Serendipity-min/medical-multi-parameter-monitor/血氧/AFE4490_library/README.md

为Arduino设计的基于AF4490 的PPG / SpO2 / HR盾板
===============================================

Connecting the shield to your Arduino
-------------------------------------

Connect the ECG/Respiration shield to the Arduino by stacking it on top of your Arduino. This shield uses the SPI interface  to communicate with the Arduino. Since this includes the ICSP header, which is used on newer Arduinos for SPI communication,  this shield is also compatible newer Arduino boards such as the Arduino Yun and Due.

Wiring the Breakout to your Arduino
-----------------------------------

If you have bought the breakout the connection with the Arduino board is as follows:

| AFE4490 pin label | Arduino Connection | Pin Function |
| --- | :---: | ---: |
| GND | Gnd | Gnd |
| DRDY | D2 | Data ready(interrupt) |
| MISO | D12 | Slave out |
| SCK | D13 | SPI clock |
| MOSI | D11 | Slave in |
| CS0 | D7 | Slave select |
| START | D5 | Conversion start Pin |
| PWDN | D4 | Power Down/ Reset |
| DIAG_END | NC | Diagnostic output |
| LED_ALM | NC | Cable fault indicator |
| PD_ALM | NC | PD sensor fault indicator |
| VCC | +5v | Supply voltage |

**NEW: This is now compatible with the [ProtoCentral OpenView](https://github.com/Protocentral/protocentral_openview) unified data visualization software.**

### Running the Arduino Sketch

Install the protoCentral afe4490 library from arduino library manager.
If you have correctly installed the libraries, the example sketeches should now be available from within Arduino.

Upload the code to your arduino and open [ProtoCentral-openview](https://github.com/Protocentral/protocentral_openview) GUI/Arduino plotter to view the output.

## For the main documentation site, GUI and more resources, please check out our main [GitHub Repo](https://github.com/Protocentral/AFE4490_Oximeter)

License Information
===================

License

This product is open source! Both, our hardware and software are open source and licensed under the following licenses:

Hardware
--------

**All hardware is released under [Creative Commons Share-alike 4.0 International](http://creativecommons.org/licenses/by-sa/4.0/).**


You are free to:

* Share — copy and redistribute the material in any medium or format
* Adapt — remix, transform, and build upon the material for any purpose, even commercially.
  The licensor cannot revoke these freedoms as long as you follow the license terms.

Under the following terms:

* Attribution — You must give appropriate credit, provide a link to the license, and indicate if changes were made. You may do so in any reasonable manner, but not in any way that suggests the licensor endorses you or your use.
* ShareAlike — If you remix, transform, or build upon the material, you must distribute your contributions under the same license as the original.

Software
--------

**All software is released under the MIT License(http://opensource.org/licenses/MIT).**

THE SOFTWARE IS PROVIDED "AS IS", WITHOUT WARRANTY OF ANY KIND, EXPRESS OR IMPLIED, INCLUDING BUT NOT LIMITED TO THE WARRANTIES OF MERCHANTABILITY, FITNESS FOR A PARTICULAR PURPOSE AND NONINFRINGEMENT. IN NO EVENT SHALL THE AUTHORS OR COPYRIGHT HOLDERS BE LIABLE FOR ANY CLAIM, DAMAGES OR OTHER LIABILITY, WHETHER IN AN ACTION OF CONTRACT, TORT OR OTHERWISE, ARISING FROM, OUT OF OR IN CONNECTION WITH THE SOFTWARE OR THE USE OR OTHER DEALINGS IN THE SOFTWARE.

Please check [*LICENSE.md*](LICENSE.md) for detailed license descriptions.
