Serendipity-min/medical-multi-parameter-monitor/doc/01_多参数监护仪样机_总开发合同_v0.1.md

# 多参数监护仪工程样机总开发合同

**文件编号：MMP-SOW-001　｜　版本：v0.1（评审稿）　｜　编制日期：2026-09-18**

> 本文件用于三人团队的研发立项、任务分工、接口约束、阶段评审与验收，不是医疗器械注册文件，也不替代劳动合同或正式法律审查。项目交付物是受控实验环境下的工程样机系统，不得用于诊断、治疗、生命支持或无人值守监护。文中“应”表示签署后必须满足的要求；“建议”及“待冻结”项目必须经过 G0/G2 评审才能转为执行基线。
>
> 配套文件：`02_项目负责人及上位机_专项工作合同_v0.1.md`。其中附录 A 的 **MMP/1 通信协议**是唯一的自定义通信规范；本文件不得另行定义同名字段或另一套帧格式。

## 一、合同基本信息与签署条件

| 项目 | 约定 |
|---|---|
| 项目名称 | 基于 STM32F407 与局域网网页大屏的多参数监护仪工程样机 |
| 立项/验收方 | ____________________ |
| 项目负责人 P | ____________________；负责总体方案、通信协议、上位机、集成与交付 |
| 嵌入式负责人 A | ____________________；负责 ECG/呼吸、血氧/脉率 |
| 嵌入式负责人 B | ____________________；负责无创血压、红外测温、共享联网固件 |
| 技术监督/最终验收人 | ____________________；不得用负责人单方自评替代最终验收 |
| 代码仓库 | `Serendipity-min/medical-multi-parameter-monitor` |
| 启动日期 T0 | ____________________；以人员、实物、资料及工作量确认完成为前提 |
| 计划周期 | 建议 12 个工作周；不是基于已知成员空闲时间作出的承诺 |
| 样机数量 | 建议交付 1 套完整系统，含 2 个采集节点、1 套上位机；实物数量在 G0 确认 |
| 费用/采购预算 | 人工费用 ______；材料预算 ______；测试仪器借用/租赁预算 ______ |
| 适用法律与争议解决 | ____________________；正式签署时填写并由适格人员审查 |

**生效前提：**三方确认任务边界、可投入时间、模块实物、节点数量、验收条件和预算。未填写商务字段时，本文件只能作为技术任务书使用，不能据此推定付款、劳动关系或知识产权归属已经约定。

### 1.1 本次资料核验的范围

已读取仓库的 README、原始项目方案、硬件开发参考手册及血氧使用教程，并核对 TI、ST、Melexis、Espressif 与监护仪厂商的公开资料。检索时仓库根目录树 SHA 为 `6a40b58b03ab327a7f4e0f02f24d63825d3754c6`；这是**目录树标识，不是声称已锁定的提交 SHA**。README 的文件 blob SHA 为 `e185b0c15a08fb378d1e38ac3392ddcbc1716ab2`。[R1–R5]

**没有完成仓库内全部 PDF、DOC、开发板原理图及供应商协议的逐页复核，也没有接触实物、抓取串口或进行电气测试。**因此，下文引脚是候选分配，供应商命令是待核验项，所有精度与稳定性指标均不得写成已经达成。G0 必须补齐“文件路径、版本、页码、实物照片、抓包证据”的对应关系。

### 1.2 立项前必须消除的资料冲突

| 编号 | 核验发现 | 本合同处理方式 | 关闭责任人 |
|---|---|---|---|
| E01 | 初拟拓扑把 ECG 到 F407 写成 UART；ADS1292R 原生接口是 SPI | 按 SPI + DRDY 设计；只有实物另带串口桥接 MCU 时才改成 UART，并补其协议 | A |
| E02 | README 同时出现 `AFE4490 / HKS-12C`；血氧教程实际描述 AFE4490 Arduino 盾板及不同示例的串口输出 | 不把两者视为同一模块；核对买到的是裸 AFE/盾板还是带算法 MCU 的串口成品 | A |
| E03 | 温度资料涉及 GY-641V3、MLX90614、I2C/串口多种说法；README 出现 `0xA4` | 确认桥接板型号、工作模式、7 位地址还是含读写位地址；禁止套用原生 MLX90614 公式解释桥接帧 | B |
| E04 | ECG 的 PWDN 与 UART5_RX 同时分配 PD2 | 两节点方案将它们分属不同 MCU；单板合并时必须改引脚，不能让 PD2 同时承担两项功能 | A、B |
| E05 | 血压资料包含 HKB-08A、HKB-08B+ 等版本 | 以实物版本与供应商原始协议为准；不得混用波特率、帧头、校验及停机指令 | B |
| E06 | 仓库原方案含本地串口屏、板载存储；当前主需求是网页大屏 | 网页大屏为必交；本地屏、板载断网补传是否纳入首版，在 G0 单独签认 | P |
| E07 | 仓库出现“高精度”“医疗级”“无延迟”、HR ±1 bpm、体温 ±0.2℃等表述 | 改为待验证目标；不将芯片或商品指标直接当作整机验收事实 | P |
| E08 | 将 ADS129 系列描述为需要另配独立 ADC | ADS1292R 已集成 ADC；不因此增加不必要的 ADC 采购项 | A |
| E09 | 三电极、三导联、双 ADC 通道混用 | 三个电极不等于三路独立 ECG；实际通道含义由寄存器配置和模块电路共同确定 | A |

上述判断依据为仓库原文和芯片官方接口说明；未核验的供应商十六进制命令**不在合同中转抄为可执行指令**。[R1–R7]

## 二、项目目标、范围与非目标

### 2.1 最终交付定义

交付一套可在受控局域网演示的工程样机：四个功能模块完成采集或模块结果读取，经 STM32 适配为统一协议，通过 ESP8266 发送给电脑 TCP 服务，服务器记录数据并通过 WebSocket 推送给网页；电脑以 HDMI/DP 连接显示器或电视形成大屏。大屏不是直接接 STM32 的显示外设。

首版必须形成“实物采集 → 数据封装 → 无线传输 → 服务端解析 → 可追溯记录 → 大屏展示 → 故障状态反馈”的闭环，而不是仅制作一张固定数值的界面。

### 2.2 范围分级

| 优先级 | 内容 | 验收口径 |
|---|---|---|
| P0 必交 | ECG 原始波形、ECG 来源 HR；SpO2/PR；NIBP SYS/DIA；红外测温；设备/传感器状态；局域网接入；大屏；记录回放 | 真实模块输出能与原始抓包、统一协议、界面记录逐项对应 |
| P0 必交 | ECG 导联异常、血氧无效/探头状态、血压失败/取消、测温无效等状态处理 | 以模块实际支持的状态为准；不支持项标“未知”，不能编造正常 |
| P0 必交 | 断线重连、心跳、过期标识、异常长度/校验处理、运行日志、版本标识 | 按第十章测试 |
| P1 条件交付 | 阻抗呼吸原始波形、呼吸率 RR、PPG 波形、MAP、本地串口屏、受控远程血压启动 | 必须在 G0 确认硬件能力、资料、仪器和工作量；未确认不能视为默认承诺 |
| P2 后续扩展 | RS485/CAN、MQTT、云端、手机 App、多床位、多机构、持续断网补传 | 另立变更单或二期合同 |

**四模块**指 ECG/呼吸、血氧/脉率、血压、温度四个功能域，不等于“四个测量值”，也不等于已经确认要购买四块 STM32。呼吸是 ECG 负责人名下的条件子任务，不另设第五位负责人。

### 2.3 明确不在本期承诺范围内

不承诺临床诊断精度、除颤防护、心律失常诊断、ST/QT 分析、自动治疗建议、婴幼儿/新生儿使用、人体试验、医疗注册、试产量产、公开互联网部署及连续断网时所有原始波形的无损补传。本期只设置工程演示告警，不宣称符合医疗告警标准。[R12]

## 三、市场调研合同任务

### 3.1 已完成的初步桌面调研

| 对标对象 | 官方资料可支持的观察 | 对本项目的启示 | 本期不照搬的内容 |
|---|---|---|---|
| 迈瑞 ePM 10M/12M、ePM 系列 | 官方页面介绍多参数监测、集中信息展示及有线/无线联网能力 | 将波形、数值、趋势、技术状态置于同一视图，联网是监护系统的一部分 | 不照搬其临床算法、精度与认证宣称 |
| 飞利浦 IntelliVue MX400 | 官方页面强调床旁信息整合、紧凑显示与临床信息连接能力 | 用清晰的信息优先级和一致的参数来源标识降低阅读负担 | 不在首版实现 EMR/HIS、IntelliBridge 或商业设备协议兼容 |

来源为厂商原始页面，完成了产品功能层面的桌面比较；**尚未开展用户访谈、报价调查或市场规模验证**。没有真实报价时，材料预算只列项目与数量，不填写虚构单价。[R10–R11]

### 3.2 尚需执行的市场调研工作包 M0

P 负责组织不少于 3 次经同意的需求访谈，优先对象为指导教师、电子/生物医学工程人员、实际演示使用者；是否访问医护人员由学校或所在单位安排，不擅自开展患者招募。

每次访谈记录“场景—任务—痛点—期望功能—可接受延迟—故障时需要看到什么—证据”。重点确认：这是教学演示、实验采集还是未来产品探索；是否必须脱离电脑独立工作；是否需要本地屏；演示数据能否全部来自模拟器；已有开发板和模块数量；供电、气路及测试仪器由谁提供。

**交付物：**`docs/01_market/competitor_matrix.md`、`interview_records.md`、`positioning.md`。验收要求为来源可回溯、访谈与假设分开、结论能转化为需求；不得用未采访对象的“典型意见”伪装为调查结果。

## 四、需求分析与可追溯性

| 需求 ID | 需求与优先级 | 负责人 | 验收证据 |
|---|---|---|---|
| REQ-01 | P0：四功能模块可独立调试并接入同一监测会话 | A/B/P | 模块台架报告、会话绑定记录 |
| REQ-02 | P0：默认 ECG 250 SPS；保存实际启用的 ADS 通道原始样本 | A | 配置读回、DRDY 频率、连续样本编号 |
| REQ-03 | P0：血氧与脉率的来源、有效性、更新时间明确 | A/P | 供应商样帧和界面对照 |
| REQ-04 | P0：血压为间歇测量，显示最近一次完成时间和当前测量状态 | B/P | 开始/测量中/完成/失败/取消序列 |
| REQ-05 | P0：温度区分物表、环境、模块补偿值；不冒称核心体温 | B/P | 字段说明、无效值与更新测试 |
| REQ-06 | P0：服务端支持最多 4 个采集连接；首版实物建议 2 个 | P/B | 2 实物功能联调、4 模拟节点压力测试 |
| REQ-07 | P0：在线不等于数值有效；数据陈旧、掉线、探头故障独立显示 | 全员 | 故障注入报告 |
| REQ-08 | P0：1080p 网页大屏、全屏、实时波形、数值、状态、趋势与回放 | P | 截图、录屏、自动化测试 |
| REQ-09 | P0：协议带身份、启动标识、序号、采集时间、长度和校验 | P/B | Python/C 金样一致性报告 |
| REQ-10 | P0：原始数据与显示处理数据可区分、可追溯 | P/A | 原始文件、算法版本、回放对照 |
| REQ-11 | P0：断网不影响本地安全状态机；不得因重试重复启动血压 | B | 台架断网、重复命令、超时测试 |
| REQ-12 | P0：实物、模拟器、回放三种模式始终有醒目标识 | P | 三种模式截图 |
| REQ-13 | P1：RR/PPG/MAP/本地屏按 G0 条件项签认 | A/B/P | 能力冻结表及新增验收用例 |

需求变更必须同步更新“需求 ID → 设计 → 代码路径 → 测试 ID → 验收结论”，不能只改 README。

## 五、功能设计

### 5.1 采集与参数语义

ECG 负责人保存未经显示滤波的 ADC 数据、通道配置、增益、参考电压来源、采样率和导联状态。HR 算法首先针对模拟器进行验证；算法未产生有效结果时输出无效状态，而不是固定数值。

呼吸必须区分 ADS1292R 阻抗呼吸通道与 ECG 衍生呼吸算法。不能仅凭“芯片支持呼吸”承诺模块已经具备完整测量电路；也不能把经 5–40 Hz 显示带通处理后的 ECG 直接当成保留了呼吸低频成分的信号。优先验证独立阻抗通道，ECG 衍生 RR 作为另行评审的算法任务。[R6]

血氧如果实物是 UART 成品模块，读取其结果和质量状态；如果是直接连接的 AFE4490，则需要 SPI 驱动、LED 时序、红/红外原始采集及供应商算法移植。AFE4490 芯片本身不等于已经提供了 HKS 系列 UART 帧或临床标定的 SpO2 算法，后者是影响工期的实质变更。[R4、R7]

NIBP 使用模块成熟的测量流程，不在首版自行重写示波法核心算法。MAP 仅在模块明确输出且协议被验证时显示；不能默认用 `(SYS + 2×DIA)/3` 替代实际测得的 MAP。

温度默认按经核验的实际模式读取，推荐低频 1 Hz 展示。裸 MLX90614 的 SMBus 数据和 GY 桥接板的“人体补偿温度”不是同一种协议，也不是同一种医学含义。[R8]

### 5.2 大屏与状态功能

首页设一个监测会话：左侧 ECG/可用 PPG/可用 RESP 波形，右侧 HR、SpO2、PR、SYS/DIA、TEMP 等数值；底部显示节点、探头、连接质量、最近更新时间和事件。每个数值必须能显示单位、来源和无效/过期原因。血压显示最近完成时间，不以 1 Hz 重复上报伪装成每秒测量。

设备页展示固件版本、协议版本、节点能力、重连次数、接收速率、样本缺口；记录页负责会话回放与导出。设置页仅管理员可进入；展示人员不应有启动气泵或改校准参数权限。

### 5.3 告警边界

工程告警分为技术故障与参数阈值提示。阈值、迟滞、持续时间、确认/静音行为要有配置与事件日志；不在本合同中设定临床治疗阈值。所有预设演示阈值标注“模拟演示”。无效数据不参与生理阈值判断，技术故障不能被“静音”变成正常。[R12]

## 六、系统方案设计与通信选型

### 6.1 建议冻结的首版拓扑

```text
节点 A：A 负责
  ADS1292R ── SPI + DRDY/控制 GPIO ──┐
  血氧模组 ── 已核验 UART 或 SPI ────┤ STM32F407-A
                                       └─ UART3 + ESP-AT ─ ESP8266-A ─┐
                                                                    │
节点 B：B 负责                                                        │
  HKB 血压模块 ── 已核验 UART ────────┐                              ├─ 2.4 GHz AP
  GY 测温模块 ── 已核验 I2C/UART ─────┤ STM32F407-B                  │       │
                                       └─ UART3 + ESP-AT ─ ESP8266-B ─┘       │ TCP
                                                                              ▼
                                                        P：电脑接入服务 + 记录/状态服务
                                                                              │ WebSocket
                                                                              ▼
                                                             浏览器网页 ── HDMI/DP ── 大屏
```

这是**推荐的两节点工程方案，不是已确认拥有两套板卡的事实**。G0 核实数量后冻结：两节点便于两位成员并行负责完整链路，也可将气泵电源干扰与 ECG 节点分开管理；但物理分开不等于实现医疗电气隔离。

若只有一块板，使用同一协议的多 `stream_id` 模式并重新审核引脚/资源；若四模块各有独立 F407+ESP，则配置四个 `device_id`，网页仍按同一个 `monitor_session_id` 聚合。二者均须更新 BOM、引脚表和实物验收范围，不能口头切换。

### 6.2 接口和协议的明确结论

| 链路 | 首版选型 | 理由及限制 |
|---|---|---|
| ADS1292R → F407 | SPI 主机 + DRDY EXTI + 控制 GPIO | 芯片原生数字接口；不是 UART、RS485 或 CAN |
| 血氧 → F407 | 成品桥接模块才选 UART；直接 AFE4490 选 SPI | G0 以实物和源码确定；不能用模块名相似代替核验 |
| 血压 → F407 | 硬件 UART，8N1；波特率随实物协议冻结 | README 的 115200 仅作线索，不自动覆盖其他版本 |
| GY 测温 → F407 | 优先核验仓库拟用 I2C 100 kHz；UART 为经证实后的替代方案 | 100 kHz 是本项目候选设置；地址、帧、上拉和电平先核验 |
| F407 → ESP8266 | 3.3 V 逻辑 UART，初始 115200、8N1，DMA + AT 状态机 | 默认正常发送模式 `CIPMODE=0`；不把调试串口混进协议串口 |
| ESP8266 → 电脑 | TCP 长连接，设备主动连接服务器；MMP/1 应用帧 | TCP 是字节流，服务器必须处理半包、粘包和断连 |
| 服务端 → 网页 | 同源 HTTP + WebSocket | 网页通过 WebSocket 接实时流；不直接连接原始 TCP 端口 |
| 本地串口屏（条件项） | 按实物选 TTL 或 RS232 + 对应收发器 | UART 是控制器方式，TTL/RS232 是电气层；两者不可裸连混用 |
| RS485 | **本期不采用** | 只有需要长距离有线多点接入时再增收发器、终端/偏置和主从协议 |
| CAN | **本期不采用** | 如未来采用，需 CAN 收发器、终端、ID、总线负载及分片设计；不能把 UART 线接上就当 CAN |
| Modbus RTU / CANopen / MQTT / HL7 / FHIR | **本期不采用** | 当前目标无需同时引入多套应用协议；存在扩展需求时另行论证 |

不能以“更专业”为理由同时增加 RS485、CAN、MQTT。当前最小闭环已经需要传感器协议、ESP-AT、TCP 应用帧和 WebSocket 四层边界，优先把这四层做正确。[R6–R9]

### 6.3 节点身份和会话绑定

`device_id` 标识采集节点，`stream_id` 标识该节点上的数据流，`boot_id` 区分设备重启，`monitor_session_id` 标识一次演示/记录会话。IP 地址、MAC 地址或连入顺序不能代替会话绑定。不同节点的数据只有在管理员明确绑定后才在同一屏聚合；设备更换、重启、同 ID 重复连接均应触发可见事件。

### 6.4 吞吐预算

以下是设计计算，不是实测结果。UART 115200、8N1 每字节占 10 bit，理论单方向上限为 `115200/10=11520 B/s`。

按附录 A 的 40 B 头、24 B 波形元数据、4 B CRC：ADS 两通道、250 SPS、每包 10 个采样时，单包 `40+24+10×2×3+4=128 B`，每秒 25 包，即 **3200 B/s**。如核验存在 50 SPS 的单通道 PPG，每包 5 点，其开销为 **830 B/s**。再为低频值、心跳和 AT 交互留预算，首版目标持续串口负载不超过约 70%，并以逻辑分析仪/实际计数验证。

500 SPS、每包 20 点时 ADS 流为 **4700 B/s**；它是服务器压力测试档与条件扩展，不自动等于硬件首版承诺。若提高采样率或增加通道导致负载超限，先调整批量与固件队列，再申请验证 230400/460800 等波特率。不能根据 Wi-Fi 的名义速率忽略 UART 瓶颈。

## 七、软硬件设计约束

### 7.1 候选引脚表——不是最终接线许可

以下沿用检索时仓库的相关映射作为候选，**必须经开发板原理图、STM32 复用表、CubeMX 配置及实物通断测量四项核验**。候选表未证明板载器件、跳线或外部存储不会占用这些引脚。[R1–R3、R5]

| 功能 | 节点 A 候选 | 节点 B 候选 | 必查事项 |
|---|---|---|---|
| ADS SPI1 | PB3 SCK、PB4 MISO、PB5 MOSI | 不使用 | PB3/PB4 调试复用、板载 SPI 设备；保留 PA13/PA14 SWD |
| ADS 控制 | PD0 CS、PD1 START、PD2 PWDN/RESET、PE9 DRDY | 不使用 | PD0/PD1 与 FSMC/CAN 等复用；PE9 外设占用；模块复位引脚定义 |
| 血氧成品 UART | UART4：PC10 TX、PC11 RX | 不使用 | 只适用于确认提供 UART 的模块；AFE 直连方案另分 SPI 资源 |
| 血压 UART | 不使用 | UART5：PC12 TX、PD2 RX | 与节点 A 的 PD2 属于不同芯片；单板合并时冲突重新处理 |
| GY I2C | 不使用 | I2C1：PB8 SCL、PB9 SDA | 逻辑电压、上拉、7 位地址、总线恢复、是否为桥接协议 |
| ESP | USART3：PB10 TX、PB11 RX | USART3：PB10 TX、PB11 RX | P1/P5 等板载连接以本板版本为准；RX/TX 交叉；EN/RESET 控制另核验 |
| 调试 | USART1：PA9 TX、PA10 RX | 同左 | 禁止与传感器复用；实际 Windows COM 号不固定 |
| 本地屏（可选） | USART2：PA2 TX、PA3 RX | 按需要选用 | TTL/RS232 型号必须确认；网页开发不依赖此屏 |

G0 的最终 `pinmap.csv` 应包含 MCU 实例、引脚、复用号、方向、电压、连接器号、跳线位置、板载冲突、DMA 控制器/流/通道、EXTI 线、原理图页码、审核人。**不能只审核 GPIO，不审核 DMA 和时钟。**

### 7.2 电源、气路和电气安全

全部人体接触功能先用生理信号模拟器、测试负载或供应商规定的台架方法验证。未获得适格人员的电气与风险审查，不进行人体连接；也不因“电池供电”“无线传输”“两个 LDO”就宣称具备患者隔离。普通 LDO 分供电不等于电气隔离。

B 负责提供供电预算、泵启动瞬态、ESP 发射期间压降、稳压温升、复位记录、气路连接及模块故障处理说明。禁止把开发板 3.3 V 引脚默认当成气泵或 ESP 电源容量已足够的证据；禁止将不明 5 V/RS232 信号直接接入 MCU。

血压本地控制必须能在网络失联时独立处理取消、超时、模块错误。停泵/泄压策略、最大工作时间和相关保护值须由已核验模块说明及安全审核确定，不能从 README 复制不完整命令后直接驱动人体袖带。本合同不提供未经审核的人体测试步骤。[R12]

### 7.3 固件基础架构

建议统一使用 STM32Cube HAL/CMSIS、C 语言和 FreeRTOS；具体工具链版本、调试器及 RTOS 配置在 G2 冻结。已有 F103/F429 或 Arduino 示例仅作移植参考，不能认为直接替换芯片名即可用于 F407。某一外设不得同时由 HAL、标准库和直接寄存器的不同代码路径竞争控制。

```text
BSP/板级资源
  ├─ sensor_ecg / sensor_spo2 / sensor_nibp / sensor_temp
  ├─ 时间基准、DMA、环形队列、看门狗
  ├─ protocol_mmp（B 实现，P 提供规范与金样，A 复核）
  ├─ esp_at_transport（B 实现，两节点共用）
  └─ 应用状态机、状态/质量映射、可选本地屏
```

建议优先级：采集与本地安全事件高于网络封包，网络高于本地屏与日志。SPI/USART 中断只做必要读写、DMA 管理和事件通知，禁止在采样中断里等待 `SEND OK`、写磁盘或执行长时间滤波。NIBP 停机/错误状态机不得受 UI 或联网任务阻塞。

STM32F407 的内存规划要区分系统 SRAM 与 CCM；DMA 缓冲区不得默认放进 CCM。必须交付 linker map、缓冲区分配表和栈高水位报告。建议共享网络发送队列上限 16 KiB，ESP UART DMA RX 环形区 4 KiB，协议解析区 8 KiB；这是待实际 map 文件验证的预算，不是要求不加分析地全部分配。[R5]

### 7.4 DSP、单位和校准

原始流和显示滤波流分开。任何带通、陷波、缩放、采样率改变都记录配置版本；上位机不得在不知道增益/参考电压时将 ADC counts 标成 mV。生理参数算法输出包括有效性、窗口、算法版本和来源。模块补偿温度、脉搏波相对幅值不能自动标成具有已校准物理意义的测量量。

### 7.5 上位机架构

上位机采用 Python 异步接入与 FastAPI/WebSocket、SQLite 元数据及二进制原始记录；前端建议 TypeScript + React + Canvas。版本在 G2 锁定，使用 lockfile，不依赖在线 CDN，不将本次文档中的框架名称解读为某一具体最新版本已完成兼容性验证。具体目录、接口、协议与验收见专项合同。[R13]

## 八、人员分工、接口责任与协作规则

### 8.1 责任矩阵

R = 实施；A = 最终负责/批准；C = 参与评审。这里的 A 字母仅为矩阵角色，不等于成员代号 A。

| 工作包 | P 项目负责人 | 成员 A | 成员 B |
|---|---|---|---|
| 市场调研/需求/总体架构 | R/A | C | C |
| ECG、HR、条件 RR | C | R/A | C |
| SpO2、PR、条件 PPG/算法移植 | C | R/A | C |
| NIBP 状态机与台架安全 | C | C | R/A |
| 温度与单位/模式核验 | C | C | R/A |
| 公共 C 帧编解码、ESP-AT、设备认证 | 规范与验收 A | C/节点接入 R | 公共库 R |
| Python 编解码、模拟器、协议金样 | R/A | C | C |
| TCP 服务、存储、网页、运行工具 | R/A | C | C |
| 供电/BOM/接线装配 | 审批 A | 节点 A 部分 R | 统筹与节点 B 部分 R |
| 系统测试、版本发布、演示 | R/A | 模块测试 R | 模块测试 R |

A 的模拟前端与算法工作较重，因此 B 同时承担共享联网库；G0 按双方经验和可投入时间复核负荷。P 不兜底承担未声明的传感器算法、气路调试或板级驱动。

### 8.2 模块交接的最小交付包

每个模块至少交付：`driver` 源码、可重复构建工程、实物型号/版本、接线表、底层帧协议来源及页码、至少一段正常与异常原始抓包、输出语义表、单位/缩放、采样率或结果刷新机制、错误状态映射、固件版本及已知问题。

“串口打印看起来正常”不构成交接完成。必须同时提交统一 MMP/1 帧以及与源数据逐项对照的测试结果；供应商协议由模块负责人解析，P 不在电脑端维护四套随意变化的私有串口协议。

### 8.3 Git 与评审

建议分支为 `feature/ecg`、`feature/spo2`、`feature/nibp-temp`、`feature/transport`、`feature/host`。主分支只合入通过构建、接口测试和人工审查的版本；密钥、Wi-Fi 密码、真实个人健康数据、编译产物不进入 Git。保留第三方代码许可及来源，不能因资料在仓库里就认定允许再发布。

每周一次集成演示和风险复盘，每次展示“已完成证据、失败案例、阻塞事项、下一周可验收结果”。协议、引脚和数据单位的变更必须由 P 与受影响模块负责人共同签认。

## 九、六阶段开发计划与评审关口

**周期为建议排期；T0 前确认人员投入。市场、需求、设计和实现可适度并行，但安全与接口冻结不可跳过。**

| 阶段 | 建议周次 | P 的工作 | A 的工作 | B 的工作 | 关口/交付 |
|---|---|---|---|---|---|
| 准入核验 | 第 1 周前半 | 建立问题清单、设备台账、预算与风险边界 | 核对 ECG/血氧实物、文档 | 核对血压/温度/供电、联网模块 | G0：型号、数量、资料、条件项、初始安全边界冻结 |
| ① 市场调研 | 第 1 周 | 竞品矩阵、访谈、定位 | 提供传感技术约束 | 提供成本/装配约束 | M0 调研记录，不能用空泛市场规模充数 |
| ② 需求分析 | 第 2 周 | SRS、使用场景、需求-测试映射 | 参数与质量状态需求 | 血压安全/温度语义需求 | G1：需求与验收口径签署 |
| ③ 功能设计 | 第 3 周前半 | 大屏原型、状态图、用户角色 | 模块状态机、算法边界 | 控制/故障状态机 | 功能说明、UI 原型、错误用例 |
| ④ 系统方案 | 第 3 周后半 | MMP/1、时间/身份、模拟器金样 | 采样与资源审查 | 引脚/DMA/ESP 公共库方案 | G2：架构/协议/引脚/工具链冻结 |
| ⑤ 软硬件设计 | 第 4–6 周 | TCP、存储、API、大屏并行开发 | ECG/血氧驱动和台架验证 | NIBP/温度驱动、AT/C codec | G3：各模块与上位机分别通过测试 |
| ⑥ 样机开发与集成 | 第 7–9 周 | 两节点聚合、真实数据替换模拟器、回放 | 节点 A 实物接入与稳定性 | 节点 B 实物接入、供电/网络故障 | G4：全链路功能演示 |
| 样机内测试整改 | 第 10–11 周 | 24h 稳定性、异常注入、性能与大屏测试 | 模块缺陷修复、算法核查 | 气路/电源/网络问题修复 | G5：验收报告、关闭阻塞缺陷 |
| 交付 | 第 12 周 | 发布、说明书、演示、交接 | 源码/硬件记录/已知限制 | BOM/接线/固件/安全限制 | G6：最终验收与归档 |

G0 未确认的裸 AFE4490 算法工作、缺失血压协议、未核验屏幕电平属于关键路径阻塞，必须调整合同，而不是把延期隐含转嫁给上位机。硬件未到位时 P 可用模拟器推进，但模拟器不能代替实物验收。

## 十、验收标准与证据

### 10.1 分层验收原则

验收分为：软件正确性、模块台架一致性、系统稳定性与显示效果。**临床测量准确性不在这些测试通过后自动成立**。没有校准仪器、参考方法和审批条件，不签发“医疗精度达标”结论。

| 测试 ID | 用例 | 通过条件 |
|---|---|---|
| T01 | 全新环境构建 | 根据锁定工具链和说明，非作者可编译固件、启动服务及网页；无写死个人路径 |
| T02 | 协议金样 | Python 与 C 对同一向量的帧长度、字节序、字段、CRC 完全相同 |
| T03 | TCP 分包/粘包 | 不少于 1000 帧混合类型，随机切分、连续拼接，恢复结果逐帧一致 |
| T04 | 异常输入 | 错 CRC、超长、坏版本、非法状态、半帧断连被识别；不导致失控分配或进程退出 |
| T05 | 模块一致性 | 各模块有效输出及异常状态能与供应商抓包/台架输入对应；无占位假数值 |
| T06 | ECG 连续性 | 冻结的 250 SPS 配置下，DRDY、样本计数与时间基准可核验；实际两个 ADC 通道均按配置解释 |
| T07 | 多节点聚合 | 建议 2 个真实节点完成全链路；另外用 4 个模拟节点验证服务端连接能力；会话不混绑 |
| T08 | 故障时效 | 连续参数超过有效期标陈旧；节点在最后有效通信后 5 s 标离线，UI 最迟再 1 s 更新；无效不得显示为 0 |
| T09 | 重连 | AP/服务器恢复可用后，在冻结测试网络下 45 s 内自动恢复；重复 10 次；不重复执行旧控制命令 |
| T10 | 大屏 | 1920×1080、2 个浏览器客户端连续演示；数值/状态清晰，波形有时间轴和缺口，不因窗口缩放失真 |
| T11 | 延迟 | 正常网络下服务端接收至前端入绘制队列 P95≤200 ms；采集至网页估计 P95≤500 ms 仅在时间映射不确定度≤50 ms 时评价 |
| T12 | 稳定性 | 2 个实物节点按默认配置运行 24h：无未解释重启、死锁和样本缺口；刻意注入的断线/丢弃必须形成事件，不冒充无损 |
| T13 | 记录回放 | 抽取不少于 3 段各 60 s 数据，回放样本计数、原始数值、单位与事件和记录一致 |
| T14 | 血压控制 | 台架验证本地取消、重复命令、网络中断、超时、模块失败；一次 command_id 不得触发第二次测量 |
| T15 | 安全基线 | 未注册设备不能绑定，非管理员不能控制，无公网映射；密钥不进仓库；模式标签不能关闭 |
| T16 | 存储故障 | 磁盘低空间/写入失败不被静默忽略；界面和日志明确“记录失败”，实时显示可按约定继续 |

延迟是测量值而非浏览器“感觉流畅”。浏览器自身时钟与服务器时钟不可直接相减；需按专项合同做时间映射或使用外部同步测量。P95 的样本数、采样窗口、计算脚本、主机配置与网络环境必须写入报告。

24h 试验优先使用生理模拟器或不连接人体的已批准台架方案。不能为了满足连续时间要求让人体持续连接未经审查的样机。NIBP 不在 24h 内无间隔自动充气；按经审核的台架用例执行有限次数，并记录其间歇状态。

### 10.2 缺陷与验收决定

阻塞缺陷包括：电气/气路风险未关闭、参数来源混淆、无效值显示正常、错误单位、会话混绑、重复启动血压、数据静默丢失、固件或上位机不可复现构建。阻塞缺陷为零方可最终验收。

一般缺陷可在已知问题表中注明影响、临时措施、责任人与修复日期，由验收方书面接受。评审结论只有“通过”“有条件通过”“退回整改”；不设“超时未回复视为通过”。

## 十一、交付物清单

| 类别 | 最小交付 |
|---|---|
| 调研/需求 | 竞品来源、访谈记录、定位、SRS、需求追踪表 |
| 系统设计 | 总体架构、节点/会话模型、MMP/1 冻结版、引脚/DMA/时钟表、风险清单 |
| 硬件 | BOM、实物版本/照片、连接器表、供电/气路说明、装配图；如自制板则含可编辑原理图/PCB 源文件 |
| 固件 | 四模块驱动、公共通信库、算法/配置版本、构建脚本、固件镜像、下载与恢复说明 |
| 上位机 | 后端、前端、模拟器、协议金样、测试、配置示例、离线资源、启动/备份/恢复说明 |
| 测试 | 原始抓包、运行日志、24h 记录、异常注入、性能脚本、失败及整改证据 |
| 样机 | 完整系统一套或 G0 确认的数量；接线标签、版本标签、工程样机警示 |
| 移交 | 使用说明、演示脚本、已知限制、许可清单、最终验收单 |

若没有自制 PCB，不要求伪造 PCB 源文件；应明确交付的是开发板加模块式样机。若本地屏未纳入 G0，不得因仓库有串口屏资料就在验收时临时追加完整屏幕应用。

## 十二、风险、变更、费用与权利义务

### 12.1 主要风险及措施

| 风险 | 等级 | 应对 |
|---|---|---|
| 血氧型号/接口不明，可能变成裸 AFE 算法项目 | 高 | G0 关闭；选择移植或更换成品模块前完成工时与预算评审 |
| 血压版本/停机协议不一致 | 高 | 未核验前禁用远程开始，禁止人体试验；保持台架验证 |
| STM32 引脚/DMA/板载设备冲突 | 高 | 最终引脚及 DMA 表签字；不凭 README 直接接线 |
| 气泵/无线瞬态干扰、供电不足 | 高 | 示波器测量、独立电源支路、复位/噪声对照；必要时改布局 |
| 协议未冻结，三方各写一套 | 高 | G2 规范、金样、C/Python 测试同时冻结 |
| 假数值/旧数值被当作实时 | 高 | null + quality + 时间戳，真实/模拟/回放强制标识 |
| ESP8266 生命周期 | 中 | 已有模块可用于本次样机；记录官方 NRND 状态，量产/新设计再评估替代，不临时强制换板 |
| 任务超出三人投入能力 | 中 | 每周燃尽与关键路径审查，优先 P0，P1 未签署不默认加班吞并 |

Espressif 的公开资料已标注 ESP8266EX 为 NRND（不推荐用于新设计）。这不等于现有模块立即不可用，但属于后续产品化选型风险。[R9]

### 12.2 变更控制

变更单至少包含：编号、原因、受影响需求、硬件/固件/上位机影响、旧新字段对照、测试影响、预算工期变化、回退方式、三方意见。修改采样率、单位、帧头、模块型号、UART 波特率、引脚、节点数量或远程控制权限均属受控变更。

安全纠正可先停止相关测试，再补齐变更手续；不能以“合同已写死”为理由继续执行已知风险方案。P 不得只改网页掩盖硬件数据异常。

### 12.3 商务与成果条款（签署时填写）

人工与材料分别核算；没有预算批准不得替项目方下单。采购单记录型号、版本、供应商、价格、交期、保修与归属。费用支付节点由签署方填写，不在本稿中虚构金额或付款比例。

已有代码/资料的权属依原许可；新增软件、硬件设计、测试记录及可申请成果的权属约定为：____________________。各成员至少应按约定向项目交付完整源代码、构建方法与研发记录，不得仅交不可维护的二进制程序。第三方资料的上传、公开和再分发单独核查许可。

保密范围、数据访问、离职/退出交接、缺陷修复支持期、合理责任限制及争议解决在签署时补全；医疗器械注册与临床使用责任不因本技术任务书产生自动授权。法律适用与正式权利义务请由所在辖区的合适专业人员审核。

## 十三、开工前 5 个工作日行动清单

| 时间 | P | A | B | 必须形成的结果 |
|---|---|---|---|---|
| 第 1 日 | 建任务板、资料冲突表、访谈预约 | 拍 ECG/血氧实物与丝印 | 拍血压/温度/ESP/开发板版本 | 实物清单，不用商品标题替代型号 |
| 第 2 日 | 整理需求与会话模型 | 确认 ECG SPI、血氧真实接口与算法来源 | 确认血压/温度协议、电源需求 | 文档路径/页码 + 未知项 |
| 第 3 日 | 完成 MMP/1 字段评审与模拟数据定义 | 给正常/异常样帧和采样计划 | 给正常/异常样帧和 AT 固件版本 | 接口冻结候选，不驱动未经核验的控制命令 |
| 第 4 日 | 运行协议 Python 金样，搭最小 TCP 接收 | 评审帧开销、采样中断设计 | 评审 C codec/AT 队列与安全状态 | 跨端测试计划、候选引脚/DMA 表 |
| 第 5 日 | 主持 G0 评审与需求预审、确认预算与节点数 | 签认模块边界、风险、工时 | 签认模块边界、风险、工时 | 通过项启动；阻塞项立变更/补证任务 |

上述是前五日的可执行启动安排，完整需求及 G2 冻结仍遵循第九章排期。P 的第一优先级是冻结接口与搭建模拟链路，不是先装饰大屏。

## 十四、签署与阶段确认

项目/验收方：________　日期：________  
P：________　日期：________  
A：________　日期：________  
B：________　日期：________  
安全/技术监督（如有）：________　日期：________

G0 节点数：____；ECG 实物：____；血氧实物/接口：____；血压实物/协议版本：____；温度实物/接口：____；开发板型号/版本：____；ESP AT 版本/Flash 容量：____。  
条件项勾选：RR ____；PPG ____；MAP ____；本地屏 ____；受控远程血压开始 ____；板端存储 ____。未签认的条件项按未纳入首版处理。

---

## 参考来源与使用边界

访问/检索日期：2026-09-18。仓库为项目材料来源，厂商资料用于核对通用接口与产品功能；不把仓库中未经实测的性能宣称作为整机事实。

- **[R1] 仓库 README**：https://github.com/Serendipity-min/medical-multi-parameter-monitor/blob/main/README.md 。检索时 blob：`e185b0c15a08fb378d1e38ac3392ddcbc1716ab2`。
- **[R2] 仓库《多参数心电监护仪项目方案.md》**：https://github.com/Serendipity-min/medical-multi-parameter-monitor/blob/main/多参数心电监护仪项目方案.md 。检索时 blob：`2119d56b09b6de8d84d4bf36c8b723acb26865f6`。
- **[R3] 仓库《多参数心电监护仪系统硬件方案与元器件开发参考手册.md》**：https://github.com/Serendipity-min/medical-multi-parameter-monitor/blob/main/多参数心电监护仪系统硬件方案与元器件开发参考手册.md 。检索时 blob：`88d87f8d60d08ec180f98ab5ee5a57687a436284`。
- **[R4] 仓库血氧教程**：https://github.com/Serendipity-min/medical-multi-parameter-monitor/blob/main/血氧/使用教程.md 。检索时 blob：`57ba6756e33626e174511e98788b7ad1437766c7`；可见 Arduino/AFE4490 与不同示例串口波特率说明。
- **[R5] ST STM32F407ZG 产品与文档入口**：https://www.st.com/en/microcontrollers-microprocessors/stm32f407zg.html 。最终复用号、DMA 和时序应回到对应数据手册及 RM0090 逐项确认，本次未完成开发板原理图逐页审查。
- **[R6] TI ADS1292R 官方数据手册，SBAS502C，Rev. C**：https://www.ti.com/lit/ds/symlink/ads1292r.pdf 。已核对首页及呼吸功能相关页面；不等于核验所购模块的外围电路。
- **[R7] TI AFE4490 官方页面**：https://www.ti.com/product/AFE4490 。用于区分芯片 AFE 与包含算法/串口桥接的成品模块。
- **[R8] Melexis MLX90614 官方页面**：https://www.melexis.com/zh/product/mlx90614/mlx90614 。用于核对原生 SMBus/PWM；不证明 GY 桥接模块私有协议。
- **[R9] Espressif ESP8266EX 数据手册与 ESP-AT 参考**：https://documentation.espressif.com/0a-esp8266ex_datasheet_en.html ；https://docs.espressif.com/projects/esp-at/en/release-v2.2.0.0_esp8266/AT_Command_Set/TCP-IP_AT_Commands.html 。参考版本不等于实物固件已经采用该版本。
- **[R10] 迈瑞官方产品页**：https://www.mindray.com/cn/products/patient-monitoring/sub-intensive-care-monitoring/epm-10m-12m ；https://www.mindray.com/en/products/patient-monitoring/continuous-patient-monitoring/epm-series 。通过 Exa 检索原始厂商资料。
- **[R11] 飞利浦 IntelliVue MX400 官方页面**：https://www.philips.com.cn/healthcare/product/HC866060/intellivue-mx400 ；https://www.philips.ng/healthcare/product/HC866060/intellivue-mx400-patient-monitor 。仅引用信息呈现和连接定位。
- **[R12] IEC 医用电气设备标准目录及 ISO 告警标准条目**：https://webstore.iec.ch/en/publication/2603 ；https://www.iso.org/es/contents/data/standard/04/19/41986.html 。仅用于说明存在整机安全/告警验证边界，不宣称本样机已符合任何标准；具体适用版本和当地要求需另审。
- **[R13] FastAPI 官方 WebSocket 文档**：https://fastapi.tiangolo.com/advanced/websockets/ 。架构实施仍须执行锁版本、异常断连与背压测试。
