Serendipity-min/medical-multi-parameter-monitor/doc/02_项目负责人及上位机_专项工作合同_v0.1.md

# 项目负责人、通信协议与网页上位机专项工作合同

**文件编号：MMP-SOW-002　｜　版本：v0.1（评审稿）　｜　编制日期：2026-09-18**

> 配套总合同：`01_多参数监护仪样机_总开发合同_v0.1.md`。本文件约束项目负责人 P 的工作范围、对 A/B 的接口要求、协议、上位机实现与验收。附录 A 是本项目唯一的 MMP/1 自定义通信规范。当前为待签署设计稿，不表示服务器、网页、C 固件或实物样机已经开发完成。
>
> 适用范围为受控实验局域网的工程样机。默认使用模拟信号、模拟器或获准的台架数据，不接入医疗生产系统，不采集真实患者信息，不构成临床监护软件。

## 一、任务主体、目标与边界

| 项目 | 约定 |
|---|---|
| 执行人 | P：____________________ |
| 协作人 | A：ECG/呼吸、血氧/脉率；B：血压、温度、公共 C 通信/ESP-AT 固件 |
| 验收人 | ____________________ |
| 启动与周期 | 随总合同 T0；建议 12 周，具体投入和依赖在 G0 签认 |
| 上位机运行环境 | 首版建议 Windows 11 电脑，Chrome/Edge；CPU/内存/浏览器版本在测试前记录 |
| 大屏形式 | 浏览器网页，由电脑通过 HDMI/DP 输出到 1080p 显示器/电视 |
| 费用与成果权属 | 从属总合同，不重复计算或擅自推定 |

### 1.1 P 的五项核心责任

P 负责需求与架构、协议规范和模拟器、电脑 TCP 接入与记录服务、WebSocket 网页大屏、集成测试及阶段验收组织。P 对系统设计负责，但不因此自动接管成员 A/B 的传感器驱动、血氧算法标定、电路/气路安全或全部固件开发。

**对 P 的交付评价不只看页面是否美观，还看：是否能从真实数据定位错误、能否区分无效和离线、能否说明数据来源及时间、协议能否由别人独立实现、系统能否重复部署。**

### 1.2 不属于 P 的默认工作

P 不在服务器中直接解析四套供应商私有串口协议，不根据截图猜测传感器单位，不绕过电气/安全审核远程驱动气泵，不对医疗精度作背书，不默认承担本地串口屏 GUI、PCB、云服务器、手机 App、RS485/CAN 或医院系统接口。新增任务必须通过总合同变更流程。

### 1.3 开工前输入件

A/B 必须提交模块型号与固件版本、接口与电平、供应商帧协议原始来源、有效/异常样帧、单位、采样/更新周期、错误码、硬件连接与已知限制。P 可以先用自定义模拟数据开发软件，但模拟数据必须显式标识，不能作为模块实测证据。

本次核验已发现：ADS1292R 应按原生 SPI 处理；仓库血氧资料混有 AFE4490 Arduino 方案与 HKS-12C 说法；GY 温度模块的 I2C/串口模式及地址需核验。P 的协议设计要屏蔽这些供应商差异，但不能替硬件负责人消除实物不确定性。[S1–S4]

## 二、与两位成员的交接合同

| 接口 | A 的责任 | B 的责任 | P 的责任 |
|---|---|---|---|
| 传感器到 STM32 | ECG/血氧驱动、算法与状态 | 血压/温度驱动与本地安全状态机 | 提出统一数据语义并验收 |
| 统一帧 | 正确填写本节点通道/样本/状态 | 实现共享 C codec、移植到节点 B，协助节点 A | MMP/1、Python codec、金样与一致性测试 |
| STM32 到 ESP | 使用公共库，保障采样不阻塞 | ESP-AT 状态机、UART DMA、队列、重连、认证 | 提供测试 TCP 服务、故障用例 |
| TCP 到服务端 | 提交真实节点 A 帧 | 提交真实节点 B 帧 | 接入、校验、会话绑定、存储、诊断 |
| 大屏/记录 | 核对 ECG/SpO2 单位与算法标签 | 核对 NIBP/TEMP 状态与历史含义 | 页面、波形、状态、回放、权限 |

P 交给 A/B 的最小开发包为：协议冻结版、设备/流命名表、C 结构字段说明、Python 编解码参考、至少一套十六进制金样、正常/异常测试流和接入测试方法。B 交回 C 的金样比较报告；未通过时不进入整机联调。

## 三、P 的六阶段工作安排

| 阶段 | 周次建议 | 具体任务 | 可验收产物 |
|---|---|---|---|
| 市场调研 | W1 | 阅读厂商原始产品页，组织真实访谈，确定工程样机定位 | 竞品矩阵、访谈记录、首版场景说明 |
| 需求分析 | W2 | 写 SRS，确认是否单会话、节点数量、屏幕和存储范围 | 需求 ID、非目标、验收矩阵、风险登记 |
| 功能设计 | W3 前半 | 画大屏线框、状态页、记录页；定义无效/陈旧/离线行为 | UI 原型、状态转换图、数据字典 |
| 系统方案 | W3 后半 | 冻结 MMP/1、消息路径、身份、时钟、背压、AT 边界 | 协议、金样、模拟器、架构评审记录 |
| 软硬件协同设计 | W4–W6 | 开发 TCP 接入、记录、API、WebSocket、大屏；与 B 对 C codec | 模拟器驱动的可运行版本、自动测试 |
| 样机集成 | W7–W9 | 将模拟节点逐个替换为真实节点，完成绑定、日志、故障与回放 | 两节点集成版本、真实数据对照报告 |
| 测试与交付 | W10–W12 | 24h、异常注入、性能、部署演练、演示与移交 | 发布包、测试报告、说明书、已知限制 |

正确顺序：**协议/金样 → 模拟器 → TCP 解析 → 状态与记录 → WebSocket → 网页 → 真机接入 → 稳定性与验收**。网页可以提前画原型，但不能在字段、单位、时间语义未定时先堆完整页面。

## 四、上位机总体设计

### 4.1 技术栈与进程模型

建议后端采用 Python `asyncio` + FastAPI + Uvicorn，前端采用 TypeScript + React + Canvas；SQLite 存元数据、参数结果与索引，连续原始波形保存在按会话分段的二进制文件中。FastAPI 官方支持 WebSocket，但设备 TCP 接入需要单独用 `asyncio.start_server` 等机制实现，不是 WebSocket 路由自动提供的功能。[S5]

首版采用**一个 Uvicorn worker**。在应用生命周期中启动/关闭 TCP 监听和后台服务；不能直接启用多个 worker，让每个进程重复绑定采集端口、各自维护不同设备状态。未来多进程扩展必须拆出独立接入进程与共享消息/状态设施。

```text
host/
  backend/app/
    main.py                  # 生命周期、配置、HTTP/WS
    transport/tcp_server.py  # TCP 会话与读写超时
    protocol/codec.py        # 帧级解析
    protocol/schemas.py      # JSON / 波形语义校验
    services/auth.py         # 注册设备、挑战应答
    services/device.py       # 节点、流、会话与状态
    services/timesync.py     # 单调时钟映射
    services/recording.py    # 原始分段、索引、磁盘状态
    services/alerts.py       # 工程提示与技术故障
    services/broadcast.py    # 独立 WS 客户端队列
    api/                    # REST / WebSocket 路由
  frontend/src/
    pages/ components/ waveform/ api/ state/
  simulator/                # 1–4 节点、掉线/坏帧/状态模拟
  tests/                    # 协议、API、集成、性能
  scripts/                  # 安装检查、启动、备份、诊断
  config.example.yaml
  pyproject.toml            # Python 依赖及版本约束
  uv.lock                   # 或已签认的等效锁定文件
  frontend/package-lock.json
```

此目录是拟实施结构，不表示仓库已有这些文件。W3 冻结 Python、Node、依赖及包管理器版本，提交 lockfile；禁止未经检查地写“任意最新版均可”。

### 4.2 数据处理流水线

```text
TCP 字节流
  → 有界缓冲 / 帧头同步 / 长度上限 / CRC
  → 设备握手认证 / 协议版本 / 消息 schema
  → 身份与会话绑定 / 序号和样本连续性
  → 原始记录队列 ───────────→ 分段文件与 SQLite 索引
  → 各参数时间与质量状态
  → 独立的显示变换（有元数据）
  → 各浏览器有界队列
  → WebSocket
  → 前端时间环形缓冲 / Canvas 绘制
```

持久化不能阻塞接入事件循环；SQLite 和文件写入由受控工作线程或专门写入服务处理，队列必须有容量及失败策略。每个浏览器独立排队，慢浏览器不能拖垮设备接收与其他浏览器。

### 4.3 首版建议配置

```yaml
app:
  mode: lab                    # lab / replay；不是临床模式
  allow_real_patient_data: false
network:
  tcp_host: "192.168.10.20"     # 示例，必须改为电脑实际实验网卡 IP
  tcp_port: 9000
  http_host: "127.0.0.1"        # 本机大屏默认仅回环
  http_port: 8000
  max_devices: 4
  max_payload_bytes: 4096
  handshake_timeout_s: 5
  offline_after_s: 5
  allowed_ws_origins:
    - "http://127.0.0.1:8000"
    - "http://localhost:8000"
stream:
  ecg_default_sps: 250
  expected_ecg_packet_ms: 40
  live_window_s: 10
  client_queue_max_ms: 1000
  freeze_gap_policy: blank_and_mark
recording:
  enabled: true
  root: "./records"
  chunk_seconds: 60
  auto_delete: false
  low_space_warn_gib: 5
  stop_recording_below_gib: 1
security:
  require_device_auth: true
  allow_remote_nibp_start: false
  secrets_file: "./private/device_keys.json" # 禁止纳入 Git
```

上述 IP、端口和阈值是可修改的项目配置示例，不是对用户当前网络的读取结果。需要第二台电脑看屏时，经批准将 HTTP/WS 绑定实验网卡地址，增加准确的允许来源和防火墙范围；不能为省事默认全公网开放。

## 五、状态、单位与时钟设计

### 5.1 设备状态与参数状态分离

设备状态：`CONNECTING → AUTHENTICATING → ONLINE → OFFLINE`，协议错误或认证失败可进入 `REJECTED`。节点在线不能覆盖其传感器故障。

每个参数的质量至少支持 `VALID / INVALID / WARMUP / SENSOR_OFF / LEAD_OFF / ERROR / UNKNOWN`；服务端另计算 `STALE`。供应商不提供某状态时不猜测，映射为 `UNKNOWN` 或有证据的通用无效状态。

连续参数默认超过 3 s 未有新的有效采集结果时标陈旧，具体周期随能力表冻结；离线默认是 5 s 没有通过校验和会话检查的通信。收到心跳或重复旧数值不能刷新参数的采集时间。无效值在数据层为 `null`，网页显示 `--` 和原因，不用 0 表示探头脱落。

血压是事件型结果：展示“最近一次结果 + 完成时间 + 当前状态”。测量中收到压力值，不得替换为最终 SYS/DIA；最近结果可以保留但必须标“历史结果”，不能包装成当前连续测量。

### 5.2 时间定义

每帧 `mono_us` 为设备本次启动后的单调微秒计数。波形帧表示**第一采样点的采集时间**，不能填写发送时刻；参数帧中每项 `sample_mono_us` 表示该结果自身的采集/生成时间。MCU 应采用可靠的 64 位扩展时间基准并测试溢出，不能直接把 32 位微秒计数当作永不回绕。

服务器分别记录接收单调时间和 UTC 时间；UTC 用于日志展示，不参与重连超时和采样间隔判断。设备重启用 `boot_id` 切分时间轴；不得让波形时间倒退后继续拼接成同一段。

### 5.3 近似时间映射与限制

握手后每 10 s 发起一次 `SYNC_REQ`，服务器记录发送时刻 `s0`；设备回复接收时刻 `d1`、回复入发送队列时刻 `d2`；服务器记录收回时刻 `s3`。使用微秒为单位估计：

```text
offset = ((s0 + s3) - (d1 + d2)) / 2
server_mono_est(device_time) = device_time + offset
network_delay_est = (s3 - s0) - (d2 - d1)
```

选择近期有效样本中往返开销较小者，并记录至少为残余往返时延一半加测时裕量的映射不确定度；负时延、重启、过旧同步等情况视为无效。串口排队、Wi-Fi 不对称延迟和时钟漂移会影响精度，所以**不承诺跨节点采样级同步，不据此做 ECG–PPG 脉搏传导时间等研究**。

浏览器到服务器另做同类 ping/pong 映射，不直接相减 `performance.now()` 和 Python 的时钟。端到端延迟仅在设备及浏览器映射总不确定度不超过 50 ms 时报告，否则展示“时钟未校准”并单独测接收/绘制处理开销。

## 六、网页大屏设计要求

### 6.1 页面与角色

| 页面 | 内容 | 权限 |
|---|---|---|
| `/dashboard` | 参数、波形、单位、会话、质量、在线状态、模式标签、全屏 | 只读展示 |
| `/devices` | 节点身份、固件、能力、速率、队列/缺口、重连记录 | 管理员 |
| `/records` | 会话列表、回放、导出、记录完整性 | 授权用户 |
| `/settings` | 设备绑定、实验网络、记录目录、工程提示配置 | 管理员 |
| `/diagnostics` | 服务健康、磁盘、协议统计、最近错误 | 管理员 |

模拟、回放、实物三种来源不可混淆。页面顶栏强制显示“工程样机 / 非临床用途”，并以醒目文字显示当前数据模式；不能通过普通设置隐藏该标识。

### 6.2 波形显示

接收频率和绘制频率分离，使用 10 s 有界时间缓冲与 `requestAnimationFrame`；优先 Canvas 连续绘制，不让 React 在每个样本到达时重建整页。采样率影响数据时间轴，刷新率只影响画面更新。

默认显示秒与已知物理单位。未核验量程时显示 ADC counts 或相对幅值；显示器未做物理尺寸标定时，不宣称严格的 25 mm/s 医疗走纸速度。数据量超过像素宽度时采用保峰值的最小/最大抽取等可解释显示方法，原始文件保持不变。

丢包/断线处留空并标记，不用重复点、0 填充或平滑直线伪造连续波形。拖慢页面时允许丢弃过期的显示消息以追上实时，但须产生客户端 `display_gap`；这一行为不能影响原始记录，也不能被统计成采集端真实丢样。

### 6.3 数值和告警

HR_ECG 与 PR_SPO2 分别显示来源，不能相互覆盖。温度标“物表/环境/模块补偿值”，NIBP 显示最后完成时间。技术故障优先保持可见；工程阈值提示需要迟滞、持续时间及确认日志。音频可能受浏览器播放授权限制，不能假定页面打开就一定会鸣响，也不能依赖网页提示承担安全保护。

## 七、API 与 WebSocket 契约

### 7.1 HTTP API

| 方法与路径 | 功能 | 约束 |
|---|---|---|
| `GET /api/v1/health` | 服务、记录、磁盘、接入状态 | 不泄露密钥和敏感路径 |
| `GET /api/v1/devices` | 节点及能力列表 | 管理权限 |
| `POST /api/v1/sessions` | 创建实验监测会话 | 使用实验编号，不收集患者身份 |
| `PUT /api/v1/sessions/{id}/bindings` | 显式绑定节点/流 | 拒绝同流被冲突绑定 |
| `GET /api/v1/sessions/{id}/snapshot` | 当前状态与可用值 | 必含质量与采集时间 |
| `POST /api/v1/devices/{id}/commands` | 受控命令入口 | 白名单、权限、幂等；不能接收任意 AT/串口字节 |
| `GET /api/v1/records` | 记录索引 | 只访问记录根目录 |
| `GET /api/v1/records/{id}/export` | CSV/原始文件导出 | 单位、质量、时间、版本完整 |
| `WS /ws/v1/sessions/{id}` | 订阅实时数据 | 同源校验、授权、背压、重连 |

浏览器不得自行提交“血压模块原始启动帧”。服务器接受业务命令，再由设备固件映射为已经核验的供应商指令。

### 7.2 WebSocket 消息

使用 JSON 消息封装 `schema`、`kind`、`monitor_session_id`、`device_id`、`boot_id`、`stream_id`、`source_mode`、`server_received_utc`、`data`。`uint64` 时间与样本编号在 JSON 中使用十进制字符串，以避免跨语言整数精度问题。波形先用批量数组，测试证明需要优化后再引入二进制 WS，而非首版并行维护两套实现。

```json
{
  "schema": "mmp-web/1",
  "kind": "wave",
  "monitor_session_id": "lab-session-001",
  "device_id": 101,
  "boot_id": 7,
  "stream_id": 1,
  "source_mode": "SIMULATED",
  "server_received_utc": "2026-09-18T00:00:00Z",
  "data": {
    "config_id": 1,
    "sample_rate_hz": 250,
    "first_sample_index": "0",
    "sample_mono_us": "1000000",
    "channel_codes": ["RESP_ADC", "ECG_ADC"],
    "unit": "adc_count",
    "samples": [[12, -25], [15, -10]],
    "quality": "VALID"
  }
}
```

示例为格式演示，样本数量缩短，不代表真实测量；`channel_codes` 必须来自经核验的当前配置，不得硬编码所有 ADS 模块必定为上述通道顺序。

客户端重新连接先取快照和当前配置，再开始接收新帧。不能将上次浏览器缓存的正常值在新会话中直接展示。服务器对单客户端的待发送时间窗上限建议 1 s；超限丢弃过期显示波形并发出缺口事件，必要时断开慢客户端。

## 八、记录、日志与恢复

### 8.1 存储组织

```text
records/
  <monitor_session_id>/
    manifest.json
    <device_id>/<boot_id>/
      chunk_000001.mmp
      chunk_000002.mmp
    index.sqlite
```

每个分段保存完整原始 MMP 帧，保留设备身份、采样配置、版本和 CRC。SQLite 保存会话、设备绑定、低频参数、事件、分段索引与完整性状态；不要把每个 ECG 采样点作为独立数据库事务。

建议 60 s 分段，使用临时文件完成后重命名；中途崩溃时识别末尾不完整帧并报告截断位置。刷盘策略、崩溃时最大可能未落盘区间须写入实现说明，不能声称普通异步写盘完全没有掉电丢失窗口。

根据默认数据预算，原始记录可能达到每天数百 MB；具体值取决于通道、JSON 参数量与日志量。暂按 **0.4–1 GB/24h 的设计预算**准备空间并实测修订，不把估算写成精确容量。自动删除默认关闭；只有经批准的保留策略才可删除本应用记录根目录内的过期文件，不触碰用户其他目录。

### 8.2 必须记录的诊断信息

协议/固件/软件版本、连接起止、认证失败类别、字节速率、有效/坏帧计数、全局序号跳变、每流样本缺口、队列高水位、重连、供应商错误状态、时间映射质量、磁盘警告、记录失败、控制命令状态、浏览器显示缺口。

日志不得输出 PSK、管理员密码或完整认证材料。必须区分“MCU 采样丢失”“节点缓存丢弃”“TCP 连接中断”“服务器记录失败”“浏览器追帧丢弃”，不能统称为网络丢包。

### 8.3 断网策略

设备本地采样与安全状态机继续运行。首版实时发送队列保留有限最近数据，满时丢弃最旧的完整波形批次并累计缺口；恢复后发送缺口事件和当前数据，不把几十秒前的波形当实时流灌入页面。

本期不承诺板端全量断网存储。即使仓库提到板载 Flash，也要重新计算容量、寿命、文件格式与补传协议；是否支持历史补传按二期或 G0 条件项处理。TCP 的可靠字节流不代表设备断网、掉电、采样溢出时不会丢数据。

## 九、安全、网络与权限基线

首版限实验室受控局域网，AP 支持 2.4 GHz，电脑建议有线接路由器；确认 AP 没有阻断终端互访。服务器地址用 DHCP 保留或经管理员确认的固定地址，设备主动建立 TCP 连接。

默认不开放公网端口、不配置路由器端口转发、不接入用户腾讯云服务器、不提供穿透服务。Windows 防火墙只放行程序/目标端口到指定私有实验子网。网页在本机回环访问，其他客户端访问必须单独授权。

设备采用附录 A 的 PSK 挑战应答和身份白名单；管理员口令哈希保存，控制接口另做权限与 CSRF/Origin 防护。前端登录令牌不得放进可泄露的 WebSocket URL 查询参数，优先采用同源安全会话机制。

**重要限制：PSK 握手、CRC、Wi-Fi 密码、白名单都不等于 TCP 应用数据已加密，也不等于抵御主动中间人或每帧篡改。**本期正常 TCP/HTTP/WS 路径仅适用于上述实验测试数据。在引入真实人体可识别健康数据、跨不可信网络或外网访问前，必须增加经过验证的端到端 TLS/证书校验、数据治理和安全评审；不能把“ESP 支持某种 SSL 命令”直接视为方案已安全落地。[S6–S7]

远程血压开始默认关闭。即使条件项获准，仍需本地确认、已核验的模块协议、控制白名单、唯一命令 ID、短有效期、设备空闲状态和独立本地保护；网页确认不能替代本地安全机制。

## 十、P 的专项验收与工作成果

| 编号 | 验收项 | 通过标准 |
|---|---|---|
| P-T01 | 需求与方案 | 六阶段文档、需求追踪、条件项、风险、边界经评审 |
| P-T02 | 协议 | 附录 A、金样、Python 参考与 B 的 C 实现一致；不以 README 简写替代 |
| P-T03 | 模拟接入 | 1–4 模拟节点，含有效值、无效值、重启、掉线和坏帧 |
| P-T04 | TCP 正确性 | ≥1000 帧随机切分/粘合、超长/坏 CRC/半帧断连全部通过 |
| P-T05 | 真机对照 | 冻结数量的真实节点接入；每个模块至少正常/异常各一组原始证据 |
| P-T06 | 网页 | 1080p 两客户端，状态/时间/单位/来源明确；截图与录屏真实可重现 |
| P-T07 | 性能 | 服务接收至前端入绘制队列 P95≤200 ms；条件满足时估计端到端 P95≤500 ms |
| P-T08 | 稳定性 | 全链路 24h 报告，统计缺口、重启、内存、磁盘及异常；无未解释失败 |
| P-T09 | 回放/导出 | 3×60 s 抽样对照，样本数、值、单位、事件及模式标签一致 |
| P-T10 | 部署 | 第二人按文档在干净环境完成启动，配置不依赖 P 的用户名/COM 号 |
| P-T11 | 故障与安全 | 未注册设备拒绝、权限生效、记录失败可见、无公网暴露 |
| P-T12 | 交接 | 源码、锁文件、测试、配置模板、说明书、诊断方法、已知限制完整 |

性能报告记录硬件型号、CPU/内存、浏览器版本、屏幕刷新设置、AP、节点数量、采样率和测量脚本。空白美观界面、固定演示曲线、手工改页面数值不构成真机验收。

建议内存验收方式：先记录 1 h 稳态窗口，再与第 23–24 h 窗口比较，排查持续增长趋势；具体内存上限由 G2 根据电脑配置冻结。不得用一次任务管理器截图宣称不存在泄漏。

## 十一、P 的执行顺序与提交规则

1. 先建立资料冲突/实物能力台账，冻结 `device_id`、流定义、单位和采样率；没有依据的模块能力标未知。
2. 完成附录 A 的跨端评审及 Python 金样，让 B 先通过 C 编解码比较，再把 ESP 正常发送链路接上。
3. 做最小 TCP 接收和诊断页，先能定位坏帧/掉线/时间/来源；再接记录和 WebSocket。
4. 用有标签的模拟节点完成整条软件链；每次只替换一个真实模块，逐项对照原始抓包。
5. 最后完成视觉精修、长期试验、受控演示、可复现部署和移交，不以截图替代运行报告。

每次阶段提交包含：提交 SHA、启动方式、变更范围、测试命令及结果、原始证据、已知失败、下一阶段依赖。协议变更必须给出兼容性说明和新增金样。

签署：P ______；A ______；B ______；验收人 ______；日期 ______。专项合同生效及费用/权属仍从属总合同。

---

# 附录 A：MMP/1 通信协议 v0.1

**性质：本项目原创工程协议草案，不是医疗行业标准，也不是任何传感器供应商的串口协议。**G2 冻结后，C 固件、Python 服务与模拟器必须使用相同版本。本附录采用“二进制外帧 + 二进制波形 / UTF-8 JSON 控制与低频值”。

## A1. 分层与统一规则

传感器 SPI/UART/I2C 帧在 STM32 的驱动层解析；MMP/1 帧由 STM32 生成，通过 ESP-AT 的定长发送进入 TCP 字节流。ESP 不负责解释体征含义。服务器解析 MMP/1 后再转为网页 JSON，不把 ASCII `+IPD` 或 `SEND OK` 当成体征数据。

所有多字节二进制整数均为**小端**；文本为 UTF-8；外帧无换行、无结尾 `0D0A`、无字节转义。帧最大载荷 4096 B，总长最大 4140 B。CRC 只用于完整性检测，不是认证或加密。认证连接的 `session_id` 与业务监测的 `monitor_session_id` 是两个不同标识，不得混用。

## A2. 固定 40 字节帧头

| 偏移 | 长度 | 字段 | 类型/规则 |
|---:|---:|---|---|
| 0 | 4 | magic | 固定 ASCII `MMP1`，十六进制 `4D 4D 50 31` |
| 4 | 1 | version | `uint8`，当前为 1 |
| 5 | 1 | msg_type | `uint8`，见 A3 |
| 6 | 2 | flags | `uint16`；bit0=源数据为模拟；bit1=回放；其余必须为 0 |
| 8 | 2 | header_len | `uint16`，固定 40 |
| 10 | 2 | reserved0 | 固定 0 |
| 12 | 4 | payload_len | `uint32`，0–4096，具体消息另有最小长度 |
| 16 | 4 | seq | `uint32`，每方向、每 device/boot 独立递增，模 2^32 回绕 |
| 20 | 4 | device_id | `uint32`，项目配置的非零节点 ID，不是 IP |
| 24 | 4 | boot_id | `uint32`，本次启动标识；重连保持，重启更换 |
| 28 | 8 | mono_us | `uint64`，节点单调时间；服务器发出的帧头此字段填 0，时间字段放入相应载荷 |
| 36 | 2 | stream_id | `uint16`，0 表示节点控制/聚合；非 0 表示已登记流 |
| 38 | 2 | reserved1 | 固定 0 |

帧布局为：`40 B header + payload_len B payload + 4 B CRC`。CRC 覆盖头和载荷，不覆盖自身；尾部 CRC 也用小端。不得用编译器默认对齐的 C struct 直接 memcpy 上网，应显式读写字段；C `sizeof` 与 Python 头长度测试都必须等于 40。

`boot_id` 配套 HELLO 的 128 位 `boot_nonce`，由冻结的随机/唯一性方案产生；同启动重连不得改变。项目设备 ID 冲突必须拒绝注册，不依赖“随机碰撞几乎不会发生”掩盖配置错误。

## A3. 消息类型

| 值 | 名称 | 方向 | 载荷 |
|---|---|---|---|
| 0x01 | HELLO | 节点→服务器 | JSON，身份、boot_nonce、固件、模块与流能力 |
| 0x02 | CHALLENGE | 服务器→节点 | JSON，session_id、server_nonce、challenge_id |
| 0x03 | AUTH | 节点→服务器 | JSON，challenge_id、hmac_sha256 |
| 0x04 | WELCOME | 服务器→节点 | JSON，结果、session_id、配置与心跳要求 |
| 0x10 | WAVE | 节点→服务器 | A5 的二进制批量波形 |
| 0x11 | VITALS | 节点→服务器 | A6 的低频参数 JSON |
| 0x12 | EVENT | 节点→服务器 | 状态、错误、样本缺口、重启等 JSON |
| 0x20 | COMMAND | 服务器→节点 | 受控业务命令 JSON |
| 0x21 | COMMAND_RESULT | 节点→服务器 | 命令接收/完成/失败 JSON |
| 0x30 | HEARTBEAT | 双向 | JSON，状态与统计；不是生理参数刷新 |
| 0x31 | SYNC_REQ | 服务器→节点 | JSON，sync_id、s0_us 字符串 |
| 0x32 | SYNC_RESP | 节点→服务器 | JSON，sync_id、s0_us、d1_us、d2_us 字符串 |

不认识的消息类型记录为协议错误，不以另一类型尝试解释。连接阶段不合法的消息（例如认证前的 WAVE）直接拒绝。每个 TCP 连接只能对应一个已认证 device/boot；最多 4 个采集连接。

## A4. 握手、能力与认证

HELLO 示例（格式演示，不代表已验证的硬件能力）：

```json
{
  "protocol": "MMP/1",
  "device_uid": "provisioned-node-A-001",
  "boot_nonce": "00112233445566778899aabbccddeeff",
  "firmware": "prototype-0.1.0",
  "board": "STM32F407-revision-TBD",
  "modules": [{"module_id": "ecg", "model": "ADS1292R", "verified": false}],
  "streams": [{
    "stream_id": 1,
    "config_id": 1,
    "sample_rate_hz": 250,
    "format": "i24_le",
    "channel_codes": ["CH1_RAW", "CH2_RAW"],
    "unit": "adc_count",
    "gain": null,
    "vref_uv": null,
    "sensor_profile_hash": "TBD"
  }]
}
```

正式固件不能以 `TBD` 或 `verified:false` 冒充已通过硬件能力验收。`gain`/`vref_uv` 未核验时允许传原始 counts，但服务器不得显示为校准 mV。HELLO 中的配置在该连接期间不可悄然变化；改配置需先停流、重新登记新 `config_id` 并形成事件。

PSK 为每节点独立的 32 字节密钥，离线配置并排除出 Git。服务器生成 32 字节 `server_nonce` 和 16 字节 `session_id`，分别以 64/32 个十六进制字符传输；`challenge_id` 为唯一挑战编号，5 s 到期，一次使用。

认证字节串严格为：

```text
ASCII("MMP-AUTH-v1\0")
  || LE32(device_id)
  || LE32(boot_id)
  || HEX_DECODE(boot_nonce)     # 16 B
  || HEX_DECODE(server_nonce)   # 32 B
  || HEX_DECODE(session_id)     # 16 B
```

其中 `\0` 表示实际的一个 `0x00` 字节，不是反斜杠加数字。节点返回 `HMAC-SHA256(PSK, 上述字节串)` 的小写十六进制字符串。服务器以恒定时间比较，拒绝旧挑战、错误 device_uid/ID 绑定与重复活跃连接。认证通过后才能发送体征帧；重连必须重新挑战，不能复用旧 session_id。

这只是实验网络的设备准入，不保护认证后每帧免遭主动攻击，也不加密数据；不允许据此声称可处理公网或患者数据。进一步安全要求见第九章。

## A5. 二进制波形载荷

| 载荷偏移 | 长度 | 字段 | 规则 |
|---:|---:|---|---|
| 0 | 4 | sample_rate_hz | `uint32`；首版 ADS 默认 250，压力档 500 |
| 4 | 2 | sample_count | `uint16`；必须 >0，且满足长度上限 |
| 6 | 1 | channel_count | `uint8`；必须 >0，并与 HELLO 一致 |
| 7 | 1 | sample_format | 1=`signed int24 little-endian` |
| 8 | 4 | config_id | `uint32`；必须对应已登记配置 |
| 12 | 4 | reserved | 固定 0 |
| 16 | 8 | first_sample_index | `uint64`；该 boot/stream 内连续样本编号 |
| 24 | 可变 | samples | 按“采样点优先、该点各通道依次排列” |

长度必须精确满足：`payload_len = 24 + sample_count × channel_count × 3`。ADS 从 SPI 收到的字节顺序由驱动解释后再转成上述小端格式；不能把 SPI 帧整段未经处理当成本协议数据。

例如两通道、10 个采样点时，样本布局为 `t0ch0,t0ch1,t1ch0,t1ch1,...,t9ch0,t9ch1`。`mono_us` 是 `t0` 时间；第 i 点在不发生丢样时的时刻为 `t0 + i×1e6/sample_rate_hz`。

24 位有符号解码：先取 `u=b0|(b1<<8)|(b2<<16)`；若 `u&0x800000` 非零，则值为 `u-0x1000000`。范围 `[-8388608, 8388607]`。原始整数与换算单位分开，是否转换 mV 依赖已核验的量程与增益。

每流独立核对 `first_sample_index`。样本缺口、设备缓存丢弃、配置切换需 EVENT；一包中间存在缺口时拆为两包，不能在缺口处填 0 后仍报告连续。

## A6. 低频参数与事件

VITALS 示例为**模拟数据格式**：

```json
{
  "metrics": [
    {"code": "HR_ECG", "value": 72, "unit": "bpm", "quality": "VALID", "sample_mono_us": "1000000", "algorithm": "hr-demo-v1"},
    {"code": "SPO2", "value": null, "unit": "%", "quality": "WARMUP", "sample_mono_us": "1000000", "algorithm": "vendor"},
    {"code": "TEMP_OBJECT", "value": 32.5, "unit": "degC", "quality": "VALID", "sample_mono_us": "1000000", "algorithm": "vendor"}
  ]
}
```

合法代码首版为 `HR_ECG / PR_SPO2 / SPO2 / NIBP_SYS / NIBP_DIA / TEMP_OBJECT / TEMP_AMBIENT / TEMP_COMPENSATED`；条件项为 `RR / NIBP_MAP`。单位分别限定为 `bpm / % / mmHg / degC / rpm`，其中 `rpm` 在本项目仅定义为每分钟呼吸次数，网页写中文避免歧义。

不允许 `NaN`、`Infinity`、把整数百分比当 0–1 比例、把 kPa 当 mmHg。合法值域来自冻结的传感器能力表与数值类型，不在本协议中假定临床正常区间。`quality != VALID` 时 `value` 必须为 null；历史有效值由服务端另存，不与当前无效结果混成一项。

NIBP 的最终结果必须作为同一测量的原子集合，包含 `measurement_id`、`completed_mono_us`、SYS/DIA 及可用的 MAP/PR；不得将两次测量的 SYS 与 DIA 配成一组。模块“心律不齐”标志仅作为来源明确的 `vendor_flags` 保存，不在网页改写成确诊结论。

EVENT 基本字段：`event_id`、`event_code`、`module_id`、`stream_id`、`severity`、`details`。样本缺口还含 `first_missing_sample_index`、`missing_count`、`reason`。设备本地错误的原始码可保留，但网页显示经过文档化映射的人类可读原因。

## A7. 控制、幂等和血压安全

首版默认允许 `get_status`、`get_capabilities` 及经硬件核验的安全取消操作；`nibp.start` 默认关闭。不存在“任意执行串口字节”命令。

```json
{
  "command_id": "0123456789abcdef0123456789abcdef",
  "session_id": "00112233445566778899aabbccddeeff",
  "module_id": "nibp",
  "op": "get_status",
  "args": {},
  "deadline_server_mono_us": "5000000"
}
```

命令必须匹配当前认证会话和目标模块。可能启动执行器的命令需要有效时钟映射，建议有效期不超过 3 s；未同步或截止时间已过时拒绝开始。只读命令可以采用服务器超时处理；安全取消按经审查的本地策略处理，不因网页超时而屏蔽必要取消。

结果分为 `ACCEPTED / COMPLETED / REJECTED / FAILED / CANCELLED`。`ACCEPTED` 仅表明接收并获准，不表示测量完成；`SEND OK`、TCP 写入成功更不等于业务执行成功。

节点缓存最近至少 16 个 command_id 及执行状态，至少保留 120 s。同一 ID 重发只能返回已有状态，不再次启动测量；缓存满且无法保证幂等时拒绝新的执行器开始命令。设备重启后不得接受旧会话命令，服务器也不能自动重发开始命令。

UI 超时显示“结果未知/待查询”，不能自动生成新 command_id 再次启动。物理取消、超时、模块异常处理由 B 的本地状态机独立完成。

## A8. 心跳、重连与序号

HEARTBEAT 建议 1 s 一次；内容为节点运行状态、uptime、模块状态、队列高水位、丢弃样本计数等，不重复伪造体征采集时间。

设备重连退避建议 `1、2、4、8、16、30 s`，加 ±20% 抖动，认证成功后恢复初值；验收时从 AP 和服务器均已可用开始计时，目标 45 s 内恢复，实际网络必须冻结。设备主动连接，服务器不依赖设备固定 IP。

`seq` 对每个发送方向、每 device/boot 连续递增，即使重连也继续；到 0xFFFFFFFF 后按模 2^32 回绕。服务器分方向记录，不把下行与上行序号混为一列。序号跳变用于诊断；具体丢失样本由各流的样本编号决定，不能从混合消息 seq 差值推断 ECG 丢了多少点。

## A9. CRC 与流式解析

CRC 使用 **CRC-32/ISO-HDLC**：多项式 `0x04C11DB7`，反射实现多项式 `0xEDB88320`，初值 `0xFFFFFFFF`、输入/输出反射、最终异或 `0xFFFFFFFF`。不能直接假设 STM32 硬件 CRC 外设的默认输出符合本规范：输入顺序、反射、尾部不足 4 字节和最终异或均需先通过金样。与 Python `zlib.crc32(data) & 0xFFFFFFFF` 一致；字符串 `123456789` 的检查值为 `0xCBF43926`。[S8]

解析顺序：寻找 magic → 足够 40 B 后读头 → 验版本/保留位/类型/长度 → 等完整帧 → CRC → 身份/状态/schema → 业务处理。不能“一次 recv 就是一包”，也不能只靠 `MMP1` 分割二进制载荷。

无效头或 CRC 失败可丢弃一个字节后继续寻找 magic；保留末尾 3 字节以处理跨读取边界的帧头。应用层建议连续 8 次协议错误断开连接；单个不完整帧超过 5 s 也应中止，防止攻击者或故障设备占用缓冲。所有错误计数应可见。

## A10. ESP8266 AT 通信约束

ESP8266 使用正常发送模式而非默认透传，便于同时管理命令、接收、错误和重连。初始化序列为逻辑顺序，实际命令兼容性以 `AT+GMR` 和固件文档核验：[S6]

```text
AT
ATE0
AT+GMR
AT+CWMODE=1
AT+CWJAP="<实验SSID>","<实验密码>"
AT+CIPMUX=0
AT+CIPMODE=0
AT+CIPSTART="TCP","<电脑实验网卡IP>",9000

发送每个字节块：
AT+CIPSEND=<N>
等待 > 提示符
发送严格 N 字节（二进制，不能 strlen）
等待 SEND OK / ERROR / 超时
```

使用 `AT+CIPSEND`，不混用可能解释转义序列的扩展发送方式。正常发送参考文档规定的长度上限为 2048 B，本项目将单次发送块限制为 **≤1024 B**，便于队列管理；大于此值的 MMP 帧拆成多次 CIPSEND，由 TCP 接收端重新组成，不能截断应用帧。[S6]

`+IPD,<len>:<data>` 按声明长度解析，数据内可能含 `\r\n`、`OK`、`+IPD` 等任意字节；不能用文本子串查找方式解析二进制数据。固件若启用额外 IPD 字段/被动接收模式，必须固定并更新解析器测试，不能混用格式。

AT 状态机只有一个发送拥有者，UART 接收使用 DMA 环形区并及时消费。AT 回应、异步 `CLOSED/WIFI DISCONNECT` 与入站数据分层解析。发送超时不可让采样任务一直等待；网络堵塞使用有界队列和缺口事件。

## A11. 测试向量和实现要求

最小心跳帧：version=1、type=0x30、flags=1（模拟）、seq=3、device_id=1、boot_id=2、mono_us=1000000、stream_id=0、payload=`{}`。十六进制金样由附录 B 的实际运行生成，见其末尾结果。

至少增加以下 C/Python 共同测试：int24 的最小/最大/负一/零；250 SPS 双通道批量；JSON 中文 UTF-8；含 magic 字节的载荷；长度 4096；长度 4097 拒绝；CRC 错误；逐字节喂入；两包粘连；序号回绕；半帧断开；鉴权前发数据拒绝；旧 session 控制拒绝。

供应商串口帧金样与 MMP 金样分开管理：前者由模块负责人提供原始出处，后者由本协议生成。两者都应纳入仓库测试，但不能相互替代。

---

# 附录 B：可执行的帧级 Python 参考与编制时检查

下面代码只覆盖外帧打包、CRC、int24、流式解帧和金样；**不是完整服务器、认证模块、JSON schema 校验器或医疗软件**。保存为 `mmp_frame_reference.py`，用锁定的 Python 3 环境执行。正式实现还要补齐附录 A 的身份、长度语义、超时、消息状态、HMAC 和资源限制测试。

```python
"""MMP/1 frame reference. Standard-library only; not a complete server."""
from __future__ import annotations

from dataclasses import dataclass
import hashlib
import hmac
import random
import struct
import zlib

HEADER = struct.Struct("<4sBBHHHIIIIQHH")
U32 = struct.Struct("<I")
MAGIC = b"MMP1"
MAX_PAYLOAD = 4096
TYPES = {1, 2, 3, 4, 0x10, 0x11, 0x12, 0x20, 0x21, 0x30, 0x31, 0x32}
assert HEADER.size == 40

def uint(value: int, bits: int) -> int:
    if isinstance(value, bool) or not isinstance(value, int):
        raise TypeError("integer required")
    if not 0 <= value < (1 << bits):
        raise ValueError(f"out of uint{bits} range")
    return value

@dataclass(frozen=True)
class Frame:
    msg_type: int
    flags: int
    seq: int
    device_id: int
    boot_id: int
    mono_us: int
    stream_id: int
    payload: bytes

def encode(frame: Frame) -> bytes:
    if frame.msg_type not in TYPES or frame.flags & ~3:
        raise ValueError("unsupported type/flags")
    if not isinstance(frame.payload, bytes):
        raise TypeError("payload must be bytes")
    if len(frame.payload) > MAX_PAYLOAD or frame.device_id == 0:
        raise ValueError("payload too large or device_id is zero")
    head = HEADER.pack(
        MAGIC, 1, uint(frame.msg_type, 8), uint(frame.flags, 16), 40, 0,
        len(frame.payload), uint(frame.seq, 32), uint(frame.device_id, 32),
        uint(frame.boot_id, 32), uint(frame.mono_us, 64),
        uint(frame.stream_id, 16), 0,
    )
    body = head + frame.payload
    return body + U32.pack(zlib.crc32(body) & 0xFFFFFFFF)

class Parser:
    """Frame extraction only; caller enforces auth/schema/timeouts/error budget."""
    def __init__(self) -> None:
        self.buffer = bytearray()
        self.errors = 0

    def feed(self, data: bytes) -> list[Frame]:
        if not isinstance(data, bytes):
            raise TypeError("data must be bytes")
        if len(data) > 65536:
            raise ValueError("feed chunk exceeds 64 KiB; use bounded socket reads")
        self.buffer.extend(data)
        out: list[Frame] = []
        while True:
            pos = self.buffer.find(MAGIC)
            if pos < 0:
                if len(self.buffer) > 3:
                    del self.buffer[:-3]
                break
            if pos:
                del self.buffer[:pos]
            if len(self.buffer) < HEADER.size:
                break
            fields = HEADER.unpack_from(self.buffer)
            (magic, version, typ, flags, hlen, r0, plen, seq,
             device, boot, mono, stream, r1) = fields
            if (version != 1 or typ not in TYPES or flags & ~3 or hlen != 40
                    or r0 != 0 or r1 != 0 or plen > MAX_PAYLOAD or device == 0):
                self.errors += 1
                del self.buffer[0]
                continue
            total = HEADER.size + plen + U32.size
            if len(self.buffer) < total:
                break
            wanted = U32.unpack_from(self.buffer, total - U32.size)[0]
            actual = zlib.crc32(self.buffer[:total - U32.size]) & 0xFFFFFFFF
            if wanted != actual:
                self.errors += 1
                del self.buffer[0]
                continue
            payload = bytes(self.buffer[HEADER.size:total - U32.size])
            out.append(Frame(typ, flags, seq, device, boot, mono, stream, payload))
            del self.buffer[:total]
        return out

def encode_i24(value: int) -> bytes:
    if isinstance(value, bool) or not isinstance(value, int):
        raise TypeError("integer required")
    if not -(1 << 23) <= value < (1 << 23):
        raise ValueError("out of int24 range")
    return (value & 0xFFFFFF).to_bytes(3, "little")

def decode_i24(data: bytes) -> int:
    if len(data) != 3:
        raise ValueError("exactly three bytes required")
    value = int.from_bytes(data, "little")
    return value - (1 << 24) if value & (1 << 23) else value

def auth_digest(psk: bytes, device_id: int, boot_id: int,
                boot_nonce: bytes, server_nonce: bytes, session_id: bytes) -> str:
    if tuple(map(len, (psk, boot_nonce, server_nonce, session_id))) != (32, 16, 32, 16):
        raise ValueError("invalid key/nonce/session length")
    if device_id == 0:
        raise ValueError("device_id must not be zero")
    body = (b"MMP-AUTH-v1\x00"
            + struct.pack("<II", uint(device_id, 32), uint(boot_id, 32))
            + boot_nonce + server_nonce + session_id)
    return hmac.new(psk, body, hashlib.sha256).hexdigest()

def self_test() -> None:
    assert zlib.crc32(b"123456789") == 0xCBF43926
    for value in (-(1 << 23), -1, 0, 1, (1 << 23) - 1):
        assert decode_i24(encode_i24(value)) == value
    sample = Frame(0x30, 1, 3, 1, 2, 1_000_000, 0, b"{}")
    raw = encode(sample)
    p = Parser()
    result: list[Frame] = []
    for byte in raw:
        result.extend(p.feed(bytes([byte])))
    assert result == [sample]
    assert Parser().feed(raw + raw) == [sample, sample]
    assert Parser().feed(b"noise" + raw) == [sample]
    bad = bytearray(raw)
    bad[-1] ^= 1
    p = Parser()
    assert p.feed(bytes(bad) + raw) == [sample] and p.errors == 1
    large = Frame(0x12, 1, 4, 1, 2, 0, 0, b"X" * MAX_PAYLOAD)
    assert Parser().feed(encode(large)) == [large]
    try:
        encode(Frame(0x12, 1, 4, 1, 2, 0, 0, b"X" * (MAX_PAYLOAD + 1)))
    except ValueError:
        pass
    else:
        raise AssertionError("oversized payload accepted")
    forged = bytearray(raw)
    U32.pack_into(forged, 12, MAX_PAYLOAD + 1)
    p = Parser()
    assert p.feed(bytes(forged) + raw) == [sample] and p.errors >= 1
    embedded = Frame(0x12, 1, 5, 1, 2, 0, 0, b"MMP1\r\n+IPD\x00")
    assert Parser().feed(encode(embedded)) == [embedded]
    batch = [Frame(0x30, 1, i, 1, 2, i * 40000, 0, b"{}") for i in range(1000)]
    stream = b"".join(map(encode, batch))
    rng, p, out, at = random.Random(20260918), Parser(), [], 0
    while at < len(stream):
        n = rng.randint(1, 2048)
        out.extend(p.feed(stream[at:at + n]))
        at += n
    assert out == batch and p.errors == 0
    digest = auth_digest(bytes(range(32)), 1, 2,
                         bytes(range(16)), bytes(range(32, 64)), bytes(range(16, 32)))
    print("PASS: CRC, int24, byte-feed, coalescing, noise, bad CRC,")
    print("      max length, oversized encode/header, embedded magic, 1000 random-split frames")
    print("HEADER_BYTES=", HEADER.size)
    print("HEARTBEAT_FRAME_BYTES=", len(raw))
    print("HEARTBEAT_GOLDEN_HEX=", raw.hex(" "))
    print("HMAC_VECTOR_HEX=", digest)
    print("NOTE: no C firmware, real devices, full schema or server tests executed here.")

if __name__ == "__main__":
    self_test()
```

## 编制时实际运行结果

以下只表示该帧级 Python 参考程序在本文编制环境中的运行结果；尚未测试 C 固件、真实 ESP/STM32、完整认证状态机、实际数据接收服务或临床性能。

```text
PASS: CRC, int24, byte-feed, coalescing, noise, bad CRC,
      max length, oversized encode/header, embedded magic, 1000 random-split frames
HEADER_BYTES= 40
HEARTBEAT_FRAME_BYTES= 46
HEARTBEAT_GOLDEN_HEX= 4d 4d 50 31 01 30 01 00 28 00 00 00 02 00 00 00 03 00 00 00 01 00 00 00 02 00 00 00 40 42 0f 00 00 00 00 00 00 00 00 00 7b 7d 8c cf 96 9f
HMAC_VECTOR_HEX= ed6262eff79fa004821098378a3a9ea0126e5d7687f86f5b6c18e5546c2d7975
NOTE: no C firmware, real devices, full schema or server tests executed here.
```

认证金样的确定输入：PSK 为 `00..1f` 的 32 字节，device_id=1、boot_id=2，boot_nonce 为 `00..0f`，server_nonce 为 `20..3f`，session_id 为 `10..1f`。这些只是公开测试向量，**不得作为实际设备密钥或随机数**。C 实现应使用相同输入得到相同 HMAC；真实部署必须重新安全生成并配置密钥。

上述检查覆盖传输格式基础，不覆盖全部 A11 验收项。特别是序号回绕的业务判断、命令幂等、认证/权限、JSON 完整语义、时钟映射、过期判断和实物异常仍须在开发阶段实现和测试。

---

## 参考来源与核验限制

检索日期：2026-09-18。协议、工作量、性能验收门槛和软件结构是本项目拟定方案，不是引用商品广告得到的既成能力。

- **[S1] 仓库 README 与原始项目方案**：https://github.com/Serendipity-min/medical-multi-parameter-monitor/blob/main/README.md ；https://github.com/Serendipity-min/medical-multi-parameter-monitor/blob/main/多参数心电监护仪项目方案.md 。README 检索时 blob：`e185b0c15a08fb378d1e38ac3392ddcbc1716ab2`。
- **[S2] 仓库硬件参考与血氧教程**：https://github.com/Serendipity-min/medical-multi-parameter-monitor/blob/main/多参数心电监护仪系统硬件方案与元器件开发参考手册.md ；https://github.com/Serendipity-min/medical-multi-parameter-monitor/blob/main/血氧/使用教程.md 。教程说明的是 AFE4490 Arduino 方案；不是 HKS 成品模块协议已经被确认的证据。
- **[S3] TI ADS1292R 与 AFE4490**：https://www.ti.com/lit/ds/symlink/ads1292r.pdf ；https://www.ti.com/product/AFE4490 。用于核对 AFE 接口和功能边界；不替代模块电路/算法核验。
- **[S4] Melexis MLX90614**：https://www.melexis.com/zh/product/mlx90614/mlx90614 。原生 SMBus/PWM 不等于 GY 模块私有 I2C/UART 命令。
- **[S5] FastAPI WebSocket 官方文档**：https://fastapi.tiangolo.com/advanced/websockets/ 。TCP 设备接入、存储与背压仍由本项目另行实现。
- **[S6] ESP-AT TCP/IP 命令参考，ESP8266 release-v2.2.0.0**：https://docs.espressif.com/projects/esp-at/en/release-v2.2.0.0_esp8266/AT_Command_Set/TCP-IP_AT_Commands.html 。实物 AT 版本、Flash 大小和命令支持范围在 G0 核验；本页不是建议不加验证地升级所有模块。
- **[S7] ESP8266EX 官方数据手册**：https://documentation.espressif.com/0a-esp8266ex_datasheet_en.html 。包含接口、电气与 NRND 状态；不将芯片网络功能当作整机安全验证。
- **[S8] Python zlib 与 RFC 1952 CRC 说明**：https://docs.python.org/3/library/zlib.html ；https://www.rfc-editor.org/rfc/rfc1952.html 。外帧长度、字段布局与测试向量为本项目定义，使用 Python 标准库验证。
- **[S9] ST STM32F407ZG 文档入口**：https://www.st.com/en/microcontrollers-microprocessors/stm32f407zg.html 。最终开发板引脚、DMA、时钟和电气连接必须依据实际板卡原理图核验。
- **[S10] 调研参考的厂家页面**：https://www.mindray.com/cn/products/patient-monitoring/sub-intensive-care-monitoring/epm-10m-12m ；https://www.philips.com.cn/healthcare/product/HC866060/intellivue-mx400 。初步桌面调研通过 Exa 检索原始厂商资料；不代表用户访谈已经完成。

**原理图和供应商协议限制：**本次完成了仓库主要 Markdown 文档与厂商接口资料的核对，没有完成库内全部 PDF/DOC、开发板原理图逐页复核和实物抓包。所有候选接线、桥接模块协议、血压控制字节、实际量程/精度必须按总合同 G0/G2 门槛补证后执行。
