Serendipity-min/medical-multi-parameter-monitor/node-b/docs/AUTH-B5-ESP-UDP-NTP-001-R2.md

# AUTH-B5-ESP-UDP-NTP-001 R2｜修正布尔回复解析，完成尚未发送的单包

继承R1的全部地址/时间/权限边界和负责人的单包授权，不重新识别开发板或做全片哈希。R1实际在CIPDINFO回复`false`时因主机只接受`0`提前停止：socket未打开、载荷尝试0、最小收尾正常，原件保留。`false`和`0`均表示关闭来源信息；只修正这一只读格式识别，不发设置命令。

修正后另开一次180秒执行记录，继续尚未消费的同一单包目标，旧`.used`不复用。跨记录共用独占payload marker，首个载荷字节之前消费；已经尝试载荷或原生SDK/ROM/HALT异常均禁止自动续跑。本次恢复源于必要主机解析修正，不是额外UDP重发许可；所有读写范围仍按R1，异常停并保留记录。
