Serendipity-min/medical-multi-parameter-monitor/artifacts/ecg-source/g2s/BIAS同连接观测说明_20261015.md

# BIAS 同连接仪表观测

此前 BIAS 命令曾成功，但仪表读数期间没有持续的串口状态记录。后续新连接在发送 OFF 前已返回 OFF，无法区分先前复位与打开连接造成的变化，原因尚未确定。本次两路约 0.24 V 是发送明确 OFF 后的现场补充，不纳入 BIAS DC 验收。

新增 `ecg-source/g2s-usb/observe_bias.py` 仅为 Host 工具，不修改或烧录固件。现场确认表笔就绪后使用 COM15，默认窗口 300 秒：

1. 打开一次串口，核对固件身份、初始 OFF、零故障及零串口错误。
2. 仅发送一次 BIAS；成功后输出带 UTC 时间的窗口开始标记。
3. 同一连接每两秒查询状态；现场在此期间用直流20V档测 PA4/GND、PA5/GND，记录读数和时刻，优先提供完整仪表照片。DSO 暂不接板。
4. 模式变化、故障、错误、响应缺失立即终止；不重连、不重新启用 BIAS。退出请求 OFF，仅在收到有效应答后标记确认。
5. 所有请求、应答及异常类型保存在唯一命名的本地私有目录；失败证据不覆盖。

串口采样只证明各个查询时刻的数字状态，不能证明查询之间未发生短暂变化，也不能替代物理电压或动态波形测量。通信中断时工具不能保证 OFF 命令到达，必须明确记录 NOT_CONFIRMED 并按现场停机流程处理。

本轮先解决同一时段的 BIAS DC 对照，未通过前不切换正弦、60/90 bpm，不改变 DAC/BIO 算法，不接 B 板或 ADS。
