Serendipity-min/medical-multi-parameter-monitor/node-b/docs/B5-R6-PATCH01/R6-PHYSICAL-MATRIX.proposed.md

# MPM-B5｜R6 物理接线与三模式工况配置草案 (R6-PHYSICAL-MATRIX.proposed)

> 文档编号：`MPM-B5-R6-PHYSICAL-MATRIX-PROPOSED-V1`  
> 基线依据：R5 现场实测基线与原理图原件（`ADS1292.pdf`、`ADS1292模块电路原理图.pdf`）  
> 状态：`PROPOSED_AWAITING_PI_SIGNATURE`（未经 PI 正式书面签署，禁止现场连线操作）  

---

## 1. 物理工况与接线设计原则

1. **绝对忠实于 R5 现场实测基线**：以 R5 实测现场真实连线为基准，绝不凭空增加 V1 导联、绝不擅自引入“LA 平线接线”、绝不私自串联或并联 100kΩ 接地电阻或修改右腿驱动网络。
2. **严格区分 Lead-Off 与无 QRS 信号**：
   - **Lead-Off（脱落）**：指电极物理断开或接触阻抗超限，ADS1292 芯片内部比较器报硬件脱落；
   - **无 QRS 波形**：指电极物理接触良好、输入回路阻抗闭合，但信号源未输出有效心脏电激动（例如在 RR15 改线后，RA 与 LL 间为纯胸腔呼吸阻抗变化，无心脏去极化电压）。此时 Node-B 算法必须将 HR 正确判定为 `INVALID / null`，严禁通过修改硬件假接地来掩盖算法判定。
3. **隔离供电与非人体环境**：SKX-2000D+ 模拟器全过程采用内置纯电池供电，USB 充电线必须物理拔除；所有采集严禁接触人体，确保医疗电气安全。

---

## 2. 三模式物理接线与端子映射总表

| 模式 | 信号源设备与设定 | 导线颜色与实物端子映射 | ADS1292R 芯片引脚与模块网络 | 信号特征与算法预期要求 |
|---|---|---|---|---|
| **ECG60** | **SKX-2000D+ 心电模拟器**<br>- 电池供电，USB 断开<br>- 正常窦性心律 60 bpm<br>- 信号幅度 1.0 mV | 1. **红导线 (R)** → 模拟器 **RA** 端子<br>2. **黄导线 (L)** → 模拟器 **LA** 端子<br>3. **绿导线 (F)** → 模拟器 **RL/N** 端子<br>4. **黑导线 (LL)** → **空置 (EMPTY)**<br>5. **白导线 (V1)** → **空置 (EMPTY)** | - RA → 模块 RA (IN2N / ERA 网络，56kΩ 衰减滤波)<br>- LA → 模块 LA (IN2P / ELA 网络，56kΩ 衰减滤波)<br>- RL → 模块 RL (RLDOUT 经反馈回路与 100kΩ 驱动) | - CH2 (ECG) 250 SPS，74250 点<br>- HR 有效且稳定在 58–62 bpm<br>- RR 保持真实 `INVALID / null`<br>- TEMP 独立观察 |
| **TEMP_OBJECT** | **GY-641V3 红外物表测温模块**<br>- 模块 3.3V / GND 由 B 板 J5 提供<br>- 非人体物理表面测温<br>- 禁止写寄存器与发送指令 | 1. **PC11** → 模块 **TD** (UART4 RX @ 9600)<br>2. **PC10** → 模块 **RC** (仅浮空输入，不接驱动)<br>3. **3V3 / GND** → 模块供电脚<br>4. 心电导联 → **断开或空置** | - PC11 → STM32F407 UART4_RX<br>- PC10 → 保持 GPIO_Mode_IN<br>- 模块按 10Hz 广播 12 字节二进制帧 | - TEMP 有效且在 0–100℃ 物表范围<br>- 源龄严格保持 `[-10, 2500] ms`<br>- ECG/RR 不伪造有效 |
| **RR15** | **SKX-2000D+ 心电模拟器**<br>- 电池供电，USB 充电线物理断开<br>- **主菜单呼吸率【RR】= 15 bpm（严禁设为 30 bpm！）**<br>- 呼吸阻抗幅度菜单 1.5R<br>- 阻抗基准心率 / 呼吸波形周期菜单 30 bpm<br>- 窒息时间菜单 0 秒 | 1. **红导线 (R)** → 模拟器 **RA** 端子<br>2. **黄导线 (L)** → 模拟器 **LL/F** 端子 *(唯一批准冷态改线)*<br>3. **绿导线 (F)** → 模拟器 **RL/N** 端子<br>4. 模拟器 **LA** 端子 → **空置 (EMPTY)**<br>5. **白导线 (V1)** → **空置 (EMPTY)** | - RA → 模块 RA (IN1N / RESP 通道调制网络)<br>- LA 插头接 LL/F → 模块 LA (IN1P / RESP 通道解调网络)<br>- RL → 模块 RL (RLD 动态偏置反馈) | - CH1 (RESP) 50 SPS，14850 点<br>- RR 有效且稳定在 14–16 rpm<br>- **HR 必须保持 INVALID / null**<br>- ECG 不宣称有效 |

> [!IMPORTANT]
> **SKX-2000D+ 呼吸工况防错红线**：
> - 模拟器主界面中【呼吸率 RR】必须明确设为 **15** bpm，绝不能因为看到“周期 30”就误将 RR 改为 30。
> - “周期 30 bpm”仅为模拟器底层阻抗正弦调制载波的基准周期参数。若主呼吸率设为 30 bpm，Node-B 算法解调出的呼吸频率将为 30 rpm，直接超出 `[14, 16]` 判据而判定为不合格。

---

## 3. ADS1292R 模块模拟通路与原理图细节

根据凌智电子《ADS1292模块电路原理图》（版本 V2.0）核验：
1. **差分输入通道分配**：
   - **CH1 (引脚 7 IN1P, 引脚 8 IN1N)**：专用于呼吸阻抗测量（RESP）。内部集成 32kHz 调制信号发生器与解调乘法器。
   - **CH2 (引脚 5 IN2P, 引脚 6 IN2N)**：专用于心电信号放大（ECG）。输入级并联 10MΩ 偏置电阻及低通滤波。
2. **右腿驱动网络 (RLD)**：
   - 引脚 3 `RLDIN` 采集共模信号，经片内放大反相后由引脚 4 `RLDOUT` 输出。
   - 外部串联 100kΩ 阻抗及补偿电容送到模块 `RL` 接口。
   - **重要禁令**：RLD 属于闭环反相驱动源，绝不可将模块 RL 直接接地（GND），否则会导致内部运放饱和，破坏整个差分放大器的共模抑制比。
3. **时钟选择 (J3)**：
   - 模块原理图标注 J3 跳线默认悬空（使用芯片内部振荡器）；严禁短接 J3，短接会将 CLKSEL 拉低导致芯片等待外部时钟而死机。

---

## 4. 现场执行防错核查清单（Checklist）

在未来获得 PI 签署 Gate P 现场授权后，执行任何接线前必须核对：
- [ ] SKX 模拟器 USB 充电线已物理移除，屏幕仅显示电池供电图标；
- [ ] B 板 PC10 已配置为输入，无高电平或推挽输出驱动；
- [ ] ECG60 切换为 RR15 时，必须在**完全断电**状态下操作，严禁带电热插拔模拟器导联插头；
- [ ] 导线移动仅限“黄 L 线从 LA 移动至 LL/F”，其他导线不得触碰；
- [ ] 接线完成后由操作人员拍照留存，与本图纸核对无误后方可申请下一步预检。
