Serendipity-min/medical-multi-parameter-monitor/node-b/docs/PI-REVIEW/R6-20261109.md

# PI 审查 R6：R5 实板结果的裁定、传输瓶颈结论与下一步

**日期** 2026-11-09　**审查人** Claude（PI）　**执行人** Windows 上的 Codex
**被审对象** `codex/field01-preflight@18a1896`（WP-M `d95a714`、R5 回执 `18a1896`）
**承接** [R5](R5-20261109.md)。本文**不授权任何实板动作**；下面的任务都是离线（Host/ARM 构建）。

## 1. 裁定

| 项 | 裁定 |
|---|---|
| 负责人替代 PI 放行 WP-M | **接受并记录**。PI 事后补审通过：主机脚本在无横幅模式下仍保持单发、`PRE_SENT` 先于写串口、收到 `B5 STOPPED` 即终止、`PRE BEGIN` 的 `boot_ms<45000` 才算新启动，发送后再出横幅按意外重启处理；`PRE_ALLOWED` 由现场协调员放置，比我的规格更保守。PI 在 VPS 复跑 `test_field01*.py`：**61 项通过、8 子例通过**。 |
| WP-N 接线基线 | **PASS**。BP-1：开关 OFF 时灯灭、COM15 **不存在**；BP-2：ON 后灯亮、COM15 出现；BP-3：J-Link 只读连接成功，参考电压 3300 mV，Halt/Reset/Go/下载均为 0；BP-4：OFF 后灯立即灭。J-Link 实际只接 SWDIO/SWCLK/GND（H2 确认）。按判定表，**CH340 受开关控制，横幅会在串口打开前发完**，所以无横幅模式是对的。 |
| S2（230400） | **PASS（实板，AT 级）**：`NEGOTIATE=OK actual=230547`，`n=50 fail=0 uart_err=0`，`rx_high=49`，12.18 ms/次，`RESTORE=OK`。 |
| S3（500000） | **PASS（实板，AT 级）**：`NEGOTIATE=OK actual=500000`，`n=50 fail=0 uart_err=0`，`rx_high=143`，11.90 ms/次，`RESTORE=OK`。 |
| 回退与原应用启动 | **PASS**。回退后整片与会话 A 备份逐字节一致，sector3/Options 保留；Reset/Go 后 156 ms 捕获 `UNI DISARMED V1 C_BC_ABC NO_FLASH_WRITE`。原应用已验证可启动。 |
| 额度 | 上电 4/4、回退 1/1、纯复位 1/3，START/KEY/联云/sector3 写入均为 0。**额度已用尽，下一次实板动作需要重新授权。** |
| 小异常 | 会话 B 最终 OFF 后 Windows 仍枚举 COM15，而 BP-4 是立即消失。PI 判断是 Windows 设备移除事件延迟，**不阻塞**；Codex 以后用“电源灯灭”做断电口径，不用 COM15 是否消失。 |

PRE 路径已经完成它的使命：**U-02、N-04、V-03 全部由实板关闭**。后面不再需要 `FIELD01 PRE` 的新镜像，除非另有原因。

## 2. 数据解读（这是本轮最重要的发现）

### 2.1 实测

| 速率 | 每次 `AT+GMR` | 较 115200 | RX 环高水位 | 备注 |
|---:|---:|---:|---:|---|
| 115200 | 18.44 ms（S1′） | — | 2 | |
| 230400 | 12.18 ms | **−34%** | 49 | |
| 500000 | 11.90 ms | 仅比 230400 再少 0.28 ms | 143 | 线上时间又少了约 4 ms，总耗时几乎没变 |

### 2.2 PI 的推断（**需要验证，见 WP-Q**）

一次 `AT+GMR` 约 190 B（命令 8 B + 回复约 181 B，**PI 按回复结构估算，Codex 请给出实际字节数**）：

| 速率 | 线上时间（估） | 实测 | 实测 − 线上 |
|---:|---:|---:|---:|
| 115200 | 16.4 ms | 18.44 ms | 2.0 ms |
| 230400 | 8.2 ms | 12.18 ms | 4.0 ms |
| 500000 | 3.8 ms | 11.90 ms | 8.1 ms |

线上时间越短，“线上之外”的时间越长，总耗时在 **约 12 ms 处触底**。这符合“**CPU 消费受限**”：C 的内核只有 8 MHz，接收端每字节的软件处理约 60 µs（约 500 个周期），比 230400 的线上字节时间（43 µs）还慢。旁证：RX 环的高水位随速率从 2 → 49 → 143，说明主循环消费不过来。

读源码能解释这个量级（`gateway/mqtt/src/platform.c`）：
- `await_reply()` 每次循环都调用 `platform_poll()`（进入业务回调），再取一个字节；
- `reply_byte()` 对**每个**长度 ≥13 的行字节都做一次 13 字节的 `memcmp(…,"+CIPRECVDATA:",13)`，其余字节还要写 `reply[len]=0`；
- 发送侧 `send_bytes()` 在**每个字节之前**也调用 `platform_poll()`，等待 TXE 时再反复调用。
- 在 PRE 镜像里 `service()` 被 `runtime_ready=false` 提前短路，所以 **PRE 看不到真实业务下的开销**：真实运行时每次 `platform_poll()` 都会进 CAN/采集/入队的完整回调，开销只会更大。

**这一推断对架构决策的含义**：提高波特率只在 CPU 不是瓶颈时才线性有效。230400 已经把 AT 小事务压到接近 CPU 下限；500000 几乎没有额外收益，还增加 CAN 溢出风险。

### 2.3 对容量缺口（需要 +29.3%）的更新估算

PI 之前的估算（230400 ≈ 10.8 批/s，500000 ≈ 13）建立在“二进制写入的耗时完全由线速决定”这个假设上，**现在不再成立**。保守重估（仍是估算，不得入结论表）：

| 做法 | 估算范围 | 依据 |
|---|---|---|
| 仅 230400，且发送字节循环不是 CPU 瓶颈 | 约 9.7–10.8 批/s | 下限用“只缩短线上时间”的算术，上限是 P3 夹具直接缩放 |
| 仅 230400，发送字节循环受 CPU 限制 | 接近 8.1 批/s，几乎无改善 | 与接收侧同一机制 |
| 230400 + 降低每字节 CPU 开销 + 去掉空查询 | 可能越过 10.45 批/s | 取决于 WP-Q 的实测 |

结论：**不能再单靠提速。必须先量出 CPU 花在哪。**

## 3. 架构问题的回答（你最初问的“优化现有架构还是引入 FreeRTOS”）

**结论：保持裸机，不引入 FreeRTOS；下一步是“降低每字节 CPU 开销”，必要时再评估把内核时钟提到 168 MHz。**

理由（均有证据）：
1. 瓶颈是 8 MHz 内核上的**逐字节软件开销**，而不是调度间隙（AT 未占用时间仅 1.5 s/110 s）。RTOS 的任务切换不减少逐字节开销，反而加开销。
2. sector4 余量只有 3,588 B（镜像 2），放不下内核和多任务栈。
3. 真正有效的是：
   - **A. 少做事**：`reply_byte` 里把 `+CIPRECVDATA:` 的判定改为只在 n==13 时判一次并记录状态，其余字节直通；接收时不要每个字节都调业务回调。
   - **B. 不占用 CPU 的发送**：发送缓冲用 DMA（USART3_TX）或中断驱动，不再“每字节一次轮询”。**注意 DMA 流资源可能与麦克风 I2S 的 DMA 冲突，需先出分配表。**
   - **C. 把内核提到 168 MHz**：一次性解决所有逐字节 CPU 瓶颈（约 21 倍余量），也让 500000 以上变得安全。代码里已经有 42 MHz、6×14 TQ 的 CAN 分支（U-14），但这是时钟/CAN/串口/音频一起改，**需要单独评估并完整重做 CAN 验证**，不能仓促。
4. FreeRTOS 在这三条路径里都不是必要条件。

## 4. 下一轮任务（全部离线，不上板）

### WP-P：生产路径的 230400 协商与参数化
1. 把 `ESP_UART_BAUD` 从编译期常量改为**运行时变量**（默认 115200），`platform_send_reserve`、`esp_mqtt_send` 的预算、`init_uart` 与 `USART3->BRR` 全部引用它；默认构建行为必须与现状一致。
2. 在 `gateway_network_open()` 里，**入网之前**加入协商：沿用 PRE 已经实板验证过的流程（`AT+UART_CUR?` → 门控 flow∈{0,1} → `AT+UART_CUR=230400,8,1,0,<原 flow>` → 20 ms 保护间隔切 BRR → `AT` 重同步 → 回读确认）。**只允许 230400**（500000 不进生产，原因见 §2.2、R3 §8）。
3. 失败有界回退：回 115200；仍失败则 `GW FAIL UART_NEGOTIATE`，不循环；不写持久配置。
4. Host 夹具：mock ESP 支持切速、保护间隔、旧速率乱码、缺失回复；P3 的同一输入在 115200 / 230400 下重跑；**新增一个参数“每字节 CPU 开销 µs”做扫描（0、30、60、120）**，输出批/s 随该参数的曲线，用来判断“多低的 CPU 开销才够”。
5. 预算：Windows 报告 sector4 增量与余量；当前余 3,588 B，生产协商应尽量复用 PRE 代码；PRE 专用的诊断代码是否保留由 Codex 提出。

### WP-Q：逐字节 CPU 开销的插桩（决定后续方向）
1. 启用 Cortex-M4 的 DWT 周期计数器（`CYCCNT`），在生产镜像里累计这几项并写入现有 `B5 DIAG` 行（只加计数，不改行为）：
   - `service()` 总周期与调用次数；
   - `send_bytes()` 的总周期、字节数、其中等待 TXE 的周期；
   - `await_reply()`/`rx_step()` 每字节的总周期与字节数；
   - USART3 中断的总周期与次数。
2. Host 编译用空实现；ARM 构建报告 Flash/SRAM 增量（预计 <600 B）。
3. **这是未来实板测量的前置，不是现在上板。** 在 Codex 提交并我放行后，由我起草下一轮实板批次卡，由负责人授权。

### WP-R：设计评估（只出文档）
1. **逐字节开销的最小软件改动清单**：对 `reply_byte`、`await_reply`、`send_bytes`、`rx_step` 逐处列出“每字节做了什么”，给出可节省的周期估算与风险（含 §3 的 A）。
2. **USART3 TX DMA 方案**：DMA 流/通道分配表（对照 INMP441 的 I2S DMA 与其它外设，写明冲突与解法）；对 `send_bytes` 超时、停止、半帧的处理。
3. **168 MHz 可行性研究**：时钟树（HSE 8 MHz → PLL 168 MHz）、APB1/APB2 分频、USART1/3 的 BRR、CAN 500 kbit/s 的位时序（U-14 提到的 42 MHz、6×14 TQ 分支）、SysTick、I2S/PLLI2S、定时器；逐项写出会改变什么、需要重做的验证。**只做研究，不实施。**

### 回传
提交并 push 到 Codex 分支：WP-P 的代码与 Host 测试及 P3 重跑结果（含 CPU 开销扫描曲线）、Windows 构建与 VPS（Arm GNU 14.2）位级复现回执、WP-Q 的代码与构建回执、WP-R 的文档。**Host/Windows 构建 PASS 与实板结果分栏；估算与实测分栏。**

## 5. 需要负责人决定

1. **生产档位**：PI 建议生产只用 **230400**，500000 只作测量结果保留。是否同意？
2. 是否批准 WP-P/Q/R（全部离线）开工？
3. 168 MHz 研究是否值得投入？PI 的看法：**值得研究，因为它能一次性解掉整类 CPU 瓶颈**，但因为牵动 CAN 时序，不建议在容量问题被量清之前直接动。
4. 之后的实板测量（含五板上电、新镜像）由 PI 起草、负责人再授权；本轮不涉及。

## 6. 流程备注
负责人两次替代 PI 放行（镜像 2、WP-M）。PI 事后复核均通过，因此没有后果；**以后若负责人替代放行，Codex 必须把这句话原文写进台账，并在回执里标注“PI 事后复核：待做/已通过”**，以便追溯。
