Serendipity-min/medical-multi-parameter-monitor/doc/README.md

# 项目文档索引

按 [v0.7 最终总合同](<多参数监护仪_总开发合同与系统方案_v0.7 .md>) 的 P / A / B 分工归档。
P 当前执行 [第一阶段 v0.2 合同](P/01_第一阶段_MQTT云端/合同/P_第一阶段_GatewayC云端Web执行方案合同_v0.2.md)。
第一阶段已完成合成数据 MQTT/TLS 功能闭环，当前补充首轮复核整改；第二阶段仅归档，不执行。P 文档按执行阶段、维护与历史分区，详见 P 索引。

| 位置 | 文档范围 |
|---|---|
| `doc/` 根目录 | 项目总合同、总体方案、全系统审查/纠偏报告、综合硬件参考与草稿 |
| [P/](P/README.md) | P 专项合同、协议与网关、云端/网页、RR 算法、集成与阶段交付文档 |
| [A/](A/README.md) | 血氧、血压、Node-A 及对应本地屏的开发与测试文档 |
| [B/](B/README.md) | ECG/HR、RESP_RAW、体温、Node-B 及对应本地屏的开发与测试文档 |
| `03_模块硬件与原理图技术规范/` | A/B 共用的串口屏技术参考；具体模块手册已归入 A/B |

新增个人任务计划、执行报告、测试记录和交付说明直接放入对应负责人目录。
跨团队总体方案与评审材料放在根目录；共用手册保持单份，由个人目录引用。
历史文档中如有旧分工或旧协议，保留原文作为历史记录，以当前确认的总方案和专项合同为执行依据。
