Serendipity-min/medical-multi-parameter-monitor/node-b/README.md

> **历史阶段文档。** 最终五板基线、启用功能与当前构建请先读[结项技术架构](../docs/closeout/02-ARCHITECTURE-AND-STACK.md)。本文保留原阶段记录；其中旧分支名、Paho 固件、主频、Flash 分区和功能状态不作为最终版本依据。

# Node-B：ECG / 呼吸采集与算法复盘

更新：2026-10-16，Asia/Shanghai。分支 `B`，基于 `B2@2ca744d2f06d49711863968aeef15b64891edd18`。

**目前已在限定窗口验证采集连续性；外部 ECG 心率与呼吸率的持续有效性、准确度仍未验收。** 本目录将源码、历史证据、当前判断和后续试验分开，作为下一轮定位的共同入口。

## 阅读顺序

1. [综合复盘与当前结论](docs/01_综合复盘.md)
2. [模块资料、原理图与接线版本](docs/02_模块资料与接线.md)
3. [新旧算法逐项对比](docs/03_新旧算法对比.md)
4. [已做排查、失败与未做方向](docs/04_证据矩阵与后续路线.md)
5. [代码、构建和多样本采集工具说明](docs/05_代码与复现.md)
6. [第二块 F407 工程源进度](docs/06_源板S进度.md)
7. [本次归档与验证回执](HANDOFF_20261016.md)

## 目录

| 位置 | 含义 |
|---|---|
| `firmware/biov2/实验固件/` | 当前最新 BIO_V2 源码及原 Keil 工程；未改阈值、协议或链接配置 |
| `reference/legacy-postfix/` | 已经历旧算法修复的项目源码快照；不是最初未修复版本 |
| `reference/biov2-before-isolation/` | 通道独立削顶修复前的精确算法源，用于负向对照 |
| `reference/vendor-f407-local-port/` | 厂家例程的本地 F407 移植/诊断副本，仅归档相关文件；不是完整、原封不动的厂家发行工程 |
| `reference/biov2-local-tools/` | 现场特定构建/安装/采集脚本的脱敏文本，供审查，不作为可执行安装入口 |
| `acquisition/` | 标准文件协议、稳定槽导出、采集/分析工具及普通测试；旧 SWD profile 与 BIO_V2 不通用 |
| `hardware/` | 本地提供的 ADS1292R 数据手册、模块原理图和 F407 板级原理图 |
| `history/` | 历轮报告的脱敏副本，保留历史 FAIL 和当轮限制；原件未覆盖 |
| `evidence/` | 当前清单、来源 SHA、普通验证与脱敏证据索引 |
| 仓库 `ecg-source/` | B2 原有源板 G1 工程，以及本次归档的 S 板 USB 入口/观测工具 |

本次只离线整理和普通验证，没有连接、复位或烧录开发板。未公开真实采集原码、UID、Flash、固件 BIN/ELF、私有配置或现场照片。文件清单记录原件与公开副本的不同 SHA，不能用脱敏副本 SHA 冒充原件身份。

## 后续成功标准

先以已知幅值和节律的**非人体工程源**证明 CH2 外部输入，再逐项引入 RLD 和呼吸调制，最后用已知变化阻抗检验 CH1。每轮固定源码、固件、输入设定、接线和取数工具，原件只增不改；“数值处于范围内”不构成准确度证明。
