Serendipity-min/medical-multi-parameter-monitor/doc/A/README.md

# A：血氧、血压与 Node-A

按现有 v0.6 总方案，A 负责血氧/PPG/SpO2/PR、NIBP、Node-A、对应两块本地屏及 CAN 接口。
本目录收纳相关方案、驱动说明、开发记录与测试验收文档。

- [血氧传感器对比与协议技术手册](02_SpO2_AFE4490与HKS12C血氧传感器对比与协议技术手册.md)
- [血压模块原理图与通信协议技术手册](03_NIBP_HKB08系列血压模块原理图与通信协议技术手册.md)
- [A/B 共用串口屏手册](../03_模块硬件与原理图技术规范/05_HMI_大彩串口屏指令集与波形控件技术手册.md)

现有手册按原内容迁移，不因目录归属而改写其中的历史方案。返回[项目文档索引](../README.md)。
