Serendipity-min/medical-multi-parameter-monitor/doc/B/README.md

# B：心电、体温与 Node-B

按现有 v0.6 总方案，B 负责 ECG/HR、RESP_RAW 采集、体温、Node-B、对应两块本地屏及 CAN 接口。
RR 算法由 P 负责，B 配合集成；本目录收纳 B 的开发与测试资料。

- [ADS1292R 心电与呼吸阻抗技术手册](01_ECG_RESP_ADS1292R原理图与驱动技术手册.md)
- [红外测温模块协议与驱动技术手册](04_TEMP_GY641V3红外测温模块协议与驱动技术手册.md)
- [A/B 共用串口屏手册](../03_模块硬件与原理图技术规范/05_HMI_大彩串口屏指令集与波形控件技术手册.md)

现有手册按原内容迁移，不因目录归属而改写其中的历史方案。返回[项目文档索引](../README.md)。

## 2026-10-16 Node-B专项复盘（B分支）

[进入ECG/呼吸采集、算法与证据入口](../../node-b/README.md)：当前BIO_V2完整源码、新旧算法及厂家本地移植版对比、模块/板级图纸、普通测试、采集协议、历史失败和后续路线。限定窗口采集连续性已验证，外部ECG与呼吸率准确度仍待完成；最新通道独立候选的B板实测身份未核验。历史手册中的引脚定义不可直接套用当前PG15方案。
