Serendipity-min/medical-multi-parameter-monitor/doc/P/01_第一阶段_MQTT云端/README.md

# 第一阶段：Gateway-C → MQTT/TLS → 云端 → Web

- [执行合同 v0.2](合同/P_第一阶段_GatewayC云端Web执行方案合同_v0.2.md)
- [Gateway 当前实现与接管 v1.1](合同/P_云网关实现原理_代码设计与维护接管手册_v1.1.md)
- [MQTT 接口语义](设计与接口/P_MQTT接口语义_v0.7.md)
- [大屏设计](设计与接口/P_四模块监护大屏_UI设计说明.md)
- [真机与云端执行报告](验收/P_MQTT真机云端执行报告_2026-09-20.md)
- [收到的首轮复核报告（原文）](验收/PR2_首轮合同复核报告_2026-09-20.md)
- [复核整改记录](验收/PR2_整改记录_2026-09-20.md)
- [第二轮复核报告（原文）](验收/PR2_第二轮复核报告_7316394_2026-09-20.md)

硬件资料核对位于硬件核对目录。历史 WSS 合同在 99_历史，不与本合同并行执行。
第二轮目录树和断连日志级别修复已完成；第二阶段已在 CANopen 测试节点/Router 范围准出，见 [阶段二结项说明](../02_第二阶段_CANopen可靠性/验收/P_第二阶段_CANopen汇聚与Gateway可靠性结项说明_v0.2.md)。24h 及真实传感器验收仍未完成。
