Serendipity-min/medical-multi-parameter-monitor/doc/P/02_第二阶段_CANopen可靠性/README.md

# 第二阶段：CANopen 汇聚与 Gateway 可靠性

基线：[执行合同 v0.1](合同/P_第二阶段_CANopen汇聚与Gateway可靠性执行合同_v0.1.md)。用户在本轮后续指令中明确授权：完成第二轮修复后继续执行阶段二，并统一提交/push。此前“只归档”是旧状态，合同正文保持原样。

当前 P4 的阶段结论是 **CANopen 测试节点/Router 范围准出**；[结项说明 v0.2](验收/P_第二阶段_CANopen汇聚与Gateway可靠性结项说明_v0.2.md) 单列已完成和真实硬件未完成范围。上段是历史授权经过，不作为现行开发指令。

| 材料 | 用途 |
|---|---|
| [统一数据字典](设计/MPM_统一数据字典_v0.1.md) | 单位、来源、质量、CAN/MQTT映射 |
| [CANopen对象字典](设计/CANopen_对象字典_v0.1.md) | 固定核心栈版本、标准/私有OD |
| [PDO映射](设计/CANopen_PDO映射_v0.1.md) | COB-ID、字节布局、周期和带宽预算 |
| [离线缓存与恢复](设计/Gateway_离线缓存设计_v0.1.md) | RAM容量、实时/REPLAY、MQTT保证边界、掉电设计 |
| [A/B联调接口](接口/A_B_CANopen联调接口合同_v0.1.md) | 交付责任、接线资料、联调顺序、RR输入要求 |
| [阶段二测试报告](验收/P_第二阶段测试报告.md) | 已完成证据、最终准出状态及未覆盖边界 |
| [第三轮复核报告](验收/PR2_第三轮复核报告_cfb30d0_2026-09-20.md) | cfb30d0 的冻结接口与验收边界 |
| [第三轮代码规整记录](验收/PR2_第三轮代码规整记录_2026-09-20.md) | 中文注释、排版、行为一致性与回归检查 |

当前实物验证采用一块F407中的两个CANopenNode测试生产者与Gateway实例，经CAN1静默loopback和ESP TLS上云，来源始终为合成测试。真实A/B、真实RR、Flash持久化与24h稳定性不在本次完成声明内。最终整体验收须继续完成这些工作。
