Serendipity-min/medical-multi-parameter-monitor/doc/P/99_历史/README.md

# 历史资料：不作为当前执行依据

旧合同已被第一阶段 v0.2 与总合同 v0.7 替代，从活动目录移出。
保留旧合同、WSS 验收与早期部署资料用于追查历史发布；不延续其 MMP/WSS 设备接入或单主控选型结论。
当前执行与阶段状态统一查阅 [P 总索引](../README.md)。
