Serendipity-min/medical-multi-parameter-monitor/node-b/docs/B4-HARDWARE-ADMISSION-REVIEW.md

# MPM-B4-001 B+C联动准入审查｜最终软件与现场卡准备 B4-0.3

> 最终B4-G4-003：C23952B已安装、实际恢复H3并重装；新180秒名义CAN窗完整59047包零CRC/缺号/drop/溢出、585次模型校验通过，B采样通过。只关闭本窗名义传输门；ROM根因、同步HR/RR、CAN故障注入恢复及正式部署仍未关闭。当前状态以[唯一交接](B-PRECAN-CLOSEOUT-FINAL-HANDOFF.md)最新节为准，下面较早状态均为历史。

> 10/26最终：B↔C CAN2已出现真实PDO及NMT ACK，但记录缺口/丢包/STOP缺失，完整验收不通过。新23952B IRQ/隔离修正版仅软件冻结，尚未安装；须重新批准新候选安装。当前C仍23744B，B150秒ADC通过，ROM与同步HR/RR仍未关闭。以[唯一交接](B-PRECAN-CLOSEOUT-FINAL-HANDOFF.md)最新节为准。

> 2026-10-26最新：C23744B安装→原H3实际恢复→重新安装均整片核验/启动PASS，options及sector3/7/11不变。首次串口因主机零向量别名误判退出且START=0，已离线修复；新独立窗口C人工复位后44秒遇Windows串口句柄错误，START仍0；B调试读取未开始，已停止不重试。尚无CAN实板PASS，ROM根因仍UNRESOLVED。唯一当前结果见[B4-G4-002](../evidence/B4-G4-002/stage-results.json)与[阶段交接](B-PRECAN-CLOSEOUT-FINAL-HANDOFF.md)；下文10/23段落按历史时点保留。

> 最新G4更新：负责人已追加安装/恢复与隔离台架授权，B39948B已安装、恢复原件并重新安装，完整核验均PASS。C安装前观察ROM，复核仍ROM，后续只读取证已保存当前完整Flash/options与原件一致；C异常原件保留，后经单次正常复位/Go已恢复原H3 Flash运行，尚未安装新候选。因此CAN窗口及故障注入继续STOP。下文“全未操作/旧21700B/未接线”保留为历史时点，不能代表当前状态。

| 当前门禁 | 状态 |
|---|---|
| 接线/电气报告 | 负责人确认B CAN1↔C CAN2；P6/P4两组正确，独立GND，60.8Ω，A段断开、ESP隔离。B J5、C USB_UART，不互并电源 |
| B安装/恢复 | 39948B/gain4/SHA676eb7…；sector0/1/2三步均完整1MiB/options及尾部核验，恢复原件d2ea7c…；不是CAN验收 |
| C备份/候选 | 先前双读及本轮保留异常态单次整片核对均匹配1c7ea8…；options相同。新候选23744B/SHA73d113…，sector0/1恢复包已备，尚未写入 |
| C启动 | ROM首次及复核有真实PCSR；其后HALT时真实PC=0x1FFF36C0，VTOR=0x1FFF0000。BOOT1静态低、跳帽接地不等于复位锁存；USB自动下载路径待核实，根因UNRESOLVED |
| 连续取证 | 230400 UART1固定CRC帧、一次START及180秒硬停候选Host/ARM通过；B150秒只读配套已备，C未部署，因此无真实联动原始CAN窗 |
| 同步有效性/故障恢复 | 仍未通过；不把SKX先关机时CLIPPED、软件回放或安装恢复PASS冒充本项 |

停止点：C实际BOOT0已测0V，单次正常复位/Go原H3启动通过，但ROM触发仍未确定。不追加复位或重刷；需PI裁定残余风险及下一次候选安装/恢复与隔离CAN窗口。唯一结果见[阶段交接](B-PRECAN-CLOSEOUT-FINAL-HANDOFF.md)与[B4-G4-001回执](../evidence/B4-G4-001/stage-results.json)。

2026-10-23，独立分支 `codex/node-b4-dualbus-software-20261023`。本轮追加资料核对、C隔离台架及B4离线恢复包工具，硬件读取/接线/测量/烧录/复位/采集均为0；不产生可执行现场卡。**CAN实板准入仍BLOCKED；disabled=true。** ROM按负责人决定保留待复现，不要求本轮继续追查根因，也不把一次正常启动写成根因已修复。

## 已具备，不重复开发或反复索要

- 当前B为25488B修正版，`9988d37`源码，BIN SHA256 `b8e74577dae7a5a1f6caa27687193f5128f89bd70781f06a1d80b0c74d409b44`；屏重启不复位MCU已验收，一次JTAG断开的独立冷启动已通过。该结论仅属于当前镜像，不覆盖尚未烧录的B4候选。
- ECG60/90/120各两轮及RR12/18/24各两轮的名义速率工程结论保持，原始失败和数据不变；BIO_V2阈值不变。
- 两段独立500kbps：A CAN1↔C CAN1，B CAN1↔C CAN2；每段两端各120Ω，业务身份A1/B2/C3。首次B+C测试时A段物理断开，不把两段CAN_H/L并联。
- B/C Host、ARM、双总线模拟器、Gateway模型、2048B容量和队列压力已有离线证据，不重复作为实物证明。
- 当前B修正版BIN、完整1MiB Flash及options已具备受限EFS备份，本轮重新本地核对SHA与加密属性；旧25284B永久只作历史原件。

## 缺口一：同一窗口的ECG/HR与RESP/RR有效性

**当前未通过；不是算法阈值待放宽。** 既有RESP E3六窗HR仅10/681次稳态保存观察有效，多为104/101/133等异常名义速率；CH2的49–51Hz能量占比81.4–85.8%，主要NO_CYCLES/UNSTABLE/EXPIRED。当前冷启动34–37秒的快照HR/RR均无有效输出，是启动状态，不能替代稳态验收。RR单独通过与其他源模式ECG通过不能合并成同步通过。

仍缺以下三项：

1. **同模式源能力与实际参数证据。** 本轮已查到本机V2.2手册第12页明确普通心电模式同步产生20bpm呼吸，呼吸幅度在呼吸页面设定；第20页导联II=RA–LL。同步源能力已有文档支持，仍缺本组合实测。不能仅见ECG60菜单就断言源端存在可用CH2，或把波形周期20直接当已验证RR20。保留红R→RA、黄L→LL、绿F→RL，LA/胸导空置；不回退旧RA–LA接法，不短LL/RL。独立补证卡已按普通ECG60/2mV＋同步RESP20、同RA–LL路径冻结，当前不切源。
2. **当前25488B的共同稳态窗口。** 候选评价草案：45秒预热＋90秒共同评价＋2秒尾段，HR60±2 BPM、RR20±1次/分；只有源能力/实际设定支持后才能冻结这两个目标。拟要求稳态每次完整保存的共同诊断观察均HR/RR同时有效、且值在范围内，序号缺口/ADC错误/削顶为0；记录全部无效原因及实际观察数。此为采前草案，不是已批准的窗口；不能采后改目标、删除失败点或把保存观察率冒充逐样本连续有效率。原码CH1/CH2、滤波量、候选峰、有效值及原因码必须同一设备时间轴，不能只看屏幕有波形。
3. **B4候选后的回归。** 下载将来获准后，还需证明新增CAN任务未降低250SPS采集完整性和共同稳态有效性；当前旧镜像通过不自动覆盖B4。传输保真可用INVALID状态负例评价，不能因此签发同步生理通道PASS。若源被证明不支持同模式双输出，另记SOURCE_SIMULTANEOUS_CAPABILITY_BLOCKED并选择工程源，不改BIO阈值或伪造通过。

未知阻抗幅度继续null，P2绝对阻抗标定按负责人决定跳过；它不作为本次名义速率/传输审查的新增阻断项。

## 缺口二：实际CAN2链路与电气资源

| 部位 | 软件/参考图已知 | 仍缺的实际依据 |
|---|---|---|
| B CAN1 MCU端 | PA11 RX、PA12 TX、AF9 | B实际版号对应的CAN1收发器、启用/待机状态、CAN/USB复用跳帽、外部CAN_H/L/参考地端子编号。开发板USB不得与该引脚资源争用 |
| C CAN2 MCU端 | PB12 RX、PB13 TX、AF9 | C芯片型号已由负责人确认STM32F407ZGT6；已读本地神舟号V2.0板图。仍缺实际板卡版号/跳帽和已装CAN2收发器的对应确认，不再索要芯片型号 |
| C板内P4 | 仅V2.0参考图：1=CAN2_RX侧、2=PB12；3=CAN2_TX侧、4=PB13，1–2/3–4是逻辑通道跳接（图中RX网络名为CAN2_RX） | 实板P4标识、现有跳帽，是否确实将MCU接入收发器；P4不是差分总线接口，不把PB12/PB13直接接CAN_H/L |
| 外部CAN2 | V2.0参考图U2=TJA1050、供电5V、R1=120Ω；CAN2二针座2=H、1=L | 实际C是否一致，连接器方向/针号/丝印照片或对应板图；B外部CAN1同样需确认H/L及参考地，不能按参考图直接操作 |
| 电源与参考地 | 两板各自供电；传感器主动RLD属于模拟前端 | 两板电源来源、是否浮地/隔离及现有USB/JTAG/屏幕接地路径；拟用信号参考地的具体端子与电位兼容性。参考地不能借用RLD，不能直接并联两板5V/12V |
| 两端终端 | B–C段两端各120Ω，A段独立 | B CAN1与C CAN2现有终端是否装/可选、是否有第三个终端；未来另行授权的断电总线测量应约60Ω，只能在完全断电且核实无反供电后做，不是本轮测量指令 |
| 麦克风/其他外设 | PB12/PB13与默认I²S2 WS/CK冲突；软件编译互斥已验证 | P6资源表和T0审计明确INMP441只预留、无PCM/I²S驱动；现有UART TTS不占PB12/PB13。新PDF为芯片资料，不能证明实物插线；参考板WM8978实际连PC3 SDOUT/PC2 SDIN/PC6 MCLK并共享PB12/13时钟。当前禁用音频，不改语音固件；未来实际外设接入仍需核对 |

软件已划分CAN过滤器bank0–13/CAN1、14–27/CAN2并保持共享CAN1时钟；仍缺两板实际时钟、收发ACK/TEC/REC/BOFF、错误恢复及ADC连续性证据，这些只能在后续授权测试中获得。不能要求现在凭空提供“已通过”的硬件结果。

## 缺口三：两板候选与可执行恢复条件

| 对象 | 已具备 | 尚缺/必须在烧录前解决 |
|---|---|---|
| B当前恢复点 | 25488B BIN；完整Flash SHA `d2ea7cbf7081b20f82a4a6ca6dde4918b9c4d4b194a3c6c358c2d74012993316`；options SHA `52d5979da03bd7be45e385920ec7d5901793bab3f6bc1daa0c1c1997f9e91687`，EFS及SHA复核通过 | 将来现场下载前只读核对仍为同板/同镜像与保护状态；不把历史旧25284B当回退目标 |
| B CAN候选 | 39948B，SHA `676eb7a46ad9cd15c7bf93db51a1931d7711d37c6f2fd636197dc4a85b339b82`，ARM构建通过、未烧录 | 从32KiB扩大到至少覆盖Flash扇区0/1/2（0x08000000–0x0800BFFF，48KiB）。旧last-round工具固定25488B及32KiB，仅适用此前修复，不能直接用于B4。本轮已新增b4_recovery.py：离线核对双文件及保护信息、保留扇区尾部、生成安装/回退包并核验完整镜像。19项合成NOR测试及12项CLI正负例通过；工具没有硬件执行入口，仍需另批读回器及实际保护/布局核对，不声称实板双读/回退已执行 |
| C当前恢复点 | 固定H3源码参考存在，不能等同C当前实板镜像 | C当前应用身份/版本、Flash容量、RDP/WRP、完整Flash及options一致双备份；另存配置、设备身份/网络凭据原件至受限加密目录，不公开、不打印。必须先核实是否支持无破坏读取，遇保护不解锁或整片擦除 |
| C CAN候选 | 完整网络软件BIN 38612B，SHA `b5cd31c91f3800c24b34fefd855d50cfac6deded3bb5a52aeb66175944e53ebb`，未烧录 | 旧network_main启动会尝试联网，保留为软件回归而非台架候选。本轮已另建21700B的B4_GATEWAY_BENCH，SHA `4b42863ac27867c9ba7ced1a464ca52ac069b9e2e095c2982d6cb382d07f1c5b`；无网络/配置读写/麦克风驱动，固定测试纪元本地TIME、B段NMT、180秒停窗及16记录有界RAM已通过Host/ARM。未部署；外部ESP自身隔离仍待实物核对，测试时间不作为真实UTC |
| C配置分区 | 固定H3参考persistent_config.h：记录地址0x0800C000、336B、sector3；网络候选代码小于48KiB | 仅源码布局，不证明实板配置就在这里。需对照实际链接图/配置版本、完整扇区边界和保留区，禁止默认整片擦除；台架候选不得覆盖正式凭据。确认回退C镜像与配置绑定及恢复工具可用 |
| 恢复闭环 | B原件本地可读、校验成功；B/C软件产物有SHA | 冻结唯一候选、工具版本/SHA、实际擦写范围、失败退出/正常续跑策略、恢复命令/核验标准和负责人批准的恢复范围。备份存在不等于恢复演练通过；任何演练/下载仍另需授权 |

恢复档案：`E:/medical-monitor-node-b-precan-private/20261023/b4-software-20261023T093613216574Z`。本轮仅本地复核，无新的设备读取；固件、整片和配置不提交GitHub。B4构建及最新文档提交身份分别记录，不能把本次文档提交SHA当成当时BIN的构建源码身份。

## 只需一次补齐的现有事实

已自行读取P4/P5/P6及语音来源、开发板资料和新增INMP441 PDF，来源SHA/页码/分支提交见[资源审计](../evidence/B4-001/bench-r1/resource-audit.json)。不再询问C芯片型号、已有板图或资料中可查的接口。资料仍不能证明实际跳帽/外接线、C当前Flash身份/配置/保护或独立备份；这些仅列为未来授权现场核验项，本轮不反复提问。

后续顺序：本轮独立台架及离线恢复工具已备，先审核剩余实物核验与实际读回/恢复方案 → 冻结同源双通道评价方案并取得独立现场授权 → 再决定B/C候选下载、各自启动与采集回归 → 最后批准B CAN1↔C CAN2的有限窗口，A段仍断开。ROM待复现保留；若未来出现ROM/HALT/复位/供电异常，立即停止窗口并留存原件，不无限重试或自动重刷。**现在不切源、不测表、不改跳帽、不接CAN、不烧录，不启动Security Gate。**

本轮软件证据：C台架ARM构建通过（48KiB链接边界，21700B）；旧C网络目标重新链接的BIN SHA仍为b5cd31c9…，未替换部署。Host覆盖本地TIME、B段NMT、A段发送关闭、tick回绕、180秒停窗、环满计数；恢复覆盖跨32KiB擦写、配置保留、部分编程故障回退与身份/保护/包损坏拒绝。执行记录见[台架阶段结果](../evidence/B4-001/bench-r1/stage-results.json)。所有原件受限EFS归档；无新的实板PASS，当前B部署与完整Flash恢复点不变。

## B4-0.3 G4准入状态与卡的提交边界

**当前G4可执行=false，不请求整包接线/烧录授权。** 增益换算软件门已关闭；C今天的实板双读备份已通过（见文末追加）；针脚/电源核验、真实恢复准入仍未完成。已准备独立[C只读卡](AUTH-C-B4-03-READONLY-001-R1.md)和[B同窗补证卡](AUTH-B-B4-03-SYNC-001-R1.md)，各需PI单独批准；[引脚/电源检查表](B4-03-PIN-POWER-CHECKLIST.md)记录负责人本轮已报事实，C P4两组空置，不能假称CAN2已接通。USB下载偏好已记录，不构成本轮烧录许可，C只读选择不复位J-Link。

G4以下清单仍是**DISABLED_DRAFT_NOT_AN_AUTHORIZATION**，不是可执行现场卡：

| Gate | 必须冻结的证据/后续验收 | 当前 |
|---|---|---|
| G1单位/软件 | CH2增益4、名义2.42V、µV PDO→mV JSON；正负/边界/量化/序列；B4 Host/ARM及2048B缓冲 | 软件PASS，新B39948B；不宣称电压校准 |
| G2线路/电源 | 真实P4 1–2/3–4、CAN2外部H/L、B CAN1/P6、参考地/供电/终端核验；B CAN1↔C CAN2，A段保持断开 | C P4空置/无麦克风TTS/全CAN断开已报，其余电气待批 |
| G3C当次原件 | 唯一C身份、2×1MiB＋2×options、sector3/7/11、实际保护状态；H3来源身份、整片恢复包、工具/擦写范围及回退审批 | 本次18项替身测试及唯一实板双读通过，H3来源匹配，C离线恢复包sector0/1已生成；实板恢复仍未演练 |
| G4候选安装 | B39948B SHA676eb7…需sector0/1/2；C21700B SHA4b4286…仅sector0/1。新BIN之后原尾部保留，options/sector3/7/11不写；USB或SWD下载另审 | 仅离线安装/回退包工具，真实SDK/USB下载执行入口未审，不烧录 |
| G5隔离运行 | 无正式MQTT/云端写入；C固定测试TIME（非UTC）及180秒硬停；NMT只到Node2，HB Node2 0x702、PDO0x182/282/382/482/682，SDO0x602/582 | 软件模拟PASS，实际CAN ACK/状态未测；NMT响应看HB/PDO，不虚构协议ACK |
| G6传输与采集 | 250SPS原码序号连续、队列/错误；比较B发出的值/时间/质量与C接收重建，保存真实原始CAN及诊断 | 不能以两块屏变化或MOCK回放替代；现单J-Link，连续两板取证路径/采集工具须先冻结。C现16条聚合RAM环不是完整CAN记录，需受审串口/第二读取路径或足够的受控采集方案，未补齐不发可执行卡 |
| G7总线错误/恢复 | 记录B CAN1 ESR0x40006418、C CAN2 ESR0x40006818中的TEC/REC/BOFF，及队列/ACK/溢出；故障注入方式/次数/退出范围另冻结 | 初始须无BOFF及错误增长；故障类型未审批前不拔线/短接或修改供电/复位。恢复不能停止ADC或自动重刷 |
| G8回退 | C恢复当次确认的H3原应用/尾部，B恢复25488B修正版；完整1MiB/options及sector3/7/11前后相同，恢复后的启动证据 | 备份成功不等于已演练恢复；回退写入另需精准授权 |
| G9双通道 | 同窗HR/RR有效率、速率范围、原码/滤波/原因码/周期证据 | 独立补证卡已备，未实测；与CAN传输各自裁定，不能互相PASS |

所有候选仍hardware_eligible=false。CPU_ROM_ROOT_CAUSE_UNRESOLVED保留待复现；一旦ROM/HALT/意外复位立即STOP，不无限重试或用刷机消除现场。G1–G3及对应现场条件未通过，不签可执行G4卡；将来窗口须重新填唯一现场候选SHA、原件SHA、允许的物理/调试动作、采集通道、故障注入与恢复上限。每个剩余缺口如实保留，不自动进入CAN。

## C最新现场补证（2026-10-23）

本次负责人明确授权、J-Link已在C，唯一79次SDK调用/显式reset-halt-go-write=0完成F407/1024KiB/不同于B的UID核验、2×完整Flash及2×options，双份一致，读取时Flash运行、Fault清零、RDP0。H3应用43172B和sector3的336B记录来源匹配，sector3/7/11哈希已单存；所有原件EFS。完整Flash SHA `1c7ea80359892a96a68503f9a0f054d16d860088f3831b0749b4eb7226549390`。G3的身份/双备份子项PASS，恢复准入子项仍PENDING。C21700B候选的真实离线安装/回退包已形成，范围sector0/1，文件重建/载入核验通过；没有执行任何Flash写入或恢复演练。

本次是保持已有USB/ESP/供电状态的仅备份授权，不伪填旧隔离卡条件；工具新增严格的本次授权/现场事实分支，原地址白名单、双读/180秒上限与异常停止条件不变，授权消费一次。C网络隔离、P4/P6/参考地/终端、候选安装/回退执行入口及两板连续采集仍未就绪；G4保持DISABLED。C现在是原H3、B仍原25488B，不能仅接H/L就声称双CAN运行已验证。精确接法见更新的[检查表](B4-03-PIN-POWER-CHECKLIST.md)，本次[实际回执](../evidence/B4-003/C-current-readback/receipt.json)不签CAN传输或HR/RR同步PASS。CPU_ROM_ROOT_CAUSE_UNRESOLVED保留。
