Serendipity-min/medical-multi-parameter-monitor/node-b/docs/RESP-EXPLORATORY-REPORT.md

# MPM-B-RESP-003探索性验证报告

最新正式结果：[RESP E3六窗矩阵](RESP-E3-MATRIX-001-RESULTS-R1.md)已完成12/18/24各两轮，全部E3_CELL_NOMINAL_RATE_MATCH，六格汇总原生exit0，签E3_NOMINAL_RR_ENGINEERING_PASS。六窗各45秒预热＋90秒评价＋2秒尾段，稳态保存诊断共681/681有效、RR分别12/18/24，206025帧完整留证；全部采集/监督/分析0，启动无效和历史失败保留，不改阈值。六卡消耗，reset6/halt6/go12/Flash写0，不再追加连接；当前源保持24/波形周期20/1.5R/窒息0。未知频率与Ω真值仍null，不签阻抗/临床/同步HR验收；CPU机制继续待查。下方未完成状态均为历史快照。

最新E3实板：[18次/分两轮](RESP-E3-18-001-RESULTS-R1.md)均通过，90秒评价保存诊断114/114、113/113有效，实板RR均18，采集/监督/分析0。独立分箱周期3301ms、估计18.176与方法分辨率边界单列；预热无效完整保留。加上12两轮共4/6，24尚未签发，整体E3未完成；18两卡已消耗，不重试，阈值不变、CPU待查。

最新E3实板：[12次/分两轮](RESP-E3-12-001-RESULTS-R1.md)均通过冻结的90秒稳态评价，保存诊断113/113与114/114有效、RR均12，中位周期5001.0/5001.8ms，采集/监督/分析均0；两轮预热无效30/32次完整保留，未进入稳态分母。12两张卡已消耗；当前只完成2/6，整体矩阵未通过，18/24需各自实测。阈值不改、CPU机制继续待查；下方仅准备/当前30为当时快照。

最新E3准备：12/18/24各两轮的[正式名义RR矩阵R1](RESP-RR-ENGINEERING-MATRIX-R1.md)及六张独立卡已备，当前源仍30bpm、所有源模板未确认、执行清单禁用，未连接SDK/复位/采集。每轮45秒预热＋90秒评价＋2秒尾段，启动无效完整留证而不入稳态分母；稳态保存观察须全有效、边缘/间隔覆盖与名义/原码差≤1次/分。16项新检查＋13项相关回归及六格真实禁用CLI负例通过，软件结果不代替实物验收；历史原件/25项旧工具复核不变。E3 NOT_RUN，阈值不改、CPU继续待查。

最新E2：负责人仅将呼吸率20→30，波形周期20/1.5R/窒息0/RA–LL接法不变，完成一个新45秒窗并对照原20基线。CH1中位周期3000→2000ms、比2/3，三方法新窗均30；独立对照exit0，记E2_RATE_TRACKING_SEEN。新窗11344帧完整，worker/监督0；冻结RR评价32/38有效、原生分析3保留，E3及同步ECG/RESP验收未通过或未执行。详见[20→30跟踪结果](RESP-TRACK20-30-001-RESULTS-R1.md)。本卡已消耗，无重复采集、阈值改动或CPU机制调查，旧20基线及失败原件不覆盖。

最新实板结果：获新增许可后按恢复卡正常复位1次并完成45秒，worker/监督0；11339稳定帧无缺口/近轨/ADC错误，CH1峰间隔/谱峰/自相关均20次/分，E1输入层已观察到相干周期。首次保存到有效RR在19.046秒，此后33次保存观察均RR20有效；冻结10–40秒评价27/38有效，分析3保留，不改评价段或阈值。CH2本窗HR无效，不签同步ECG/RESP通过。详见[本次恢复采集结果](RESP-RA-LL20-RECOVERY-001-RESULTS-R1.md)。原卡已消耗，不再采窗；[CPU ROM/Flash问题](B-CPU-ROM-FLASH-DEFERRED-R1.md)按负责人要求保留待查，算法Flash未丢失、根因未解决。

最新实板尝试：负责人确认呼吸20/1.5R/波形周期20/窒息0及红RA/黄LL/绿RL并上电接回J-Link后，执行一次独立零复位卡；26.844秒在窗口前因RESP_DIAG_ABI停止，worker/监督均1。完整Flash/options一致，但VTOR1FFF0000及五次PCSR均在系统ROM；新原码0、未计算RR，halt/go/reset/Flash写均0，无重试。详见[本次停止报告](RESP-RA-LL20-001-RESULTS-R1.md)。已准备[一次正常复位及有条件45秒卡](AUTH-B-RESP-RA-LL20-RECOVERY-001-R1.md)，清单禁用，待新增复位许可；不扩展CPU机制调查，不改阈值。

2026-10-23新证据：负责人提供的V2.2《操作手册》第20页明确呼吸导联II/RA–LL，覆盖此前旧12页资料未定义端子的判断。详见[新手册复核](RESP-MANUAL-V22-REVIEW-R1.md)。按负责人要求取消线缆电阻测量，本轮改用呼吸率20/幅度1.5R，波形周期仍20单列；[R2步骤卡](AUTH-B-RESP-PATH-MEASURE-001-R2.md)先做参数确认和三对源端直流核对，黄L从LA改到LL的冷接方案列为待电气审阅后步骤。本轮未操作硬件，未收到旧R1实测结果，不改BIO_V2阈值或历史结果。

最新资料排查（未操作硬件）：模块确定测ERA–ELA，但厂家两张SKX-2000照片为绿RA/黄LA/红LL、RL空置，与本轮外部接法不同，不能用照片确认实际F→RLD。源D+手册未指定RESP端子对；本轮收窄颜色映射的证据结论，保留此前实物结果。已准备[离线线缆映射及源端直流测量卡](AUTH-B-RESP-PATH-MEASURE-001-R1.md)，尚未执行，不含新路径接线或CH1采集。只有万用表也可先排线缆与电位，再另卡探索RA–LL，不等厂家ΔΩ定义。原因130的触发逻辑及不改阈值的排查顺序见[源端路径复核](RESP-SOURCE-PATH-REVIEW-R1.md)。

最新：按负责人固定ECG60/呼吸15/1.5R/窒息0、波形周期20不变，完成一次45秒。采集/监督0、分析3；实际ECG60互证，但30秒评价中38次RR观察全部无效，RESP_PATH_NOT_OBSERVED。CPU问题暂列待查，未发reset/烧录命令。详见[45秒有效性实板结果](RESP-VALIDITY45-001-RESULTS-R1.md)。下方描述按历史阶段保留。

源菜单最新复核：呼吸率与波形周期是手册第5页的不同参数，不能把15/20直接当成RR冲突；上次CH2原码确有约500ms周期。负责人要求先解释源配置，ROM→Flash问题暂列待查，本轮未读板或新采集。详见[源菜单与ECG120复核](RESP-SOURCE-MENU-REVIEW-R1.md)。

当前最终状态：新零复位卡获批并完成一次10秒；采集/监督0、分析3，RESP_PATH_NOT_OBSERVED，CH1有小幅变化但周期未解出。halt1/go1、未发reset或烧录命令。详见[本次实板结果](RESP-E1-03-RESULTS.md)。E2/E3未执行；本轮各卡已消耗，下方等待/准备文字为各阶段历史，不再作为当前状态。

最新追加：一次复位卡获明确同意，但入口已变为运行态/VTOR08000000，按原卡STOP；实际reset/halt/go均0，未采集、未重试。[新零复位10秒卡](AUTH-B-RESP-PILOT-002-R1.md)及测试已备，单独等待新窗口确认；详见[运行状态审查追加记录](RESP-RUNTIME-STATE-REVIEW-R1.md)。

最新启动只读核验：两次连接均实际PC=1FFF32F0、VTOR=1FFF0000、CPU暂停，Flash/options匹配。当前停在系统ROM，尚未证明最初进入原因；未发reset/go/halt，未继续采集。详见[启动与J-Link流程核验](RESP-RUNTIME-STATE-REVIEW-R1.md)。[一次复位及有条件10秒新卡](AUTH-B-RUNTIME-RECOVERY-RESP-001-R1.md)已备，等待新增复位权限；以下E1失败/E0描述保留为历史。

2026-10-22 Asia/Shanghai。唯一实施分支 `codex/node-b-bio-v2-field-20261022`，合同起点 `2d34b848d5946d38b6f942fa61c4fc7c05138a40`。依据[RESP-003合同](contracts/MPM-B-RESP-003-R1.0.md)，未知ΔΩ/动态端子定义允许探索，欧姆值仍为null。本报告覆盖此前E0进度描述；E0报告、13项测试和回执原字节可在提交 `bff831e32004264b2ca79780e06b9fe941caad5f` 审阅，旧哈希仅绑定该历史快照。

## 当前结论

**E1_ABORTED_DIAGNOSTIC_ABI_MISMATCH**：按已确认的[R3单次卡](AUTH-B-RESP-PILOT-001-R3.md)仅执行一次，首组RAM诊断不符合冻结BIO_V2格式，立即停止，未完成10秒窗口。没有重试、复位、烧录或额外读板。不能签E1_INPUT_SEEN，也不能据此判断模拟器不支持呼吸、导联错误或算法错误。

| 阶段 | 状态 | 证据与边界 |
|---|---|---|
| E0 | 软件准备通过 | RESP独立源/profile、完整120B解析、独立周期估计及冻结C回放；实际呼吸页面bpm字样兼容修订后14项离线测试通过 |
| E1 | 首组诊断ABI不符而停止 | 1个3072B槽块及120B诊断/48B统计/12B缓存原件已保存，均不能冒充有效呼吸数据 |
| E2 | NOT_RUN | 未证明可信CH1动态，不进入15→30对照 |
| E3 | NOT_RUN | 不进入12/18/24名义RR矩阵 |

## 现场事实和电气依据

同一B板、ADS1292_V2.0及原三线保持：R红→RA、L黄→LA、F绿主动RLD→RL，LL/胸导空置；J5供电、原J-Link，CAN/A/C/人体断开。SKX电池供电、充电USB断开，无新增仪器连接或现场异常报告。负责人确认独立“呼吸波形/15bpm/1.5R”，原文字样bpm保留；窒息项未找到，记UNVERIFIED_NOT_CHANGED，没有要求继续寻找或更改。

DLX-YQ2915电池万用表：A组普通ECG120，负责人将原卡20V改为DC200mV，RA−RL/LA−RL/RA−LA分别报告2.3/0.7/1.7mV；原“20V没数据”不静默写为零。B组独立呼吸15/1.5R，在DC20V档三对报告显示0，这是粗量程显示，不是精确0V。每对只记录一个代表值，不补造三次或正负号。最后收到表笔全部移开且OFF的确认，才生成独占ready记录并启动。

同一ECG已试接路径、浮地电池源/表、原理图名义RLD100k及调制39k×2限流支路、A/B报告值低于0.20V停止界限，共同支持本次有限非人体10秒探索。输入阻抗/校准未知；这些依据不能证明32kHz瞬态、通用RLD兼容或实际限流电流。出厂报告仅为功能来源材料。详见[电气A/B摘要](../evidence/B-RESP-003/electrical-AB-review-01.json)及[电气R2卡](AUTH-B-RESP-ELECTRICAL-001-R2.md)。

## 本次执行和失败分析

| 项目 | 实际结果 |
|---|---|
| 卡/profile | R3，独立RESP profile03；原01/02和pending记录保留 |
| 整片Flash前检 | 读取1048576B，约25.922秒，匹配冻结整片SHA f713277a…；当次身份、options前检通过后进入槽读取 |
| 首组诊断 | 120B读取返回长度完整；tag为0xc4bfa8bf，预期0x324f4942；ABI为1085970804，预期2；触发RESP_DIAG_ABI |
| 初始化回读缓存 | 原件12B保留，与冻结初始化缓存不符；不是本次SPI实时回读，拒绝解释为有效ADS状态 |
| 采集/监督退出 | worker=1、supervisor=1；会话约26.734秒，其中大部分为整片Flash前检 |
| 离线分析退出 | 1，RESP_UNCONFIRMED_CAPTURE_END；未通过尾段/恢复门，不生成RR或波形结论 |
| 目标操作 | 37次受控SDK调用；Close另记录。halt=0、go=0、reset=0、Flash写=0 |
| 尾段及末检 | 未到达，无完整RAM尾段、结束Flash/options/身份复核或恢复确认；Close后目标状态未知 |

标准分析器如实拒绝失败采集，不通过截取3072B未验证槽块、跳过ABI或把随机字段解释为原码来凑RR。所有已读原件、120B不合格诊断、SDK日志及真实退出码封存在受限目录，公开仅摘要/长度/哈希，见[失败回执](../evidence/B-RESP-003/e1-failure-receipt-01.json)。初次执行清单生成还出现一次离线参数索引错误（exit1、未调用SDK），保留记录；修正清单后才发生本次唯一硬件会话，没有硬件重试。

冻结源码中BioV2_Init会设置tag和ABI；本次RAM观测不满足这一运行不变量。Flash内容一致只能证明该候选存在于Flash，不能证明当前PC正在候选中、已完成初始化或RAM未被覆盖。本次没有PC/启动映射/故障寄存器和完整RAM证据，根因尚未定位；不能直接归咎于BOOT、USB、传感器或算法阈值。下一步应先另卡只读核验运行位置、启动映射和初始化状态，之后再决定是否需要经授权复位或重启，不能直接重刷同一固件来掩盖失败。本R3卡一次权限已消耗，不再用于后续读取。

## 软件与证据边界

E0实现保留独立RESP_EXPLORATORY源门禁，Z0_ohm、delta_Zpp_ohm均null，dynamic_pair=UNVERIFIED。120B按8I+4i+14I+4f解析；槽版本、真实序号/时戳、冲突及稳定尾段先核完整性。CH1独立估计不以菜单数字作为先验，用中位峰间隔、谱峰、自相关交叉检查；冻结自研C源Host回放与实板输出分列。10秒不能签RR正式有效率或绝对阻抗精度。

本次代码仅在已确认的独立呼吸页面接受实际“15bpm”，不改成ECG源、不伪写rbpm，新增相应门禁回归；14项离线测试exit0，日志及工具哈希见[当前软件核验](../evidence/B-RESP-003/e1-software-verification-01.json)。旧E0开发中的真实头文件include编码、Windows宿主DLL释放失败及修复记录保留。软件测试通过不能覆盖此次实物诊断失败。

已通过ECG六窗、旧失败、备份和恢复副本保持原字节；BIO_V2固件/阈值及旧ECG工具未改。未接A/C/CAN/人体，未改变云环境或保护分支。实际源记录及安全/执行manifest保存在受限目录，公开[源记录摘要](../evidence/B-RESP-003/source-record-E1-public-summary-01.json)只能作审阅，不能作为下一次运行源记录。
