Serendipity-min/medical-multi-parameter-monitor/node-b/docs/CODEX-R6-RR15-SOURCE-TRUTH-A0-20261030/RR15-ALGORITHM-DESIGN-DECISION.md

# RR15 源真值分流与算法设计决定（A0）

当前 `SOURCE_UNKNOWN / ROOT_CAUSE_UNRESOLVED / ALGORITHM_PATCH_NOT_AUTHORIZED`。算法C/header及冻结评测器原字节保留，不对六簇拟合新阈值，不按RR模式禁HR，不伪造Lead-Off。

## 三条后续路径

| 独立参考结论 | 科学含义 | 可提交PI的下一步；均非本轮许可 |
|---|---|---|
| ECG_PRESENT_CONFIRMED | RESP设置可能仍带ECG；原“HR应无效”的源端刺激假设可能不成立 | 修订新版本刺激条件：获得真正ECG关闭且RESP不变的已验证源，或另行定义已验证同时含ECG/RESP的刺激。先重做源标签/预登记；不回改旧判据/NOT_PASS，不屏蔽真实HR |
| ECG_ABSENT_CONFIRMED_WITHIN_BOUNDS，且同期原ADC经原C产生有效HR | 获得新的、可独立标注的真实假阳性反例 | 才申请模式无关最小质量门离线候选；仍不自动批准烧录、A1追加或420s复验。无同期参考不能反证历史六事件 |
| SOURCE_UNKNOWN / 参考冲突 / 检出下限不足 | 物理输入类别仍未建立 | 保留未决，暂停阈值优化与正式重试，补参考能力/真值；不能用更高门限把问题“消掉” |

## 只作条件设计、不实施的新质量特征

| 候选证据族 | 可以检验的问题 | 易误拒的正例/局限 | 未来必须保持的对照 |
|---|---|---|---|
| 峰形、宽度、极性、局部显著性 | 已知无QRS中的窄扰动是否冒充完整QRS | 真实ECG120也可能窄且幅度低；不得由六簇12–20ms就提高最小峰宽 | 真实ECG60/90/120；不同极性/幅值/源；低幅带噪ECG120逐例报告 |
| 时间–频率/工频剩余 | 被50/100Hz占优的信号中是否仍有独立QRS结构 | 工频上叠弱真实QRS不能被整窗一刀切；相关不等于无QRS | QRS+工频+宽带噪声、相位变化、不同SNR；纯噪声负例 |
| 带内QRS证据与周期可信度 | 当前三间隔±20%是否在已知非QRS里偶然稳定 | 强制更规则会拒不齐/短暂失拍，不能只保留一个60bpm模板 | 原C/候选逐样本对比，真实率值和有效覆盖同时检查 |
| RESP相关性/共享扰动 | 是否存在独立参考证实的耦合模式 | 两信号同时存在时相关成分不允许使真实HR失效；不能依赖“RR15模式”标签 | 同时存在真实QRS与RESP的已知合成及物理参考、无ECG的真实对照 |

本表没有数值新门限，不声称任何候选已能识别真实假峰。250Hz ECG/50Hz RESP采样连续性、原始ADC/IRQ时间戳、序号、状态位和诊断ABI不能为质量门做静默变换；失效原因要可审计，不能改冻结标准让候选通过。

## 低幅带噪 ECG120 保护基线

| 已知数据集 | 已查看原C结果 | 未来保护要求 |
|---|---|---|
| DEVELOPMENT_QRS120_amp300_mains300_noise50 | 10624/11250 = 94.4356%正确有效覆盖 | 与相同数据/45s预热/分母比较，退化不超过1个百分点，率值±2bpm；不是新增95%验收线 |
| HOLDOUT_QRS120_amp300_mains300_noise50 | 10625/11250 = 94.4444% | 同上；本数据现已知，不再称未知留出 |
| 真实ECG60/90/120各01/02及当前ECG60 | 上轮指定45s预热后正确有效覆盖100% | 逐数据集保持合同给出的相对基线≤1pp退化和±2bpm；不把单个最终HR正确替代全段覆盖 |

amp300是合成输入ADC码幅度参数，不是已校准0.3mV。不能为了RR无误报提高幅度/峰宽门、降低原正例难度或混算分母。上轮曾把95%误称预登记目标的措辞已撤回；A0不复活该门槛，不重复65/17测试或重跑这些语料。

## 语料与留出治理

所有已查看/回放的R6六事件、R5 RR15、真实ECG各01/02及40组合成（包括seed9047、相位.47）现在均为**已知资料**。目录名02、HOLDOUT或旧报告的“留出”是历史角色；不能在未来依这些数据调参后再称全盲。它们可冻结为非盲回归库。

未来新候选需要在看波形/特征前固定新的独立源真值数据、划分、算法/工具SHA、特征/门限、评价指标和停止条件；由PI或独立保管者封存新的留出及参考标签。新留出尚未采集/建立，不以从已看数据再切片、换随机seed后反复查看来冒称独立未知验证。若无法获得新留出，应明报非盲验证和限制，不隐去。

新无QRS数据必须携带独立参考的幅值/带宽/时段/加载检测域；仅按RESP菜单命名不能成为纯噪声标签。新正例应包含真实ECG60/90/120、低幅带噪ECG120及跨源/相位/噪声变化。硬件/新语料采集另授权，A0不生成或窥看新的“待盲”样本，也不编写阈值补丁。
