Serendipity-min/medical-multi-parameter-monitor/node-b/docs/FINAL-SYSTEM-20261102/P2-RULE-DESIGN-DRAFT.md

# P2规则准备草案：成年人家庭测量、中国教学演示

状态：**DRAFT，未冻结、未启用分类、未部署**。负责人已选择使用范围；具体阈值、条件与输出须在形成可审核实现和测试后冻结。当前阶段仅做依据与语义准备。

优先准备服务端单一快照的准确报数、来源、测量完成时间、有效性和过期提示。NIBP为间歇完成的结果，不称持续实时血压；现有90秒时效是工程策略，保留并重新核验其与A完成事件的关系。MOCK/REPLAY明确声明模拟或历史，不能转成患者当前读数。AI输出和语音模板不能改写数字、单位或类别。

《中国高血压防治指南2024年修订版》将家庭测量与诊室测量区分；家庭参考为收缩压≥135或舒张压≥85mmHg，并要求连续5–7天的规范家庭测量，不能据单次值诊断。可据此拟定“达到/未达到家庭演示升高参考阈值”的教学比较，但不把低于阈值自动说成“正常”或“偏低”，也不把诊室分级套到家庭单次读数。[指南原文索引](https://pmc.ncbi.nlm.nih.gov/articles/PMC11937835/)、[国家卫生健康委关于规范家庭测量的说明](https://www.nhc.gov.cn/jkj/c100063/202009/b6a4c154c6574ed6814c15010c8b4b94.shtml)。2025基层指南已检索到，但当前原文入口未成功打开，不作为已完成全文核验的依据。

待冻结内容包括：单次演示还是多日汇总、低值/危急值策略、无结果/测量中/过期/离线措辞、模拟实验的类别展示是否启用。没有冻结的类别只报“无法按当前规则判断”，不让模型补阈值。

TEMP额外需要测量量语义：现有GY641读取To、探头对非人体物体，不能判“人体体温正常”。应通过可信的服务端设备/模式登记解释为物体温度；浏览器不提供或修改这一事实。人体温度分类需另有合适量测模式及确认条件。

计划针对真实事实提取器与确定性规则测试边界值、收缩/舒张一高一正常、尚未完成、过期、MOCK、REPLAY、离线、模型改值/单位/类别及模型失败回退；本文件不冒称这些新增测试已执行。
