Serendipity-min/medical-multi-parameter-monitor/node-b/HANDOFF_20261016.md

# NODE_B_REVIEW_HANDOFF

日期：2026-10-16，Asia/Shanghai。按用户确认新建 `B` 分支，基于 `B2@2ca744d2f06d49711863968aeef15b64891edd18`。提交内容为Node-B复盘、代码与脱敏资料，不是新增硬件验收。

## 1. 本次成果

- [统一入口](README.md)及六份专题：当前结论、模块/原理图/接线、新旧算法对比、证据矩阵与未做方向、代码/采集工具复现、源板S进度。
- 当前BIO_V2完整C/H/启动源与原Keil工程；旧算法修复后快照、通道隔离前源、厂家本地移植关键源码、现场专用工具脱敏文本。
- 标准多样本采集文件协议、稳定槽/尾段/冲突导出、表征工具和普通测试。明确旧profile不能套用BIO_V2；公开工具不内置真实UID。
- 模块数据手册、模块原理图、F407板图；历史报告脱敏副本及来源SHA。
- 源板S已有USB入口、观测工具和脱敏进度证据归档。未把尚未统一的BIAS仪表读数改判PASS。

## 2. 关键复盘结论

限定窗口中已验证帧连续性；PA1/START共用、主循环迟读和活动RAM取数问题曾真实存在。最新逐通道削顶修复已脱机证明，但未核验B板今天运行身份、未有对应候选真机复测。现有外部数据仍缺可靠输入真值，电气干扰入口、外部共模/RLD与呼吸阻抗链路未闭环。

正常配置本来就是RLD_SENS=EC，没有正常外部输入的“RLD改值后改善”证据。内部短接下感测选择变化带来的38.73倍工频底噪变化，只支持该受限配置因素；B3整轮仍REVIEW_REQUIRED。

本地厂家F407例程含后加诊断逻辑，不能当原厂基准直接替换当前工程。模块图纸J3默认不短接；图纸V2.0与资料包V4.1、历史PA1与当前PG15均分别说明。

## 3. 本次真实普通验证

| 项目 | 结果 |
|---|---|
| BIO_V2合成回归 | 27/27 |
| 通道独立合成专项 | 28/28；历史真实回放项本次NOT_RUN |
| FIFO队列 | 2561断言，0失败 |
| 采集工具 | 27/27，合成/模拟进程 |
| S控制台 / ROM模型 / BIAS观测模型 | 34/34、19/19、9/9 |
| ARM普通重建 | exit0，0 errors，0 warnings，无旧算法符号 |
| B2原BIO审查快照一致性 | 27/27文件逐字节相同 |
| 现场受保护原工程 | 99份文件SHA未变 |

资源：Code=24232、RO=968、RW=332、ZI=11748B，RW+ZI=12080B；BIN=25284B。这些是静态构建指标，不是动态栈/CPU测量。

产物：

- BIN：`438a8120f6df06ce219cdc30c0e5b697ac0e993f98d5a80521b10361536ae3ae`，与历史最新候选相同。
- 本次ELF：`52811fc02249835c8481f4f5103949e13681fe5ee7e55dee5caab716bb0fb1db`，与历史ELF分别记录。
- 符号表：`3d199f4ca47ac9fae7ef8a42c0a2b6ebcf96494e883bea9e94af1f1024e894be`。

机器回执：`evidence/arm-20261016T021838499663Z.json`、`evidence/host-20261016T021928433165Z.json`及`evidence/current-*.json`。

首次公开Host回归因私有身份文件未分发而有1项ERROR；保留首轮回执与错误摘要。修复只改公开测试夹具，不改变实际身份校验函数。原完整日志、原历史FAIL、现场原件留本地，未覆盖。

## 4. 发布与检查口径

发布清单 `evidence/artifact-manifest.json` 排除自身；执行 `python node-b/tools/verify_bundle.py` 核验字节。`evidence/source-provenance.json`记录原SHA和公开SHA。新写文档/工具的聚焦diff检查通过。完整diff检查退出2：原字节快照产生78070处空白诊断，其中72669处仅为CRLF行尾、5398处含原有空格/Tab、3处文件末空行，涉及145份文件。分类见 `evidence/inherited-whitespace-classification.json`；未改原件或屏蔽规则以取得PASS。三份非固件导航/属性文件只统一换行为LF，使磁盘和暂存blob身份一致。

原始患者/输入采集数据、UID、Flash、固件BIN/ELF、现场照片和私有配置不随包推送。预编译DSP库不随包推送，精确SHA依赖单列；本次真实ARM构建使用核验后的本地原件。

本分支普通CI现有push列表不包含B，不能将“没有运行”写作CI通过。本次不创建PR、不主动触发CI或Security Gate，不修改P4/main/P5、B2及原采集工程。准确提交SHA以Git提交元数据与交接消息为准。

## 5. 尚未完成

1. B板最新候选实际镜像身份与限定非人体复测。
2. S板同一时段的BIAS DC测量，以及1Hz、60/90工程波形的物理验证。
3. 衰减/偏置网络的真实幅值、共模、源阻抗及RA/LA/RL实物映射。
4. 已知ECG参考下的输入质量、逐峰准确度和RLD/呼吸单变量对照。
5. 已知变化阻抗下的呼吸率精度、顶轨恢复和ECG互扰验证。
6. B板供电/公共地/USB/J-Link路径对照、约25Hz来源及必要的模拟前端模块对照。
7. BIO_V2实际镜像专用采集profile的运行前核验；不能套用旧工具地址。

本轮没有开发新生理算法、改变阈值或进行硬件操作。后续先补已知输入与物理链路证据，再决定具体算法最小修复。
