Serendipity-min/medical-multi-parameter-monitor/doc/多参数心电监护仪项目方案.md

# 一、项目概述
```c
市场调研--》需求分析--》功能设计--》系统方案设计--》软硬设计--》样机开发
--》测试验证--》试产--》量产--》交付--》维护迭代
```

本方案设计一款**多参数心电监护仪**，集成心率、血氧饱和度、血压、呼吸率四大生命体征监测功能，设备具备高精度测量、实时数据显示、异常报警、数据存储等核心能力。产品定位兼顾家用健康监测、基层诊所筛查、病房床旁辅助监护场景，整体设计低功耗、小型化、操作简易，可满足日常健康监护及基础医疗辅助监测需求，测量参数符合民用及基层医疗设备精度标准。

核心监测参数：心率（ECG）、血氧饱和度（SpO2）、血压（SYS/DIA/MAP）、呼吸率（RR）、体温。

<!-- 这是一张图片，ocr 内容为：UYOUND.遥远 深号 成人 专用 精品笑 609元 137  关 梦想头 心率/ECG:60次/分 HITE 莲港鱼 购用 120/80 06 血压/NIBP:收输压/舒张压 平均压 收缩压/舒张压 平均压 WC 37.7 TH 0.5 37.2 体温/TEMP 体湿/TEMP:当前体温对比值温差 当前体温 AAAYAN 98 血氨/SPO2:98% 血氧/SPO2:95% LESP 20 呼吸/RESP:20次/分 -->


# 二、设计思路与架构
系统采用**主控MCU+多模块传感采集+信号处理+显示交互+报警存储**分层架构，分为硬件层、驱动层、算法层、应用层四层，各模块独立工作、协同联动，保障多参数同步采集与运算。

架构流程：传感器采集原始生理信号 → 信号放大、滤波、降噪处理 → MCU算法解析计算体征参数 → 屏幕实时显示 + 数据存储 + 异常声光报警。

# 三、硬件系统设计（核心模块）
硬件整体由主控核心、心电采集模块、血氧采集模块、血压采集模块、呼吸采集模块、显示模块、报警模块、存储与电源模块组成。

## 3.1 主控核心模块
选用**高性能低功耗32位MCU**作为核心处理器，负责统筹所有传感器数据采集、算法运算、屏幕驱动、参数校准、报警判断、数据存储等全功能控制。芯片具备高速AD转换、多路串口、GPIO接口，可同时兼容四路体征模块并行工作，无数据延迟、无参数冲突。

## 3.2 ECG模块
[https://item.taobao.com/item.htm?id=1024774043104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](https://item.taobao.com/item.htm?id=1024774043104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)

串口屏--》陶晶池

```plain
https://pan.baidu.com/s/1PuxC7GSZZgEI-AXcLKkrkg 
提取码：so9q
```

 双通道 24 位 AFE，集成 ECG 和呼吸阻抗测量功能；透明度高，需要自己处理滤波、心率和呼吸算法  ；

采用**三导联心电采集方案**，搭配专用心电模拟前端芯片，实现高精度心电信号采集。通过贴片电极采集人体体表心电微弱模拟信号，经过仪表放大器放大、工频滤波、基线漂移矫正、肌电干扰降噪后，输出纯净心电波形。

本设备心电采集摒弃普通运放放大方案，采用**医用级ADS129系列低噪声生物信号放大器作为模拟前端**，搭配**独立高精度ADC模数转换模块**完成信号数字化，形成“电极采集→前端精密放大→硬件滤波→独立ADC精准转换→MCU数据解析”的专业医疗级信号链路，适配微伏级微弱心电信号采集，信噪比、稳定性远优于常规放大电路，同时兼容心率、呼吸率双参数信号提取。

<!-- 这是一张图片，ocr 内容为： -->


## 3.3 血氧饱和度
[https://item.taobao.com/item.htm?id=728608269969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](https://item.taobao.com/item.htm?id=728608269969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)

<!-- 这是一张图片，ocr 内容为： -->


## 3.4 血压监测模块
[https://item.taobao.com/item.htm?id=661586203912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](https://item.taobao.com/item.htm?id=661586203912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)

大彩 5 寸 232

<!-- 这是一张图片，ocr 内容为： -->


## 3.5 呼吸率监测模块
依托**心电波形衍生算法+胸廓呼吸波动辅助识别**双检测方式，无需额外繁琐传感器。人体呼吸过程中会引起心电波形基线规律性偏移，设备通过高精度算法捕捉基线周期变化，结合呼吸节律滤波算法，精准统计每分钟呼吸次数。

该方案无需佩戴额外呼吸绑带，体验更便捷，同时可过滤身体晃动、说话带来的干扰，数据稳定。

测量范围：8～60次/分钟；精度：±3次/分钟。

## 3.6 体温监测硬件模块
### GY-641V3 非接触红外体温传感器
[https://detail.tmall.com/item.htm?id=675275952541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](https://detail.tmall.com/item.htm?id=675275952541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)

oled，2.4 寸---》串口屏

该传感器采用接口为i2C，可以用stm32407开发板，同时使用串口屏进行数据显示以及开始测温+oled显示模块

****

<!-- 这是一张图片，ocr 内容为： -->


局域网通信

```c
ECG模块
  ↓ UART
F407-ECG
  ↓ UART
ESP8266-ECG
  ↓ Wi-Fi
家庭路由器/AP
  ↓ 局域网
电脑TCP服务器
  ↓ WebSocket
浏览器大屏网页
```
