Serendipity-min/medical-multi-parameter-monitor/医疗检测仪资料链接/资料链接_M串口屏.md

M/D系列串口屏开发包(含软件/手册/视频)：https://kaifabao.gz-dc.com/M%E7%B3%BB%E5%88%97%E4%B8%B2%E5%8F%A3%E5%B1%8F%E5%BC%80%E5%8F%91%E5%8C%85V3.2.zip（2025.12.12）
