Serendipity-min/medical-multi-parameter-monitor/血氧/使用教程.md

[Arduino IDE 教程2.0（Windows系统）](https://sichiray-tech.yuque.com/dm0eyv/chanpin/bgzeuprcus47p8nz?singleDoc#%20《Arduino%20IDE%20教程2.0（Windows系统）》) + 检测PPG（脉搏） / SpO2（血氧） / HR（心率）的Arduino盾板 + 红光和红外光，对应的波长是660/905 + 透射式的采集原理 --- ## 一、连接方式 如下图👇，请按照图示将模组之间的接线接好。 ## 二、操作步骤 ### 资料下载 #### Arduino库文件 [AFE4490_library.zip](https://sichiray-tech.yuque.com/attachments/yuque/0/2023/zip/22166398/1688354302330-80213dbb-8a60-4b2d-826b-4db0051e66a7.zip) :::info [Arduino如何导入库文件？](https://sichiray-tech.yuque.com/dm0eyv/hx34hp/gxgi00bcmvtfv34n) :::  #### 上位机软件 [上位机.zip](https://sichiray-tech.yuque.com/attachments/yuque/0/2023/zip/22166398/1688354341378-65e09ea3-e7e7-4834-9b23-2ae92ea553f9.zip) ### 使用说明 #### 使用上位机查看波形 :::info **<font style="color:#DF2A3F;">需烧录1号代码</font>** ::: [如何烧录代码？](https://sichiray-tech.yuque.com/dm0eyv/hx34hp/fe8k5g) 上传成功后，**打开下载好的上位机。** :::info + 选择端口 [如何查看串口？](https://sichiray-tech.yuque.com/dm0eyv/hx34hp/segrlm) ::: +  #### 串口输出数据 :::info **<font style="color:#DF2A3F;">烧录2号代码</font>** ::: [如何烧录代码？](https://sichiray-tech.yuque.com/dm0eyv/hx34hp/fe8k5g) 上传成功后，点“**工具“**-------**”串口监视器”**，显示数据； :::info + 波特率：115200 ::: +  #### 串口输出波形 :::info **<font style="color:#DF2A3F;">烧录3号代码</font>** ::: [如何烧录代码？](https://sichiray-tech.yuque.com/dm0eyv/hx34hp/fe8k5g) 上传成功后，点“**工具“**-------**”串口绘图器”**，显示波形。 :::info + 波特率：57600 :::  + 若使用 Arduino IDE 2.0，想修改显示长度，可以在以下步骤进行修改 ```plain 可以在安装目录中找到 resources\app\node_modules\arduino-serial-plotter-webapp\build\static\js 文件夹，打开其中的main.xxxxxx.chunk.js, 搜索Object(o.useState)(50)将50修改成你需要的值 上述示例3中，Object(o.useState)(50)改成了Object(o.useState)(500) ```  ## 三、使用教程 [bilibili](https://player.bilibili.com/player.html?bvid=BV1um4y1E7oR&autoplay=0)   👉<font style="color:#000000;"> </font>[<font style="color:#000000;">点击前往淘宝购买：</font>**<u>指夹式血氧检测模组</u>**](https://item.taobao.com/item.htm?spm=a1z09.8149145.0.0.7b0d14f9ys64CR&id=728608269969&_u=iul75uq95f7) **<u><font style="color:#2F54EB;"></font></u>** **<u><font style="color:#2F54EB;"></font></u>** **<u><font style="color:#2F54EB;"></font></u>**  <img src="https://cdn.nlark.com/yuque/0/2023/jpeg/314712/1673925151128-ca922720-91f5-4e40-8626-5f5fefee4073.jpeg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" width="1608" alt="" title="" crop="0,0,1,1" id="uc5cc2b3d" class="ne-image"<img src="https://cdn.nlark.com/yuque/0/2023/jpeg/314712/1673922911372-6735b779-c3ad-41c2-9617-be6a3689177b.jpeg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" width="1920" alt="" title="" crop="0,0,1,1" id="u4c5cc1fe" class="ne-image"👇👇👇👇👇👇👇👇
