Serendipity-min/medical-multi-parameter-monitor/node-b/docs/AUTH-B-PREC-P0-DISCONNECT-001-R1.md

# AUTH-B-PREC-P0-DISCONNECT-001 R1｜D0 无复位断开调试器对照

2026-10-23。状态：待负责人单独授权，尚未执行。S0已结束且不重试；其三次VTOR均1FFF0000、15个运行PCSR样本均在ROM，Flash/options与冻结候选一致。S0关闭后的目标状态未知。

本卡唯一变量是解除B与J-Link的物理连接。它不包含人工复位、冷启动、重连、测量或采集，不把断线后静态屏幕解释成新的PC读值，也不独自满足根因关闭标准。

## 固定条件和预算

- 同一B、J5外部供电与开关、BOOT跳帽、模块、电极及串口屏保持；普通ECG60、电池SKX充电USB断开。红RA/黄LL/绿RL、LA空，CAN/A/C/人体断开，万用表离开并OFF。
- Codex不打开任何J-Link/串口程序，不发SDK调用。电脑侧reset/halt/go/连接/关闭/烧录/寄存器写均0。
- 负责人只在获准后操作B端整只JTAG调试排线，拔除一次；不带着探针接触排针，不移动屏幕/模块/电极或J5。电脑侧J-Link USB留原位，拔下的调试排线远离电路。若无法明确区分JTAG与其他接口，或整只接头不能平稳拔下，则停止，不尝试另一接口。
- 完整观察90秒内结束；拔前观察10秒，拔后30秒，不重试。若出现发热、异味、电源异常或意外复位，只报告已发生事实并停，不为完成本卡补操作。

## 获准后顺序

1. 不按屏幕，不改变页面。记录现有页面、可见数值/波形、是否有持续新增变化；先观察10秒。屏幕自己的时钟变化只记为屏幕时钟，不算MCU启动证据。
2. 保持B的J5供电和全部其他连线，只将B端JTAG调试排线整只拔下，一次。记录大致时刻及B电源灯有无可见改变。
3. 不复位、不接回，持续观察30秒。在断开后0、10、30秒分别记录同一组可见内容；如新波形或数值开始刷新，记录首次出现时间。无需另接USB或仪器；现有手机拍摄可作补充，不是强制要求。
4. 一次回报：拔前内容/变化、拔除时刻、断开后0/10/30秒内容、是否出现MCU驱动的新波形或新数值、有无异常。随后保持J-Link与B物理断开，等待下一张卡；不自行按复位键或断电。

## 结果边界

MCU独立输出尚不能辨别时，标记INDEPENDENT_STARTUP_EVIDENCE_NOT_ESTABLISHED。D0没有执行启动动作，不能将其称为独立启动通过；若画面恢复，也只能支持“与断开调试器相关”的观察，不能单独证明ROM转换机制。无调试器真实PC/VTOR、BOOT锁存瞬间和电源/NRST波形均仍未知。

后续人工NRST、冷启动或SDK重连须另卡、另获授权。P0保持CPU_ROOT_CAUSE_UNRESOLVED，P1保持BLOCKED_BY_P0。
