Serendipity-min/medical-multi-parameter-monitor/node-b/docs/AUTH-B-RESP-ELECTRICAL-001-R1.md

# AUTH-B-RESP-ELECTRICAL-001 R1｜DLX-YQ2915有限直流电位粗筛

2026-10-22 Asia/Shanghai。依据RESP-003第3节和负责人提供的万用表照片/电池供电确认准备。本卡是准确电气核对计划，新增连接仅限浮地电池万用表的两根电压表笔，**原RA/LA/RL三根导联及其接点不移动**。Codex不远程操作万用表、源或供电，不打开探针。本卡不批准E1采集；E1另按RESP-PILOT R2和实际就绪确认执行。

## 已有仪器证据及本卡边界

照片型号DLX-YQ2915，旋钮在OFF，红表笔插最右VΩ孔、黑表笔在第三孔COM位置，20A/mA孔未插。负责人确认电池供电。使用前本人再读孔旁标记；若不能确认COM/VΩ、线皮完好、表笔绝缘正常或存在低电量提示，停止，不凭照片猜接。仪表不接USB、充电器、外部电源、电脑、其他仪器或人体。

直流输入阻抗/校准状态未知，不能按其他德力西型号的10MΩ规格替代；照片可确认本机有独立直流电压档，本卡只进行低压端子间粗筛，不计算电流或阻抗。普通DMM的直流结果不能排除32kHz尖峰、稳定性或复阻抗问题，不能据此签通用兼容/绝对校准PASS。

图纸RLD输出有100kΩ支路，呼吸调制两支各39kΩ。按名义5V作设计数量级估算，单100kΩ约50µA、两39kΩ串路约64µA；这是图纸条件估算，不是实测电流、故障保证或模拟器额定规格。电池浮地源/表、同一已通过ECG的非人体接法和本次端子DC粗筛共同作为有限10秒探索的判断材料；仍承认呼吸模式RLD/32kHz兼容未获证明。

## 仅在第一组执行前核对

1. B仍按原J5供电，原J-Link/模块/BOOT不动，当前源保持先前普通ECG120；若当前菜单或供电状态与此不同，先反馈，不重新设源或供电。R红RA、L黄LA、F绿RL/N保持，LL和胸导空置；CAN/A/C/人体断开，无其他接地仪器，无短路/发热/复位/电源异常。
2. 两个表笔先离开所有设备；黑笔插COM，红笔插VΩ。只在表笔悬空时把旋钮从OFF转到**右侧白色20、直流电压V⎓档**。不是右上方红色20 V~交流档，也不是下方20 A电流档；不使用Ω、蜂鸣/二极管、电容、NCV、电流孔或电流档。
3. 确认屏幕正常、HOLD未锁定、无低电量提示。仅接触模拟器有清晰RA/LA/RL标识的外露金属端子；不碰板内排针/芯片、电源12V、墙插或不明确的地。原导联夹无需取下，不能让两表尖或夹子互碰。

## 第一组：保持普通ECG120，不切呼吸

每一行测量前先让两表笔离开端子，再按表接触；只接两个指定金属点，手指握绝缘部分。首次显示若已触发下面STOP则立即离开，不等采够。正常时观察约3秒、按约1秒间隔记录3次**带正负号、单位V和小数点**的屏幕读数；每行结束两笔离开，再进入下一行。总测量时间最多60秒，不反复延长或换档追数。

| 编号 | 黑表笔COM端 | 红表笔VΩ端 | 记录含义 |
|---|---|---|---|
| A1 | RL/N金属端 | RA/R金属端 | V(RA)−V(RL) |
| A2 | RL/N金属端 | LA/L金属端 | V(LA)−V(RL) |
| A3 | LA/L金属端 | RA/R金属端 | V(RA)−V(LA) |

RL在这里只是**浮地电压表的差分参考端**，不是系统GND；COM不接任何别的地、USB或仪器，不用导线桥接RL/LL/LA/RA。测量完两笔离开、在离线状态将表转OFF，B与源保持当前原状态；先回复A1/A2/A3及状态，**不自动切独立呼吸、不开始第二组**。

## STOP和第一组审阅

本轮预先采用保守粗筛界限：任一次读数`|V|≥0.20V`、显示OL/过量程/异常单独“1”、明显不稳定、接点不清或任何电源/温升/复位异常即停止。0.20V是本次低压试验的保守工程停止阈值，不是厂家额定或医疗标准；阈值内也不等于32kHz兼容已证实。不能为得到阈值内数值换线、换成2V/200mV、升幅3.0R、拔F或连接LL。先两笔离开、仪表离线OFF并反馈；不自行重试/短接/恢复电源。

Codex审阅实际读数、仪表档位/单位、三个差分的符号关系及异常情况后，才给出第二组是否可执行的明确结论；读数缺失或矛盾不默认通过。即使第一组均接近0.00V，也只代表该量程下的粗筛，不声称分辨毫伏ECG或微安电流。

## 第二组：另经第一组审阅后才进入

第一组正常且当前电气状态确认后，才按已提交RESP-PILOT R2在**表笔全部离开设备**时选独立“呼吸波形”、15rbpm、1.5R；记录全部实际菜单文字，包括窒息项，不猜0的含义，不更改未确认项。仍用电池断USB、原三线，不改RLD/模块/电源。保持源菜单后按相同直流20V档及A1–A3顺序各记录3秒，记为B1/B2/B3，仍受同一0.20V/60秒/异常STOP约束。

第二组结束立即移开两表笔并OFF，**万用表不留在E1采集回路中**；源保持获批的独立呼吸15初态，不自动切其他档。回复B1/B2/B3和实际模式/15/1.5R/窒息文字、USB/无人/CAN状态。只有第二组审阅及限定风险记录完成，生成安全记录SHA、实际ready源SHA和R2执行manifest后，Codex才可最多采一次10秒；无自动E2/E3、无复位/烧录或阈值修改。

本卡测量上限为两组各三对、每对观察3秒，总每组≤60秒；现阶段只进入第一组。不得把本卡当动态阻抗测试、通断测试、带电电流测试或新增接线授权。若要量内部地/电源、用电阻/电流档、示波器/其他仪器、断开导联或改变回路，另写卡，不在此范围。
