Serendipity-min/medical-multi-parameter-monitor/node-b/docs/AUTH-B-RESP-ELECTRICAL-001-R2.md

# AUTH-B-RESP-ELECTRICAL-001 R2｜第二组呼吸15直流粗筛与200mV细读

2026-10-22 Asia/Shanghai。本卡接续R1第一组审阅，仅允许同一浮地电池DLX-YQ2915的端子电压核对与源菜单动作，不打开探针、不采集或读板。RA/LA/RL原三线、J5/J-Link/模块/BOOT不动，LL/胸导不用；不接A/C/CAN/人体或其他接地仪器。

## 第一组实收与量程偏离

负责人按A1/A2/A3顺序报告2.3、0.7、1.7mV，位置为SKX端子，三合一线仍接模块。实际改用直流200mV档，另说20V档“没数据”。保留该原话，20V数值记null，不写成实测0V；R1限定20V，实际量程变更作为偏离记录，不能改写R1或追认它已按20V完成。每对仅收到一个代表值，未提供逐秒三次序列，不补造重复测量。

按报告值均无负号作差分一致性检查，2.3−0.7−1.7=−0.1mV；只是非同时测量值的差值，不是仪表误差校准。三个数均小于原0.20V停止阈值，可以进入本卡的有限第二组核对，不等于电流/动态阻抗/32kHz兼容通过。本卡明确允许下面条件满足后使用200mV细读。

## 准入与准备

同一B板及R红RA、L黄LA、F绿RL/N保持，B现有供电、模块、J-Link不变；SKX与万用表均电池供电，充电USB/其他仪器/人体/CAN/A/C断开，夹子无互碰，无异常发热/复位/电源现象。若现场有变化先反馈，不自行恢复或改线。

两表笔离开所有设备，再确认黑插COM、红插VΩ，20A/mA孔空；HOLD未锁、无低电量/破损。不接墙插、12V适配器、电流档、Ω/蜂鸣/电容，不测板内未知接点。RL仅作浮地电压表差分参考，不是GND，不桥接任何端子。仪表输入阻抗/校准未知，不挪用其他型号规格，不从电压换算真实电流或欧姆。

## 源菜单动作

表笔全部离开时，将SKX从当前普通ECG切到独立**呼吸波形**，选**15rbpm、1.5R**；仅这些菜单项允许改变。记录窒息项原始显示，不猜0秒含义、不擅改；若有窒息正在发生/无法辨认模式或15/1.5R设置，先反馈菜单文字，不测量或采集。B和源继续使用原电池/供电边界，不开关电源、不拔原导联。

## 第二组B：20V先粗筛，必要时200mV细读

每次换档、换测量对前，两表笔都离开设备。先用右侧**白色20、直流电压V⎓档**，不是红色交流20或下方电流20。按表每对接触约3秒，记录屏幕完整数值、正负号、小数点及V单位；每行结束移开两笔。粗筛三对均正常且`|V|<0.20V`后，才允许离开端子、改白色**200m、直流电压V⎓档**，再按同一三对各约3秒细读，记录mV单位和正负号。

| 编号 | 黑COM表笔 | 红VΩ表笔 | 记录 |
|---|---|---|---|
| B1 | RL/N | RA/R | V(RA)−V(RL) |
| B2 | RL/N | LA/L | V(LA)−V(RL) |
| B3 | LA/L | RA/R | V(RA)−V(LA) |

20V档若显示可辨认的`0.00V`，如实写0.00V（低于该档分辨力，不等于精确0V），可以细读。若是**真正空白、OL、过量程、异常单独“1”或无法辨认显示**，不能当0，不进入200mV；移开两笔、表OFF并反馈。不得为追数字反复换档；本组上限为3对粗筛加3对细读，总≤90秒，不额外重试。

任一粗筛`|V|≥0.20V`、细读`|V|≥200mV`、明显不稳定、过量程或任何发热/复位/供电异常立即停止；先移开表笔、表离线OFF并反馈，不改F/RLD、不接LL、不升3.0R、不重启或刷机。阈值是本次保守工程停止界限，不是厂家额定值；测量不能排除32kHz高频或瞬态问题。

## 结束与现场回复

两表笔全部离开、万用表OFF，不留在E1回路。SKX保持独立呼吸15/1.5R，原三线和B供电保持不变。一次回复：20V档三对显示、若进入细读则200mV三对读数；实际“呼吸波形/15rbpm/1.5R/窒息项”文字；USB断开、万用表已移开、CAN/A/C/人体断开及有无异常。

只有Codex审阅B组并记录安全判断边界后，才能冻结安全记录SHA、实际ready源SHA及[RESP-PILOT R2](AUTH-B-RESP-PILOT-001-R2.md)执行manifest；该卡最多一次10秒，不要求rpm_valid为真。本电气卡本身不启动E1、不给E2/E3授权，不改BIO_V2阈值或旧ECG六窗证据。
