Serendipity-min/medical-multi-parameter-monitor/node-b/docs/B-ALG-002-RESP-INFORMATION-CHECKLIST-R1.md

# RESP一次性缺项清单 R1

2026-10-22。现有材料可确认模块测量ERA–ELA，无法确认SKX动态阻抗端子对或ΔΩ定义。本清单收齐当前所有缺项；**只需提供已有文字/资料，未知保持未知，不为回答而改线、切菜单、上电或测量。** 不再索要已确认的J-Link型号/排线、J5适配器、BOOT或START/DRDY。

| 编号 | 仍缺信息 | 合格材料/责任方 | 作用 |
|---|---|---|---|
| S1 | 本机D+对应的呼吸输出拓扑：RA–LA还是RA–LL，普通ECG附带呼吸与独立呼吸模式是否相同，其他端子回路 | 厂家与型号/固件对应的接线图、等效电路或书面答复；不以另一型号演示代替 | 首次RESP试采前必须明确；仅RA–LL则停止本接线方案，另审适配 |
| S2 | `R`的物理单位与幅度定义；1.5R时Zmin/Zmax、1kΩ是中点还是下限、波形形状 | 厂家参数、可追溯校准资料，或另批的动态阻抗表征报告；同时给单位/激励频率/不确定度 | 先确立输入真值，再判断RR；不从菜单猜Ωpp或百分比 |
| S3 | 对本模块32kHz激励的兼容：允许频率/电压/电流、直流及共模路径；RL端是否可承受主动RLD | 厂家输入等效电路及额定限制，或另批匹配条件下的电气证据 | 电池断USB只描述供电，不能替代电气兼容证明；ECG通过不自动覆盖呼吸模式 |
| S4 | 呼吸模式能否设12/18/24次/分、实际误差；1.5R档、窒息0秒的确切含义；配套HR是否固定60 | 已有菜单记录/固件说明或厂家确认；真正执行时再逐档确认实际设置 | 首次试采拟12，正式矩阵再逐档确认；不要求现在切菜单 |
| S5 | 若厂家资料不足，可用的阻抗表征仪器及资料：型号、频率能力、浮地/隔离、激励范围、校准状态 | 只提供已有仪器资料；Codex据此另写精确表征卡 | 备选补证路径；不要求立即购买、接仪器、用台式示波器地夹试测 |
| T1 | RESP源记录门禁及新工具/profile哈希；现有ECG入口拒绝RESP且只支持10/92秒 | Codex离线实现与审查，保留既有ECG工具/证据 | 不把工具缺口转嫁给负责人，也不靠伪造源模式绕过门禁 |
| T2 | rpm/valid/reason、resp_candidates/accepted/last_cycle/fresh_intervals解析；CH1完整性、削顶与RR回放事件；正式长窗评价 | Codex离线实现及针对模式冒用、错误电极对、单位缺失、ABI/时长/尾段/输出失效的负例 | 采前冻结，不以软件测试替代真机结果 |
| A1 | 补证后这张卡R2的唯一SHA、实际源记录SHA、私有身份/profile/工具manifest绑定及单窗执行批准 | Codex先完成可审阅R2，再由负责人批准；目前不申请批准 | R1为待补证草案，不是现场操作许可 |

本机固件/校准版本目前未记录；可包含在厂家回复或已有资料中，不必为了读取版本而操作模拟器。没有资料时，用“未知”登记，不补造。若S1/S2/S3获同一份匹配型号的充分材料，可合并收据，不重复询问。

## 可直接复制给厂家的一次询问

以下仅为供负责人自行使用的文本，Codex未联系或发送给任何人：

> 我们使用SKX-2000D+电池供电，检测端为ADS1292R阻抗呼吸前端：在RA–LA之间施加32kHz激励并由CH1解调，另有独立主动RLD接RL。请针对本机D+型号/固件，提供下列书面信息或对应电路页：
>
> 1. 独立“呼吸波形”模式和普通ECG附带呼吸各在哪一对端子改变阻抗？是否支持RA–LA，是否可切换？请给RA、LA、LL、RL之间的等效回路，并说明RL能否接收外部主动RLD。
> 2. 幅度0.3R–3.0R中的R是否表示欧姆？这是峰峰变化、峰值、RMS、比例还是其他定义？默认1.5R、基础1kΩ时，请给Zmin、Zmax、波形及误差，并说明基线是中点还是下限。
> 3. 阻抗输出在32kHz载频下的适用范围是什么？允许的激励电压/电流、共模范围及接地/隔离条件是什么？请区分实际可变阻抗与仅输出低频电压。
> 4. 呼吸率能否精确设为12、18、24次/分，频率/阻抗幅度误差分别多少？独立呼吸模式ECG是否固定60 BPM？窒息时间0秒是否表示禁用窒息？请注明适用固件版本。

## 补证后的顺序

先解决源路径、单位及电气兼容；若仍未知，保持BLOCKED并准备独立表征卡。路径与当前RA–LA一致后，Codex完成离线工具和哈希冻结，提交[RESP-PILOT卡](AUTH-B-RESP-PILOT-001-R1.md)的可执行R2；批准及实际源设置确认后才允许单个10秒输入检查。该短窗不签RR PASS，正式长窗/恢复/窒息或断流负例分别列卡。若需要任何换线、外加仪器或写固件，先另审，不沿用ECG卡或本草案。
