Serendipity-min/medical-multi-parameter-monitor/node-b/docs/B-CPU-ROM-FLASH-DEFERRED-R1.md

# B板CPU ROM/Flash运行状态问题：按负责人要求保留待查

2026-10-23，Asia/Shanghai。状态：**DEFERRED_BY_OWNER，根因未解决**。负责人本轮明确要求保留该问题，之后一并处理；当前不开展启动/关闭流程对照调查。此次一次正常复位是已单独批准的运行恢复，不代表新增无限复位或诊断权限。

## 问题应如何描述

此前“CPU关闭”“算法消失”不是当前证据支持的准确表述。上次VTOR在系统ROM、五次PCSR也采到ROM地址，说明观测时CPU在执行ROM代码；应用Flash中候选固件仍完整。BIO_V2诊断位于RAM，应用未按预期运行时，RAM结构可能不符合tag/ABI，不能据此判断Flash程序被擦除。

Flash保存程序，RAM保存运行状态；正常断电、调试暂停或复位本身不会擦除Flash。RAM是易失状态，断电不保留，启动过程也会重新初始化相应变量。故本轮可确认“程序存在、曾未在候选应用中运行”；不能把RAM诊断失败和Flash算法丢失混为一件事。

它与更早的ROM/Flash状态切换属于同类运行异常，**是否同一根因仍未知**；不据此断言由J-Link Close、手动复位、BOOT脚、电源、SDK或固件某一因素导致。

## 保留的证据链

1. [早期启动/关闭流程核验](RESP-RUNTIME-STATE-REVIEW-R1.md)及历史失败保留，曾观察ROM暂停；后续也曾出现Flash运行。未建立何时/何因切换的连续证据。
2. [RA–LL20零复位卡失败](RESP-RA-LL20-001-RESULTS-R1.md)：VTOR1FFF0000，五次PCSR1FFF32EA…1FFF3300、CPU非暂停、fault0。完整1MiB Flash/options匹配，halt/go/reset/Flash写0。故不是读取不到算法BIN，而是当次不在所需采集运行环境。
3. 负责人随后报告断开J-Link、手动复位一次、重新接回；动作具体时刻/方法及期间CPU状态没有受控连续记录，不据此判定恢复机制。
4. [本次恢复卡结果](RESP-RA-LL20-RECOVERY-001-RESULTS-R1.md)：SDK复位前初态VTOR08000000，未读初态真实PC；按批准正常复位一次后真实R15=080001A0、MSP=20002F30，别名/向量正确，应用/ADC推进并完成45秒采样。前/末完整Flash/options一致，Flash写0。这支持算法仍存在且能运行，不证明关闭后问题已经消失。

本次手动复位一次（负责人报告）与SDK复位一次（日志计数）分别记录，不混成一次，也不隐藏用户动作。

## 后续处理边界与关闭条件

待负责人重新启动该问题排查时，另交精确卡并限定连接/关闭/复位次数，保留前后PC/VTOR和运行计数的实际证据，核对启动路径与SDK连接/退出行为；不得沿用已消耗卡、反复重连、写PC/SP或重新烧录来掩盖现象。无必要不索要已确认正常的J-Link型号/排线，不把可疑因素当作已经查明的根因。

现有SetRestartOnClose0、ForceAttachTarget、SetSkipDebugDeInit等是工具设置/日志事实，不等于实测证明Close后CPU一定保持Flash运行。当前关闭后状态未另开连接验证，明确记未知；不为追查这一点追加本轮硬件操作。

只有建立可重复的触发/恢复条件、确定机制并在明确授权的对照窗口验证修复后，才关闭该问题。一次复位后采集成功、候选全片一致或离线测试通过，都不单独满足关闭条件。

## 呼吸30窗口的追加事实（不改变待查状态）

2026-10-23，[20→30周期跟踪窗口](RESP-TRACK20-30-001-RESULTS-R1.md)初态VTOR08000000，按与20基线相同的单次正常复位流程进入真实Flash入口并采完45秒；前/末全片一致。没有额外PC/BOOT/关闭重连调查，也没有关闭后观察。本次E2成功仅涉及呼吸周期跟踪，CPU问题仍为DEFERRED_BY_OWNER。
