Serendipity-min/medical-multi-parameter-monitor/node-b/docs/B4-03-PIN-POWER-CHECKLIST.md

# B4-0.3 实物引脚与电源检查表（本轮不操作）

> 最新实物事实：负责人已完成并确认B CAN1↔C CAN2、P6 CAN_RX/PA11及CAN_TX/PA12、P4 CAN2_RX/PB12及CAN2_TX/PB13、独立板GND及60.8Ω断电阻测；A段断开、ESP隔离、无INMP441/TTS。B由J5、C由USB_UART供电。USB曾未接回时主机没有COM15，重新接回后已恢复CH340枚举；不能以枚举缺失误判设备故障。C BOOT0/B1跳帽均接地为负责人新事实，实际BOOT0电压/复位锁存尚待证据；本轮未指令改变跳帽。C曾ROM/HALT，完整原件未变，已按单次正常复位/Go恢复原H3；根因未定、候选未安装，暂停后续接线/故障注入。下文保留原软件准备阶段的空置/未接线记录，仅供追溯。

2026-10-23。C/B均STM32F407ZGT6已确认，不再索要MCU或J-Link型号。依据神舟号V2.0板图第4/5/6页及既有P分支资源核对；图纸不是当前实板电气通过证据。负责人本轮事实：J-Link在B，C尚未接入、使用J5，USB未接；C P4无跳帽/无跨接线；无INMP441/TTS；全部CAN线断开。C当前是否通电及网络模块供电/隔离状态未明确，不能默认为已就绪。

| 检查项 | 图纸/软件对应 | 本轮状态与未来核对 |
|---|---|---|
| C CAN2_RX逻辑 | P4-1 CAN2_RX ↔ P4-2 PB12，AF9 RX | 已报告空置，当前通路未接通；本轮不加帽 |
| C CAN2_TX逻辑 | P4-3 CAN2_TX ↔ P4-4 PB13，AF9 TX | 已报告空置，当前通路未接通；未来仅在冷态独立授权后1–2、3–4分别跨接，不跨两行 |
| C收发器 | U2=TJA1050，pin1=D/TX、pin4=R/RX，pin3=5V、pin2=GND，RS接GND | 参考图已查；实际装配/电源/针序对应仍须现场核对。PB12/PB13不是差分H/L |
| C外部CAN2座 | 参考图pin2=CAN_H、pin1=CAN_L，无第三个GND针 | 依真实丝印和接头方向确认，不能从照片朝向猜针号；本轮不接 |
| B CAN1逻辑 | PA11=RX、PA12=TX；P6选择CAN1而非USB_D-/D+路径 | 查到历史B照片有该选择座，不能替代本轮实物复核；不同时启用同脚USB |
| B CAN1收发器/外部座 | 参考图U3=TJA1050/5V；CAN1 pin2=H、pin1=L | 实物版本、启用/待机、端子方向及已装终端在G4前核对 |
| B/C参考地 | 各自板上明确标注的GND；两板各自J5供电 | 需确定实际参考地端子、地电位及USB/JTAG反供电路径；不并联5V/12V，不借用主动RLD或SKX导联作CAN参考地 |
| 终端 | B CAN1的R7、C CAN2的R1各120Ω | 图纸为固定120Ω；实物是否改装/额外端接未知。未来经批准、两板完全断电无反供电后检查H–L约60Ω，本轮不测阻 |
| A段 | A CAN1↔C CAN1独立500kbps | 负责人已报全部CAN未接；首次B+C台架保持A段断开，不并联两段H/L |
| 麦克风/音频 | PB12/13与I²S2及WM8978时钟共享，板载数据PC3/PC2、MCLK PC6 | 负责人确认无INMP441/TTS；台架不启用音频。没有推断板载WM8978与引脚已物理隔离 |
| USB用途 | 图纸USB_UART/CH340→PA9/PA10，与USB_SLAVE/CAN1资源不同 | 后续若采用USB下载，先明确实际接口和BOOT/复位边界，不能把插USB等同已授权下载。C只读卡选择J-Link，USB保持断开 |
| 网络隔离 | C现有H3可能在上电后驱动ESP自动联网 | C只读/台架前需确认ESP模块断开或已有效隔离，ETH等网络也断开；只读代码不联网不等于原C固件不会联网 |

B模拟源保持红R→RA、黄L→LL、绿F→RL，LA/胸导空置；不接人体、不短LL/RL、不把主动RLD接地。软件已固定NodeA1/B2/C3和500kbps，C CAN1共享时钟及filter14分界已离线验证，未取得任何CAN实板PASS。

本表只用于审批前核对，动作数0。已知事实先记入，不反复提问；剩余实际针号/地电位/终端/电源核验必须在另批窗口执行。来源见既有[资源审计](../evidence/B4-001/bench-r1/resource-audit.json)。

## C当次备份完成后的接线说明（2026-10-23追加，尚未接线/烧录）

负责人已把J-Link转接C；唯一只读会话双读1MiB Flash和16B options通过，H3应用/配置来源匹配，原件及离线恢复包仅EFS。本次按已有供电及ESP/USB现状读取，不是隔离台架PASS；C ESP仍在板上，网络隔离未证实。C仍原H3，B仍25488B，两个B4候选均未部署。当前不能接线后直接宣称CAN2收发通过。

接线方案继续B CAN1↔C CAN2，不把B改为CAN2。控制器号只属于各MCU内部编号，线上的两端无需同号。以后在台架安装/电气门禁获批、两板完全断电且J5/USB/J-Link等无反供电的条件下：

| 项目 | 准确连接/设置（参考板图第5页，实物按丝印确认） |
|---|---|
| B CAN1逻辑选择 | P6短接1–3（CAN_RX↔PA11）、2–4（CAN_TX↔PA12），不短接USB侧3–5、4–6；如已如此则保持 |
| C CAN2逻辑选择 | P4分别短接1–2（CAN2_RX↔PB12）、3–4（CAN2_TX↔PB13）；当前两组空置，需要补这两个跨接 |
| 差分H | B外部CAN1_H（参考针2）↔C外部CAN2_H（参考针2） |
| 差分L | B外部CAN1_L（参考针1）↔C外部CAN2_L（参考针1） |
| 参考地 | B明确标注GND↔C明确标注GND，单独一根；CAN两针座没有第三个地针；不得借用RLD/导联 |
| 供电 | B/C各自原J5供电，不互连5V/12V输出；U3/U2各需板载5V正常 |
| 终端 | 参考板B CAN1的R7、C CAN2的R1已各120Ω，不再额外各加120Ω；实际装配需确认，授权断电阻测时整段约60Ω |
| 其他通路 | A段及C CAN1外部总线保持断开；C不启用I²S2/INMP441/TTS，ESP须完成隔离后才进入无云台架 |

H接H、L接L，不交叉H/L，也不把PB12/PB13逻辑针直接拉到对板。C的P6本轮不为此改动。上述是待执行接法说明，未批准固件安装/实际台架之前不操作；B CAN2↔C CAN2不属于已冻结候选配置。
