Serendipity-min/medical-multi-parameter-monitor/node-b/docs/B5-G3-SITE-ATTACHMENT-R1.md

# G3现场附件R1｜待核对，不作为实测结果

当前附件随工具冻结，但未获得新的硬件/联网执行批准，不能填写实际通过。已知事实与未来需要的完成事实分开；不知道就保留UNKNOWN，不反复索取已有MCU/J-Link型号、历史SHA或资料包。

| 项目 | 最后登记/现有依据 | 本次启用所缺 |
|---|---|---|
| C | J5供电、USB_UART断开、J-Link在C；42552B及G2-B sector3实际通过 | 新的90秒C只读回执，UID/运行/全片/options/DISARMED实际一致；当前不读取 |
| B | 39948B现部署保留，最后登记断电 | 冷态转接后J5上电、屏刷新、USB不接；G3预备的一次只读身份/Flash/采样推进 |
| ESP | 装板并供电，未隔离，历史例外已记录 | 本次HW/G3各自同意在板例外；实际AT/TLS/SNTP在获批START后取证，自主联网仍UNKNOWN |
| USB/COM | C过去用过COM6/15，不代表现在 | 冷态准备后实际USB_UART/USB232及Windows COM号；不自动探测或打开未知板端口 |
| 调试 | 最后J-Link在C | C只读通过后一次冷态转到B；全部熄灭10秒、方向、供电/USB完成事实 |
| CAN | B CAN1↔C CAN2，H/L及独立GND；P6 RX↔PA11、TX↔PA12；P4 RX↔PB12、TX↔PB13；历史60.8Ω | 只确认原接法未动；不新增接线/测阻；A段保持断开 |
| 源/导联 | 负责人本轮前述普通ECG60；历史1.0mV、R→RA/L→LA/F→RL/N | 一次确认实际普通ECG60/1.0mV、电池且充电USB断开、RA–LA–RL及LL空；不授权改源或改线 |
| 其他设备 | INMP441/TTS/人体此前断开 | 核对保持原状，无新增接地设备，无其他串口/调试程序占用 |
| 云服务 | G1恢复PASS，11:15:45启动，预计17:15:45驻留到期（北京时间2026-10-27） | G3预备实时TLS/健康/订阅/WSS；至少625秒剩余预算；不自动重启 |
| 负责人停止能力 | 方案已写清，尚无本次确认 | 可即时切断B/C J5、C USB、J-Link电脑USB；若不能即时执行则不启动 |

一次人工操作的完整顺序只用[HW准备卡](AUTH-B5-G3-HW-PREP-001-R1.md)，避免分散要求插拔。先审批、先C只读PASS，再冷态转接；完成后一次回报COM、供电、屏幕、源/导联与异常。现在无需操作。

未来G3的计划内C RESET仅一次，在联合工具给出B/云端就绪提示后才进行并即时回报，不能在准备结束时提前按。此许可独立列在[G3 R4卡](AUTH-B5-G3-CLOUD-WINDOW-001-R4.md)，目前未批准。

私有附件、HW/G3禁用授权模板、C新鲜回执预留位置和全部参考包保存在既有受限EFS。库内build指针只定位本地准备，不代表已执行。工具不会凭历史回执把当前硬件身份或电气条件自动改成PASS。
