Serendipity-min/medical-multi-parameter-monitor/node-b/docs/PREC-P0-HMI-PATH-AUDIT-R1.md

# PREC P0 屏幕观察通道复核 R1

2026-10-23。M0负责人报告按RESET仍无可见反应，并首次补充两路屏幕接线。此后暂停追加复位/重连，先离线核对观察通道。该发现涉及独立启动证据是否可用，不改变S0实际ROM读值，也没有证实CPU异常机制。

## 来源及已核实映射

负责人描述心率屏VCC→5V、DOUT→232RX、DIN→232TX、GND共地；体温屏DOUT→R2IN、DIN→T2OUT，经J4，5V共地。其提供两张图为RS2与U8 SP3232/J4局部。整图来源为本机STM32F407原理图SHA7737115dc272d6daff1f3bb08b7c8c23c10415c10bca57c3d72979adf53b46b2，第4页MCU/扩展口和第5页RS232/P3/P5已目视核对。

| 路径 | 图纸默认可选连接 | 与当前冻结应用关系 |
|---|---|---|
| RS2的232RX/232TX | U8 R1IN/T1OUT为RS232侧；TTL侧R1OUT/T1IN经P3的2-4、1-3接USART2 RX/TX，即PA3/PA2 | 当前应用不是USART2屏驱动；PA3/PA2用于ADS1292 DRDY/CS |
| J4第二RS232通道 | R2IN/T2OUT对应J4的3/2脚；TTL侧R2OUT/T2IN经P5的2-4、1-3接USART3 RX/TX，即PB11/PB10 | 当前候选没有通过该USART3输出心率/呼吸屏业务 |
| 当前候选屏驱动 | USART1，PA9 TX/PA10 RX，115200、8N1、无流控 | 须有真实电平匹配且路由到这对脚，才可能成为本候选独立观察通道 |

上表为图纸默认可选路径，不是实测通断。负责人后续明确是两块独立屏，并补充实际跨线：P5的PB11_RX↔COM2_T、PB10_TX↔COM2_R；P3的COM1_T↔PD2、COM1_R↔PD6。因此不能再按P3默认1-3/2-4连接推断PA3冲突；当前没有其成立的证据。物理标签COM1_T/R、COM2_T/R与U8各脚方向仍需对应，不能仅由T/R字样随意反接。

已核板图PD2为UART5_RX，PD5为USART2_TX，PD6为USART2_RX；负责人随后明确确实是PD2，不是PD5。上述已报告屏路由都没有接到当前候选的PA9/PA10，屏幕观察通道不匹配已存在明确线索。开发包通用协议文档不能替代实物型号。后续若拟改接USART1，还需核对板图第4页P7与CH340是否占用PA9/PA10，避免叠加输出驱动；此文不授权改线或测量。

新增背面照片可读型号`DC80480DN050_1111_0C`，供电丝印VCC=5–30V，接口DOUT/DIN，并明确J5 OFF=RS232、ON=TTL。厂家[联机异常说明](https://doc.gz-dc.com/FAQ/VisualTFT/02_online.html)亦确认无外壳系列J5断开为RS232、连接为TTL；不采用其他KM050型号的数据手册替代本机规格。负责人已明确照片属于温度屏，心率屏配置相同：这是负责人提供的同配置事实，不冒称两块屏均已拍照核实。照片不能当成焊点通断测量，不擅自焊接或将DOUT直连MCU。

负责人进一步确认P7 PA9/RXD及PA10/TXD均有跳帽。按板图PA10已接CH340 TXD；USB未接仍不能证明板上+5V供电的CH340输出一定高阻。若后续把R1OUT再接PA10而不先隔离，存在两个输出并联的风险；这是未来接法的电气门，不能误写成当前已存在冲突，更不能据此确定ROM机制。PA9接CH340 RXD是接收负载，与两个输出并联不同。

## 固件身份交叉验证

冻结源码`SCREEN/hmi_user_uart.c`第26行起和头文件HMI_BAUDRATE明确配置USART1 PA9/PA10；不是依据USER/main.c注释单独推断。冻结AXF反汇编亦确认：main在08005A6E装载115200，08005A72调用UartInit；UartInit在08004B1C/08004B26为GPIOA引脚9/10配置AF7，并对40011000的USART1初始化。未重新构建固件。

仓库旧通用HMI技术说明仍包含PA2/PA3 USART2路径；它与本BIO_V2候选不同，不能据旧说明把屏幕静止当CPU停止证据。旧说明、冻结源码和已验收固件均不修改。

屏接口RS232/TTL设置必须实物确认，不能从VCC=5V或DOUT/DIN字样推断。候选源码关于DN050屏背J5的注释仅为线索，不替代当前型号资料。不得把RS232 DOUT直接接PA10，或未经授权切屏背J5、改P3/P5、换供电/串口。

## M0结果和下一步

M0已获一次实体RESET授权，负责人报告按下后仍无反应；没有分别给出5/15/45秒数值及精确执行次数，不能补写。由于屏幕路由未验证，判读为INDEPENDENT_STARTUP_EVIDENCE_NOT_ESTABLISHED；无调试器PC/VTOR仍未测，不能据静态屏签CPU仍在ROM或已回Flash。

此前在未核实完整串口路径时使用屏幕观察，证据通道不足，在此补正并保留原负例。负责人现又明确J-Link已接回开发板及电脑，但接回的准确时刻未知，不能将当前状态称为持续无调试器。没有据此自行发起SDK连接或重做M0。

已阅读指定M系列V3.2包的入门说明及93页厂家指令集V5.1（SHA a897c82bbbfc80e947865392e86693b845476bfa4037803b0e5fdfe60de8a819）；第17/41页支持115200档位0x07，但本包已列出的PDF未找到对应实物型号的电气接口规格，不能据此签RS232/TTL匹配。未安装软件、下载屏工程或执行包内操作指令。

目前只剩实物COM1_T/R与图纸T1IN/R1OUT的对应未核实，负责人答复“无法确认，应该与原理图一致”，不能升级成已测通或已确认相同版本。需P3及P7实物近照定位接口/排针，或同版本板卡明确资料；不要求通电欧姆测试，也不凭T/R字样猜方向。此缺口补齐后才能冻结电气审查后的改线卡，优先保留板载RS232转换路径，仅纠正MCU侧串口路由并处理P7占用。屏路由修复属于观察通道准备，不将其与冷启动/复位/调试器对照混为一次CPU归因实验。当前不执行新SDK连接或硬件动作；CPU_ROOT_CAUSE_UNRESOLVED，P1保持BLOCKED_BY_P0。
