Serendipity-min/medical-multi-parameter-monitor/node-b/docs/PREC-P2-INSTRUMENT-ASSESSMENT-R1.md

# PREC P2现有仪器能力判断 R1

2026-10-23。负责人补充“没有更专业的仪器，现有仪器能做就标定，不能做就跳过”。现场既有仪器仅电池万用表DLX-YQ2915；不再要求购买或反复补测。结论：**IMPEDANCE_AMPLITUDE_NOT_CALIBRATED_INSTRUMENT_REQUIRED**，按要求跳过P2实测。

V2.2操作手册SHA8b264906747e76336e7a7221ab77b76e3697078f794b064e77081e7e56fc48aa，第11/20页定义菜单0.3R–3R、基线1K、RA–LL呼吸导联II，但未把R明确成Ωpp/峰值/RMS，也未给32kHz端子等效图、允许激励/直流偏置、误差或不确定度。RA–LL是手册规定路径，不等于已实测其全部有源/浮地等效网络。

现有万用表不能提供已知32kHz激励及同步电压/电流相位和动态阻抗轨迹，也没有该频率下输入阻抗/交流准确度/隔离规格依据；电压近零不等于阻抗为零。不能在通电SKX或模块上用Ω档取得0.3R/1.5R/3R的Zmin/Zmax/ΔZpp，亦不能把CH1原码直接换算Ω。既有DC筛查只用于当次电气限界，不是阻抗标定。

未来若另有仪器且负责人决定继续，最低测量能力是：支持恰当32kHz小信号激励与偏置容限的隔离阻抗测量，或具有可溯源电流/隔离差分电压的比值测量夹具；模块/RLD与源是否分离、浮地路径及允许激励先审阅，不能默认普通接地LCR或示波器地夹可直连。保留源端实际电极对、基线定义、三档Zmin/Zmax/ΔZpp、至少三次重复与温度、仪器精度和夹具补偿/不确定度。没有这些条件不签绝对Ω通过。

本轮未接表、未新增夹具、未改幅度，也没有把相对幅度研究冒充标定。后续需要时再独立授权；当前全部Ω真值保持null。
