Serendipity-min/medical-multi-parameter-monitor/artifacts/ecg-source/g2s/S0照片与JLink参考线核验补充.md

# S0照片与J-Link参考线核验补充

日期：2026-10-15（Asia/Shanghai）。基线`B2@2ca744d2f06d49711863968aeef15b64891edd18`。追加记录，不覆盖原报告或S0准备单；尚未进行硬件访问。

## 已取得的资料

- 现场确认S/B均断电，S未接B或ADS。
- 新照片可见P11六根裸露针柱，无跨接跳帽；LED–DAC与RJ–ADC两组未装帽的状态得到照片支持。移除前后没有本轮通断实测记录，不能写成MEASURED。
- 板上丝印STM32F407ZGT6、V3.1可辨识；MCU封装型号刻字在照片中不够清晰，不能将板级丝印称为芯片实物刻字核验。正面照片不能代替背面网络/通断证据。
- PA4/PA5排针标签、USB_232、J5及K1区域已有照片。原V2.0板图与V3.1实物版本不同，结合标签作定位，实际通断与选通仍待现场核验。
- 万用表为手动量程，右侧白色直流电压20V档可见；电压插孔有红表笔，黑表笔所在COM标签需现场确认。照片未显示型号，未取得读数。不得选红色交流电压20档，也不得用电流插孔测电压。

六张照片已按原字节保留本地私有副本和SHA索引，不加入公开目录。

## J-Link：不能只按“3V3”字样判断

[SEGGER VTref说明](https://kb.segger.com/VTref)明确：VTref为目标电压参考输入，正常由目标板I/O电源提供；它不承担向开发板供电的用途。因此，如果当前线经实际型号和接口核对确为VTref，USB独立供电时应保留S.3V3→VTref参考连接。

[SEGGER标准20针接口](https://kb.segger.com/20-pin_J-Link_Connector)将VTref定义在1脚、可选5V供电输出定义在19脚。该编号只适用于相应标准接口，不能据此猜当前未知探针/转接板的3V3接点。若当前3V3接点是固定电源输出，不连接到已由USB供电的S.3V3；同样不连接任何独立5V/VCC输出。

实际探针型号、目标接口和3V3线来源照片尚缺；目前不连接J-Link、不上电、不直接要求拔掉或保留未知线。确认后只保留已核实的SWDIO、SWCLK、GND及VTref参考路径，必要的NRST另核实。支持供电开关的型号可按对应说明关闭Target Power；软件设置不能取代物理接点核验。

## 仪器PDF与动态验证条件

`ea7706.pdf`为FNIRSI DSO-153使用说明，50个PDF页；SHA-256：`6cdb953bf74041d2ee228ec0d48e4c1f3cbdbcb24413b112cc9f09dc63320da0`。

- PDF第8/12页：手册标称5MS/s、1MHz；时基范围500ns–20s，支持AC/DC耦合；不将这些标称规格当本台仪器校准证据。
- 第9页：信号输入MCX与信号发生器输出是不同接口。只使用测量输入，不把发生器输出接到DAC。
- 第13–14/16页：探头1X/10X与屏幕倍率必须一致；DC耦合可观察偏置及缓慢波形。
- 若实物与合适探头在手，该型号具备观察本次1Hz/60/90工程波形的基本标称能力；是否已取得实物、探头状态及电池独立工作能力尚待确认。手册并不等于已具备或已验证仪器。
- 本轮拟使用仪器自身电池、断开充电/数据线后测量，先明确探头地回路；只将地夹接经确认的S.GND。具体接线、量程和触发待S1电源及源固件验证后再执行。不得先夹PA4/PA5或把地夹接至信号/3V3。

## 当前停点

`S0=IN_PROGRESS_WAITING_JLINK_ID_AND_PHYSICAL_CHECKS`；`S1/S2/S3=NOT_EXECUTED`。电源、原Flash备份及恢复、DAC数字模式、DC读数和动态波形均未取得新实测结果。

下一输入：J-Link型号/输出接口及3V3线来源照片；确认DSO-153实物和输入探头是否在手。收到后在已授权窗口内继续，无须逐条重新申请操作授权。不能将本补充作为G2-S PASS或烧录回执。
