Serendipity-min/medical-multi-parameter-monitor/doc/P/90_维护/P4.1_安全治理收尾分析报告.md

# P4.1 安全治理收尾分析报告

> 文档编号：MPM-P-SEC-REP-0041  
> 版本：v0.1  
> 执行分支：`fix/p4-security-closeout`  
> 起点 Commit：`ec75b10c885b066f6a7bd6142cc1a9cf98b6affa`  
> 最终代码 / 配置 Commit：`e59c03b88a8a249d39331fcf9929688fa27edd8a`  
> 执行者：Codex  
> 日期：2026-09-20

报告与 CI 回执通过后续 docs-only 提交归档，不改写以上代码 / 配置验收基线。完整交付 HEAD 以本报告所链接 PR 的提交记录为准。

## 1. 执行摘要

本轮依据 MPM-P-SEC-SOW-0041 v0.1，完成已知问题收尾、固定回归、Git/SAST 产物治理及文档校正。执行者没有主动开展新漏洞发现、全量扫描、Fuzzing、Exploit、公网或外部主机测试；没有运行真实 A/B、RR 算法或 24h 验收。仓库已有自动集成回报的状态另见第 14 节，不纳入本轮验收证据。

本机结果：42 个固定 ASan/UBSan 案例、9 个完整性门禁测试、28 个 Backend 测试、CANopen 12 + Router 11 项、41 条 C→Backend 消息，以及 Gateway / Probe / Web 构建通过。Gateway ELF 不包含 MQTTFormat 符号。

最终状态：**CONDITIONAL PASS**。固定范围已通过本机验证及 GitHub CI；历史 SAST 覆盖缺口继续保留，CI 回执见第 14 节。不能把此状态解释为全库安全证明。

## 2. Git 基线与历史

```text
base: P4@ec75b10c885b066f6a7bd6142cc1a9cf98b6affa
branch: fix/p4-security-closeout
final-code: e59c03b88a8a249d39331fcf9929688fa27edd8a
PR target: P4
```

P4 已包含阶段二 `cfb30d0`、UI 成果 `c4b1662` 和维护提交 `d992712`。本轮不是把 P4 变成 security-only，也没有修改 main、force push 或重写历史。完整说明见 [P4 Git 分支与安全补丁继承说明](P4_Git分支与安全补丁继承说明.md)。

已分开提交：`49c4ff0` 为代码与固定回归，`e59c03b` 为原始产物移除及完整性 / CI 门禁，文档校正和本报告另作 docs 提交。

PR：[#3：fix/p4-security-closeout → P4](https://github.com/Serendipity-min/medical-multi-parameter-monitor/pull/3)，已创建并保持未合并。

## 3. Finding 处理矩阵

| Finding | 原风险 / 根因 | 处理及修改前后 | 状态 | 证据 |
|---|---|---|---|---|
| SEC-C-01 | 反序列化缺少有效长度边界 | 延续 P4 Safe Decode；补 CONNACK、SUBACK、UNSUBACK 固定回归，UNSUBACK 不再覆盖底层失败 | Fixed（本轮限定范围） | 29 个 parser / reader 案例 |
| SEC-C-02 | 旧包长可残留，容量不等于实际包长 | 初始化 / 每次读包先清零，完整成功后赋值；维持 publish-only 拒绝 | Fixed | 10 个真实 MQTTClient 实现回归 |
| SEC-C-03 | snprintf 截断返回值被误作索引 | 延续 P4 有界追加；密码只显示 `[REDACTED]` 或省略；构建名单拒绝 formatter | Fixed；当前 Gateway 不可达 | 3 个 formatter 案例、源名单门禁、ELF 符号核对 |
| SEC-C-04 | 普通 memset 可被优化，提前返回遗漏清理 | 沿用 volatile 清零；补完整退出路径 | Fixed（已知缓冲区） | 源码逐路径核对、Gateway / Probe 构建 |
| SEC-PY-01 | 目录 0o700 被误报过宽 | 保留属主专有权限 | False Positive | `install.py:73` 实际权限和调用上下文 |
| SEC-PY-02 | 子进程受环境 / 参数影响的提示 | 明确受信运维配置和 PATH 边界，不机械重写脚本 | Accepted Risk | 三处参数数组调用；第 12 节 |
| P4.1-ZEROIZE | CWJAP 失败或后续提前返回可能残留命令 | step 后立即清零，再根据保存的结果分支 | Fixed | `gateway_transport.c` |
| P4.1-LENGTH | MQTTPacket_read 未传播 decode 失败 | decode 失败立即退出，不编码部分长度或读 payload | Fixed | 固定回调次数 / 缓冲门禁断言 |
| P4.1-UNSUBACK | wrapper 只看包类型而覆盖 ACK 解析失败 | 必须同时 ACK 成功且类型正确 | Fixed | 合同指定截断案例首轮失败，修复后通过 |
| P4.1-COVERAGE | task132l 为 Error 且 scanned=[] | 保留 Coverage Gap 与正确命令模板，本轮不补扫 | Coverage Gap | 历史脱敏摘要 |
| P4.1-GIT | 原始 SARIF/JSON 已入 Git | 备份校验后从新 HEAD 删除，添加忽略规则 | Fixed（HEAD）；历史保留 | 9 个文件删除、忽略规则 |

修改文件集中于 Paho 客户端边界、两个已知临时缓冲区使用文件、固定测试和仓库门禁，完整清单见第 15 节。已有 ASan 证据说明库级内存问题，不证明当前固件存在严重远程利用影响。

## 4. Paho 修复详细说明

### 4.1 Remaining Length

修改前：P4 已让 `MQTTPacket_decode()` 返回读取失败，但 `MQTTPacket_read()` 未检查返回值；客户端也先向目标缓存回填长度，再验证容量。

修改后：decode 失败立即退出。成功时先在固定四字节临时区编码，再按前缀非负、前缀不超过容量、正文非负、正文不超过剩余容量的顺序检查；只有通过才回填前缀并读取正文。这样避免在失败后继续处理部分长度，也避免 `size_t - int` 下溢或边界检查之前的写入。

当前客户端白名单内的 CONNACK、ACK、SUBACK、PUBLISH 解析器使用 `MQTTPacket_decodeBufSafe()`；UNSUBACK 委托有界 ACK，并保留底层失败。实际客户端调用传 `read_packet_len`。PUBLISH parser 仅用固定 host-only 输入验证，Gateway 调度直接拒绝下行 PUBLISH。

未覆盖：上游 server-side 兼容模块、非阻塞兼容 API 的完整审计、所有 MQTT 规范组合。旧 `MQTTPacket_decodeBuf()` 为兼容保留，当前 Gateway 源文件名单内没有调用；不把该结论推广为全库已安全化。

### 4.2 read_packet_len

- [x] `MQTTClientInit()` 显式初始化为 0。
- [x] `readPacket()` 每次进入先清零。
- [x] 只有完整报文成功接收后才设置实际字节数。
- [x] 首字节超时、长度解码失败、容量不足和正文截断不会复用旧长度。

## 5. Inbound PUBLISH

当前架构为 Gateway publish-only。P4 已有行为保持如下：

```text
unexpected PUBLISH → cycle() FAILURE → MQTTCloseSession → 无消息回调
```

固定测试使用真实 MQTTClient 实现和内存 Network stub，同时注册匹配回调和默认回调，确认返回 FAILURE、isconnected 清零、会话回调槽清除、handler 调用次数和发送次数均为 0。

关闭的是 MQTT 会话状态；传输连接的关闭 / 重连仍由既有 Gateway 外层管理。本轮未改变正常 MQTT 状态机或 AT/TLS 顺序，仅修边界、清零并锁定既有拒绝行为，因此按合同不重新烧录或联网验证。

## 6. Sensitive Memory

| Buffer | 是否敏感 | 清零时机 | Early Return 是否覆盖 |
|---|---|---|---|
| CWJAP command | 含 SSID / Wi-Fi 密码 | WIFI step 后立即擦除，再判断结果 | 是，后续失败也不会留有 CWJAP 内容 |
| MQTT Will | 当前为合成状态 JSON；不是密码字段 | 序列化失败及 MQTTConnect 返回后均擦除 | 是，限定该局部数组 |
| Probe command / line / response | 可能含 SSID、命令及回显 | query 后擦 command；完整或拒绝输入后擦 line，超长时立即擦前缀；保存查询结果后擦 response | 是，限定已知处理路径 |

复用 command 中的证书名称 / SNI 也在 step 后清理。volatile 字节写与编译器屏障沿用 P4 实现。未承诺所有栈内存、Flash 配置、串口环形缓存或编译器临时副本都已清零。

## 7. Build Attack Surface

Gateway 实际 Paho 源文件名单（相对 vendor 目录）：

```text
MQTTClient-C/src/MQTTClient.c
MQTTPacket/src/MQTTConnectClient.c
MQTTPacket/src/MQTTDeserializePublish.c
MQTTPacket/src/MQTTPacket.c
MQTTPacket/src/MQTTSerializePublish.c
MQTTPacket/src/MQTTSubscribeClient.c
MQTTPacket/src/MQTTUnsubscribeClient.c
```

`MQTTFormat.c included? NO`。完整性脚本仅解析 build.py AST，不导入并执行构建；拒绝 Paho glob、formatter 和名单后追加。构建前及 CI 均执行门禁。对最终 ELF 的符号检查未找到 `MQTTStringFormat*` 或 `MQTTFormat_*`。formatter 只编译进本机固定测试程序。

## 8. Host Regression

### 8.1 ASan / UBSan

入口：

```bash
python gateway/canopen/run_security_regression.py
```

实际编译模板（完整相对路径命令保存在 runner 和其 results.json）：

```bash
gcc -std=c11 -g -O1 -Wall -Wextra -Werror -Wno-unused-parameter \
  -fsanitize=address,undefined -fno-sanitize-recover=all -fno-omit-frame-pointer \
  -ffunction-sections -fdata-sections -Wl,--gc-sections -fno-pie -no-pie \
  -DMQTTCLIENT_PLATFORM_HEADER=mqtt_host_platform.h -DMAX_MESSAGE_HANDLERS=1 \
  <项目相对路径的 include、固定 Paho 源码与测试文件> -o <本机 build 产物>
```

结果：29 个 parser / reader、10 个 client、3 个 formatter，共 42 个固定案例 PASS；三组编译和运行退出码均为 0，ASan / UBSan 未报告违规。范围包括 NULL / len=0、截断及五字节 Remaining Length、声明长度超过实际、Topic / QoS1 Packet ID 边界、正常 host-only PUBLISH、ACK、CONNACK、SUBACK、UNSUBACK，以及下行 PUBLISH 拒绝。

CONNACK / SUBACK / UNSUBACK 各包含截断、声明长度超过实际、合法包三个固定场景。首次运行的截断 UNSUBACK 断言失败，定位为包装器覆盖底层失败；修复后所有既定案例通过，没有扩展随机样本或联网验证。

日志保存在被忽略的 `gateway/canopen/build/security-regression/`，包括每组 build.log、run.log 和 results.json；Git 仅保存 [固定回归摘要](P4.1_固定回归摘要.json)。

## 9. Project Regression

| Test | Command | Result |
|---|---|---|
| Backend | `python -m pytest cloud/backend/tests -q` | PASS：28；2 条依赖弃用提示，不是失败 |
| CANopen / Router | `python gateway/canopen/build_host.py` | PASS：12 protocol + 11 pipeline |
| C→Backend | `python gateway/canopen/tools/check_canonical.py` | PASS：41 条消息，11 类流 |
| Gateway | `python gateway/mqtt/build.py` | PASS：text 30084，data 88，bss 120072 |
| Web | `npm --prefix cloud/web run build` | PASS：TypeScript 检查及 Vite 构建 |
| Paho Integrity | `python gateway/third_party/verify_paho_integrity.py` | PASS：12 pristine、9 patched、7 sources |
| Integrity guard tests | `python -m unittest discover -s gateway/third_party/tests -p 'test_*.py'` | PASS：9 |
| Probe | `python gateway/esp_at_probe/build.py --network-probe` | PASS：text 5372，data 84，bss 7004 |

Backend 使用项目既有虚拟环境；host C 回归使用既有 Linux GCC；Gateway / Probe 使用既有 ARM 工具链及外设库。没有安装或更改设备固件。

## 10. Semgrep / Static Analysis Coverage

本轮不重新执行 Semgrep；以下为随 P4 留存的历史记录，不能标成 P4.1 新扫描 PASS。

| Ruleset | Status | Target | Findings | Errors / Skips |
|---|---|---|---:|---|
| p/c | Coverage Gap | gateway，98 文件 | 7 | 8 Syntax error + 20 PartialParsing |
| p/python | 历史结果已人工定性 | cloud，18 文件 | 4 | errors=0；其余未覆盖范围不推定通过 |
| p/secrets | 历史记录范围内未命中 | cloud 76 / gateway 166 文件 | 0 / 0 | errors=0；不等于全库凭据证明 |
| task132l | ERROR / Coverage Gap | scanned=[] | 0 | 1 Error，实际记录请求 OSS；不能当 Pro 扫描通过 |

其他 Error / Skipped / parser limitation / 0 files scanned 均不算 PASS。历史报告宣称的修复后零命中没有独立留存结果支撑。命令模板和证据说明见 [校正后的 P4 报告](安全扫描报告_P4.md)。

## 11. Raw Security Artifact Governance

- `static_analysis_semgrep_1/` 的 9 个已跟踪文件从 HEAD 删除：是。
- 删除前在本机仓库外保留副本，逐文件 SHA-256 相同：是。
- `.gitignore` 已增加 `static_analysis_semgrep_*/`、`semgrep_raw/`、`security_scan_raw/`、`*.sarif`；没有全局忽略 JSON。
- 保留脱敏报告及 `安全扫描摘要_P4.json`，不含本机绝对路径、Token、服务器连接信息或源码片段。
- 原始产物从 HEAD 删除，但未重写历史；旧提交仍可追溯。

## 12. Python Finding 人工定性

### SEC-PY-01

结论：**False Positive**。`install.py` 的 `os.chmod(backup.parent, 0o700)` 只开放属主权限；目录还需要执行权限才能访问，不能改成文件常见的 `0o644`。配置文件原有 `0o600` 保持不变。本轮没有为了减少提示而修改权限。

### SEC-PY-02

结论：**Accepted Risk**，适用范围为受信本机运维。install / upgrade / browser_acceptance 的调用使用参数列表，未设置 shell=True；参数源于操作员 CLI、受控配置和脚本固定值，不存在已确认的远程请求到 shell 拼接链。工具仍通过 PATH / 本机可执行文件解析，操作者须控制配置和执行环境。本轮未把该环境信任假设宣称为已消除的风险。

## 13. Vendor Integrity

上游 commit：`6035ea2d4922bb7558b444fb2a051743f3f1974b`。
PATCH-01 为 ARM 短枚举 ABI 防护；PATCH-02 为 P4 有界解析、实际包长、publish-only、formatter 防护；PATCH-03 为本次长度生命周期、错误传播、UNSUBACK 和固定回归收尾。

原始 SHA 保存在未修改的 `gateway/third_party/paho-embedded-c/upstream.json`；9 个项目补丁后的 SHA 保存在同目录 `patched.json`。两者分别核验，不能用原上游散列要求 patched 文件相等，也不能覆盖原上游值。保留 `edl-v10`、`epl-v20`、`PATCHES.md`，许可证选择仍为 EDL 1.0。

检查脚本为 `gateway/third_party/verify_paho_integrity.py`。`.gitattributes` 对 Paho 子树限定 LF，使 Windows checkout 与 CI 的字节散列一致。门禁是已评审版本 / 构建名单的一致性检查，不是对任意恶意构建脚本的沙箱。

## 14. CI

Workflow：`.github/workflows/phase1.yml`，名称 `Gateway and cloud checks`。已增加修复分支 push 和到 P4 的 PR 触发，包含 Backend、完整性及 9 个门禁测试、42 个固定 sanitizer 案例、CANopen、C→Backend、Web 构建。

Run ID：[35518138651](https://github.com/Serendipity-min/medical-multi-parameter-monitor/actions/runs/35518138651)，事件为 `pull_request`，Conclusion：**success**。验收 HEAD 为 `e7302b462100f670e557605ad3c144c354c8d9f5`，全部测试与构建步骤通过。后续报告回执提交仅更新文档，不改变上述代码 / 配置基线。

同一 HEAD 的 push Run `35518125496` 被工作流并发策略取消，由以上 PR Run 完成验证；取消不计作测试失败或通过。

查看 PR 检查状态时，另观察到仓库已有的 `semgrep-cloud-platform/scan` 集成自动回报 SUCCESS。执行者未主动调用该扫描、读取发现内容或据此扩大修复范围，也未更改该集成配置。此状态不计入本轮固定回归或历史覆盖缺口的关闭证据；本报告的“不重扫”指本轮执行步骤，不能表述为仓库自动化从未运行扫描。

Local-only：ARM Gateway / Probe 实际编译与 ELF formatter 符号检查。GitHub runner 没有本机外设库路径，不能把 CI 的 host 编译冒充 ARM 固件构建。

## 15. 变更文件清单

```text
.gitattributes
.gitignore
.github/workflows/phase1.yml
gateway/mqtt/build.py
gateway/mqtt/src/gateway_transport.c
gateway/esp_at_probe/src/network_probe.c
gateway/canopen/run_security_regression.py
gateway/canopen/tests/mqtt_host_platform.h
gateway/canopen/tests/test_mqtt_bounded.c
gateway/canopen/tests/test_mqtt_client_bounds.c
gateway/canopen/tests/test_mqtt_formatter.c
gateway/third_party/verify_paho_integrity.py
gateway/third_party/tests/test_paho_integrity.py
gateway/third_party/paho-embedded-c/patched.json
gateway/third_party/paho-embedded-c/PATCHES.md
gateway/third_party/paho-embedded-c/MQTTClient-C/src/MQTTClient.c
gateway/third_party/paho-embedded-c/MQTTClient-C/src/MQTTClient.h
gateway/third_party/paho-embedded-c/MQTTPacket/src/MQTTPacket.c
gateway/third_party/paho-embedded-c/MQTTPacket/src/MQTTUnsubscribeClient.c
gateway/third_party/paho-embedded-c/MQTTPacket/src/MQTTFormat.c
doc/P/90_维护/安全扫描报告_P4.md
doc/P/90_维护/安全扫描摘要_P4.json
doc/P/90_维护/P4_Git分支与安全补丁继承说明.md
doc/P/90_维护/P4.1_固定回归摘要.json
doc/P/90_维护/P4.1_安全治理收尾分析报告.md
static_analysis_semgrep_1/ （删除 9 个原始产物文件）
```

## 16. 回滚方案

PR 未合入时保持 P4 不变即可。若以后需要撤销本轮代码，使用新的 revert 提交，按依赖顺序撤销相关修复并重跑固定回归；不 reset / rebase 已推送历史、不 force push。优先只回滚必要实现，不恢复原始 SARIF/JSON 到普通 Git；撤销修复会重新暴露本报告列明的已知问题，需在单独 PR 中明确说明。

服务器：N/A，本轮未部署。硬件：N/A，本轮未烧录。原始产物可从本机备份或旧提交恢复到隔离目录，不应直接恢复入当前仓库 HEAD。

## 17. Residual Risk

- Paho / CANopenNode 全库没有被证明不存在其他问题；兼容 API 和历史解析缺口仍在范围之外。
- 本轮没有 Fuzzing、真实三板 CAN、24h 稳定性、真实患者数据或联网安全验证。
- 当前 publish-only 是重要边界；将来启用下行订阅需要重新评估，不能直接恢复旧分发路径。
- 受信操作员、PATH 和外部配置仍属于运维信任假设；已知局部清零不等于清除设备内所有副本。
- 原始扫描历史未重写，旧提交仍可访问相应产物；本轮不推断其中存在有效秘密，也不执行凭据轮换。
- 历史 Semgrep Error / PartialParsing / 未留存复扫记录继续作为 Coverage Gap。

## 18. 后续维护规则

Paho 升级必须使用独立 PR，固定 upstream commit，保留原始 SHA / 许可证，更新 PATCHES 和单独 patched SHA，运行固定 sanitizer、完整性、Gateway 编译及相关项目回归。状态机或 TLS 行为变化时再按授权安排真机 smoke test。Raw SARIF 默认不进入普通 Git；新增 MQTT 下行业务须另签协议与安全合同；不用零命中替代覆盖说明。

## 19. 最终裁定

是否建议合入 P4：**CONDITIONAL**；本报告所列本机回归及 CI 已通过，建议在评审者接受明确保留的历史覆盖缺口和维护边界后合入。PR 保持未合并，由用户决定是否合并。

在本次已定义的 Gateway MQTT 接收路径、固定回归输入和当前构建配置范围内，未检测到已知 P4 Finding 的残余内存安全违规；未覆盖范围继续保留为后续风险。
