Serendipity-min/medical-multi-parameter-monitor/doc/P/90_维护/P4_合流与Vite_clang交付报告_2026-09-21.md

# P4 合流、Vite 升级与 clang 分类交付报告

日期：2026-09-21；执行者：Codex。仅完成本轮两项独立任务；未开始 A/B、RR 算法、真三板、Flash、24h、RC、Docker/ZAP、release、部署或人体数据验收。

## 1. Git 合流及 PR #3

- 安全整改旧 HEAD：`2fed4a290ef8c469a84fd8468d3ba2e9cb5ba4cd`。
- P4 的 Security Gate 接入提交：`bb2bc94f43337e6ff229ba1391c22140bbf4fb5a`，保留原提交，不 amend、不重写。
- 将 P4 合入修复分支的 merge：`254a0a08351bafc379f83c568769c5b510995f42`，无文件冲突。
- [PR #3](https://github.com/Serendipity-min/medical-multi-parameter-monitor/pull/3) 合并前状态为 MERGEABLE / CLEAN，检查全部通过；使用 match-head-commit 防止合并未经核对的新 HEAD。
- [PR CI 35522530275](https://github.com/Serendipity-min/medical-multi-parameter-monitor/actions/runs/35522530275) 通过；并发取消的 push 检查通过 [35522528892 的重跑](https://github.com/Serendipity-min/medical-multi-parameter-monitor/actions/runs/35522528892) 恢复为成功。
- 已按本轮授权 merge PR #3 → P4。新的 P4 精确 SHA：`44e3bdf74c1d503abefc992406700ea719ab346c`。没有修改 main。
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
