Serendipity-min/medical-multi-parameter-monitor/ADS1292R模块资料V4.1_ECG/测试连接/人体3导线连接示意图.JPG

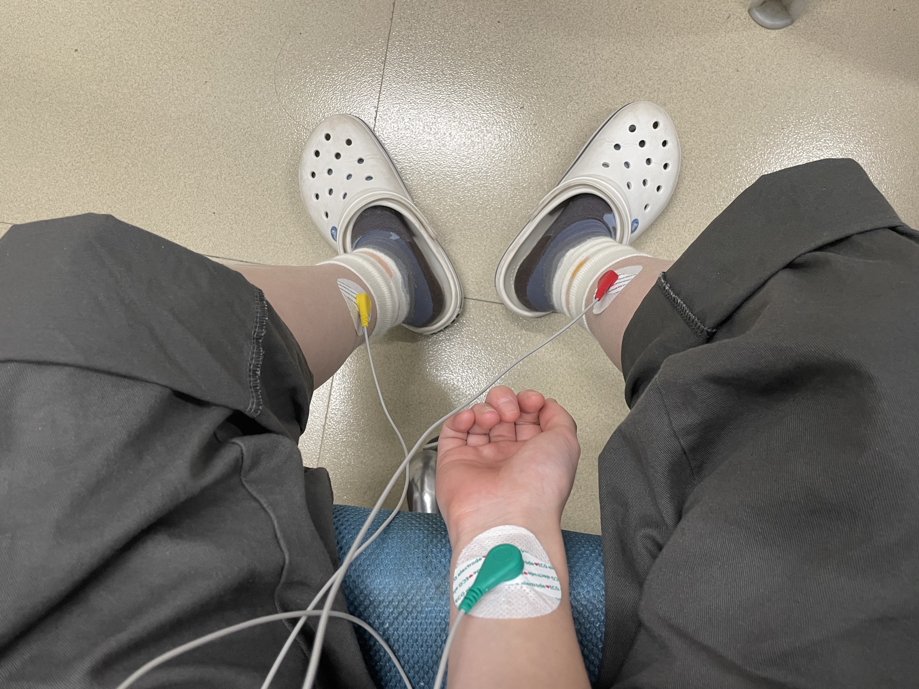
ADS1292R模块资料V4.1_ECG/测试连接/人体3导线连接示意图.JPG
