Serendipity-min/medical-multi-parameter-monitor/ADS1292R模块资料V4.1_ECG/测试连接/使用本店STM32F103核心板/上位机显示时，ADS1292模块和本店STM32F103核心板连接示意图.jpg

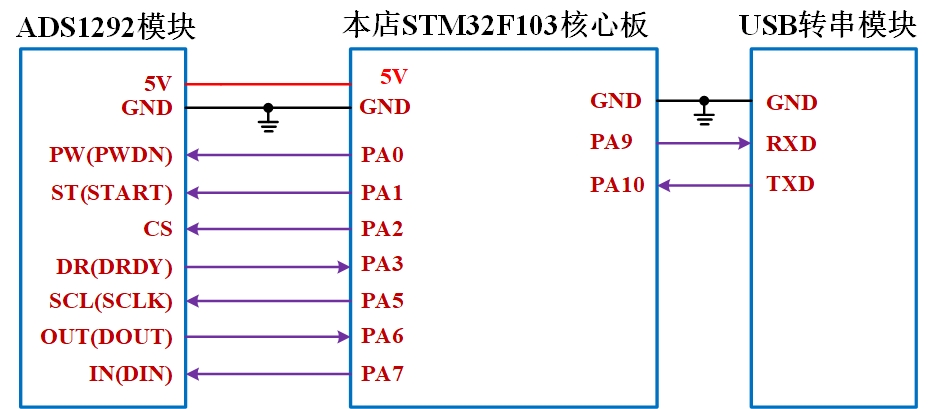
ADS1292R模块资料V4.1_ECG/测试连接/使用本店STM32F103核心板/上位机显示时，ADS1292模块和本店STM32F103核心板连接示意图.jpg
