Serendipity-min/medical-multi-parameter-monitor/ADS1292R模块资料V4.1_ECG/测试连接/使用本店STM32F103核心板/心电模拟器+F103+液晶显示.jpg

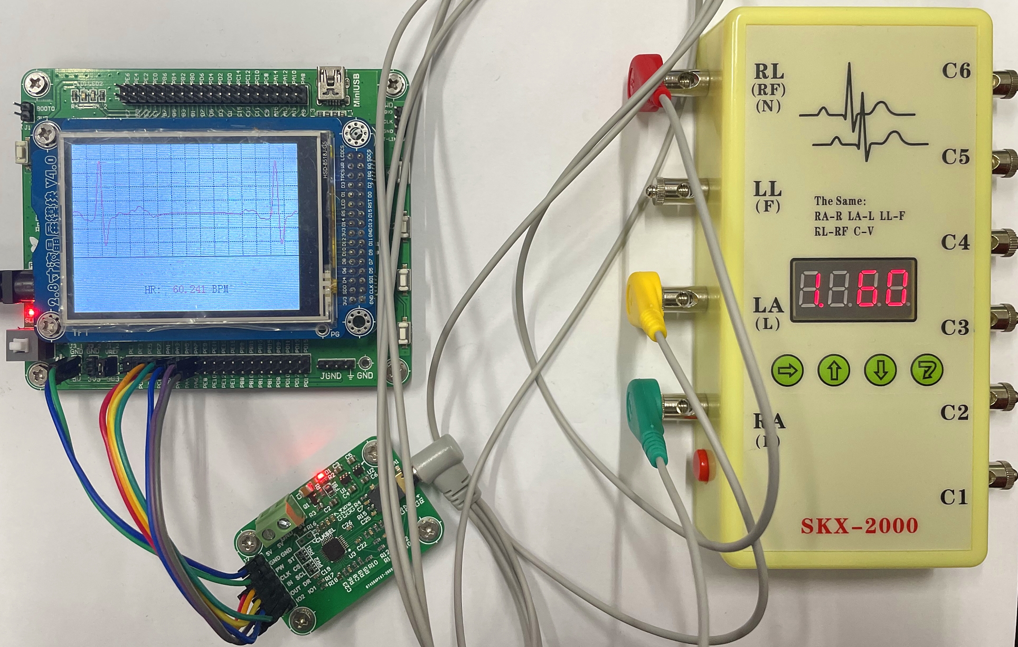
ADS1292R模块资料V4.1_ECG/测试连接/使用本店STM32F103核心板/心电模拟器+F103+液晶显示.jpg
