Serendipity-min/medical-multi-parameter-monitor/ADS1292R模块资料V4.1_ECG/测试连接/使用本店WinnerI开发板-STM32F429/ADS1292模块和本店WinnerI开发板连接示意图.jpg

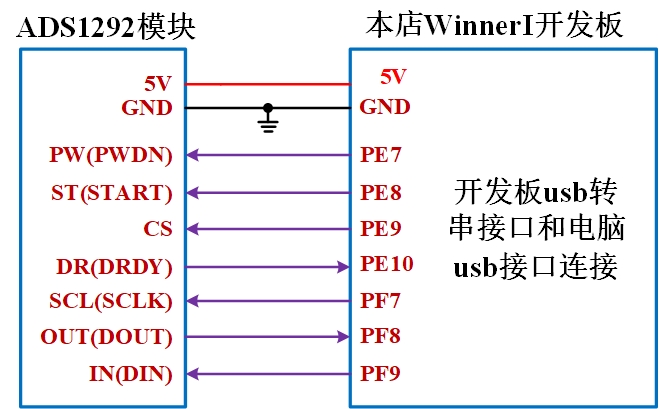
ADS1292R模块资料V4.1_ECG/测试连接/使用本店WinnerI开发板-STM32F429/ADS1292模块和本店WinnerI开发板连接示意图.jpg
