Serendipity-min/medical-multi-parameter-monitor/ADS1292R模块资料V4.1_ECG/测试连接/使用本店WinnerI开发板-STM32F429/上位机软件查看心电模拟器连接-F429.jpg

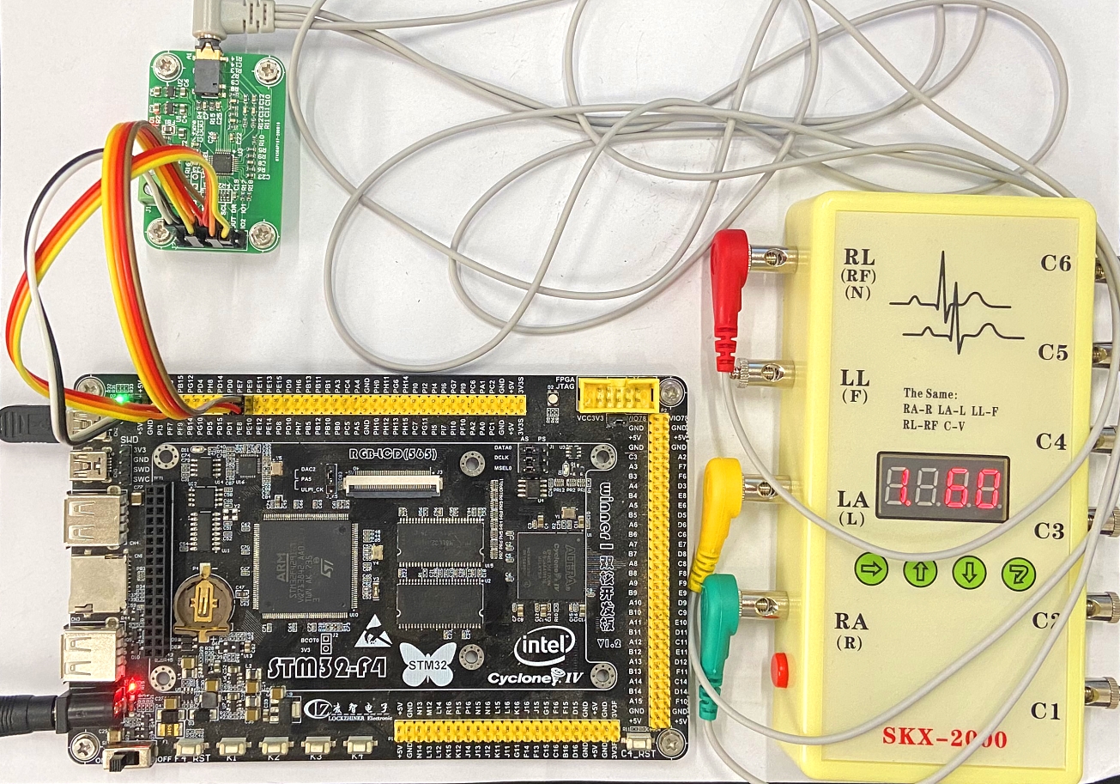
ADS1292R模块资料V4.1_ECG/测试连接/使用本店WinnerI开发板-STM32F429/上位机软件查看心电模拟器连接-F429.jpg
