Serendipity-min/medical-multi-parameter-monitor/cloud/evidence/mqtt-v07/public-live.png

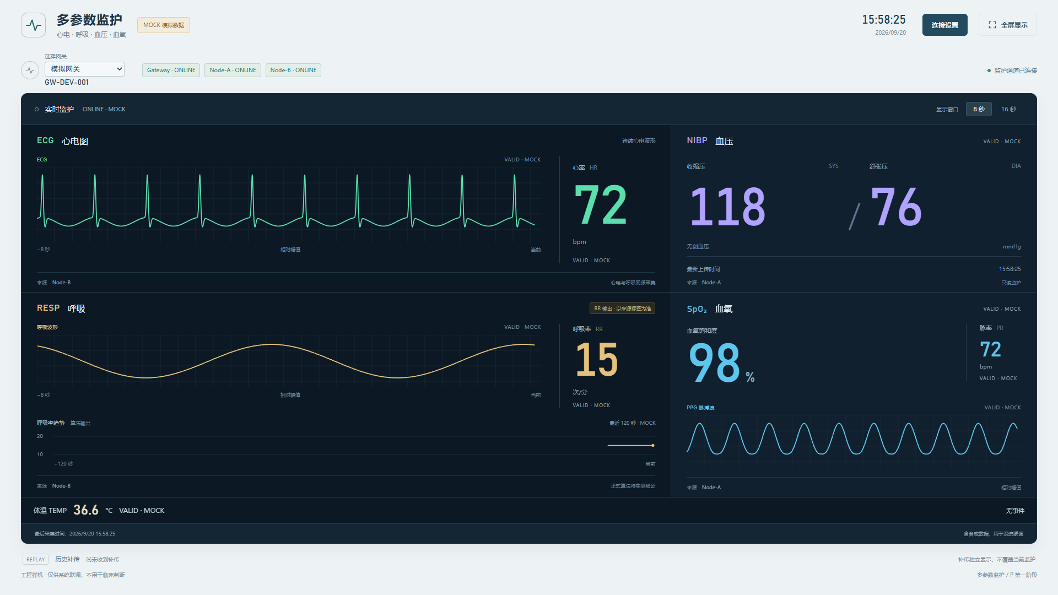
cloud/evidence/mqtt-v07/public-live.png
