Serendipity-min/medical-multi-parameter-monitor/cloud/evidence/pr2-review1/public-live.png

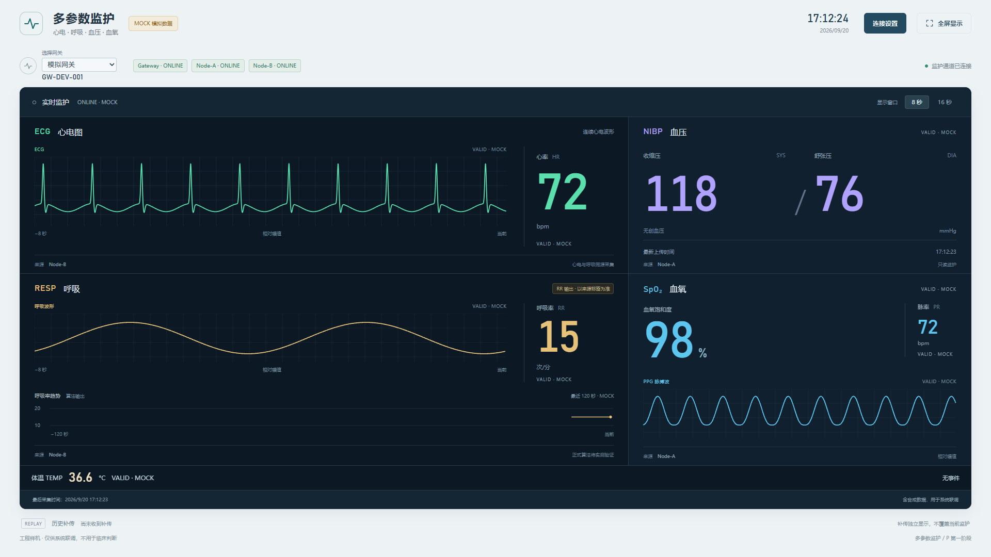
cloud/evidence/pr2-review1/public-live.png
