Serendipity-min/medical-multi-parameter-monitor/cloud/evidence/public-live.png

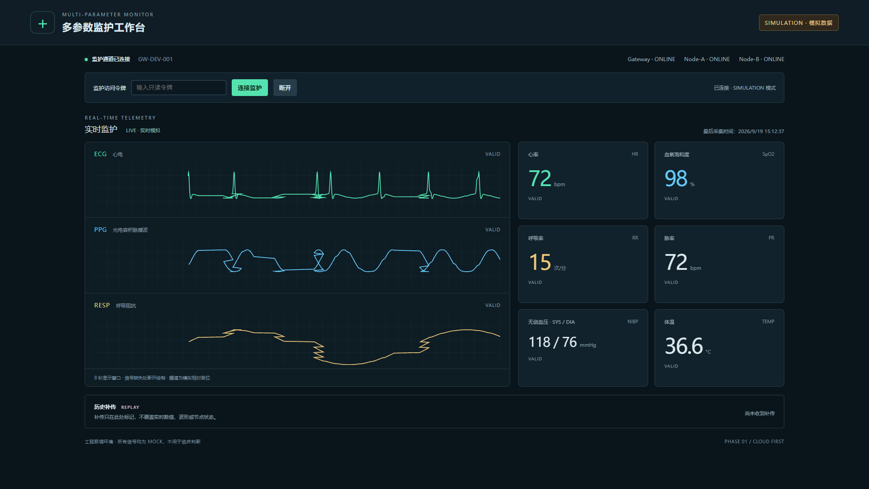
cloud/evidence/public-live.png
