Serendipity-min/medical-multi-parameter-monitor/cloud/evidence/stitch-ui-auth/local/connected-frozen.png

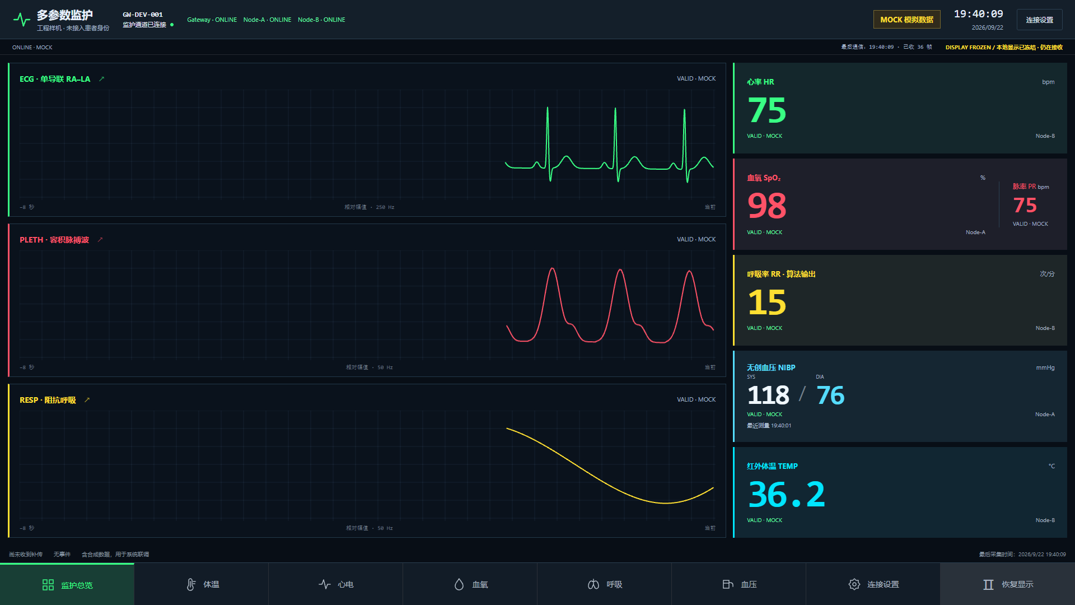
cloud/evidence/stitch-ui-auth/local/connected-frozen.png
