Serendipity-min/medical-multi-parameter-monitor/cloud/evidence/stitch-ui-auth/local/invalid-token-fullscreen.png

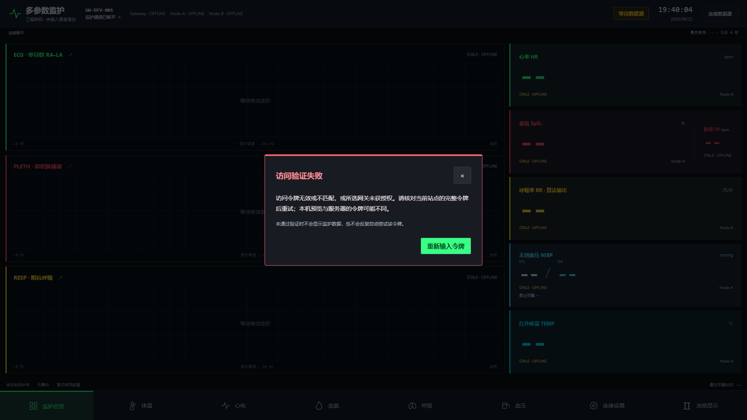
cloud/evidence/stitch-ui-auth/local/invalid-token-fullscreen.png
