Serendipity-min/medical-multi-parameter-monitor/cloud/evidence/stitch-ui-auth/server/connected-frozen.png

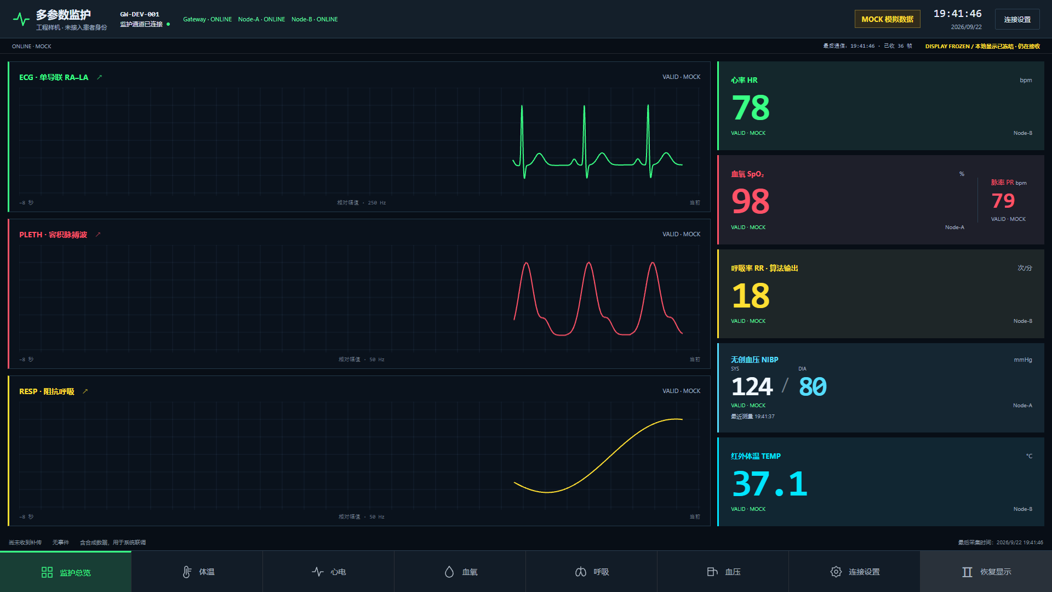
cloud/evidence/stitch-ui-auth/server/connected-frozen.png
