Serendipity-min/medical-multi-parameter-monitor/cloud/evidence/stitch-ui-final/interaction/fullscreen-disconnected.png

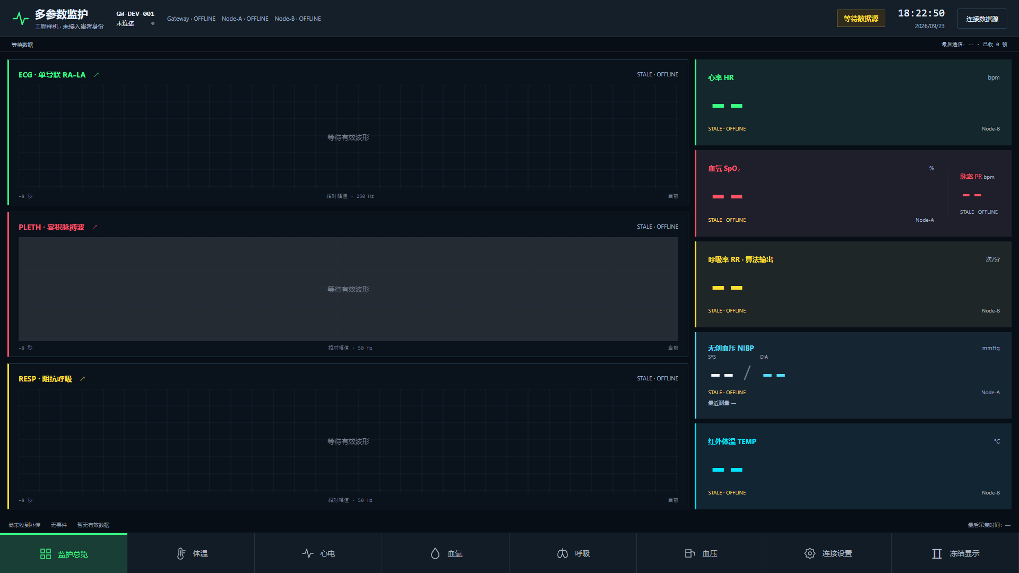
cloud/evidence/stitch-ui-final/interaction/fullscreen-disconnected.png
