Serendipity-min/medical-multi-parameter-monitor/cloud/evidence/stitch-ui-final/interaction/temp-390x844.png

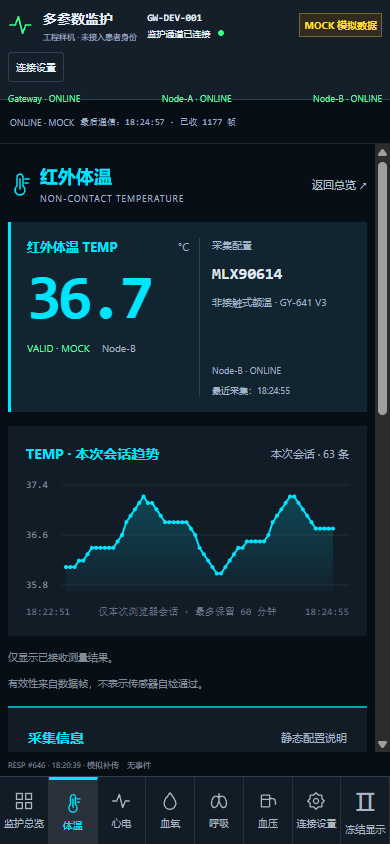
cloud/evidence/stitch-ui-final/interaction/temp-390x844.png
