Serendipity-min/medical-multi-parameter-monitor/cloud/evidence/stitch-ui-final/interaction/temp-1280x720.png

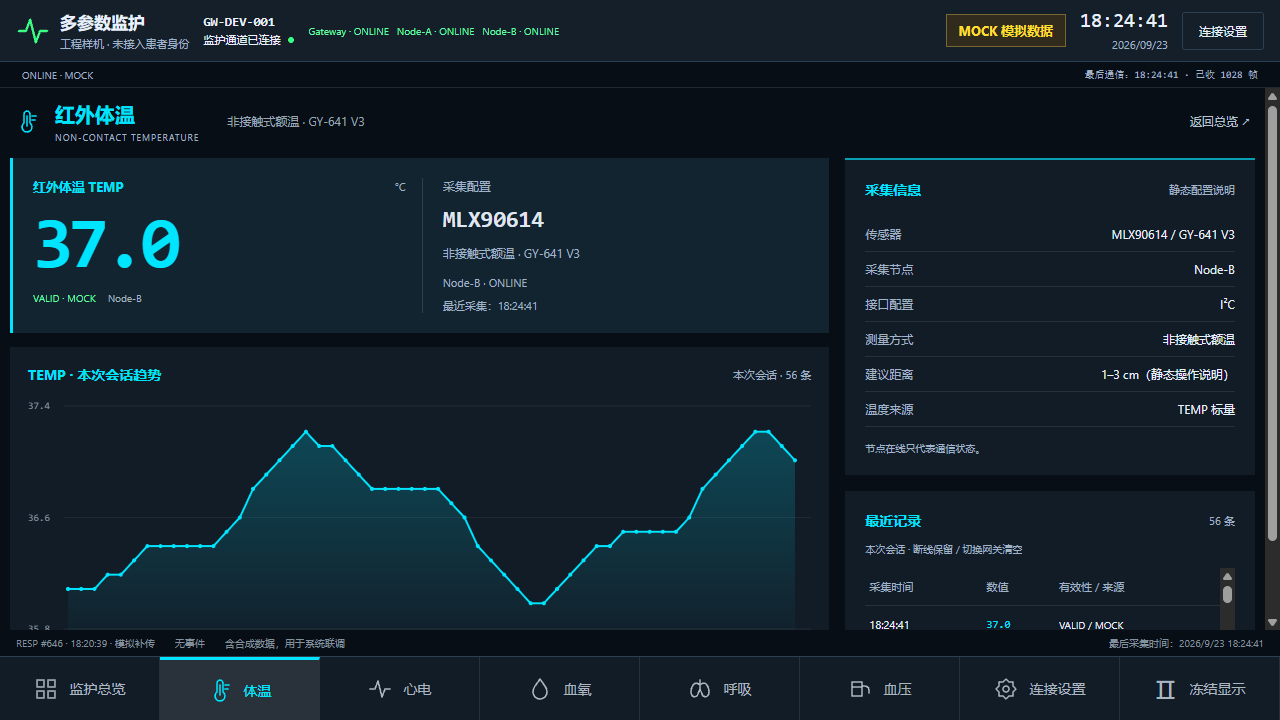
cloud/evidence/stitch-ui-final/interaction/temp-1280x720.png
