Serendipity-min/medical-multi-parameter-monitor/cloud/evidence/stitch-ui-final/interaction/temp-1366x768.png

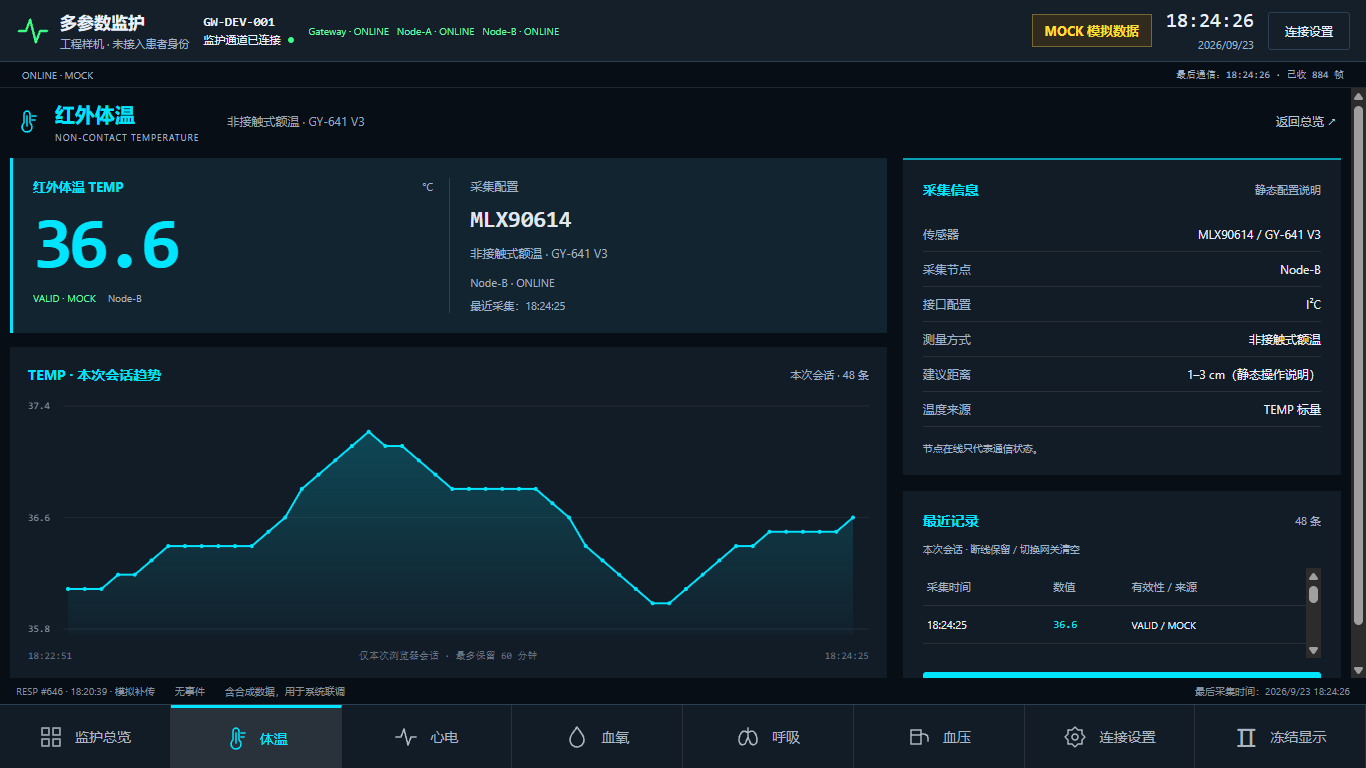
cloud/evidence/stitch-ui-final/interaction/temp-1366x768.png
