Serendipity-min/medical-multi-parameter-monitor/cloud/evidence/stitch-ui-final/interaction/temp-2560x1440.png

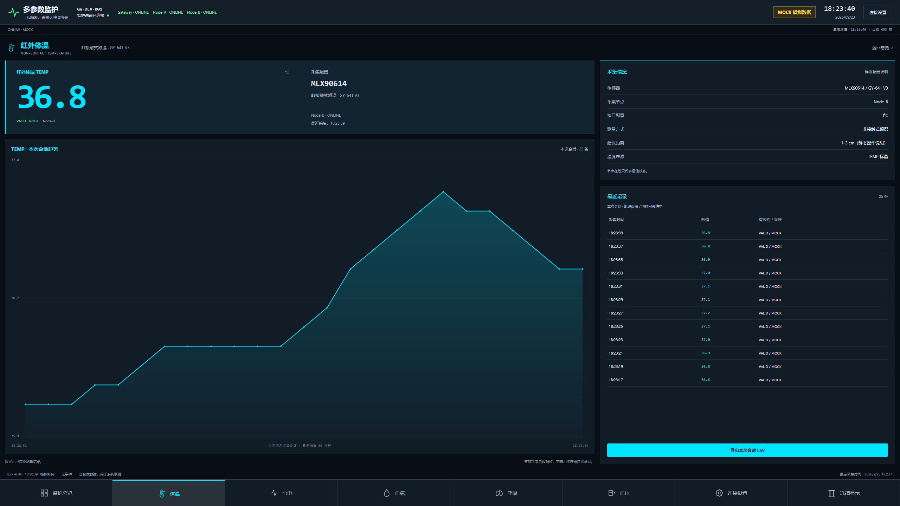
cloud/evidence/stitch-ui-final/interaction/temp-2560x1440.png
