Serendipity-min/medical-multi-parameter-monitor/cloud/evidence/stitch-ui-final/regression/nibp-varied.png

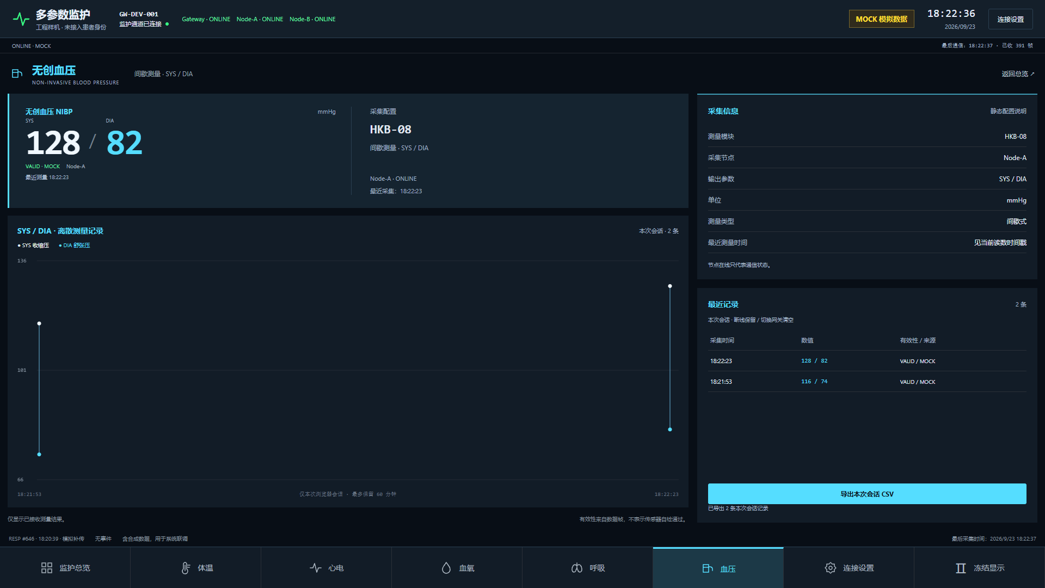
cloud/evidence/stitch-ui-final/regression/nibp-varied.png
