Serendipity-min/medical-multi-parameter-monitor/cloud/evidence/stitch-ui-final/regression/node-a-offline.png

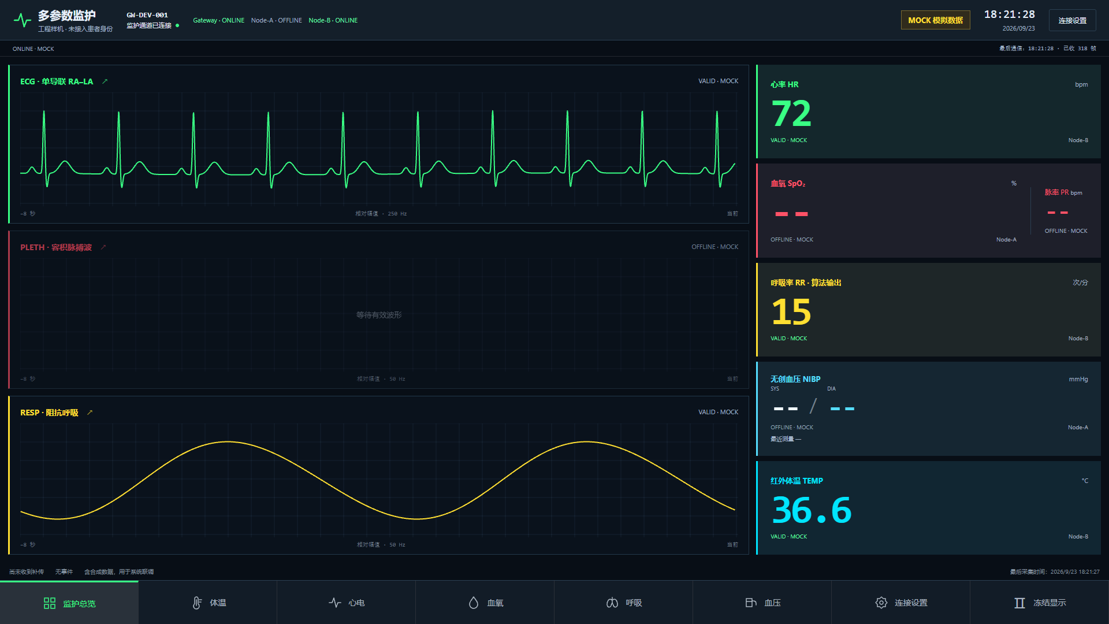
cloud/evidence/stitch-ui-final/regression/node-a-offline.png
