Serendipity-min/medical-multi-parameter-monitor/cloud/evidence/stitch-ui-final/regression/overview-1600x900.png

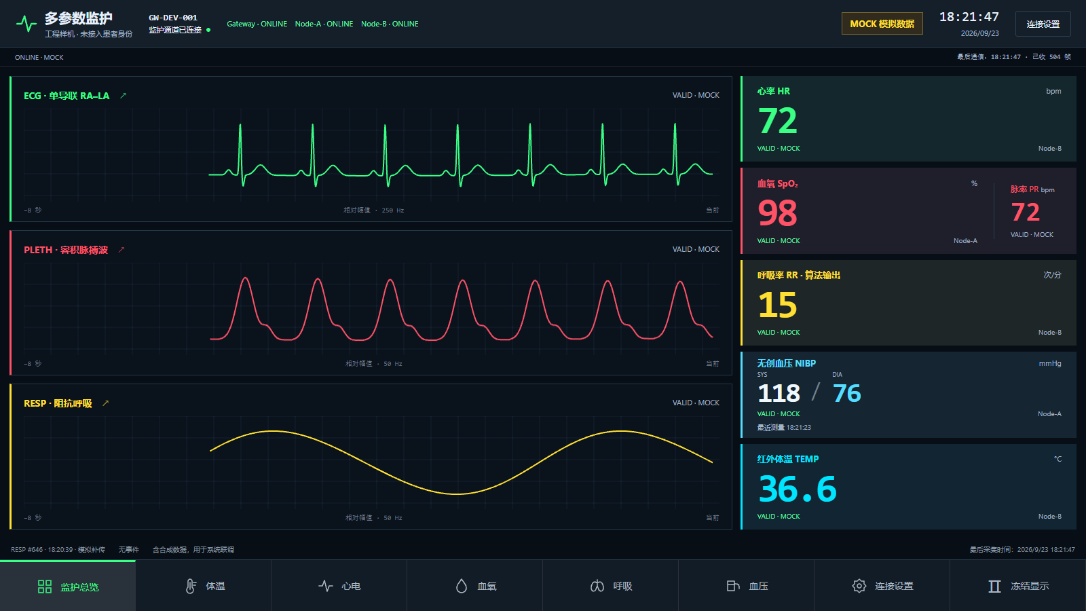
cloud/evidence/stitch-ui-final/regression/overview-1600x900.png
