Serendipity-min/medical-multi-parameter-monitor/cloud/evidence/stitch-ui-final/regression/overview-varied.png

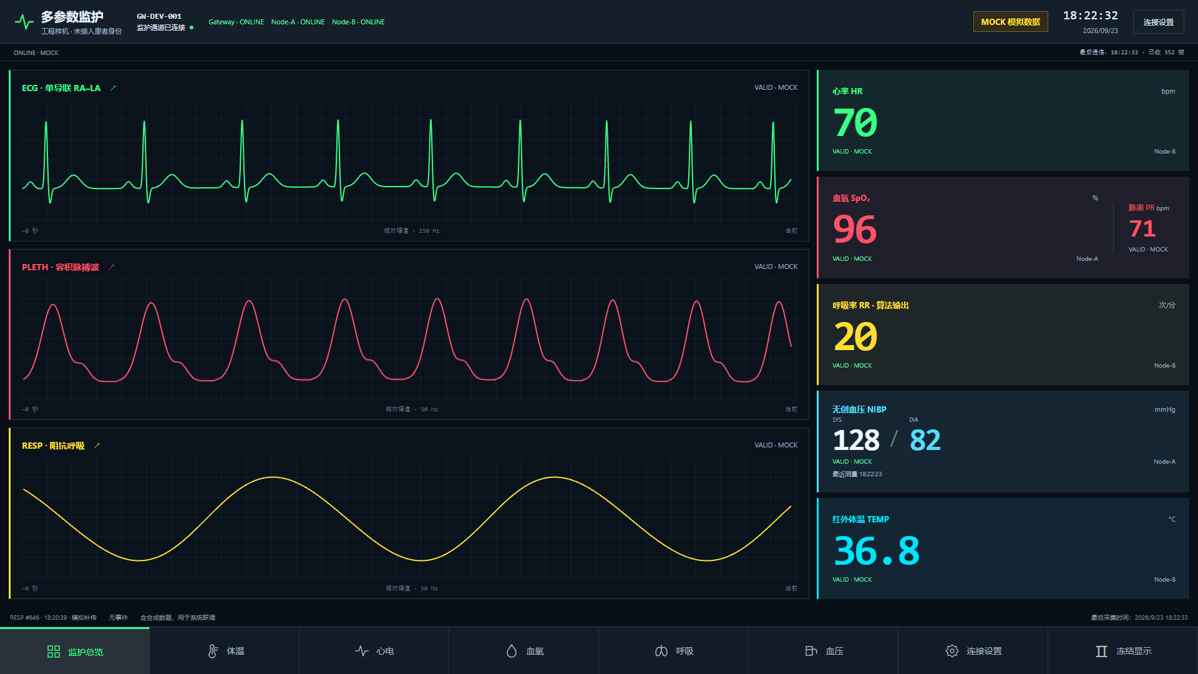
cloud/evidence/stitch-ui-final/regression/overview-varied.png
