Serendipity-min/medical-multi-parameter-monitor/cloud/evidence/stitch-ui-final/regression/resp-1920x1080.png

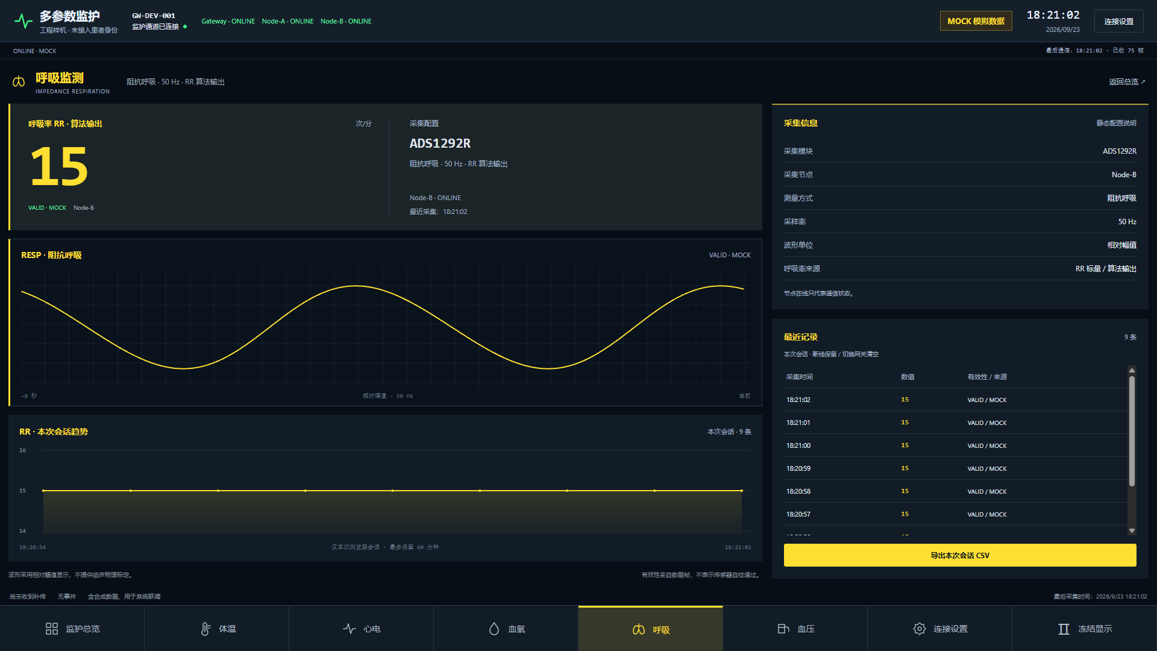
cloud/evidence/stitch-ui-final/regression/resp-1920x1080.png
