Serendipity-min/medical-multi-parameter-monitor/cloud/evidence/stitch-ui-final/regression/spo2-varied.png

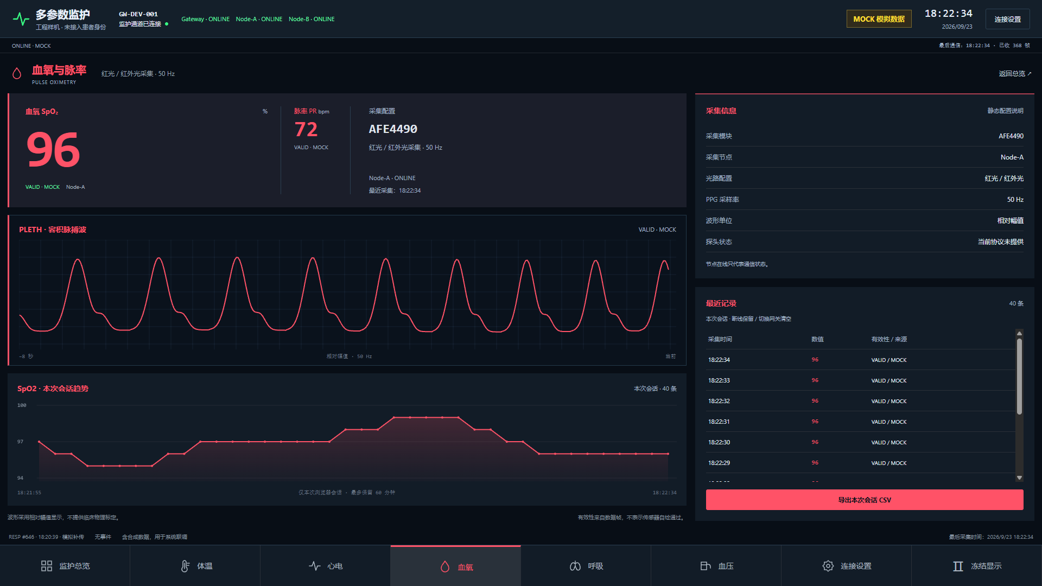
cloud/evidence/stitch-ui-final/regression/spo2-varied.png
