Serendipity-min/medical-multi-parameter-monitor/cloud/evidence/stitch-ui-final/regression/temp-varied.png

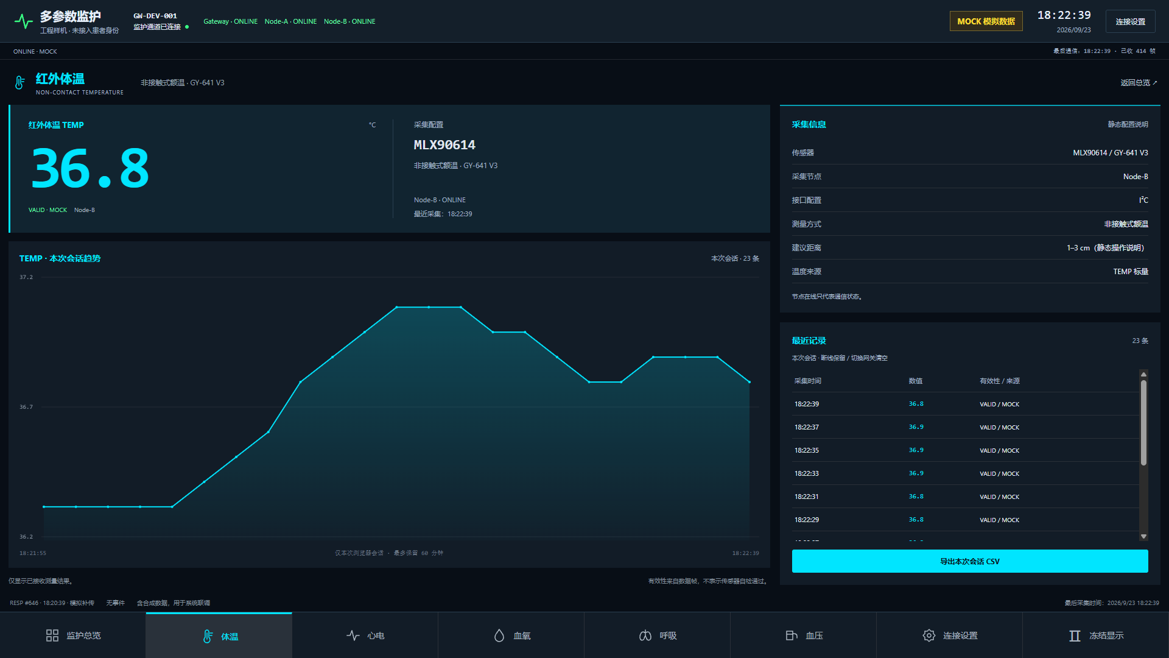
cloud/evidence/stitch-ui-final/regression/temp-varied.png
