Serendipity-min/medical-multi-parameter-monitor/cloud/evidence/stitch-ui-interaction/fullscreen-before.png

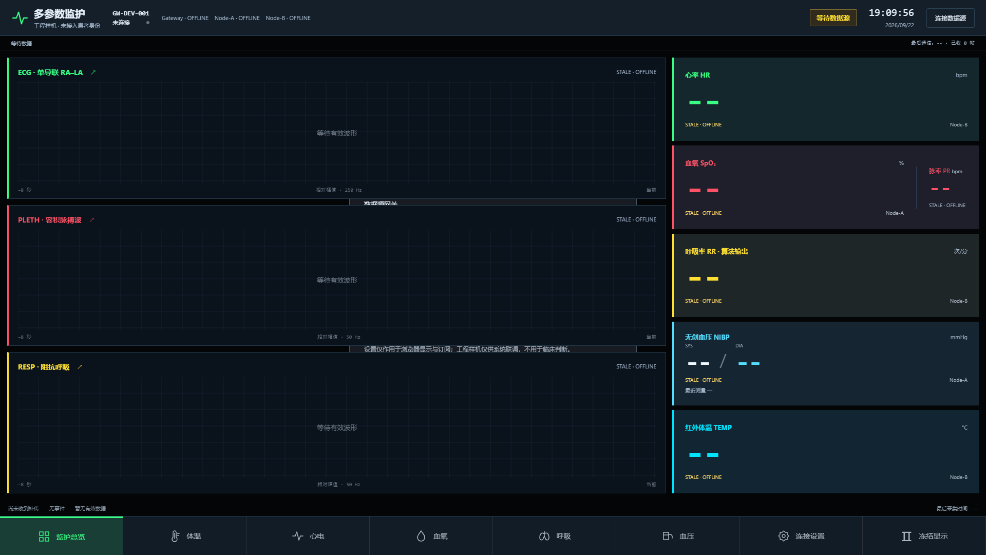
cloud/evidence/stitch-ui-interaction/fullscreen-before.png
