Serendipity-min/medical-multi-parameter-monitor/cloud/evidence/stitch-ui-interaction/local/escape-native-intermediate.png

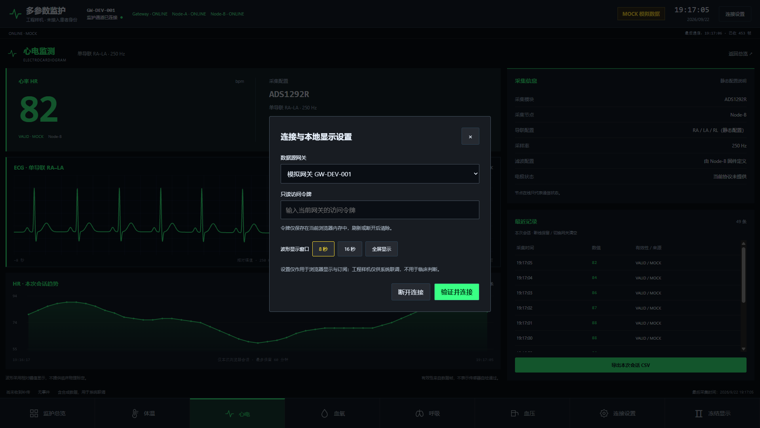
cloud/evidence/stitch-ui-interaction/local/escape-native-intermediate.png
