Serendipity-min/medical-multi-parameter-monitor/cloud/evidence/stitch-ui-interaction/local/temp-390x844.png

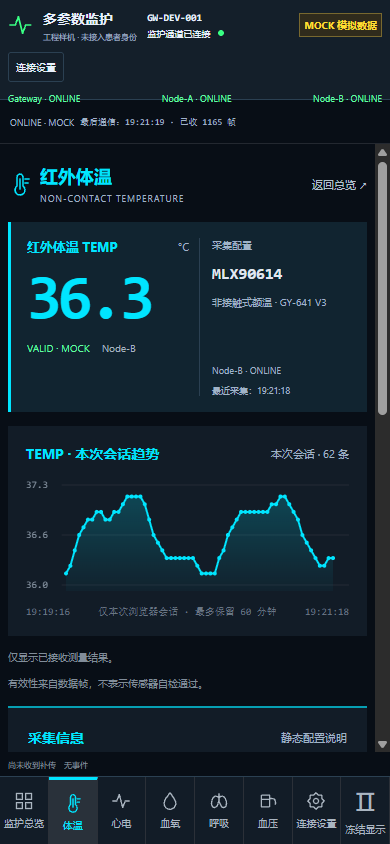
cloud/evidence/stitch-ui-interaction/local/temp-390x844.png
