Serendipity-min/medical-multi-parameter-monitor/cloud/evidence/stitch-ui-interaction/local/temp-1600x900.png

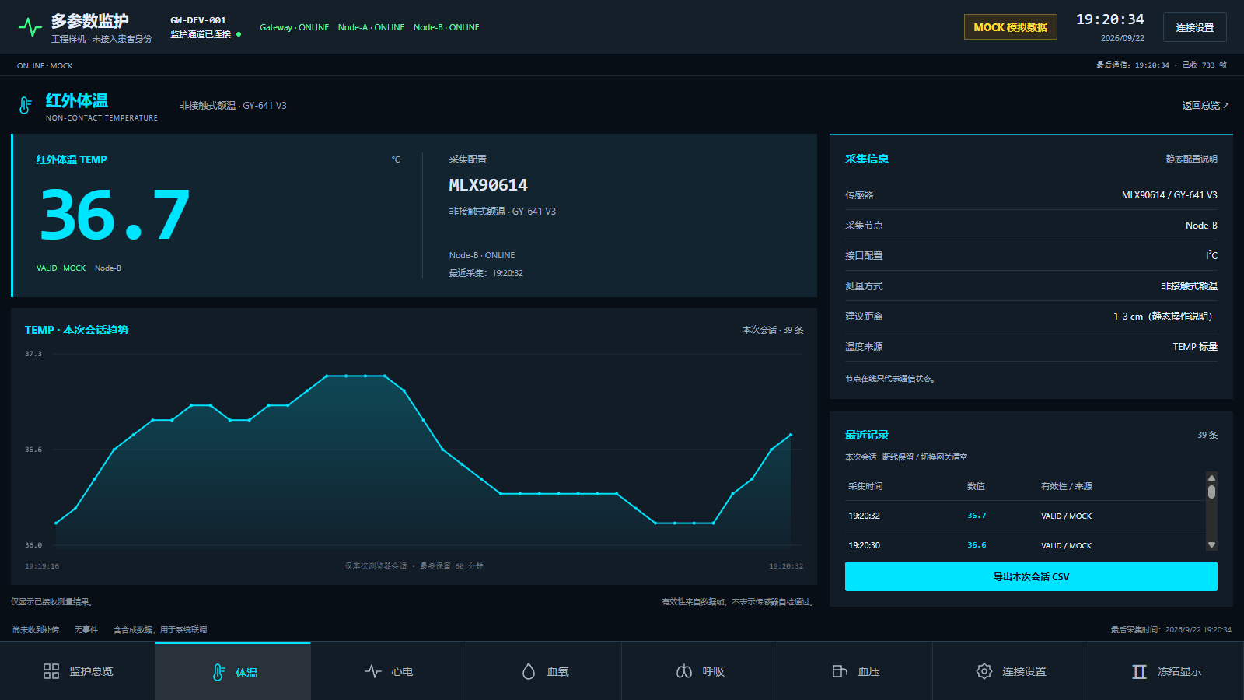
cloud/evidence/stitch-ui-interaction/local/temp-1600x900.png
