Serendipity-min/medical-multi-parameter-monitor/cloud/evidence/stitch-ui-interaction/regression/overview-1366x768.png

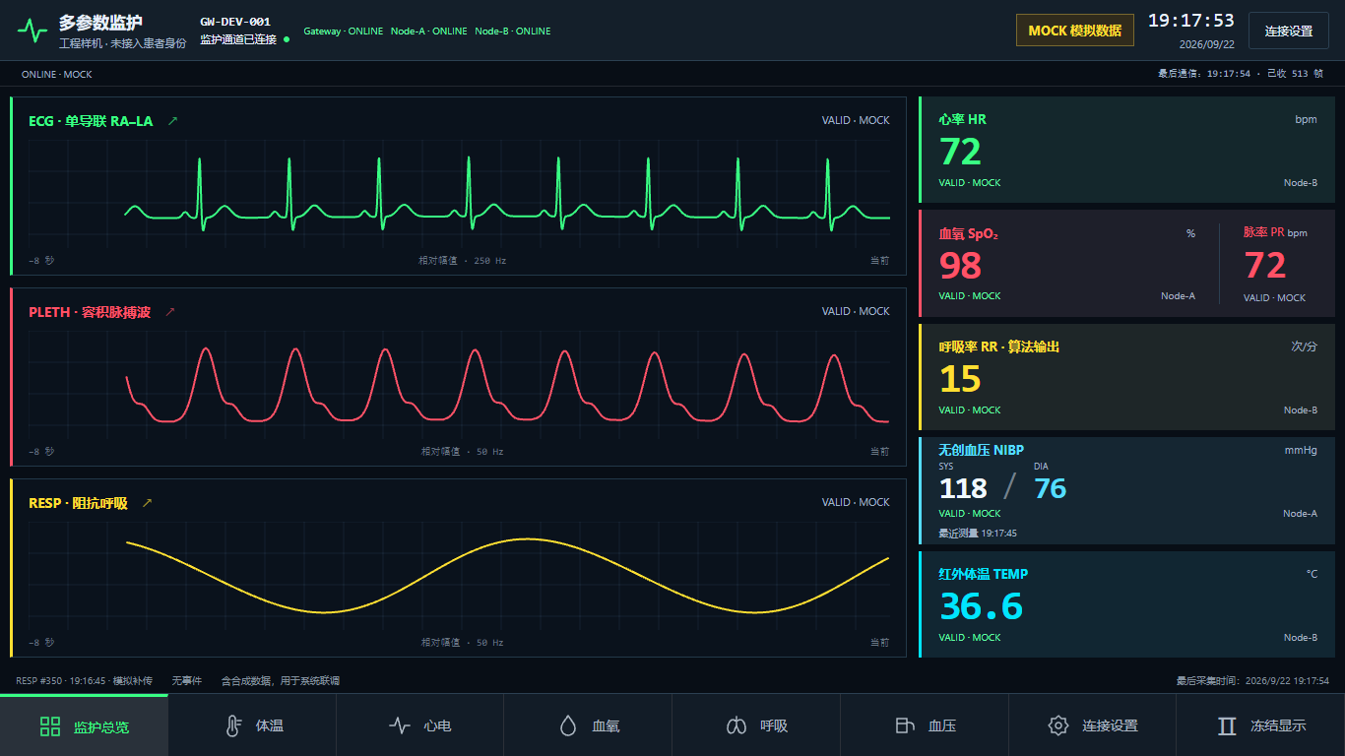
cloud/evidence/stitch-ui-interaction/regression/overview-1366x768.png
