Serendipity-min/medical-multi-parameter-monitor/cloud/evidence/stitch-ui-interaction/regression/overview-varied.png

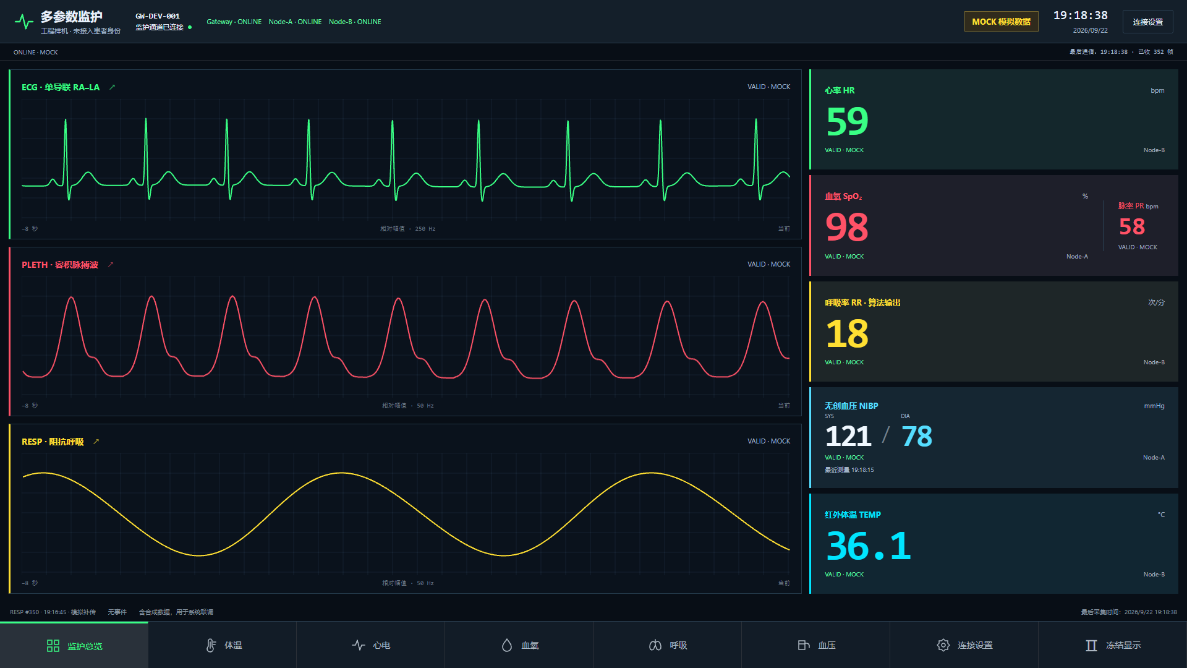
cloud/evidence/stitch-ui-interaction/regression/overview-varied.png
