Serendipity-min/medical-multi-parameter-monitor/cloud/evidence/stitch-ui-interaction/regression/resp-varied.png

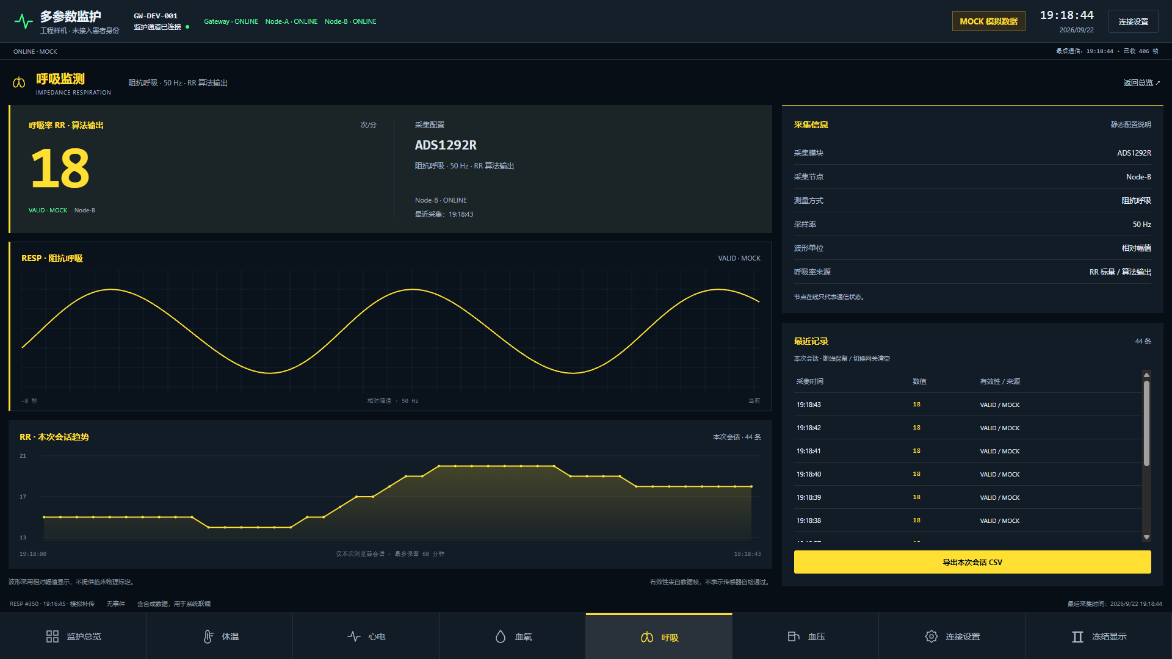
cloud/evidence/stitch-ui-interaction/regression/resp-varied.png
