Serendipity-min/medical-multi-parameter-monitor/cloud/evidence/stitch-ui-interaction/regression/temp-1920x1080.png

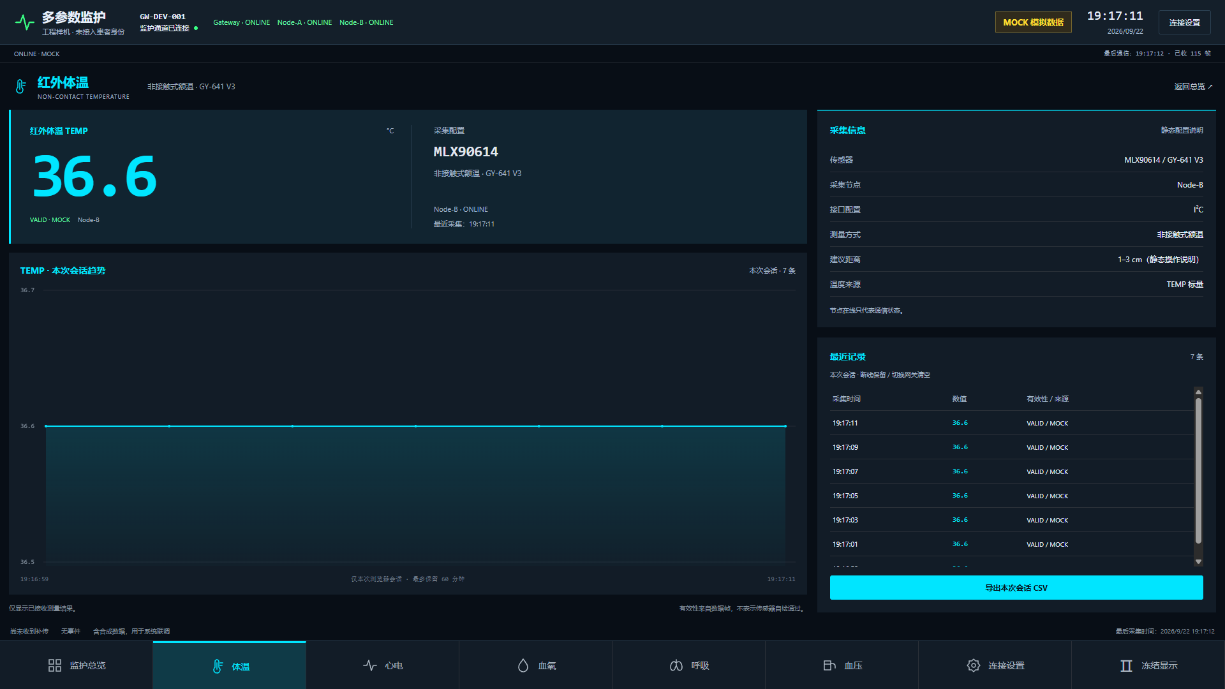
cloud/evidence/stitch-ui-interaction/regression/temp-1920x1080.png
