Serendipity-min/medical-multi-parameter-monitor/cloud/evidence/stitch-ui-interaction/server/temp-1280x720.png

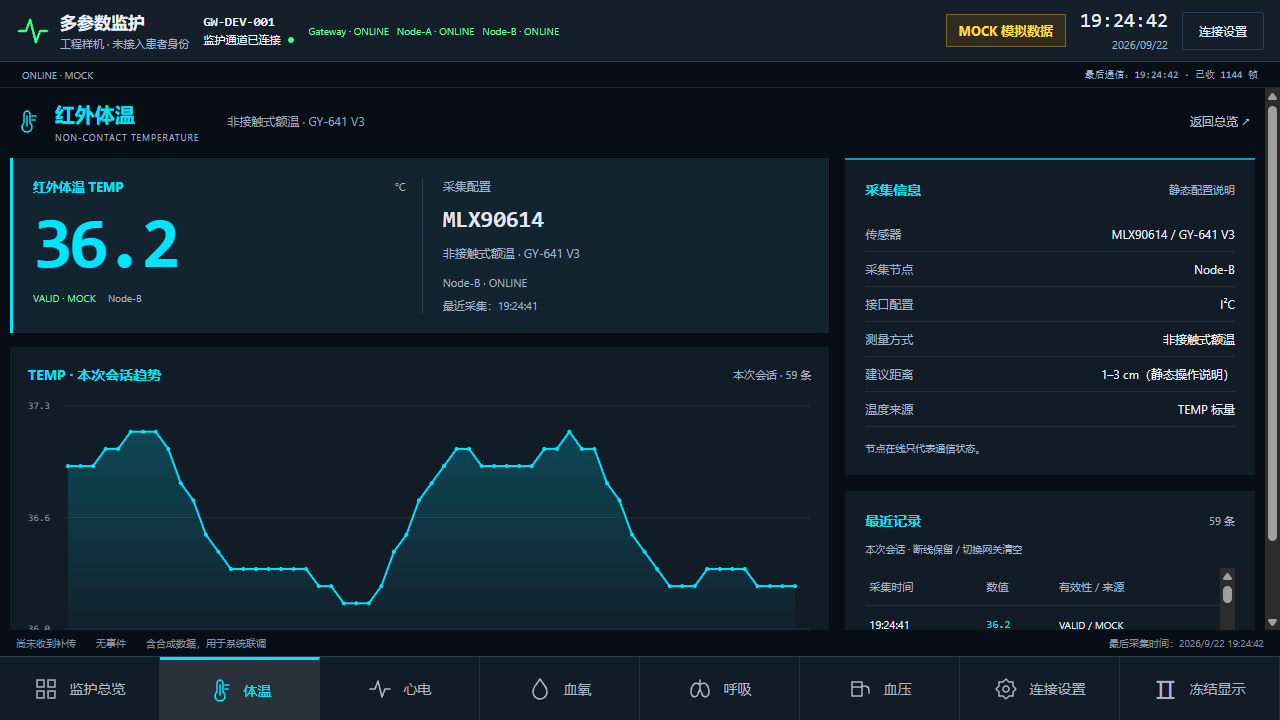
cloud/evidence/stitch-ui-interaction/server/temp-1280x720.png
