Serendipity-min/medical-multi-parameter-monitor/cloud/evidence/stitch-ui-v2/node-a-offline.png

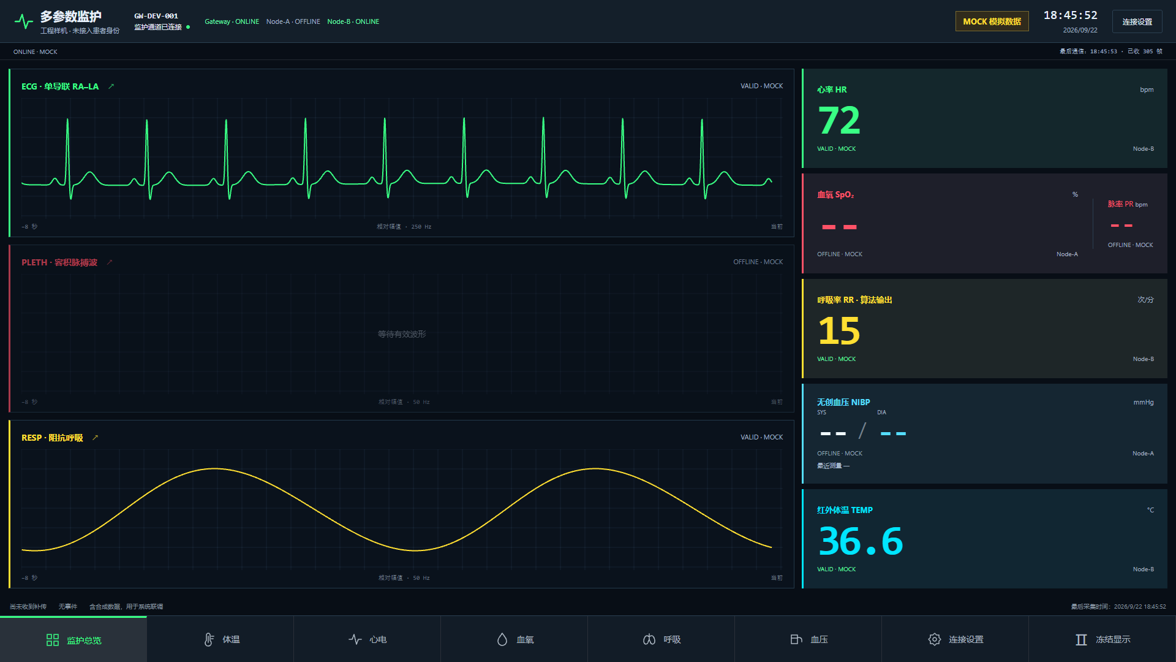
cloud/evidence/stitch-ui-v2/node-a-offline.png
