Serendipity-min/medical-multi-parameter-monitor/cloud/evidence/stitch-ui-v2/overview-varied.png

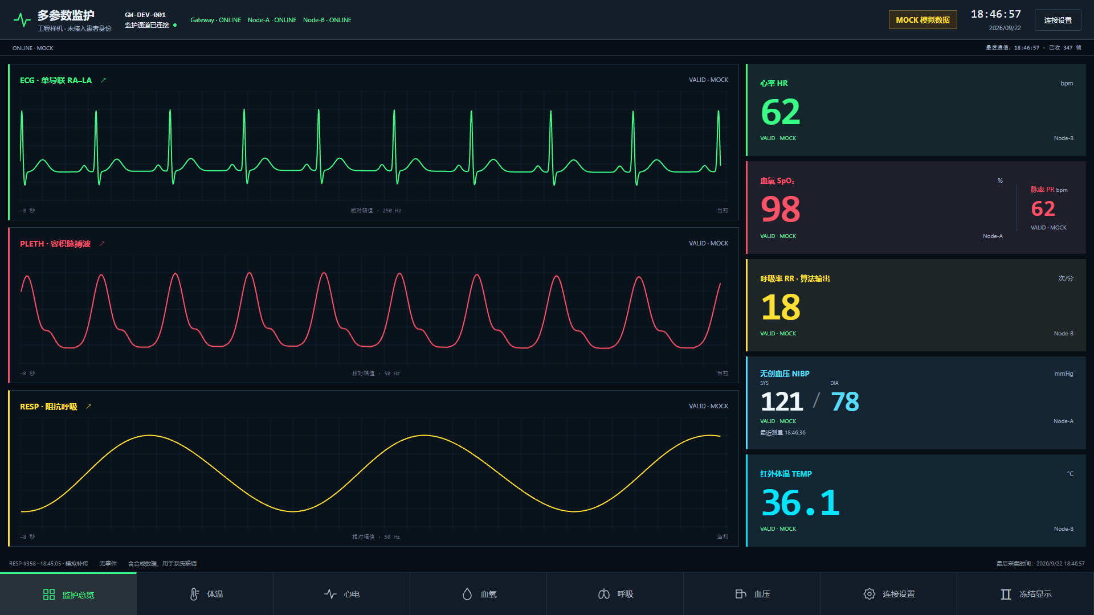
cloud/evidence/stitch-ui-v2/overview-varied.png
