Serendipity-min/medical-multi-parameter-monitor/cloud/evidence/stitch-ui-v2/resp-varied.png

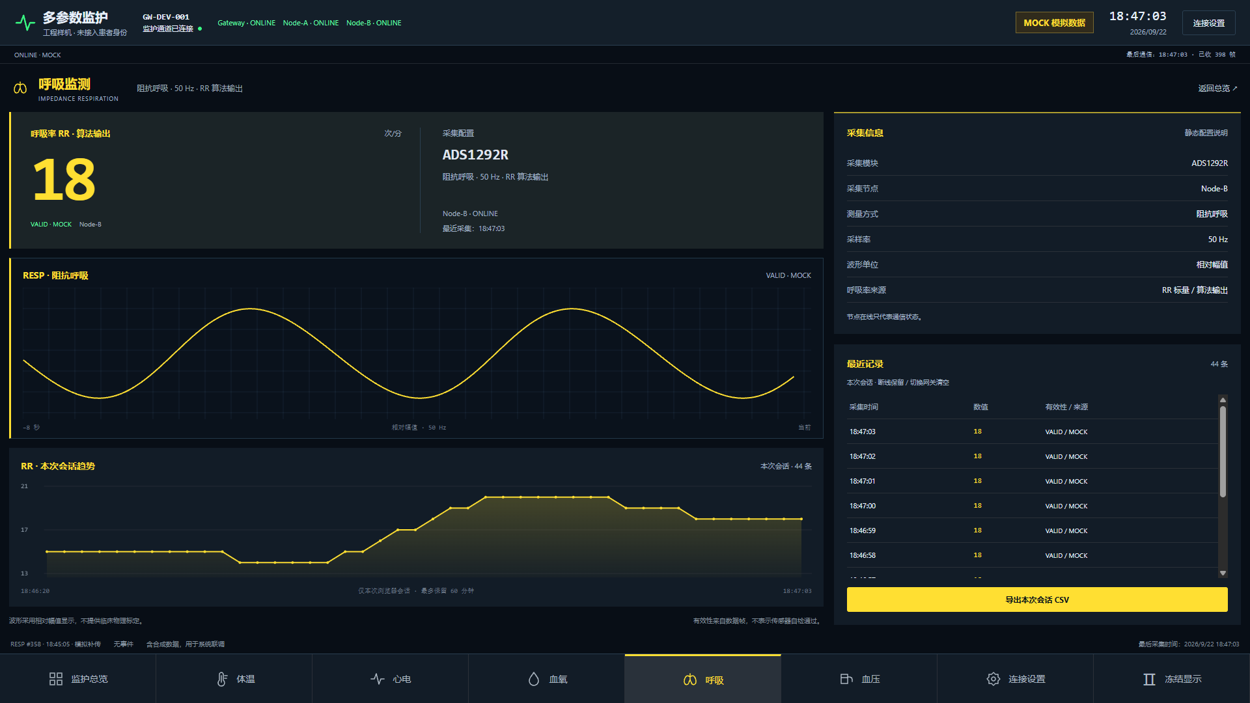
cloud/evidence/stitch-ui-v2/resp-varied.png
