Serendipity-min/medical-multi-parameter-monitor/cloud/evidence/stitch-ui-v2/spo2-varied.png

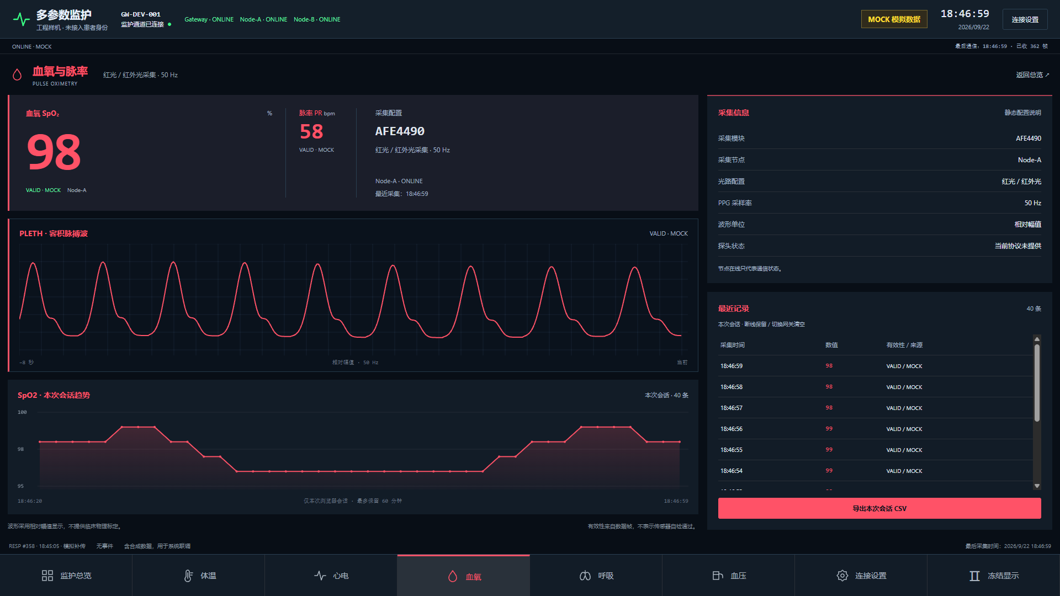
cloud/evidence/stitch-ui-v2/spo2-varied.png
