Serendipity-min/medical-multi-parameter-monitor/cloud/evidence/ui-redesign-local/public-live.png

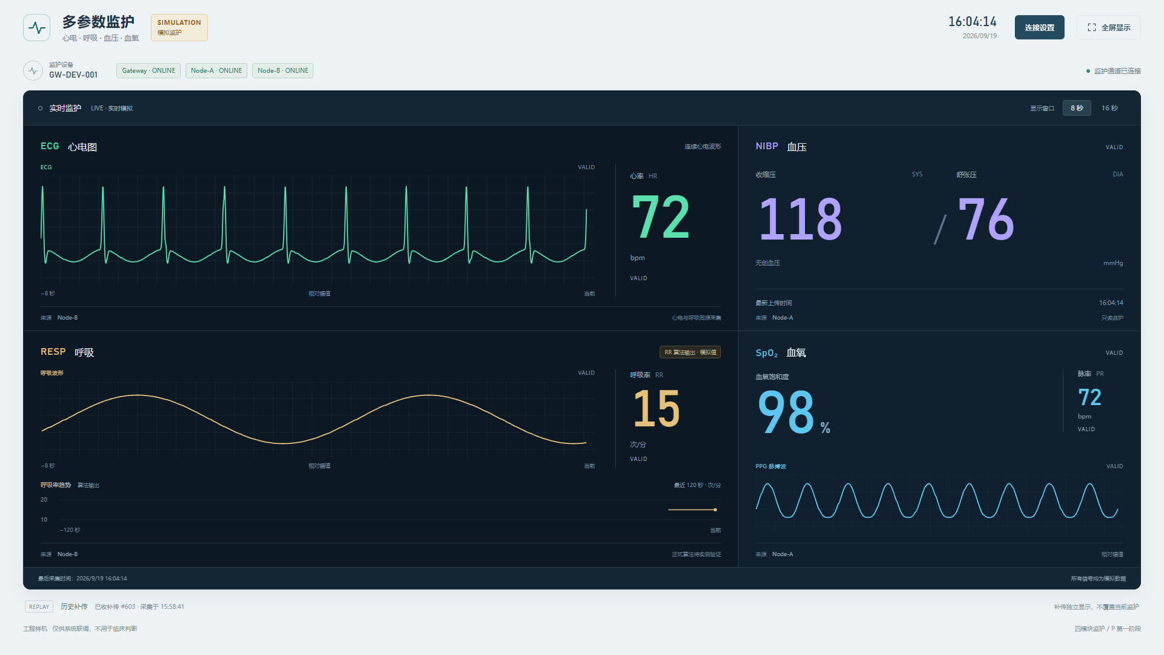
cloud/evidence/ui-redesign-local/public-live.png
