Serendipity-min/medical-multi-parameter-monitor/cloud/evidence/ui-redesign-local/public-replay.png

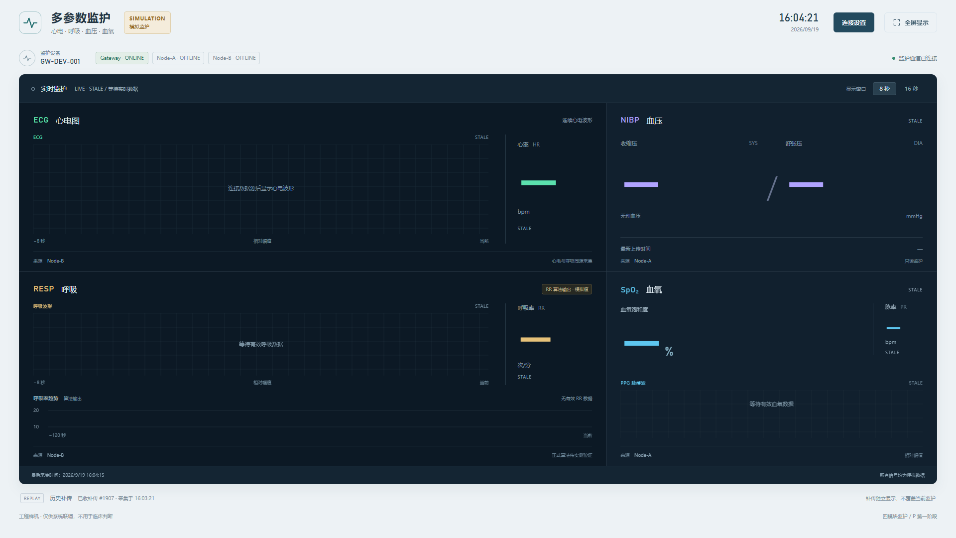
cloud/evidence/ui-redesign-local/public-replay.png
