Serendipity-min/medical-multi-parameter-monitor/cloud/evidence/ui-redesign-public/public-mobile.png

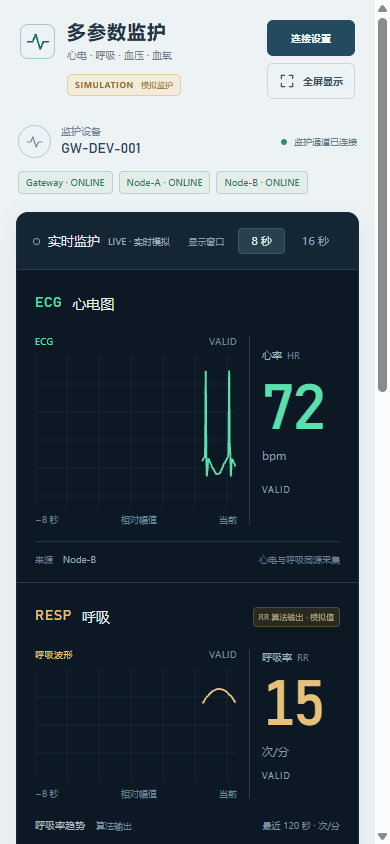
cloud/evidence/ui-redesign-public/public-mobile.png
