Serendipity-min/medical-multi-parameter-monitor/cloud/evidence/ui-v07/1366x768.png

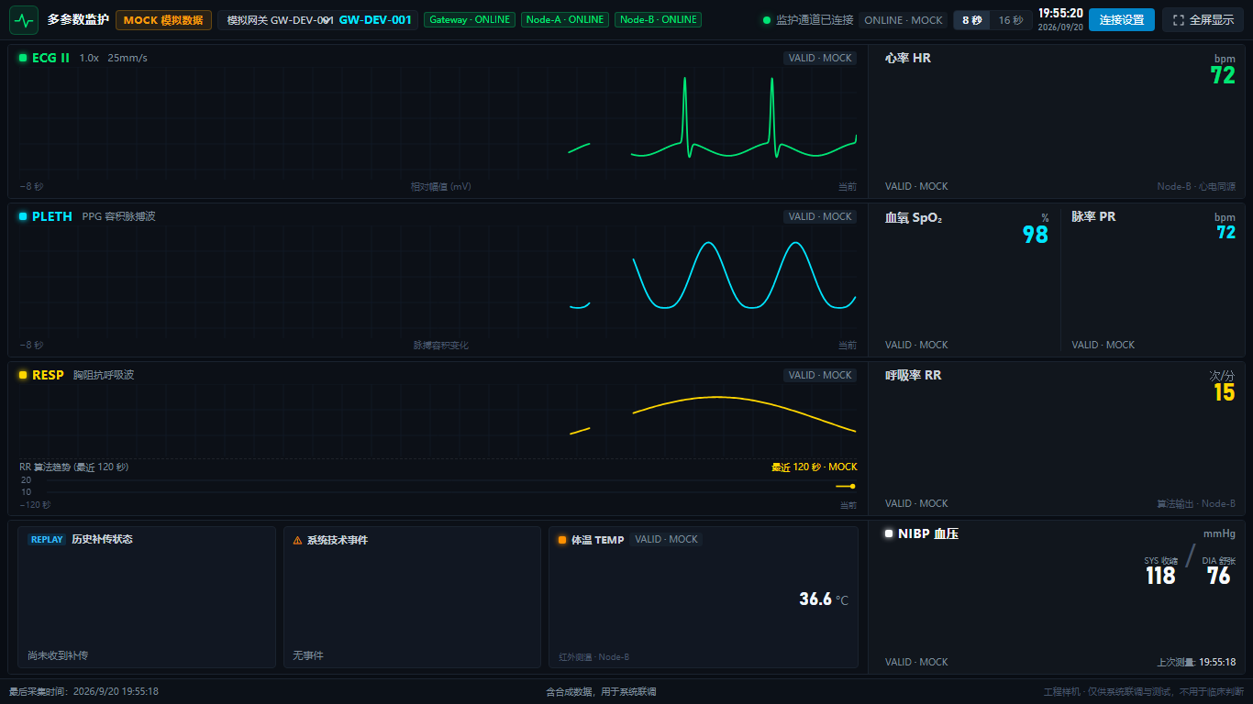
cloud/evidence/ui-v07/1366x768.png
