Serendipity-min/medical-multi-parameter-monitor/cloud/evidence/ui-v07/1920x1080-node-b-offline.png

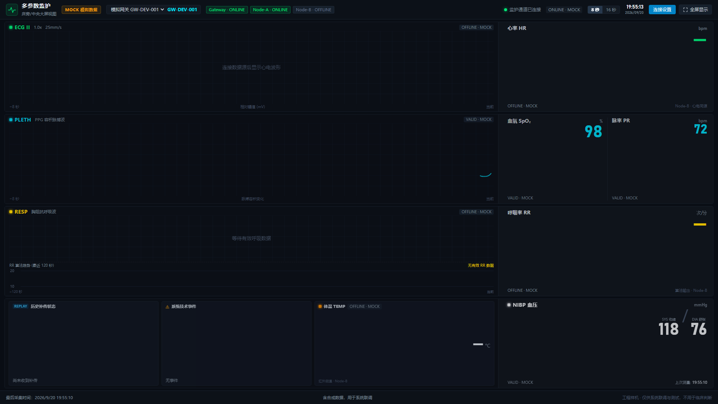
cloud/evidence/ui-v07/1920x1080-node-b-offline.png
