Serendipity-min/medical-multi-parameter-monitor/node-b/docs/FIVE-NODE-MIGRATION/06-CAN-Breadboard.png

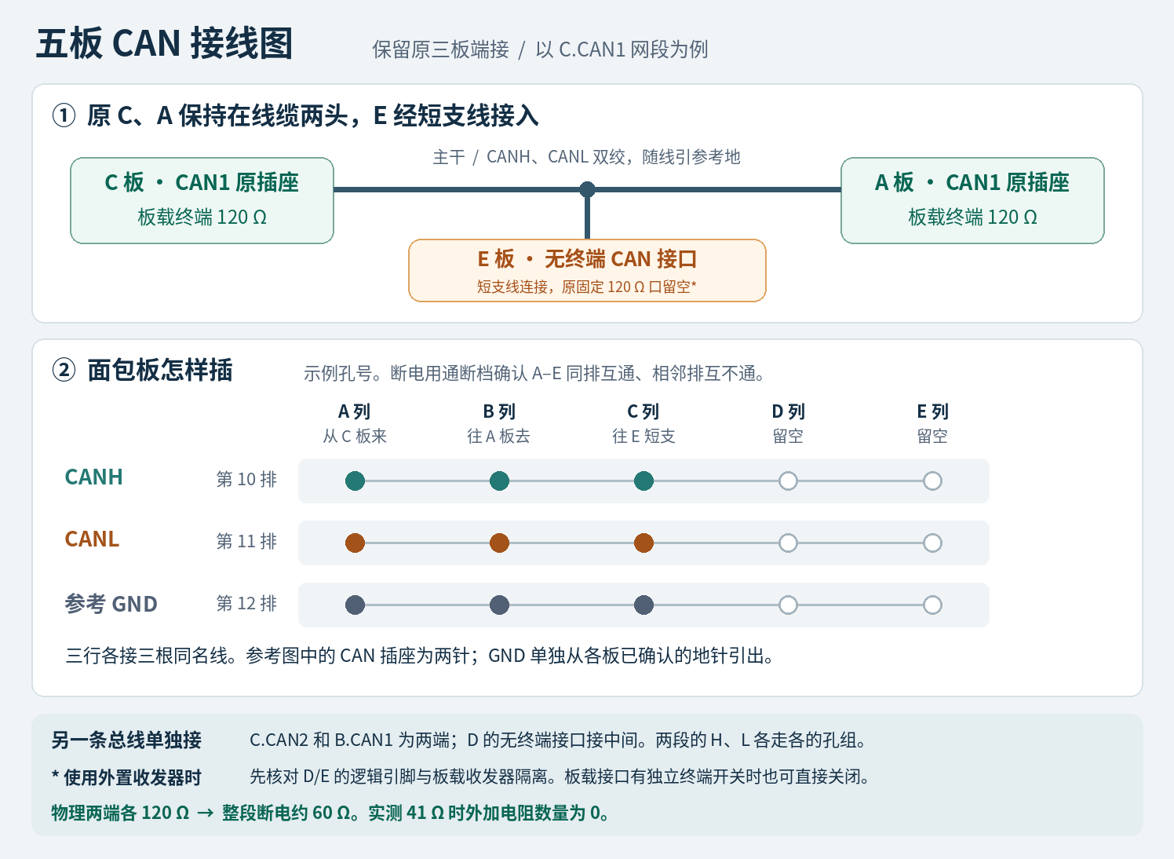
node-b/docs/FIVE-NODE-MIGRATION/06-CAN-Breadboard.png
