Serendipity-min/medical-multi-parameter-monitor/node-b/docs/FIVE-NODE-MIGRATION/FIVE41-20261106/browser/ECG60-E-90s-stale.png

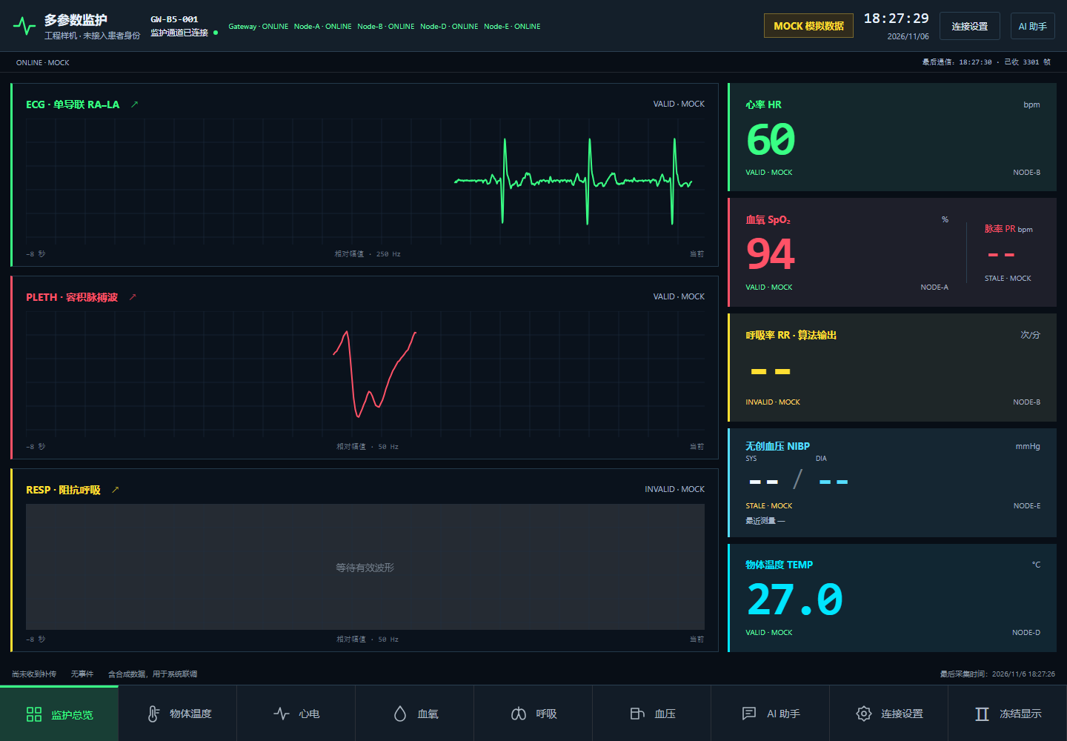
node-b/docs/FIVE-NODE-MIGRATION/FIVE41-20261106/browser/ECG60-E-90s-stale.png
