Serendipity-min/medical-multi-parameter-monitor/node-b/docs/FIVE-NODE-MIGRATION/M1-20261104/browser/five-node-expired.png

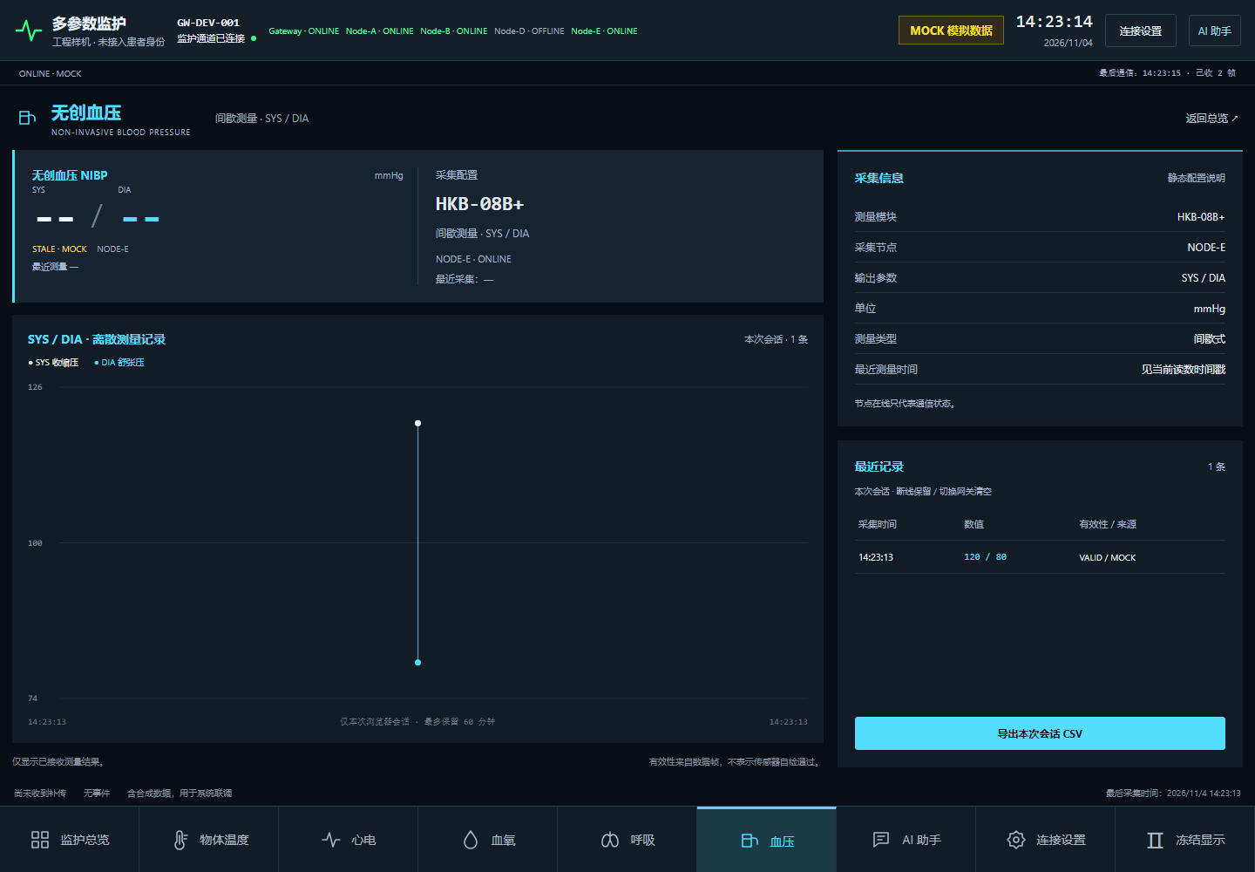
node-b/docs/FIVE-NODE-MIGRATION/M1-20261104/browser/five-node-expired.png
