Serendipity-min/medical-multi-parameter-monitor/node-b/docs/PI-REVIEW/r16-hardware/board-p4-pf6.png

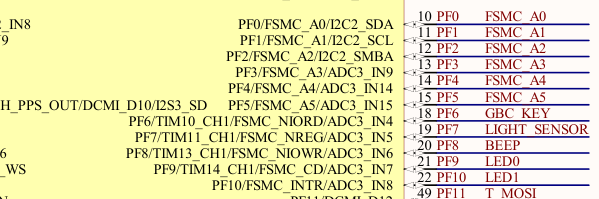
node-b/docs/PI-REVIEW/r16-hardware/board-p4-pf6.png
