Serendipity-min/medical-multi-parameter-monitor/node-b/docs/PI-REVIEW/R61-WAY-RUN4-HR-20261112.png

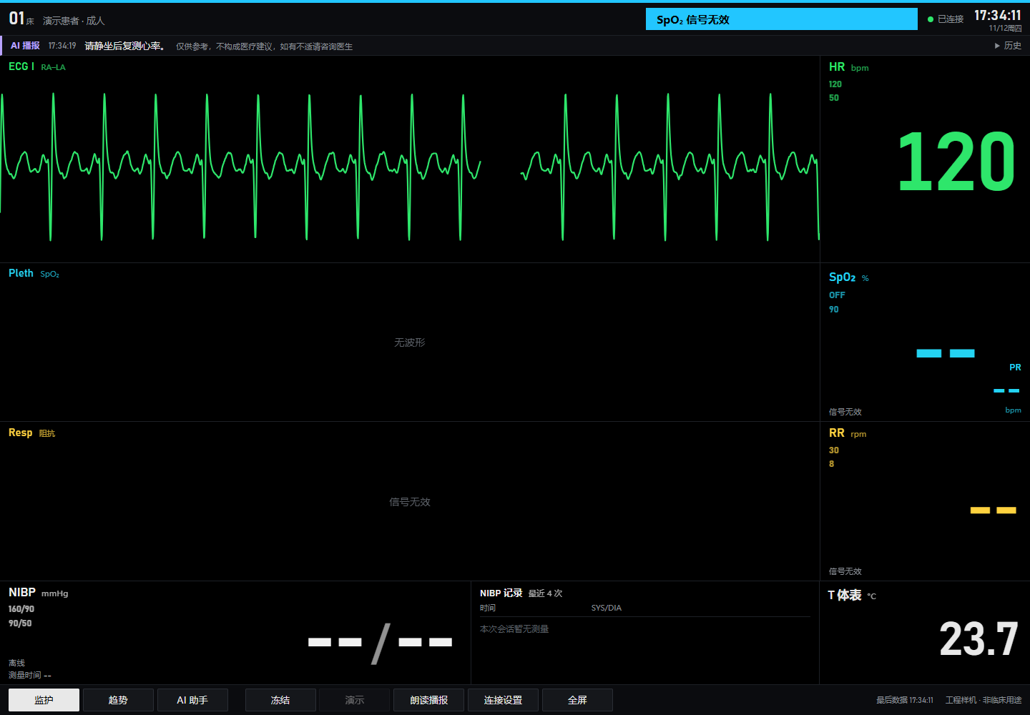
node-b/docs/PI-REVIEW/R61-WAY-RUN4-HR-20261112.png
