Serendipity-min/medical-multi-parameter-monitor/血压/HKB-08/HKB-08血压系列传感器/HKB-08C-4四肢血压传感器/四肢血压采集彩页.jpg

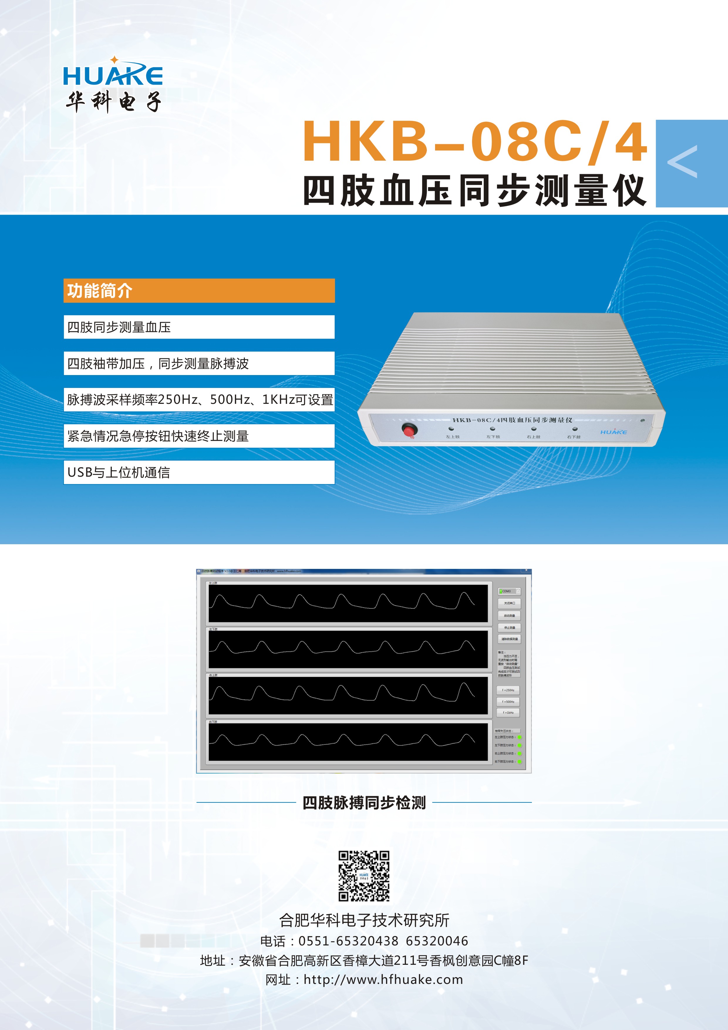
血压/HKB-08/HKB-08血压系列传感器/HKB-08C-4四肢血压传感器/四肢血压采集彩页.jpg
