Serendipity-min/medical-multi-parameter-monitor/artifacts/ecg-source/g2s/S0现场操作与记录清单.md

# G2-S现场操作与记录清单

2026-10-15（Asia/Shanghai）。依据MPM-ECG-G2S-001 v1.0；固定基线`B2@2ca744d2f06d49711863968aeef15b64891edd18`。本文件是现场准备单，不是完成测试回执。尚无本轮上电、备份、烧录或DAC实测结果。

## 1. 当前等待的现场输入

只使用第二块F407，标记S；原采集板B与ADS保持断电、与S断开。不连接真人或RA/LA/RL。

1. 两板USB、J-Link、J5及其它电源全部断开。先提供S整板正面、P11正上方近照及万用表型号/表盘照片，确认S板身份。
2. P11照片须能对应LED/DAC、RJ/ADC、GND/TPAD丝印及三组针。板上可能没有数字3–4或5–6，不要求寻找这些数字。
3. 在确认当前照片与针序前，先不移除跳帽、不按K1、不插电。已有授权窗口内的现场确认属于执行条件，不是再次申请硬件授权。

## 2. 元件位置说明

| 目标 | 对应实物与图纸 | 本轮拟执行动作及条件 |
| --- | --- | --- |
| K1 | 前图J5圆孔座旁白色ON/OFF按键；不是K11 | 图纸为弹起USB、按下外部DC；现场确认身份及状态后选择USB，不靠外观宣称已选通 |
| J5 | 实物标DC 6–28V的圆孔座 | 本轮优先USB，J5不插适配器；不需要为了测试使用12V |
| USB_232 | 前图靠J5、标USB转串口/USB_232的接口 | 拟用USB供电入口；先在整板照片上确认，不能替换成USB_HOST或其它USB口 |
| LED–DAC | 图纸P11 5–6；连接PA4/DAC1与DS2/R51负载 | 已有照片未装跳帽，继续保持断开，不新增 |
| RJ–ADC | 图纸P11 3–4；连接PA5/DAC2与电位器滑端 | 新照片核对无歧义后，在两板断电时移除该组跳帽；留移除前后照片及通断记录 |
| GND/TPAD | 图纸P11 1–2 | 不为DAC测试安装跳帽，不调整无关接点 |
| 邻近PWM_DAC/PDC等接口 | 与本轮P11两组DAC负载跳帽区分 | 不调整，不猜测其用途 |
| PA4/PA5 | S板DAC1/DAC2实际排针，待整板照片/图纸/断电通断确认 | 初期不接跨板线或衰减网络；后续只接经确认的测量探头 |

PA4/PA5未接外线不代表没有板载负载。若实际照片只有DAC/ADC/GND而无法确认成对接点，保持原状补照片，不按“上/中/下”盲拔。

## 3. 供电与仪表条件

- 选用已经确认的单一USB入口。J5与其它供电不接；J-Link VTref不是供电输出，探针型号/连接方式确认后仅用于目标电平参考及SWD。
- YL-1210铭牌12V直流/1A、中心正极已记录，实际极性/电压和J5匹配未测。USB方案不依赖先验证该适配器，也不自动批准插入J5。
- 万用表先确认型号、黑表笔COM、红表笔电压/电阻插孔。测电压不得用电流插孔或电流档；通断/电阻仅在两板无电状态下进行。确认实物测试点及仪表后再给出具体表笔落点。
- 上电电源测量由现场执行，Codex记录真实读数，不补填理论电压。参考地、3V3/5V测试点和K1选通若无法确认则停止。
- 当前无示波器。可按新合同完成电源、静态偏置与数字状态检查；真实动态输出须记DYNAMIC_UNVERIFIED，不以DMM均值或DMA计数判60/90bpm波形合格。

## 4. 后续依赖顺序（收到现场资料后执行）

1. S0：识别S板/针序/单电源路径/仪表，断电确认和处理指定跳帽；冻结源固件身份与可恢复备份策略。
2. S1：满足断电核验条件后，只给S单独上电，由现场测5V/3V3并记录。当前旧程序未知，不能提前声称其处于新源固件OFF模式；两路模拟端保持与B/ADS断开。
3. 电源合格后，仅连接已确认的S板SWD；实际读取原Flash并校验备份可用性、读保护和恢复方法。实际备份需要S供电，必须在擦写前完成；不能把S0中备份策略就绪写成备份已完成。
4. S2：备份/恢复条件合格后，核验冻结S专用BIN，再烧录校验；只使用S的符号地址切换模式。不得使用B板地址。若源BIN与归档SHA不同，先核对而不冒充相同产物。
5. S3：OFF→BIAS→1Hz→60→90→OFF。逐项记录数字模式/state/faults、DMM DC与动态仪器结果三列；无动态仪器则该列为NOT_MEASURED/DYNAMIC_UNVERIFIED。新固件重启默认OFF，不用无波形判固件失败。
6. 结束时记录S板最终状态/固件身份及恢复执行情况，生成唯一ECG_SOURCE_G2S_HANDOFF.md。未经数据证明不称STATIC_PASS或DYNAMIC_PASS。

原B固件、BIO_V2、G1源码和历史证据不变。不执行G2-A/G3、Security Gate或PR。现场条件不符立即停止，保留失败记录。

## 5. 待填现场记录

| 记录项 | 当前值 |
| --- | --- |
| S实物板型/正反面照片 | PENDING |
| S/B均断电、S无跨板连接 | PENDING_CURRENT_CONFIRMATION |
| P11 LED–DAC确认断开 | 先前照片可见，当前待复核 |
| P11 RJ–ADC确认及移除前后证据 | PENDING；未指令现场盲拔 |
| PA4/PA5/GND实际针序及通断 | PENDING |
| USB入口/K1状态 | PENDING |
| 万用表型号/表笔插孔/档位 | PENDING |
| 电源5V/3V3读数 | NOT_MEASURED |
| S原Flash备份/恢复能力 | NOT_VERIFIED_THIS_WINDOW |
| 烧录及OFF/BIAS/1Hz/60/90实测 | NOT_EXECUTED |
| 动态测量工具 | 无示波器；替代设备未确认 |

停在现场资料确认阶段，尚未进行任何设备连接或硬件操作。
