Serendipity-min/medical-multi-parameter-monitor/node-b/docs/CODEX-M0-MULTIRATE-20261031/SKX-MANUFACTURER-QUESTIONS.draft.md

# SKX-2000D+ 技术询问稿（仅草稿，未发送）

状态：DRAFT_NOT_SENT / NO_MANUFACTURER_RESPONSE / SKX_QRS_OUTPUT=UNKNOWN。没有电话、邮件、聊天或销售确认记录。本轮没有使用任何通讯工具联系他人；接收方、发件人及厂家联系人待负责人指定。型号先按已有资料SKX-2000D+，本台序列号、硬件/固件版本、菜单/输出当期证据UNKNOWN；真实序列信息仅在后续受限渠道填写。

拟发给生产/技术支持方：

我们使用非人体工程样机验证，需要确认本台SKX-2000D+呼吸模式的真实电输出定义。现有12页说明书SHA `27fe9e4a37a761ab7df939bf49693942dbf3e5692f09e2e10311106053503cc8` P5/P11，以及21页V2.2手册SHA `8b264906747e76336e7a7221ab77b76e3697078f794b064e77081e7e56fc48aa` P20，均列有呼吸章节“心率60 bpm”；V2.2同时单列主呼吸率默认15、幅度1.5R、波形周期默认30、参考阻抗1K和RA–LL。请针对下列问题书面回复，并注明适用的型号/序列范围、硬件/固件及手册修订版，不以其它型号销售页面替代。

1. 在**呼吸波形、主RR15/min、幅度1.5R、波形周期30bpm、apnea0s**已确认生效时，RA–LL与RA–LA两端分别是否输出叠加ECG/QRS？请给出差分极性、典型波形、幅度/频率和容许负载，区分菜单值、理想设计与实测资料。
2. 呼吸章节“心率60 bpm”是固定配套ECG、可调ECG、脉冲/内部时基还是其它含义？它与独立“波形周期30bpm”字段如何作用？请明确周期字段控制何种物理量及是否改变QRS，不能仅说“周期”。
3. 能否**保持RESP率/幅度/基线/负载不变而关闭ECG/QRS**？若能，请给出确切菜单、按键确认流程、适用固件及关闭后两端实测保证；若不能请明确。关机、开路、Lead-Off或软件HR=0不作为该问题答案。
4. 普通ECG60/90/120是否能保持同一正常波形和1mV名义幅值？120是否需要尖角/校准/其它波形菜单？I/II导联幅度和定标接法是否随版本变化？请列两档bpm字段各自名称、范围和生效层级。
5. 1.5R的R单位及峰值/峰峰值/其它定义是什么？1K是呼吸静态基线还是其它电路参数？请分别给出动态阻抗路径、ECG差分源阻抗、偏置/共模/频率响应和精度定义，不把二者混用。
6. RESP实际动态电极对、RA/LA/LL/RL用途是什么？接有主动RLD反馈时厂家推荐的隔离、共模/偏置、电流/输入阻抗/容性负载边界及充电USB限制是什么？请提供可公开的电气图/注意事项；我们不会自行将RL/RLD接保护地或插入外部偏置/电阻。
7. 设置是否需要参数层确认/保存，切换模式后保留哪些ECG/RESP参数？apnea0s确切语义是什么？固件升级是否改变上述行为？请提供区分实际输出模式的可追溯方法。
8. 若推荐独立波形参考仪器/方法，请给出隔离差分、原始记录/带宽/噪声及加载要求；如可提供本台型式/出厂输出记录，请注明校准/不确定度和适用条件。我们需要用独立电信号判断QRS，不能仅以监护仪显示HR作参考。

待回复登记字段：问题ID、厂家原文、签发人/渠道/日期、适用型号/版本、原附件SHA、是否经本台验证、剩余UNKNOWN。书面回复属于源定义证据，不能自动替代A1对本台端子/实际加载的独立参考，也不提供新的上电/接线/烧录许可。
