Serendipity-min/medical-multi-parameter-monitor/node-b/docs/FIVE-APPLIANCE-20261107/web-build.txt

vite v7.3.5 building client environment for five-appliance...
transforming...
✓ 20 modules transformed.
rendering chunks...
computing gzip size...
dist/index.html                  0.42 kB │ gzip:  0.32 kB
dist/assets/index-DlwcF99u.css  18.32 kB │ gzip:  4.61 kB
dist/assets/index-AqIm-tdB.js   49.49 kB │ gzip: 17.29 kB
✓ built in 130ms
