Serendipity-min/medical-multi-parameter-monitor/node-b/docs/FIVE-NODE-MIGRATION/FIVE41-20261106/STARTUP-INSTALLS-AND-NEXT-WINDOW.md

# 启动修复实际安装清单与下一窗口

五块板的本轮候选均已安装并核对；五板ECG与RR窗口尚未运行，不据此签采集/CAN/云端/网页整体通过。没有录音、主机启泵命令、提交或push。M0、main、R6原证据和正式云端未改动。

| 板 | 实际镜像 | 本轮核对 |
|---|---|---|
| A血氧/PPG | 33,444B，启动IRQ修复 | sector0/1/2，1MiB完整回读及区外/Options一致；安装后本地接收与有效结果正常 |
| B心电/RESP | 40,040B，启动IRQ修复 | sector0/1/2，完整回读及区外/Options一致；本地250SPS、捕获/交付一致 |
| C网关 | boot392B＋code56,072B，四源诊断计数 | sector0/4，完整回读及区外/Options一致；本轮未再次重刷 |
| D温度 | 24,552B，启动IRQ修复 | sector0/1，完整回读及区外/Options一致；新增10帧，末次26.36℃、源龄51ms，无新增帧/串口错误 |
| E血压 | 29,424B，启动IRQ修复 | USB232BOOT ROM sector0/1；32KiB应用逐字节回读一致，其余Flash前后SHA一致、Options及E身份一致；实际运行/屏/传感器待联调观察 |

C总加载56,464B，sector4余9,464B。相关采样、算法、PDO/队列及420秒硬截止、5秒/90秒时效保持原值。两段固定120Ω三口并联的40–41Ω属于负责人批准的监督诊断条件，不能充当正常端接/长期电气裕量通过。

E第一次安装事务在GET(0x00)尾ACK收到0xb9时停止，未取得身份、未擦写；负责人重新连接USB并要求重新读取后，独立只读识别成功，精确匹配原E身份，再在新事务内完成安装。首次失败未覆盖，应答异常根因未知，不能仅凭重连恢复就判为某根线或芯片故障。

当前仅E板由USB232BOOT连接上电，E的H/L移开、外围和泵断电，其余板断电。下一步负责人全部断电、拔USB/J-Link电脑端，接回E.CAN1至C1/A1同一段，另一段C2/B1/D1不动，参考地保留，两段H/L不跨接；将J-Link板端移B，并断电量两段阻值后再安排ECG上电。

先ECG，后RR，模拟器不能同时提供两个有效输入；每组四源就绪后45秒预热＋300秒评价，保留C的420秒硬截止。麦克风不加入，血压只在链路就绪提示后人工进行一次非人体测量。新ECG事务未消费，RR未启动；原B预检失败、A现场异常与所有历史失败原样保留。

回退使用各板之前已验证的应用镜像与身份，在对应扇区范围内核对区外与Options，不自动执行回退或在未知HALT/ROM/供电状态下续写。D/E依负责人决定未备份最初未知应用，不能声称可恢复那个未知原程序；已知M1旧镜像可作为另行受限回退的来源。

证据：[实际镜像](CURRENT-IMAGES.json)、[A安装](A-STARTUP-INSTALL-RESULT.json)、[B安装](B-STARTUP-INSTALL-RESULT.json)、[C安装](C-INSTALL-RESULT.json)、[D安装](D-STARTUP-INSTALL-RESULT.json)、[E安装](E-STARTUP-INSTALL-RESULT.json)。完整Flash、UID、Options、ROM应答与原生输出保存在既有EFS，未写入版本库。
