Serendipity-min/medical-multi-parameter-monitor/node-b/docs/AUTH-B-RESP-PATH-MEASURE-001-R2.md

# AUTH-B-RESP-PATH-MEASURE-001 R2｜参数确认与RA–LL电气准备

2026-10-23，Asia/Shanghai。负责人在同意旧R1后新提供V2.2手册，要求取消线缆电阻测量并重给步骤。本R2替代旧R1的后续操作指引；旧卡、旧授权和历史原件不修改。**没有收到旧R1的实际读数或完成回报，当前实物状态未冒称已知。** 取消所有Ω/蜂鸣测量，不重复索要J-Link型号或线缆映射，不改算法阈值。

状态：A段步骤已按本轮请求准备，可沿既有源端直流核对授权执行；未收到测量结果，不记为已执行。B段是准确冷接方案，**须A段读数审阅通过且负责人明确开始新接法后才执行**。本卡不授予软件采集、B重新上电或J-Link重接，后续另冻结采集卡。

## A1 冷隔离，仅参数确认与源端电压核对

同一B STM32F407ZGT6、ADS1292_V2.0/J2板5V共GND、原BOOT/START PG15/DRDY PA3不改，CAN/A/C/人体和其他仪器断开。SKX及DLX-YQ2915均电池、充电USB断开。A段一次手工会话≤10分钟，电压接触段≤2分钟，超时移开表笔并停止，不赶着补测或重试。

1. 万用表两笔离开、OFF，黑COM、红VΩ，电流孔空，HOLD未锁，无低电量/破损。**全程不使用Ω、蜂鸣、二极管、电容或电流档接任何物体。**
2. 若B仍通电，关J5；若J-Link USB仍接电脑，拔离该USB；SKX若开着先关闭。B/模块应无灯或其他供电迹象，否则停止，不碰导联。不更改B与模块间J2/供电/SPI或BOOT。
3. 冷态下，若三只夹头仍在SKX端子，全部取下并分开悬空。若旧卡已将三合一插头从模块拔下，保持拔下；若尚未拔下，这次无需拔。两种状态都只测裸露SKX端子，不测导联线或板内触点。
4. 只打开SKX电池电源，B仍OFF/J-Link USB仍断开。记录SKX电量，若低电量告警、自动关机、发热/气味等异常，停止，不接充电USB继续。

本段操作上限：B J5 ON=0/OFF≤1，J-Link电脑USB拔离≤1/重接=0，SKX OFF≤2/ON≤1；已关闭的设备不为凑次数再切换。没有CPU复位或运行状态调查。

## A2 按第三行项目名设参数，不再尝试15

参考新手册第6–9/11/20页。

1. 在第一层第二行选择“呼吸波形”，确认进入第三行项目选择。
2. 第三行必须读到**呼吸率**，再确认进入第四行参数。若为“波形周期”，返回第三行选“呼吸率”，不能拿它的20下限代替呼吸率范围。
3. 参数行“*”状态下，增/减键用于移到目标数位；确认使“*”变“?”，才用增/减改该位，再确认结束该位编辑。逐位设置并确认**20bpm**，不再尝试降至15；若无法设置20或显示不清楚，停止并抄原文。
4. 同法确认呼吸幅度1.5R、窒息时间0s；波形周期保持此前20bpm，只核对不调整，若实际不是20先停止回报。ECG60沿用此前设定及手册呼吸模式所列值，本段不另切普通ECG改心率、不将它冒称本次CH2已测值。
5. 最后回到第三行“呼吸率”、第四行20bpm，确认并退出“?”编辑态，再进行电压核对。不进入保存设置、厂家设置，不修改默认波形或恢复出厂设置。

一次回报每个项目名及其值，不要求在同一四行屏幕上同时显示四个项目。手册呼吸率下限5与实机报告下限20的差异保留，不靠继续按键试错解决。波形周期20含义不额外推定。

## A3 三对差分直流筛查，最多六次接触

导联夹全部不接SKX、B仍OFF，仅SKX电池源与电池万用表。RL仅作本行差分参考，不是GND，不桥接端子。

先用右侧白色**直流V⎓ 20V**档，不是红色交流20或下方电流20。每行接触≤3秒后两笔移开，保留符号、小数点和V单位。

| 编号 | 黑COM | 红VΩ | 粗档V / 条件细档mV |
|---|---|---|---|
| D1 | RL/N | RA/R | 待测 / 待测 |
| D2 | RL/N | LL/F | 待测 / 待测 |
| D3 | LL/F | RA/R | 待测 / 待测 |

三对均有可辨认数值、无异常且abs(V)<0.20V后，才移开两笔换白色直流200mV档，D1–D3各细读一次（≤3秒/对）。最多三次粗读、三次细读。换档和换测量对前两笔移开。

真正空白、无法辨认“1”、过量程、粗档abs(V)≥0.20V、细档abs(mV)≥200或异常跳变即停止，不重试、不进入B段。数字0.00V可以条件细读，但不记成精确0V。该0.20V是保守工程停止界限，不是厂家额定值；源端空载直流筛查不等于RLD/32kHz兼容或动态阻抗校准。

结束先移开两笔、表OFF，再SKX OFF；B仍OFF、J-Link USB仍断开，三只夹头分开悬空，三合一插头保持本段开始时的插拔状态。回报参数、D1–D3读数/档位、最后状态和异常；未测填未测/null，不填“电阻正常”。本段无进程退出码；人工记录COMPLETE或STOP，不冒填exit0。

## B 待电气审阅后的准确冷接方案（当前不执行）

依据V2.2手册第20页“呼吸导联II，RA–LL”。不是厂家照片照抄，不把模块主动RLD接到LL。本段≤3分钟，须A段数据审阅通过且负责人明确开始新接法；不从旧卡自动扩展接线权限。

1. B J5 OFF、J-Link电脑USB断开、SKX OFF、万用表两笔移开OFF；冷态才操作导联。若三合一插头已脱离模块，仅此时将原插头插回原模块插座一次；若已在原位则不拔插。
2. 按此前同款线缆设计解释接：**红R→SKX RA/R；黄L→SKX LL/F；绿F→SKX RL/N**。这是将原黄线目的端LA改为LL，不是将绿F挪到LL。SKX上“LL/F”的F是源端标签，不代表必须插绿色F夹头。LA及所有胸导空置；无裸露互碰，绝不短接LL与RL。
3. J2/供电/地/BOOT/START/DRDY不变，不接CAN/A/C/人体，不禁用RLD，不改寄存器或BIO_V2阈值。本段结束B与SKX仍OFF、J-Link USB仍断开，等待独立上电/有限采集卡。

保留“线缆色标到模块网络沿用设计假设、未做端到端通断”的边界，但按负责人新指令不再将Ω测量作为探索门槛。若出现实物明显不符或异常，停并如实报告，不盲试其他组合。

## 软件与证据边界

本卡SDK Open/Connect/Read/Halt/Go/Reset/Close=0，MCU读白名单为空；Flash/options/RAM/GPIO/SPI写0；算法阈值、滤波、相位、增益和RLD改动0；采集窗口0。不沿用旧15/RA–LA的45秒profile或此前卡授权。新源RR20和RA–LL窗口须独立冻结，未知Z0/ΔΩ/频率校准真值继续null。CPU问题继续待查。
