Serendipity-min/medical-multi-parameter-monitor/node-b/docs/RESP-VALIDITY45-001-RESULTS-R1.md

# RESP 45秒有效性测量结果 R1

2026-10-22 Asia/Shanghai。**本次采集完整，ECG实际60BPM得到互证；当前三线路径下未观察到可信呼吸周期，实板RR仍无效。** 结果RESP_PATH_NOT_OBSERVED，不签呼吸有效、速率跟踪或阻抗精度通过。负责人明确要求先做本窗，CPU的ROM→Flash问题暂列待查；本轮未展开该问题调查。

## 实际源与准确卡

负责人本轮明确回复设置已完成：ECG60、呼吸率15bpm、幅度1.5R、窒息0s，当前界面为呼吸波形；波形周期保持此前20bpm，Codex没有改源或接线。按[一次45秒精确卡](AUTH-B-RESP-VALIDITY45-001-R1.md)执行一次，source_type=RESP_EXPLORATORY，独立RESP45 profile，旧10秒profile仅作为冻结固件/ABI身份锚点，不冒用旧源或旧时限。全部工具/实际源/profile/本卡/负责人原话SHA在连接前冻结。

呼吸率15和波形周期20是不同项目，分别保存；后者未用作RR参考。nominal_rpm=15仅为源设置，reference_rpm=null代表没有独立标定的输入频率真值；Z0_ohm、delta_Zpp_ohm=null，dynamic_pair=UNVERIFIED。窒息0s原字记录，未猜其物理禁用语义。沿用电池/断USB、原R红→RA/L黄→LA/F绿RLD→RL、LL/胸导空置及无CAN/A/C/人体/新增接地仪器；万用表已移开OFF，无新测量或插拔。

## 完整性及真实退出码

| 项目 | 实际结果 |
|---|---|
| 前/末身份、完整Flash/options | 均核验通过，固件/BIO_V2阈值未变 |
| 会话总时长 / 采样窗口 | 103.844秒 / 45.031秒，前/末整片核验另计 |
| 槽块 / 稳定原码 | 566块 / 11346帧 |
| 锚定后帧 / 前置历史 | 11237帧 / 109帧历史保留且不混入评价 |
| 10–40秒评价段 | 7498帧，设备覆盖完整，38次保存的实板诊断观察 |
| 序号缺口、双重复冲突、暂停冲突 | 均0；26个pending保留，未补点 |
| CH1/CH2近轨及init/spi/bad_status/queue_overflow | 均0，主机观察约249.919 SPS |
| SDK及目标操作 | 1523次受控SDK调用，另Close1；halt1/go2，未发reset或烧录命令 |
| 尾段/恢复 | 确认暂停后同份128KiB RAM取稳定尾段，末检及恢复通过 |
| 真实退出码 | worker0、监督0；离线分析3（完整但未见有效呼吸） |

初态为已暂停的Flash候选，按卡在身份/整片、真实PC/VTOR及fault门通过后条件续跑一次；末尾再恢复一次，均在go≤2预算内。仅作正常采集准入，不新增BOOT/RCC/关闭重连调查，不复位。RUNNING_BEFORE_CLOSE仅为关闭前所见，不倒推关闭后状态。

## ECG60已经实际确认

评价段38次实板HR观察均为hr=60、hr_valid=1。另对CH2原码独立刻画低位尖峰，得到30个事件、29个间隔，中位数1000ms，约60次/分；此方法不以60作搜索先验，也不替代源校准或医学验证。因此本次可以确认ECG伴随输出已为60，不能再把当前RR无效简单解释成“仍在采上次120ECG”。这也不证明上次120为何出现或心率对一切呼吸场景都没有影响。

## CH1与RR有效性

| 项目 | 评价段实际结果 |
|---|---|
| CH1原码变化 | 峰峰320 ADC codes，存在小幅起伏，但无可交叉验证的约4秒周期 |
| 独立时间域候选 / 谱峰 / 自相关 | 约23.995次/分 / 6.0次/分 / 无可信自相关周期；估计不一致，不当成真实RR |
| 原码峰间隔 | 1.500、2.001、3.000、6.898、1.600、1.601、5.001、6.201秒；不稳定 |
| 实板RR保存观察 | 38次全部rpm=0、rpm_valid=0，观察有效比例0%，不是准确率 |
| 诊断原因 | 全部130 = NO_CYCLES + BROADBAND_NOISE |
| 累计resp_candidates / accepted | 7 / 1保持不变，评价段没有新增候选/接受；不是新鲜有效RR周期 |
| resp_last_cycle_ms / fresh_intervals | 均0 / 0 |
| resp_rms_codes | 约48.943 → 22.047，不能将滤后变化本身当有效周期 |

首10秒按采前冻结规则排除预热，随后完整30秒评价，末5秒为裕量；未因结果不佳改变评价范围或阈值。10秒预热本身不保证至少3个新间隔已经形成，不能仅凭评价初期部分无效指责算法；但本窗直到末尾仍0新鲜间隔，且原码周期不相干，结论不依赖该初期边界。冻结C Host回放独立保存，事件记录1，不冒称板上全部历史或实板输出。全部原码、完整120B诊断及原始ADC/初始化缓存已保存并逐件核SHA。波形图已离线检查：analysis-validity45-01/resp-validity-waveforms-private.png，原件受限保留。

采集层完整与呼吸信号有效是两项不同结论。本窗不是因为缺帧、削顶或SPI错误而拒绝RR；可辨认的呼吸周期没有在当前CH1观察中建立。当前证据仍不能区分源端阻抗调制未进入现有RA–LA通路、具体电极等效/模块解调兼容性或源波形参数生效细节等解释，也不能宣布模拟器不支持或算法阈值错误。

## 后续边界

本卡一次已消耗，不追加采集，不自动进入15→30或12/18/24矩阵，不调BIO_V2阈值。下一步优先核实模拟器呼吸阻抗变化是否实际作用于当前RA–LA路径及进入CH1；不再仅靠改ECG心率或重复同条件延长采样尝试。任何新导联、源切换、外加仪器或新窗口另卡，不短接LL/RL，不禁RLD凑结果。CPU问题按负责人要求继续暂列待查。

7项新增离线测试通过，disabled清单与错误原话SHA的真实CLI负例均worker1/监督1且SDK未打开。软件测试不替代本次实物结果。旧ECG六窗、E1-01/02失败、E1-03短窗、旧profile和完整备份均保留；本轮只改独立工具和报告，不碰保护分支、A/C/CAN、正式云环境或固件。

机器结果：[45秒分析摘要](../evidence/B-RESP-003/validity45-01-analysis-summary.json)、[实际源摘要](../evidence/B-RESP-003/validity45-01-source-public-summary.json)、[原件哈希索引](../evidence/B-RESP-003/validity45-01-original-hashes.json)。UID、原始Flash/RAM/帧、SDK日志、Host回放和负责人原话只在受限目录，未进入Git。
