Serendipity-min/medical-multi-parameter-monitor/node-b/docs/CODEX-M1-RR-BATCH15-OWNER-20261031/CONTINUATION-AFTER-MEASUREMENT-FAILURE.md

# 继续既有15次矩阵：保留测量失败，不追加重试

原始批次冻结c177d16a5f884207717b9fc694f3e991e7bf5b9a。用户明确要求按图完成五档各3次独立采集，并已要求遇阻自主排查、不要因阻塞停止。RR30-R1出现首个测量不通过后，先做离线排查，再将后续执行安排与该完整矩阵目标对齐；不增加授权次数、不改任何测量判据。

RR30-R1采集/父/worker/Close均正常0，原码序号、ADC状态/flags和时序完整性通过，正式review进程exit3，仅CORRECT_VALID_COVERAGE_BELOW_118_OF_120：94/120、缺槽0，所有有效RR为30。26个槽中RR有效性不足，53条无效快照分成约91.832–101.328、140.858–151.461和159.868–164.850秒三个观察簇，原因位包含NO_CYCLES/UNSTABLE/BROADBAND_NOISE。不是主机超时/数据丢失；物理源与算法的最终因果归属仍未证实。

原计划中“RR速率评价失败就停止整个批次”对完整重复矩阵过严：未达标应是本次结果，不应被隐藏或自动补测。继续原剩余10次预登记独立采集，RR30-R1永远保留NOT_PASS/94/120/exit3，不补跑、不重排、不调阈值，不把部分通过改成整组通过。此为Host执行进度规则更正，原采集器、原评测器、固件、算法、源菜单、45+120秒窗口、118/120门槛、硬停止预算、15张nonce与授权总数均不变。

设备/SDK/采集错误、Close失败、原码/时标/ADC等完整性错误仍立即停止后续；只有父/worker/采集均0、Close已返回、完整性为空且review为0或仅测量不通过3，才可签下一张既有卡。HR真值UNKNOWN保持，HR有效观察原样保留，不能据此判真假QRS或按模式屏蔽。

后续仍须操作者按提示独立冷启动并确认下一档才会连接。原前5次的源码与Git身份不变；后10次在本进度规则说明的新Git身份下重新绑定卡，代码字节与最初冻结相同。原批次15次授权及每次零重试不变；不是新的一批、不是失败次数退款。6个Host规则检查均通过：正常及纯测量失败可继续，review完整性失败/worker异常/Close失败/原码错误均拒止。

当前完成5次：RR12/15/18/24-R1速率通过，RR30-R1未通过；剩余10次未采。下一次仍为既定RR30-R2，无需改菜单，等待操作者新的冷启动完成确认。
