Serendipity-min/medical-multi-parameter-monitor/node-b/docs/CODEX-M1-RR-BATCH15-OWNER-20261031/FINAL-RESULTS-AND-LIMITATIONS.md

# RR五档各三次：负责人授权台架结果

2026-10-31，原计划15/15次独立采集全部完成：RR速率子功能13次通过、2次未通过；没有补跑或退款，整批不能判为全部通过。本轮恢复后五场各120/120通过。

| RR目标 /min | 第1次 | 第2次 | 第3次 |
| --- | --- | --- | --- |
| 12 | 120/120 | 120/120 | 120/120 |
| 15 | 120/120 | 120/120 | 120/120 |
| 18 | 120/120 | 120/120 | 120/120 |
| 24 | 120/120 | 108/120 未通过 | 120/120 |
| 30 | 94/120 未通过 | 120/120 | 120/120 |

判据保持原冻结评测器：45秒预热＋120秒评价，120个1Hz槽取最早原生观察；正确有效至少118/120且全部观测有效RR误差不超过1/min。RR30-R1的94/120和RR24-R2的108/120均保留NOT_PASS、review真实exit3；其余13次review exit0。15次父进程、worker、监督器、采集真实退出码全部0，Close均成功；不把Close返回当作退出后CPU仍运行的证据。

250Hz双通道原码及seq/IRQ ms/IRQ cycles/ADC status/flags保留，RESP50仅由seq%5派生。所有原始输入清单重新逐文件核验SHA，签名数学验证与新旧固定公钥核对15/15通过，父/worker各15份一次性消费记录匹配；没有原码序号、状态或时间完整性失败。各场实际采样率、原码帧数、IRQ步长与制品摘要见两个FINAL JSON。

HR不是本轮RR速率子功能的真值标签，不能据RR波形菜单推断ECG_ABSENT。以下数量是评价段中的有效诊断快照，不是独立心搏或已证实误报事件：

| Run | HR有效快照数 | 观察到的有效HR | Review真实exit |
| --- | --- | --- | --- |
| M1-R12-R1 | 0 | 无 | 0 |
| M1-R15-R1 | 4 | 66 | 0 |
| M1-R18-R1 | 6 | 88, 156 | 0 |
| M1-R24-R1 | 5 | 43, 78 | 0 |
| M1-R30-R1 | 2 | 91 | 3 |
| M1-R30-R2 | 2 | 146 | 0 |
| M1-R24-R2 | 2 | 74 | 3 |
| M1-R18-R2 | 0 | 无 | 0 |
| M1-R15-R2 | 0 | 无 | 0 |
| M1-R12-R2 | 4 | 78 | 0 |
| M1-R18-R3 | 0 | 无 | 0 |
| M1-R30-R3 | 0 | 无 | 0 |
| M1-R15-R3 | 4 | 74 | 0 |
| M1-R24-R3 | 0 | 无 | 0 |
| M1-R12-R3 | 4 | 53, 79 | 0 |

SOURCE_UNKNOWN / ROOT_CAUSE_UNRESOLVED继续有效，RR整窗whole_RR_window_PASS=false；不改算法、阈值或冻结评测器，不按模式强制禁HR、不伪造Lead-Off。两次失败均为RR有效覆盖不足，缺槽0、完整性通过，有效RR均命中目标；最终物理源/算法因果归属未证实，不能仅用失败窗调参。

源菜单统一为独立波形周期30bpm、幅度字面值1.5R、窒息0，主RR按五档变化；绝对阻抗UNKNOWN。非人体模拟器电池供电且充电USB断开。只读取B41012B，逐场按原同次BIN/AXF/符号及全片/options参考核验；C原J5/CAN作背景、C USB断开、B无USB，不宣称两板电气隔离。冷启动基于每场负责人全暗/上电回复，非独立仪器启动计数；不要求秒级人工报时。

SDK Open/Connect/Close原生残余副作用仍UNRESOLVED，关闭后CPU状态UNKNOWN；负责人已承担人工STOP/保全/断电责任。原PI根None，原PI_trust_root_verified=false、field_scope_PASS=false；本报告是负责人直接授权的非人体工程记录，不是PI独立签署验收。显式RESET/HALT/GO/Flash/B5START、C串口及云端操作均0。

前5次绑定c177d16a5f884207717b9fc694f3e991e7bf5b9a，中5次绑定e6a128bfa51bb3d5a958913fa4afea216f402b05（仅执行进度说明），最后5次绑定36a8c9bbd8430a215e0697ce684baf019ab9f3be（暂停后轮换测试公钥并收窄剩余五卡）；每场原卡身份保留，工具SHA未事后改写。恢复相关14项离线回归exit0，前批范围与继续策略原验收记录复用，不重复历史大矩阵。

全部15张nonce已各消费一次，测试私钥从未导出，最后签卡后已释放内存引用。不会自动续采或重试。最终负责人断电回复及逐场摘要见FINAL-RUN-RESULTS.json；受限原件通过本地build指针定位，Git仅保存脱敏统计和SHA，不包含UID、完整Flash或ADC明文。

当前新24窗矩阵已完成18窗：ECG60/90/120各1次、RR五档各3次；仍缺六次ECG独立重复，不能把旧固件/旧周期历史试验计入。本轮没有启动云端；既有ECG60/TEMP端到端工程证据可参考，后续M2需单独授权。RR结束后负责人追加桌面TEMP三分钟并明确要求汇总推送，取代先前暂停时“不推送”；RR交接时B/C仍上电供TEMP，最终断电状态在TEMP收尾记录。
