Serendipity-min/medical-multi-parameter-monitor/node-b/docs/FINAL-SYSTEM-20261102/CURRENT-RESULTS.md

# 最终集成当前回执

分支 `codex/final-system-20261102`，起点 `be552179d77b21132d0027ff757e5db60959713f`。当前只完成P0基线及P1部分工作，未签发最终验收或三板并发PASS。

- A42608/B41516/C44520：本次双份1MiB、Options、已知身份及应用BIN对照通过，原生退出均0。受限Flash/UID原件仅存EFS。
- C TTS STOP：补查询与失败锁止；原Host3351断言、8个定向场景、44项相关安装/恢复测试、7项串口证据校验及3子测试通过，退出0。C单板空闲+两次短句启动后停止均取得41/查询/4F，退出0，现场听到开头后停止；首轮台架日志顺序导致的失败1完整保留。
- C原应用恢复：完整Flash SHA恢复为423a8058…，Options与应用区外不变，退出0。A/B未烧录，正式云服务未修改，main未合并。
- 静态合体：PCM移CCM、DMA留普通SRAM后，双CAN+完整录音/TTS API链接48936B，退出0；仅余216B Flash。音频上行和现场控制未合入，链接探针未安装，不能当作并发PASS。
- MIC的100nF陶瓷电容与100kΩ电阻数值已获负责人明确核实；SDK隐式副作用、实物PCB及完整连线、真实合体运行水位/网络中断STOP仍未关闭；旧RR24/30、RR15源真值及TEMP180原结果不变。
- 云事实模块仅CRLF/LF差别、AST一致；完整部署Git/Web版本仍待映射。成年人家庭教学规则仅草案，尚未冻结或启用。

当前现场：负责人确认三板及模块全部断电，USB/J-Link电脑端拔出；CAN未接，MIC六线拆下，J-Link板端可留C。下一次上电/接线前再通知现场人员。

分阶段详细命令、SHA、真实原生返回、恢复及未决项见[P0盘点](P0-STATUS.md)、[P1记录](P1-STATUS.md)、[C停止原生证据](P1-C-STOP-NATIVE-RESULTS.json)、[恢复](P1-C-RESTORE.json)、[静态链接](P1-C-AUDIO-LINK-PROBE.json)。本回执不替代24h或最终验收。
