Serendipity-min/medical-multi-parameter-monitor/node-b/docs/FIVE-NODE-MIGRATION/FIVE41-20261106/RR18-300S-RESULTS.md

# RR18五板双段41Ω工程诊断结果

**45秒预热＋300秒评价已完成，收尾正常；端到端完整性不通过。** 同一套A33,444/B40,040/C392＋56,072/D24,552/E29,424B镜像，与ECG组之间未修改固件。两段41Ω/40.9Ω，属于本次受控工程诊断，不签正常端接或信号裕量。

负责人确认独立呼吸：主呼吸率18、独立波形周期30、幅度1.5R、窒息0；R→RA、L→LL、F→RL。严格区分菜单名义输入与独立物理校准。

| 项目 | 真实证据 | 结论 |
|---|---|---|
| B源RR | 300秒内600次诊断均RR18、valid=1、reason=0；ADC长间断/队列溢出/坏状态/SPI/初始化错误增量0 | 本源诊断正常推进 |
| C两路CAN | 各60次诊断ESR/发送失败/FIFO溢出均0；四源NMT5、EMCY0、节点来源正确 | 本窗未见数字CAN错误，不能替代物理幅值/边沿或完整逐点验收 |
| RESP至Broker | 287批VALID、14,350载荷点逐点匹配B源，批次点值不一致0；严格评价窗内14,303点，名义15,000的95.35% | 完整传输不通过 |
| RR数值 | 297条VALID，全部为18 | 源数值与已收到报文一致，不代替波形完整性 |
| PPG至Broker | 54批VALID、实际2,676载荷点，包含短批 | A全窗原始UART/SWD未采集，完整性未证明 |
| ECG/HR | 680批ECG INVALID、27批VALID；HR 288条INVALID、10条VALID，保留源资格原值 | 此模式无独立同步ECG参考，不签同窗双有效或准确度，也不强制伪造失效位 |
| E血压 | 屏97/66，与C同次完成结果、Broker序号1/会话can-2960712887-1及网页一致 | 首次网页STALE/显示--源龄90.713秒；E保持在线 |
| D温度 | 297条VALID，来源D及网页匹配 | 工程物体温度，未做绝对标定 |
| 网页实收 | 2,402条唯一消息，300条在线状态聚合；2,102条生理遥测中1,422条原样匹配、680条仅无效/失效遮蔽，新增缺收0、值不一致0 | 缺口主要在Broker之前，遮蔽按规则保留 |
| 收尾 | C/源观察器/接收端原生退出均0，C STOP与TTS ACK/QUERY/IDLE确认，本机子进程退出 | 未录音、主机启泵0，负责人确认全部断电 |

## 队列与边界计数

同类诊断首末约覆盖294–295秒，具体时点在JSON；不是逐毫秒完整计数。

- 实时队列高水位24；溢出0→50，待发替换87→745。替换可能转历史，不能全部直接叫永久丢弃。
- 历史淘汰30→739，增加709；历史容量56持续满，REPLAY实际接收0。
- **PPG短批保留/提交**3→13批、73→204点，增加10批/131点；这是emit已有真实点，不是丢弃，也不证明已到Broker。
- 另一通用`partial_discarded`123→325，增加202；不包括上述PPG保留分支，现有诊断不能把它按ECG/RESP分摊。B源RR资格稳定，不据此直接把202点叫RESP丢弃。
- A入口gap计数1→6，B波形gap不增加；A质量/发送间断与后续出站队列损失分层记录，不唯一归因模拟器、线材或41Ω。负责人未补充本窗血氧屏0/无值及温升等观察，记未知。

C的PPG待发替换、历史配额饥饿路径已用实际router源码和同编译分支离线复现，未修改固件；见[离线复现](OFFLINE-ROUTER-REPRODUCTION.md)。后续改动需同时保住ECG/RESP/PPG，维持原采样率和时效，不补点、不延长超时。

当前现场全部断电，USB/J-Link电脑端已拔，J-Link板端在B，黄L留LL，两段五板CAN线束保留。本轮不自动重试。网页ECG标题仍静态写RA–LA，不作为本RR实物接线依据。未提交或push。

[完整JSON](RR18-300S-RESULTS.json) · [逐点/网页核对](RR18-300S-SOURCE-WEB-REVIEW.json) · [网页97/66](browser/RR18-E-97-66-valid.png) · [90秒失效](browser/RR18-E-90s-stale.png) · [计数解释更正](COUNTER-SEMANTICS-ERRATUM.md)
