Serendipity-min/medical-multi-parameter-monitor/artifacts/ecg-source/arm-build.log.txt

*** Using Compiler 'V5.06 update 7 (build 960)', folder: 'D:\keil\ARM\ARMCC\Bin'
Rebuild target 'MPM_ECG_SOURCE'
assembling startup_stm32f40_41xxx.s...
compiling source_waveform.c...
compiling waveform_tables.c...
compiling source_driver.c...
compiling main.c...
compiling system_stm32f4xx.c...
linking...
Program Size: Code=2284 RO-data=8504 RW-data=24 ZI-data=9096
".\build\MPM_ECG_SOURCE.axf" - 0 Error(s), 0 Warning(s).
Build Time Elapsed:  00:00:01
