Serendipity-min/medical-multi-parameter-monitor/node-b/history/ECG模拟器连续采样与心率核验_20261012.md

# ECG 模拟器连续采样与心率核验回执（R6）

日期：2026-10-12（Asia/Shanghai）。输入来源：**专用模拟器，经用户明确确认为非真人**。

本轮范围为一次受控连续采样、固件 RAM 状态核验与离线分析。相对于 R1–R5 的直接目的：
把 R4 那轮"来源被澄清为人体"造成的证据缺口补上，用非人体源重新检验"设备能否把
一路正常量级的心电信号变成可用心率"。

---

## 1. 结论与当前状态

**采集链路与器件身份全部通过；设备仍未输出可用心率；输入侧信号质量不合格。**

1. **连续性为历轮最好**：连续 2500 点、序号缺口 0、非法 STATUS 0、flag 非零 0、
   队列溢出 0、长间隔 0；IRQ 间隔 4003.52 / 4003.77 / 4004.06 μs。
2. **器件身份与起点干净**：UID `<DEVICE_UID_REDACTED>`、DBGMCU IDCODE
   `0x10076413`、Flash 1024 KiB；采集前板上镜像 SHA-256 与 R5 结束状态**完全一致**；
   本轮"普通固件"由当前源码重建后与 R5 记录的 BIN **逐字节相同**。
3. **R5 首拍恢复修复确实生效，但不够**：`s_have_beat = 1`（R4 那轮为 0），死锁已被
   打破；然而 `s_rr_count = 0`、算法与 UI 的 BPM/RPM 有效位均为 0，
   `s_quality = 51`。设备端仍无可用心率。
4. **未判拍的直接机制已定位到 RAM 级**：阈值被 `8 × 噪声` 闸门主导
   （3.131×10⁻⁷），而学习以来出现的最大积分峰值只有 3.422×10⁻⁷，
   **仅高出 9.3%**。绝大多数拍仍被拒，凑不满有效 RR。
5. **输入侧信号质量不合格**：工频（50 Hz 及谐波）占总方差 **81.76%**，
   比 R4 人体那轮的 73.96% **更差**；扣除工频后的残差里仍有 **59.69% 的能量在 15 Hz 以上**。
6. **但底层确实存在一路正常量级的心律成分**：两个互相独立的频域方法
   （零填充高分辨率谱 73.745 BPM、自相关 73.822 BPM）**相差仅 0.077 BPM**，
   基准周期 0.8128 s；时域 13 个间隔中 8 个落在该周期的 ±10% 内。
   73.8 BPM 落在成人静息心率正常范围。

**因此对本轮问题的直接回答是：数据里"有心律成分、且量级正常"，但设备"测不出可用心率"，
且信号质量不合格——不能判为符合正常人体指标，也不能判为验收通过。**

---

## 2. 输入来源与执行边界（本轮最重要的前提）

用户在本轮启动前明确选择：**专用模拟器，型号与设定心率/幅值均未提供**。

这条边界直接决定结论强度，按项目既有规则执行：

| 项目 | 本轮状态 |
| --- | --- |
| 是否真人 | **否**（用户明确确认为专用模拟器）→ 不触发 HUMAN_PROTECTION HOLD |
| 模拟器型号 | 未提供 |
| 设定心率 / 幅值 / 呼吸率 | 未提供 |
| 呼吸模拟能力 | **无**（用户明确说明） |
| 可做的判定 | 采集链路验收 + 信号量化表征 |
| 不可做的判定 | **定量模拟人体等价验收**（R3 报告第 6 节第 1 条的既定要求） |

因此本轮**不写"模拟人体通过"**，只写"采集链路通过 / 信号表征结果 / 设备输出不可用"。

---

## 3. 器件、固件与改动身份

| 项目 | 实测 |
| --- | --- |
| UID | `<DEVICE_UID_REDACTED>` |
| DBGMCU IDCODE | `0x10076413` → Cortex-M4 r0p1 |
| Flash 容量 | 1024 KiB |
| 调试器 | SAM-ICE（J-Link V5.12），SWD 4000 kHz，VTref 3.300 V |
| 采集前板上 1 MiB SHA-256 | `6d44275aac8edec2ab2892d543a1658032fdd515421ca6a6de961bdb9f1c343e` |
| 与 R5 结束状态 | **一致**（无漂移） |
| 采集后板上 1 MiB SHA-256 | `6d44275a…c343e`（与采集前逐字节相同） |

源码冻结 93 个文件。与 R4 冻结清单逐项比对：**文件集合完全相同，唯一哈希变化是
`HARDWARE/pan_tompkins.c`**（`1d53b5a8…` → `faee8e20…`，即 R5 首拍恢复修复）。

| 固件 | Code | RO | RW | ZI | BIN 字节 | BIN SHA-256 |
| --- | ---: | ---: | ---: | ---: | ---: | --- |
| 普通（生产） | 25820 | 1488 | 460 | 11884 | 27388 | `9f58a8902da3ba35c30c2d736f416c75a68e578a69835a2ed94ded9d1ad58281` |
| 一次性记录副本 | 26432 | 1488 | 460 | 102028 | 28000 | `639761406a3b4df688161a0dda8458788c8942e3dcde6bfd5e4e2d3112fcd4c1` |

两者均 ARMCC 5.06 update 7 构建，退出 0、**0 Error / 0 Warning**。

**交叉验证：本轮普通固件 BIN 与 R5 回执记录的普通修复 BIN SHA-256 完全相同**，
即当前源码重建即可复现 R5 已验收的生产镜像，本轮起点可追溯。

记录层与生产源码的差异只有隔离观察点：`HARDWARE/ecg_capture.c/.h` 新增、
`ads1292.c` 与 `hr_page.c` 各两处观察调用、`HR_TFT.uvprojx` 注册，精确 Diff 见证据目录
`isolated_capture_overlay.patch`。**滤波系数、算法阈值、SPI/PG15 接线、屏幕协议、
CAN 实现均未改动**；生产源码在本轮结束时经 93 文件逐一核验未变。

---

## 4. 采集连续性

记录从采样时戳 6000 ms 之后开始，容量 2500 点，录满且停止写入（不滚动覆盖）。

| 检查 | 实测 |
| --- | --- |
| 记录点数 | 2500（容量 2500，录满） |
| 序号缺失 / 非单位步进 | **0 / 0** |
| 采样时戳跨度 | 6004 → 16009 ms，10.005 s |
| DWT 跨度 | 10.005435 s（按名义 168 MHz） |
| 推算采样率 | 249.764 SPS（名义 250） |
| IRQ 间隔 最小/中位/最大 | 4003.52 / 4003.77 / 4004.06 μs |
| 非法 STATUS | 0 |
| flags 非零 | 0 |
| 已处理点 | 2500 / 2500 |
| 上屏函数发送点数 | 625（每 4 点抽 1，符合设计） |
| SPI 错误 / bad_status / 队列溢出 / init_errors / long_gap | 全部累计 0 |
| 记录结束 IRQ / captured / delivered | 3658 / 3658 / 3658 |
| 队列峰值 | 8（容量 128） |
| 记录首序号 / 映射错误 / 完成标志 | 1159 / 0 / 1（complete） |

`COM18` 以被动方式打开成功但收到 **0 字节**；本轮有效数据全部来自 SWD RAM 转储，
**不声称串口数据链路通过**。

R4 那轮最小/最大 IRQ 间隔为 4002.95 / 4004.89 μs，本轮为 4003.52 / 4004.06 μs，
抖动进一步收窄。**结论只覆盖本轮 10 秒窗口，不等于长期稳定性。**

---

## 5. 原始信号与工频

| 项目 | CH2（ECG） | CH1（呼吸） |
| --- | ---: | ---: |
| 最小 / 最大 | 110356 / 216160 | 613102 / 620668 |
| 均值 | 163582.64 | 618377.22 |
| 标准差 | 21513.10 | 1647.03 |
| 峰峰 | 105804 | 7566 |
| 达满量程 95% | 0 | 0 |

全部 STATUS 的固定头与低 13 位合法（`C00000 / C02000 / C04000 / C06000`，
变化落在 GPIO 位）；LOFF 激励关闭，**不能把这些位当作电极接触判定**。

工频最小二乘拟合（真实时戳上拟合 50/100/150/200 Hz + 线性趋势）：

| 频率 | 拟合幅值（码） | 折合 mV（增益 4） |
| --- | ---: | ---: |
| 50 Hz | 26319.36 | ≈ 1.90 |
| 100 Hz | 2698.52 | ≈ 0.19 |
| 150 Hz | 317.78 | ≈ 0.02 |
| 200 Hz | 558.42 | ≈ 0.04 |

**工频占总方差 81.76%**；扣除后残余标准差仅 9188.45 码。

残差频带能量占比（0.5–100 Hz 为分母）：

| 频带 | 占比 |
| --- | ---: |
| 0.5–5 Hz | 9.99% |
| 5–15 Hz | 29.40% |
| **15–40 Hz** | **34.19%** |
| 40–100 Hz | 25.43% |
| **> 15 Hz 合计** | **59.69%** |

真实 QRS 的能量集中在 5–15 Hz。**>15 Hz 占 59.69% 说明残差里含大量非心电成分**，
这也是后文形态不干净的原因。

---

## 6. 固件输出与未判拍的 RAM 级机制

固件自身在停机时刻的状态（RAM 直接读取，非推算）：

| 字段 | 值 |
| --- | ---: |
| `s_bpm` / `s_bpm_valid` | 0 / **0** |
| `s_rpm` / `s_rpm_valid` | 0 / **0** |
| `s_quality` | 51 |
| `s_have_beat` | **1** |
| `s_rr_count` | 0 |
| `s_last_beat_ms` | 0 |
| `s_learn_max` | 2.0567698×10⁻⁷ |
| `s_signal_level` | 1.6319754×10⁻⁷ |
| `s_noise_level` | 3.9134029×10⁻⁸ |
| 学习以来最大积分峰值 `s_window_peak_val` | 3.4219377×10⁻⁷ |
| `s_sp_n`（伪迹抑制状态） | 0（未处于抑制） |

按源码阈值公式复算：

```text
threshold = max( noise + 0.25×(signal − noise),  8×noise,  1e-12 )
          = max( 7.015×10⁻⁸,  3.1307×10⁻⁷,  1e-12 )
          = 3.1307×10⁻⁷        ← 8×噪声闸门主导
学习以来最大积分峰值 = 3.4219×10⁻⁷
超出阈值仅 9.3%
```

**结论与边界（不越界表述）**

- 可确认：R5 的首拍恢复路径已经生效（`s_have_beat` 由 0 变 1，死锁打破）；
  当前门限由 `8 × 噪声` 闸门主导，而实际最大积分峰值只比它高 9.3%，
  因此只有极少数拍被受理，`s_rr_count` 停在 0，BPM 无法转为有效。
- 可确认：`s_sp_n = 0`，**不支持**再把现象称为"伪迹抑制锁死"。
- **不能确认**：噪声水平之所以偏高，是干扰耦合进带通后的结果，还是信号本身幅度偏低。
  仅凭一份 RAM 快照无法把这两者分开，本轮不作断言。

---

## 7. 离线独立判定（含判据自我更正链）

### 7.1 频域主估计

| 方法 | 结果 |
| --- | ---: |
| 零填充高分辨率谱（0.7–5 Hz，Hann 主瓣 0.200 Hz 分组） | **1.22908 Hz = 73.745 BPM** |
| 自相关（0.5–15 Hz 带通） | **0.8128 s = 73.822 BPM**（corr 0.401） |
| 两法差异 | **0.077 BPM** |
| 次强可分离谱峰功率比 | 0.337 |

**两个互相独立的方法一致到 0.08 BPM，是支持"存在稳定心律"的最强证据。**

### 7.2 时域一致性

以自相关基周期锁定判峰最小间距后：检出 14 个峰、13 个间隔，
其中 **8 个（61.5%）**落在基准周期 ±10% 内；其余为判峰器自身的双波瓣误判与漏拍。
判据 D 因此**不通过**——时域形态不足以支撑"干净单 QRS"的说法。

### 7.3 判据缺陷的自我更正（必须留档）

第一版自动判据给出 `reliable_single_rhythm_detected = false`。逐条复核后确认该结论由
**我自己的分析脚本四处机械缺陷**造成，而非数据：

| 缺陷 | 现象 | 更正 |
| --- | --- | --- |
| 1 | 0.5002 Hz 峰（功率 0.808）被当作竞争节律 | 该频率正落在分析带下边界 0.5 Hz，是基线漂移/趋势泄漏 |
| 2 | 1.149 / 1.229 / 1.309 Hz 被拆成三个竞争峰 | 去重阈值 0.08 Hz 小于 Hann 主瓣宽度 0.200 Hz，实为同一主瓣结构 |
| 3 | 自相关 1.6415 s 被当作竞争周期 | 它恰为基周期 0.8168 s 的 2 倍，是心搏的二次回波；另有把基周期自身误列为竞争项的代码 bug |
| 4 | 0.5–15 Hz 带内判峰把一拍拍成两拍（中位间隔被压到 480 ms） | 该带内波形每周期有两个波瓣；改为锁定最小间距后再做一致性检验 |

三版判定结果全部保留在同一证据目录（`rhythm_detection_verdict.json`、
`_corrected.json`、`_final.json`），未覆盖任一版本。
**修正的是脚本缺陷，不是放宽判据**——判据 D 修正后仍不通过，就照实写不通过。

### 7.4 呼吸通道

本轮**无呼吸模拟能力**（用户明确说明）。CH1 原始表征：工频拟合幅值仅 226 / 325 / 25 / 33 码，
0.1–1 Hz 主峰 0.4878 Hz（折合 29.3 次/分）。**该数字不作为呼吸率**——
无已知输入、无阻抗模拟、无人体验证，**RESP 功能维持"未验收"**。

---

## 8. 幅度与形态

按基准周期 812.77 ms 折叠，取与周期一致的 8 拍做集合平均：

| 项目 | 实测 |
| --- | ---: |
| 集合平均峰峰值 | 0.917 mV |
| 主峰半宽 | 20.0 ms |
| 原始直流偏置 | **+11.80 mV** |
| 成人 QRS 典型时限（参考） | 80–120 ms |

- 幅度 0.92 mV 落在模拟器/成人 ECG 的常见量级（典型 1 mV），**量级合理**。
- 主峰半宽 20.0 ms **明显窄于**成人 QRS 的 80–120 ms；结合第 5 节"59.69% 能量在
  15 Hz 以上"，说明折叠后的波形**不是干净的单 QRS 形态**，含大量高频成分。
  半宽是形态描述，**不是临床 QRS 时限测量**。
- 直流偏置 +11.80 mV 相对增益 4 的 ±605 mV 满量程仅 2%，未削顶；
  该偏置来自模拟器输出还是输入网络，本轮未测，不作断言。

---

## 9. 与 R4 人体轮的对照（本轮新增的有价值推论）

| 项目 | R4（人体，来源事后澄清） | R6（专用模拟器） |
| --- | ---: | ---: |
| 49–51 Hz 占 0.5–100 Hz 功率 | 73.96% | **88.02%**（占总方差 81.76%） |
| 50 Hz 拟合正弦幅值 | 16954 码 | **26319 码** |
| 连续性 | 2500 点通过 | 2500 点通过（抖动更小） |
| `s_have_beat` | 0（首拍死锁） | **1**（R5 修复生效） |
| BPM 有效 | 否 | 仍否 |

**推论：把信号源从人体换成专用模拟器之后，工频干扰不但没有消失，反而更强。**
因此工频干扰**不来自信号源（人体）**，而是由采集侧引入——导联线/接插件、
共地路径、供电或板上耦合。这把 R4/R5 遗留的 `50HZ_SOURCE = OPEN` 从"来源完全未知"
收窄为"来源在采集侧，而非被测对象侧"。

**该推论的边界**：两次采样之间线缆布置与走线是否完全一致未记录，因此"更强"这一
数值比较不能当作严格单变量结论；但"换掉信号源后干扰依旧存在且同量级"这一点，
足以排除"人体本身是干扰源"。

---

## 10. 状态台账

```text
DEVICE_IDENTITY_AND_UID        = PASS (UID/IDCODE/Flash 与历史一致)
PRE_FLASH_BACKUP_AND_NO_DRIFT  = PASS (双读一致；与 R5 结束状态逐字节相同)
SOURCE_FREEZE_AND_REPRODUCIBLE = PASS (93 文件冻结；唯一变化为 R5 的 pan_tompkins.c；
                                       普通固件 BIN 与 R5 记录逐字节一致)
ARM_BUILD                      = PASS (两套镜像 0 Error / 0 Warning)
ACQUISITION_CONTINUITY         = PASS (2500 连续点，序号/STATUS/flags/溢出/长间隔全 0)
DIGITAL_TRANSPORT              = PASS (本轮 10 秒窗口)
RHYTHM_COMPONENT_PRESENT       = PRESENT (频谱 73.745 BPM vs 自相关 73.822 BPM，差 0.077)
FIRST_BEAT_RECOVERY_FIX_R5     = EFFECTIVE_BUT_INSUFFICIENT (s_have_beat 0→1；rr_count 仍为 0)
FIRMWARE_VALID_BPM             = NOT_OBTAINED (BPM/RPM 有效位均为 0)
SIGNAL_QUALITY                 = NOT_ACCEPTABLE (工频占总方差 81.76%；>15 Hz 占残差 59.69%)
WAVEFORM_MORPHOLOGY            = NOT_CLEAN_SINGLE_QRS (主峰半宽 20 ms；时域间隔一致性 8/13)
RESP_FUNCTION                  = NOT_VALIDATED (本轮无呼吸模拟能力)
QUANTITATIVE_SIMULATOR_EQUIVALENCE = NOT_PERFORMED (型号与设定值未提供)
HUMAN_PROTECTION               = NOT_VERIFIED (本轮非人体，未触发)
50HZ_SOURCE                    = NARROWED (排除信号源侧；定位到采集侧，未闭合)
PRODUCTION_SOURCE              = UNCHANGED (93 文件逐一核验)
BOARD_FINAL_STATE              = RESTORED_TO_R5_EXACT (采集前后 1 MiB SHA 相同)
GIT_ADD_COMMIT_PUSH            = NOT_EXECUTED
```

---

## 11. 剩余项与下一步

1. **必须先处理工频与高频干扰**。工频占总方差 81.76%，>15 Hz 占残差 59.69%，
   在这一状态下任何算法侧调参都是在噪声里找信号。建议按 R3/§6 的既定路径做
   受控对照：同一模拟器输入下，分别改变（每次只改一项）导联屏蔽与走线、
   共地/参考端接法、供电来源、RLD 连接，用同一套记录固件比较 50 Hz 拟合幅值。
2. **噪声闸门口径需要复核**。`PT_SNR_GATE = 8` 在本轮把门限顶到 3.131×10⁻⁷，
   而实际最大积分峰值 3.422×10⁻⁷。这是"采集已修好但算法仍不出数"的直接所在。
   建议在干扰受控后，用已知幅值输入标定 `s_noise_level` 的合理性，
   **不要直接调小闸门去凑一个数字**。
3. **补模拟器的型号与设定值**。给出设定心率/幅值后，本轮这套流水线可直接做
   定量等价验收，届时 `RHYTHM_COMPONENT_PRESENT` 才能升级为 PASS。
4. **呼吸功能仍从未验收**，需要具备呼吸阻抗输出的模拟器。
5. 需外部时基仪器校准 168 MHz 推算的采样率；本轮 249.764 SPS 未用外部仪器标定。

---

## 12. 证据位置

本轮工作区：`doc/B/心率+呼吸/OBJ/ecg-sim-r6-20261012T185429`
证据目录：`doc/B/心率+呼吸/排查证据_20261010/R6_模拟器连续采样_20261012T185429`
（原始 RAM/CSV/全片备份按惯例留在本机私有目录，不进 Git）

| 关键材料 | 文件 |
| --- | --- |
| 采集回执（含前后 SHA） | `hardware-receipt.json` |
| 上机前身份与备份核验 | `precheck-receipt.json` |
| 固件清单与资源 | `firmware-manifest.json` |
| 记录层精确 Diff | `isolated_capture_overlay.patch` |
| 总分析摘要 | `analysis_summary.json` |
| 工频分离 | `deep_analysis_summary.json` |
| 形态数值化 | `morphology_summary.json` |
| 稳定性与频带分解 | `stability_summary.json` |
| 三版节律判定（不覆盖） | `rhythm_detection_verdict{,_corrected,_final}.json` |
| 证据清单与 SHA-256 | `artifact_manifest.json` |

原始 RAM SHA-256：`6ad7b85fb015ed6219f04816013167e6770f4ad79f5a86d2869f078e7bd14469`

**本轮不构成人体可行性、患者安全、临床性能或呼吸功能的任何结论。**
