Serendipity-min/medical-multi-parameter-monitor/node-b/history/ECG真机排查与修改决策_20261010.md

# ADS1292R ECG 真机排查与修改决策

> **后续状态更新（2026-10-10）：**本文件保留早期对照及接线澄清。后续已完成 PG15 START 对照、采集队列与时戳整改，并整合到原工程。当前根因、固件及剩余事项以 采集连续性修复报告（原报告本地资料链接，原件未随本包公开） 为准；下文“未修改/未确认”等表述对应各历史阶段，不代表最新源码状态。

日期：2026-10-10  
排查源码：`<LOCAL_PROJECT>\doc\B\心率+呼吸\心率+呼吸`  
结论状态：**已复现采集异常并完成对照；尚未完成全部根因定位，不判定前端验收通过。**

## 1. 直接回答：是不是人体电极导致？

**不能把异常归因于人体电极。** 在芯片内部输入短接模式，完整任务仍记录到 +2718719、−3932160 的异常采样；这些异常不需要人体信号作为输入。

将主循环缩减为最小采集后，同样的内部短接模式在本次保存的 2048 点中没有出现同类大尖峰，范围为 −1395～−1319，标准差约 11.21 码。同时驱动记录的积压丢样计数由非零变为零。

这支持 **完整任务负担、延迟读取与采集异常有关**，并且与静态审查找到的“DRDY 只计次数、UI 阻塞发送、无历史样本缓存”一致。不过，最小采集仍存在 16/17 ms 的处理间隔，内部测试波形也未达到预期周期；不能把所有问题都解释为屏幕阻塞，更不能宣告只改 UI 就已经解决。

本轮采用内部测试、内部短接及正常输入配置的真实硬件数据，不是合成字节流；**没有合格的人体 ECG 验证数据，不能据此评价人体信号采集质量或设备接触人体的安全性。**

## 2. 测试边界与人体连接状态

用户最初确认“已断开人体电极；没有隔离器或暂不清楚”，据此执行诊断。测试中不要求重新连接人体，也不以人体作为试验输入。

随后用户通知已重新接入人体，立即停止发起新的硬件操作，继续离线分析既有文件。用户再次确认已断开。恢复原版固件的操作此前已经完成，本次恢复结果通过保存的回读文件核验。

人体连接状态没有独立传感器监测，不能证明整个测试期间物理状态始终未变化；本报告将其作为执行边界与局限明确记录。较早生成的分析 JSON 使用了过强的 `human_connected_during_test=false` 表述，原文件保留，最终应以“复核”目录中记录连接依据及无法独立监测的版本为准。

隔离条件仍未知，不继续在 USB/J-Link 接入且人体连接的条件下烧录、复位或切换 RLD/呼吸激励。TI 的开发板指南明确说明开发板缺乏患者保护电路，人体接触接口需另行保证安全；这也说明“用了 ADS1292R”本身不是隔离保证。[TI ADS1x9xECG-FE 指南，安全说明及硬件介绍](https://www.ti.com/lit/ug/slau384a/slau384a.pdf)

## 3. 工程、硬件与构建身份

| 项目 | 实际结果 |
| --- | --- |
| MCU 识别 | Cortex-M4，DBGMCU IDCODE=`0x10076413`，Flash 容量读值=`0x0400` KiB |
| J-Link | V5.12，SWD，1000 kHz，参考电压显示 3.300 V |
| COM15 | 枚举为 USB-SERIAL CH340；本轮未作为原始 ECG 数据通道打开 |
| 构建器 | Keil MDK Plus 5.35，ARM Compiler 5.06 update 7，build 960 |
| 原版构建 | Keil 返回 0，0 Error / 0 Warning |
| 原版 BIN | 26140 B |
| 原版 BIN SHA-256 | `7ae5cfbc4b567b42ddd3f367da716f79079e8a4f37a25d7c6dd9ce66a29e4356` |
| 原版 AXF SHA-256 | `300dd31fb1662f2c16985c37f78612f080c0ae9d9a0281cba316b1716ff95849` |
| 原工程字节身份 | 沿用静态审查的 92 文件 SHA-256 清单，原工程未修改 |

原版源码成功烧录并 VerifyBin；启动后 PC 位于 Flash 应用范围，没有记录到 HardFault。

首次连接时 CPU PC 曾位于 `0x1FFF32F0` 的系统 ROM 范围。本轮烧录与复位后已经运行 Flash 应用，但未做冷启动或 BOOT 引脚对照，因此不把首次 ROM 状态直接判定为 BOOT0 错接。测试前 Flash 也不能认定为本轮新构建的固件。

为了不覆盖原工程的构建产物，副本及日志存放在主项目内部的忽略目录：

`<LOCAL_PROJECT>\doc\B\心率+呼吸\OBJ\ecg-diag-20261010T184632`

构建时使用临时 `R:` 映射访问这个目录，未在 E 盘根目录创建新项目仓库。没有 Git add/commit/push，没有操作 P5、Broker 或 Security Gate。

## 4. 实际执行的对照

先运行未经诊断修改的原版，再使用隔离诊断副本进行下列六组短采集。每组复位后运行约 11.5 秒，由 SWD 在末端停机读取 RAM，读完恢复运行；缓冲只保留前 2048 次读取，后续记录数量单独计数，不覆盖既有样本。

| 名称 | 输入配置 | 主循环 | SPI 读帧实现 |
| --- | --- | --- | --- |
| mode0 | 正常输入，CH2SET=0x40 | 原版完整任务 | 原实现 |
| mode1 | 内部测试，CONFIG2=0xE3、CH2SET=0x45 | 原版完整任务 | 原实现 |
| mode2 | 内部短接，CH2SET=0x41 | 原版完整任务 | 原实现 |
| minimal1 | 与 mode1 相同 | 仅原驱动读取，移除 UI/判拍/CAN 任务 | 原实现 |
| minimal2 | 与 mode2 相同 | 同上 | 原实现 |
| guarded1 | 与 minimal1 相同 | 最小采集 | 只增加数据末端 10 μs CS 低电平保持 |

诊断副本增加了：

- 启动阶段的寄存器实际回读，附带自身需要的片选高间隔。
- 固定 RAM 记录：处理时间、DRDY 积压数量、原始 STATUS、signed24 CH1/CH2、帧头合法性。
- 每组独立快照、源码差异和准确固件身份。

完整诊断版新增 RAM 为 49216 B，原版 RW+ZI 为 9184 B，完整诊断版为 58400 B，低于本 MCU 的 128 KiB SRAM。缓冲只由主循环写、SWD 停机后读；满后不覆盖，不打印逐样本日志。诊断记录会产生一定额外执行开销，本轮没有测量其精确开销，不能把诊断版当成未经扰动的原版性能测量。

所有时间戳都是 **MCU 读取/处理时间**，不是 ADC 采样或 DRDY 边沿时间。图中没有插值补点或假定等间隔。

## 5. 原版运行结果与寄存器回读

### 5.1 未修改原版已经记录到丢失/错帧

第一次原版运行到 MCU 时基约 5000 ms：

| 原版计数 | 值 |
| --- | --- |
| 已通过帧数 | 848 |
| miss 累计 | 29 |
| 当前 DRDY 积压 | 0 |

恢复原版后同样约 5000 ms 的另一次快照为 814 帧、miss=30。两次输入/起始相位不同，不用这些数字直接做性能优劣比较。

原版 `miss` 混合了积压丢样及 STATUS 非法，不能把这两个原版计数全称为“29/30 个确定丢失的 ADC 样本”。后续诊断记录才对保留窗口的积压与帧头错误分别统计。

### 5.2 实际回读基本符合配置

mode0 启动阶段回读：

```text
ID         73
CONFIG1    01
CONFIG2    E0
LOFF       F0
CH1SET     40
CH2SET     40
RLD_SENS   EC
LOFF_SENS  00
LOFF_STAT  00
RESP1      EA
RESP2      03
GPIO       0C
```

内部测试和短接组的 CONFIG2/CH2SET 也读到所设置的 E3/45 或 E0/41。LOFF_STAT 和 GPIO 的动态输入位在各组有差异，不按固定字节相等判断硬件失效。

SPI1 的运行快照 CR1=`0x036D`、SR=`0x0002`，包含主机、软件 NSS、SSI、SPE 和既定模式配置。这个末端快照不能证明整段运行期间没有 SPI 错误。

**本轮不支持“模块完全不通信”或“SPI 模式完全错误”的结论。** 也不能凭此前文档提到的旧引脚表，就把实际连线按旧表接错认定为已经发生：当前实际获得了合理 ID、配置回读和大量合法帧。

## 6. 六组原始采集结果

每组保存 2048 次原始读取，包括非法 STATUS，未只保存通过帧。驱动累计计数取自后续约 11.5 秒快照，窗口不同，不能和前 2048 点统计混为一谈。

| 组别 | 保留窗口非法 STATUS | 保留窗口积压丢样计数 | CH2 最小值 | CH2 最大值 | 末端驱动 miss 累计 |
| --- | ---: | ---: | ---: | ---: | ---: |
| mode0 | 0 | 53 | 1359 | 183181 | 64 |
| mode1 | 0 | 57 | −15380 | 99328 | 66 |
| mode2 | 1 | 53 | −3932160 | 2718719 | 63 |
| minimal1 | 0 | 0 | −15406 | 12673 | 0 |
| minimal2 | 0 | 0 | −1395 | −1319 | 0 |
| guarded1 | 0 | 0 | −15381 | 12696 | 0 |

“保留窗口积压丢样计数”按每次读取的 `max(pending−1,0)` 累加，是驱动可见事件的计数，不保证统计到所有物理 DRDY 边沿；EXTI 事件合并或未收到边沿也不会被它发现。

缓冲满之后没有归档的记录数量为：mode0=299、mode1=271、mode2=296、minimal1=312、minimal2=360、guarded1=378。这是诊断保存容量限制，**不是额外 ADC 丢帧数量**。

### 6.1 内部短接：异常与积压相关

mode2 的两次大尖峰：

| 处理时间（自启动，ms） | CH2 原始值 | 同次读取 pending |
| ---: | ---: | ---: |
| 5412 | 2718719 | 5 |
| 9412 | −3932160 | 5 |

内部短接后，原始值通常在约 −1340 码附近，这个非零均值是偏置表现，不应直接判为芯片失败。两次数百万码的孤立跳变与附近常态差异极大，且同时存在积压。

最小采集 minimal2 的范围只有 −1395～−1319，标准差约 11.21 码，保存窗口没有同类大尖峰，pending 全部为 1。

**确认的事实：** 同一芯片、相同内部短接配置，在完整任务和最小采集下表现明显不同。主循环负担相关的延迟读取是已经有证据的故障方向。

**尚属推断：** 延迟读帧跨越 ADC 更新区造成数据撕裂，或者延迟路径放大 SPI 时序/传输错误。目前没有同时捕获的 DRDY/SCLK/CS/DOUT 电气波形，不能把某一种机制直接写为已证实。

该对照移除了多个任务，不能仅凭它区分是屏幕发送、算法执行、CAN 处理还是它们组合造成全部影响；但屏幕连续发送超过 4 ms 的代码证据仍然成立。

### 6.2 内部测试：有幅度响应，但周期验证未通过

配置请求内部 1 Hz 测试输入，原始正、负平台大约在 +12650 与 −15360，说明输入复用切换确实产生了不同于正常外部输入的结果。不能因此直接宣告内部测试全部通过。

minimal1 保存窗口只有三段负平台，符号变化处理时间为：

```text
3010, 3206, 7022, 7146, 9333, 9605 ms
```

guarded1 为：

```text
4880, 4900, 6574, 6638, 7759, 8163, 8660, 8908 ms
```

这些数据没有呈现稳定的预期测试周期。增加数据末端 CS 保持后，周期异常仍然存在。因此本轮不能把它判为仅缺少这一个 CS 等待，也不能把差异随机波动称为修复成功。

测试选择及内部波形预期来自 [TI ADS1292R 数据手册，CONFIG2/CH2SET 及内部测试输入](https://www.ti.com/lit/ds/symlink/ads1292r.pdf)。本轮未独立测量内部时钟、测试源或参考电压，也未在采集结束重新读取全部 ADS 配置；启动回读只能证明启动时的配置，不证明配置或电气条件始终未变化。

### 6.3 最小采集仍有长间隔，miss=0 不等于等间隔采样正常

| 组别 | 16 ms 间隔数 | 17 ms 间隔数 |
| --- | ---: | ---: |
| minimal1 | 39 | 6 |
| minimal2 | 33 | 2 |
| guarded1 | 29 | 2 |

多数处理间隔为 4 ms，但上述长间隔并未伴随多个 pending。它们不能全部解释为完整 UI 任务积压，因为最小采集也存在；可能与实际 DRDY、引脚争用、时钟/转换、SPI、较高优先级中断或边沿遗漏有关，尚不能逐一排除。

**必须保留的阻塞项：** 用独立信号观测确认实际 DRDY 周期与 MCU 是否漏边沿，并核对 CLKSEL、CLK、PA2/PA3 外围连接。仅用当前软件处理时间不足以判定芯片转换频率。

### 6.4 原始波形对照图

真实硬件原始 CH2 对照（原报告本地资料链接，原件未随本包公开）

图中各子图纵轴尺度不同，均为原始 CH2 码值；横轴是 MCU 处理时间。mode0 是正常外部输入配置，不作为人体波形或接触良好的电极输入证据。

## 7. 修改决策

### 优先修改方向：先保证采集连续性与错误可见性

已具备证据支持的方向：

1. 到达 DRDY 时及时读取并保存真实样本，算法和显示消费缓存。不能只扩大事件计数，也不能等 UI 完成后重读历史样本。
2. 将屏幕发送改为有界、非阻塞或每次限量处理，避免连续多个命令占用采样窗口。具体 ISR/DMA/UART 队列方案需要明确资源及并发边界，不直接照搬最小采集循环到生产代码。
3. 保留独立计数：积压丢样、非法 STATUS、SPI 超时/错误、采样间隔异常和削顶；初始化要明确报告实际配置及失败。
4. 明确保障 CS 和读帧时序；保留有界错误退出。CS 保持是应修的时序保证，但本轮没有证据证明它能单独解决所有现象。

### 必须继续定位的前置问题

- 内部测试源周期异常、最小采集仍有 16/17 ms 间隔，尚未闭合。
- 需要模块正反面、CLKSEL/CLK 接法、PA2/PA3 周围跳线及实际信号时序资料；“已经接好”不能替代这部分证据。
- 应先检查开发板是否有其它电平驱动接到 PA2/PA3，再选择安全的信号观测点。当前没有照片，不能宣称 SP3232/CH340 跳线冲突已经发生。
- 不直接大改时钟、增益或呼吸配置来获得好看的波形；每次只改变一个有明确假设的条件，并保留原结果。

### 后续处理层修改

原始采集问题闭合后，再处理静态报告中的 gain=4 与阈值口径、抑制器五点语义和显示单位问题，用同一份可靠原始记录回放对比。

当前不决定“改回 gain=2 就能解决”、不决定“模块坏了需要换”，也不把任何软件波形改善当作人体连接安全的证明。

**本轮实际实施的只是隔离诊断改动和诊断对照，未修改原工程生产代码。** 修改方案按上述证据排序，尚不提交一份声称问题全部解决的新生产固件。

## 8. 恢复结果与当前开发板状态

| 项目 | 已完成结果 |
| --- | --- |
| 烧录前 1 MiB Flash 双读 | 完全一致 |
| 双读 SHA-256 | `cab758c72677b2efb9f02b8c4e4bc42f324669abaf160c02300db6472c6f138b` |
| 结束保留的应用 | 原目录未经修改的原版源码，本轮新构建 BIN |
| 原版 VerifyBin | 成功 |
| 独立全片回读 | 原版 BIN 区域与新构建准确一致 |
| 前 32 KiB 以外 Flash | 与烧录前备份完全一致 |
| 结束全片 SHA-256 | `ef2d9cc8db36958674191238b6b6d85076b4b9a0ff4d25685292ec49bc98b2f2` |
| 结束运行状态 | 已恢复运行，PC 在 Flash 应用；未停留在内部测试/短接诊断固件 |

这里的“恢复原版”是恢复到 **本轮用户要求烧录的 ECG 原版源码构建**，不是全片回滚到进入本轮前的其它固件。烧录前的双读原件仍保留，可供必要时恢复。

完整成功烧录共 8 次：原版一次、六组诊断对照、恢复原版一次。期间没有冷断电、真实 assert 测试或服务器操作。

## 9. 证据、准确 Diff 与历史失败

最终审查入口：

- 六组完整统计与原始快照 SHA（原报告本地资料链接，原件未随本包公开）
- 各套 BIN/AXF SHA 与恢复清单（原报告本地资料链接，原件未随本包公开）
- 诊断记录覆盖层 Diff（原报告本地资料链接，原件未随本包公开）
- 最小主循环 Diff（原报告本地资料链接，原件未随本包公开）
- 仅增加 CS 结束保持的 Diff（原报告本地资料链接，原件未随本包公开）
- 解析脚本（原报告本地资料链接，原件未随本包公开）

每组 CSV 位于同一个“复核”目录，列出全部保留原始记录。完整 RAM 和 Flash 文件留在本机私有目录，不提交 Git。实际构建产物和 J-Link/Keil 原日志留在本轮忽略工作区。

普通构建历史：最小采集首次构建产生不可达代码告警，第二次产生未使用缓存告警，均返回 1，未用于烧录；最终将最小主循环单独定义并移除其未使用缓存后，返回 0、0 Error / 0 Warning。原告警日志没有删除或覆盖。两次未找到待执行脚本的 J-Link 调用返回 1，未建立目标连接、未烧录。

成功用于硬件的七套构建均为 0 Error / 0 Warning。该结果仅证明构建完成，不代表采集功能或安全准出。

## 10. 当前停止点

已经完成原版烧录、真实硬件复现、最小采集及 CS 保持对照、原版恢复和离线证据归档。

**确认：原始采集存在完整任务相关异常；人体电极不是异常发生的必要条件。**

**未确认：内部测试周期和长间隔的准确电气/固件机制，以及原用户人体波形异常是否还叠加了接触、共模、供电或模拟输入问题。**

当前停止新的硬件操作，开发板保留原版应用；下一步需要具体接线、CLKSEL/CLK 与独立时序证据，再决定剩余修改，不继续盲目改参数。

## 11. 原理图及用户接线补充核对（2026-10-10）

本节基于用户新提供的接线信息和实际模块 PDF，补充此前未具备的图纸依据。没有再次操作开发板，没有修改生产代码、滤波或显示。

### 11.1 原始图纸身份

- ADS1292模块电路原理图.pdf（原报告本地资料链接，原件未随本包公开），1 页，凌智电子 ADS1292 模块 V2.0，2020.09。
- PDF SHA-256：`dd8a66e9019d4a958adb0dc83741261daf8cd45a0a46faea93cb9dbdca14c069`。
- 原图渲染（原报告本地资料链接，原件未随本包公开）。
- 用户确认开发板为 STM32F407ZGT6，与工程的 STM32F407ZGTx 和已读取的器件系列/Flash 容量相容。

### 11.2 接线方向：IN/OUT 必须明确指哪一端

| MCU 引脚 | 正确连接的模块网络 | 图中 J2 引脚 | 与用户文字比较 |
| --- | --- | ---: | --- |
| PA0 | PWDN/RESET | 5 | 用户 PW，应确认就是 PWDN |
| PA1 | START | 6 | 一致 |
| PA2 | CS | 8 | 一致 |
| PA3 | DRDY | 12 | 用户 DR，应确认就是 DRDY |
| PA5 / SPI1 SCK | SCLK | 10 | 用户 SLCK，应为 SCLK |
| PA6 / SPI1 MISO | **DOUT，芯片输出** | **11** | 用户随后更正为 PA6→OUT，方向一致 |
| PA7 / SPI1 MOSI | **DIN，芯片输入** | **9** | 用户随后更正为 PA7→IN，方向一致 |

图中 DIN 经 PR2 的 100 Ω 电阻到 U3 的 DIN（19 脚）；DOUT 经同组电阻到 U3 的 DOUT（21 脚）。这给出了模块端的明确方向。

初次文字 PA6-IN/PA7-OUT 如果按模块 DIN/DOUT 理解会形成反接，因此曾请求澄清。用户随后明确更正为 **PA7-IN、PA6-OUT**，与原理图和先前成功通信相容。当前不把“PA6/PA7 接反”列为已经发生的故障，不建议交换这两根线。

初次清单未包含电源/GND 和 J3 状态。用户随后补充模块 5V 接开发板 5V，GND 接该 5V 旁的 GND；这与图纸接口要求一致，但不等于已经实测供电电压和稳定性。模块 J3 状态仍未由实物确认，详见第 13 节。

### 11.3 图纸对时钟、供电的约束

1. CLKSEL（U3 第 14 脚）经 R16=10 kΩ 上拉到 DVDD_3V3；J3 短接会把 CLKSEL 接到 GND。图上注明默认不焊 J3，默认内部时钟。因此对这版电路，不能继续把“CLKSEL 在图纸上没有偏置、自然浮空”当作原因；仍需确认实物版本、R16 装配及 J3 实际状态。
2. J3 若短接，需要适配实际外部时钟。当前驱动不产生外部 ADS 时钟，不能只靠修改 CONFIG2.CLK_EN 代替外部时钟源。
3. 电源入口 J1/J2 标注 PIN_5V，经过防反接与滤波。U3 的 AVDD 接的是 AVDD_5V；DVDD 接 ADP150 生成的 DVDD_3V3。另一组 AVDD_3V3 用于输入偏置网络，**不是图中 U3 的 AVDD 电源网络**。
4. 这只是图纸网络核对，未测量实物各供电节点。不能据此宣称供电已经稳定；若用户实际接了 3.3 V，也不能在未测量的情况下简单判为芯片必定失效。先记录实际电源入口及各输出电压，按该模块标注的供电条件核验。
5. MCU 与模块需要可靠共地；同时还需核对开发板 PA2/PA3 是否接有其它板载外设。只有 STM32F407ZGT6 型号无法确定开发板跳线或串口芯片，不能宣称某个跳线冲突已经证实。

### 11.4 代码、连线和芯片三类结论

| 类别 | 当前可支持的判断 |
| --- | --- |
| 代码 | 完整任务下积压与原始采集异常已经复现，应优先处理及时读帧、样本保存和阻塞任务 |
| 连线/电路 | 用户已澄清 PA6/PA7 方向正确；电源、共地、J3 和开发板外围仍需确认，新增板载外设共用证据见第 12 节 |
| ADS1292R 芯片损坏 | 暂无足够证据。身份/配置可读、输入短接在最小采集下较稳定，不支持立即换芯片；仍未排除时钟、模块电路或部分器件故障 |

“先解决采集连续性”作为修改顺序仍然合理。PA6/PA7 方向已澄清，下一步应取得独立 DRDY/SPI 时序证据并确认板载外设共用状态，再验证采集改动；不能用一个新的队列掩盖物理边沿、转换时钟或线路问题，也不应提前调整滤波和显示来获得好看的波形。

## 12. 开发板原理图核对：GPIO 并非全部独占

### 12.1 图纸及型号依据

用户提供资料目录 `E:\stm32\stm32文件`，实际核对了 STM32F407_原理图.pdf（原报告本地资料链接，原件未随本包公开），共 6 页，图纸为 STM32F4 神舟号，MCU 标注 STM32F407ZGT6。主图版本 V2.0，日期 2021-04-09；第 6 页以太网/音频子图标注 V1.0。

PDF SHA-256：`7737115dc272d6daff1f3bb08b7c8c23c10415c10bca57c3d72979adf53b46b2`。这是用户提供图纸的身份，不是实物 PCB 版本确认。

- 第 4 页 MCU 网络及跳线（原报告本地资料链接，原件未随本包公开）
- 第 5 页串口外设（原报告本地资料链接，原件未随本包公开）
- 第 6 页以太网 PHY（原报告本地资料链接，原件未随本包公开）

### 12.2 与当前 ADS 接口共用的网络

| MCU 引脚 | 当前 ADS 用途 | 开发板图纸共用网络 | 当前结论 |
| --- | --- | --- | --- |
| PA0 | PWDN 输出 | WK_UP 按键 | 有共用连接；采集期间不能把此按键作为普通用户按键使用 |
| PA1 | START 输出 | RMII_REF_CLK，连接 LAN8720A 的 nINT/REFCLKO（14 脚） | 若 PHY 在相应模式驱动该输出，会与 MCU START 输出争用 |
| PA2 | CS 输出 | ETH_MDIO、USART2_TX；可经 P3 连接串口外设 | 有负载/共用，MDIO 双向状态及跳线仍待核验 |
| PA3 | DRDY 输入 | USART2_RX；P3 可将其连接串口接收输出 | 图纸存在此通路，但用户已确认受测板相关跳帽全部取下；当前排除此跳帽桥接路径，见第 14 节 |
| PA5 | SPI1 SCLK | 摄像头 DCMI_PCLK 接口 | 外接摄像头装配状态需确认；仅空连接器不等于存在输出争用 |
| PA6 | SPI1 MISO | 摄像头 DCMI_D5 接口 | 同上 |
| PA7 | SPI1 MOSI | RMII_CRS_DV，连接 LAN8720A 的 CRS_DV/MODE2（11 脚） | 若 PHY 驱动该输出，会与 MCU MOSI 输出争用 |

所提供 PDF 的 P3 图中：1=T1IN、2=R1OUT、3=USART2_TX（PA2）、4=USART2_RX（PA3）、5=RS485_RX、6=RS485_TX。原先据此将串口输出桥接到 PA3 列为条件性嫌疑。用户后来提供了另一块板的参考照片，并明确受测板四个跳帽均取下、COM1 改接 PA9/PA10，因此当前不把此跳帽桥接路径继续列为活动嫌疑。参考照片与 PDF 的接插件/元件标注不完全相同，不将 PDF 的针号未经核对直接用于实物操作。

第 6 页以太网使用 25 MHz 晶振，nINTSEL 对应网络有下拉，设计意图包含 PHY 参考时钟输出。LAN8720A 可在相应配置下从 nINT/REFCLKO 输出 50 MHz，CRS_DV 也属于 PHY 输出。[Microchip LAN8720A 数据手册，接口引脚与 REF_CLK 模式](https://ww1.microchip.com/downloads/en/DeviceDoc/00002165B.pdf)

**不要直接认定 PHY 此刻正在驱动。** 图纸的 ETH_RESET 连接 PD3 且有 10 kΩ 下拉；当前应用未明确初始化或验证 PHY 状态。实物器件是否装配、复位电平、输出模式及波形都未确认，复位状态下也不能凭猜测认定所有相关线安全可复用。需要通过明确的电路隔离/状态依据和实测，证明复用可行。

另外，图纸的 MCU 主晶振为 **8 MHz**，与当前代码 HSE_VALUE=8 MHz、PLL_M=8 相符。此前 Keil CPU 描述中的 CLOCK(12000000) 不足以支持“板上实际晶振是 12 MHz”的判断。

### 12.3 与约 16 ms 间隔的关系：可检验的假设

TI 数据手册在当前 250 SPS 条件下给出转换启动建立时间为 2052 tMOD。按标准 fMOD=128 kHz 计算约为 **16.03125 ms**，与本轮最小采集中的 16/17 ms 长间隔数量级相符。[TI ADS1292R 数据手册，§8.5.1.9–8.5.1.10、表 13](https://www.ti.com/lit/ds/symlink/ads1292r.pdf)

因此“START 线上出现非预期变化，使转换重新启动/建立”应列为优先验证的假设，PA1 的板载共用连接给出了具体检查位置。但是处理间隔不是 DRDY 时戳，数值相符也不是因果证明；不能据此声称已测到 START 毛刺或 LAN8720 输出。

下一次应在人体断开、实物连接确认后，同时观测 ADS START/PWDN、DRDY 和 SPI，而不是只看滤波后的屏幕波形。若需隔离板载外设或迁移引脚，应先核对新引脚所有连接，再做有记录的单变量对照，不直接改成另一组“看似空闲”的引脚。

### 12.4 更新后的修改顺序

1. **先确保采集引脚可使用：** 核对开发板版本/装配、P3、PHY 状态以及模块供电、共地和 J3。接线方向正确不代表共用网络没有争用。
2. **再修采集连续性：**及时读帧并保存真实数据、降低主循环阻塞、保障 SPI 时序及独立错误统计。已有实测支持这一代码整改方向，但不能代替第一项电气核验。
3. **最后处理滤波和显示：**基于已通过的原始采样验证增益口径、抑制器语义和显示尺度。

目前应判断为 **已经证实的采集软件问题，加上图纸已确认但实际影响待测的板载共用风险**。不是已经证实 ADS1292R 芯片损坏，也不是用户更正后的 SPI 两线方向错误。

## 13. 供电、COM1 与 J3 名称澄清

用户进一步说明：COM1_R 接 PA9，COM1_T 接 PA10；模块 5V 接开发板 5V，GND 接开发板该 5V 旁的 GND。

- 如果 COM1_R/T 指串口适配器的 RX/TX，则适配器 RX←PA9（USART1_TX）、适配器 TX→PA10（USART1_RX）是通常的交叉方向。这组是 USART1，不能拿它来判断 PA2/PA3 的 USART2 网络是否被隔离。
- 用户称该位置为 P3，而提供的神舟号 PDF 把 USART1/USB-UART 跳线标为 P7、串口外设跳线标为 P3。实际 PCB 丝印/版本尚未确认，因此不能仅凭“P3”这个编号让用户拔某个跳线；应按网络和实际照片辨认。
- 模块供电及共地描述与图纸一致；此前供电/共地“未提供”的信息缺口已补充，不再将其当作完全未知。没有实际电压读数，仍不宣称电源无噪声或无压降。

**模块 J3 是另一处时钟选择接口，不是开发板 COM1 跳线。** 模块图纸明确写“默认不焊接，默认使用芯片内部时钟”。J3 的一端是 CLKSEL，另一端是 GND，R16=10 kΩ 将 CLKSEL 上拉。未连接这两个点时使用内部时钟；连接这两个点会选择外部时钟模式。

实物没有焊排针或没有跳线帽，因此找不到一个突出的 J3 插座，可以符合图纸默认装配情况。它也可能只体现为焊盘或不同版本的标识；尚未见实物，不能断言它一定存在于哪个位置，更不能从“没找到”推出“已经短接”。**不需要为了找齐接口而安装跳线帽或焊短 J3。**

模块 J3 时钟选择原图局部（原报告本地资料链接，原件未随本包公开）

剩余应核验的是采集引脚是否与板载输出共用，特别是 PA1/PA7 的 PHY 网络与 PA3 的实际网络，而不是这组 COM1 的 PA9/PA10。没有继续烧录、复位、改变连线或修改生产代码。

## 14. P3 实物参考照片与受测板连接确认

用户提供 P3 参考照片（原报告本地资料链接，原件未随本包公开），并明确说明：**照片是第二块板，为方便拍照使用；实际受测板的四个跳帽已经全部取下。** 当前 COM1_R 接 PA9，COM1_T 接 PA10。

照片 SHA-256：`45f7b4cf152d13aa3704dae16245d78814e14ba5773a8e71c2249be6706999cb`。

照片可辨认 P3、COM1_T、COM1_R、PA3_RX、PA2_TX、485_TX、485_RX 等标识。它用于辨认接口，不将照片中的在位跳帽视为受测板状态，也不把同一区域 P5 的跳帽与 P3 混用。

依据用户对实际状态的确认，COM1 的连接已经改到 PA9/PA10，而没有经这些跳帽连接 PA2/PA3。因此：

- **从当前嫌疑中排除 P3 跳帽把串口输出桥接到 PA3/DRDY 的路径。** 这是针对用户确认的连接状态，未通过本轮电气连续性测量独立验证。
- 不继续要求用户拆除已经取下的跳帽，也不建议把跳帽装回去。
- COM1 的 R/T 名称按用户丝印记录，不仅凭名称推断接插件信号方向；本项确认的是它没有通过上述跳帽占用 ADS 的 PA2/PA3 网络。USART1 的串口收发功能不是本轮新增验证项。
- 此局部照片与跳帽拆除不能证明其它位置的 PHY 状态；此前 PA1/PA7 的板载共用只保留为待验证条件，不能直接认定发生争用。

当前证据排序更新为：**优先整改已复现的采集调度/缓存问题，独立核验剩余的 START/DRDY/SPI 周期异常；P3 跳帽桥接不再作为当前根因。** 暂无依据认定 ADS1292R 芯片损坏或用户更正后的 SPI 方向错误。

本次只核对照片、更新结论并保存参考图，没有执行新的硬件操作或修改生产固件。
