Serendipity-min/medical-multi-parameter-monitor/node-b/history/ECG采集连续性修复与START_DRDY根因验证_20261010.md

# ECG 采集连续性修复与 START/DRDY 根因验证

日期：2026-10-10  
工程：`<LOCAL_PROJECT>\doc\B\心率+呼吸\心率+呼吸`  
状态：**采集软件整改及限定台架验证完成；人体验证未执行。**

## 1. 结论与当前状态

本轮证据支持两个需要同时处理的原因：

1. **PA1 不适合作为这块开发板上的独占 START 控制脚。** 将其置低的对照中，MCU 在约 32.595 μs 内记录到 64 次引脚边沿，观测中断触发上限后关闭；此时没有 DRDY/采样。将模块 START 改接 PG15 并释放 PA1 输出后，DRDY 间隔恢复约 4.004 ms，原先的 16/17 ms 长间隔消失，内部测试恢复稳定周期。模块移离后，旧 PA1 网络仍有高速边沿，支持干扰来自板上共用网络。
2. **旧代码没有保存连续样本，主循环阻塞会造成迟读与丢样。** 已改为 DRDY 中断及时读帧、128 帧固定队列、主循环按原始采集顺序及时间戳消费。不能只改一个事件计数变量来重建旧样本。

板上现在运行的是 **PG15 START、正常电极输入配置** 的修复版，不是内部测试或短接固件。原始工程内已整合经验证的改动；原版源文件、失败数据、测试前 Flash 和对照固件均留存。

最终普通启动检查：**3406 帧捕获、3406 帧交付；初始化错误、SPI 错误、非法帧、队列溢出及长间隔计数均为 0。** 这些结论只覆盖本轮约 15 秒启动观察，不作为人体接触安全、真实 ECG 算法或长期运行的验收。

## 2. 实际接线及身份

用户已移动一根实体线并确认连接完成：模块 START 从 PA1 改接 PG15，其他线不动，人体电极在本轮台架测试窗口保持断开。

| 开发板 | 模块信号 | 当前要求 |
| --- | --- | --- |
| PA0 | PWDN/RESET | 保留 |
| **PG15** | **START** | **本轮新接线，不能再按旧版 main.c 的 PA1 注释接线** |
| PA2 | CS | 保留 |
| PA3 | DRDY | 保留 |
| PA5 | SCLK | 保留 |
| PA6 | DOUT / OUT | 保留，SPI1 MISO |
| PA7 | DIN / IN | 保留，SPI1 MOSI |
| 开发板 5V、对应 GND | 模块 5V、GND | 用户确认供电并共地，未独立测量电源噪声 |

用户确认受测板四个串口跳帽均已取下，COM1_R/T 改接 PA9/PA10。第二块板的参考照片不作为受测板跳帽在位证据；P3 跳帽桥接到 PA3 的路径已从活动嫌疑中排除。

器件复核：Cortex-M4、DBGMCU IDCODE=`0x10076413`、Flash 容量 1024 KiB，UID 与前轮相同；模块 ID=`0x73`，符合本工程固定 ADS1292R 身份。所有恢复、校验均使用本轮真实读取或新构建产物。

## 3. START 网络的根因证据

### 3.1 为什么不能把 PA1 当作普通独占 GPIO

用户提供的开发板 STM32F407_原理图.pdf（原报告本地资料链接，原件未随本包公开） 第 4、6 页显示 PA1/RMII_REF_CLK 与 LAN8720A 的 nINT/REFCLKO 共用。PA1 的 GPIO 输出配置并不能解除板上的电气连接。

在正常高电平 START 模式，初期没有记录到 PA1 数字边沿，不能据此证明电气上完全稳定。之后低电平命令启动对照出现以下真实失败：

| 项目 | 结果 |
| --- | --- |
| 请求 START 电平 | 低 |
| PA1 观察计数 | 64，到上限停用 |
| 首末观察跨度 | 约 32.595 μs |
| 记录到的 GPIO 数字电平 | 包含 0 和 1 |
| PWDN 观察边沿 | 0 |
| DRDY / 原始帧 | 0 / 0 |

这不是正常软件 START 高低切换：此段代码没有反复写 PA1。发现后停止该对照，将 MCU PA1 输出释放为输入，保留 RAM 原件，没有继续尝试在该网络上长期强拉低电平。

图纸连接、异常边沿和换脚后的功能恢复共同支持 **板载共用网络干扰 START 控制** 是主要根因。**尚未使用示波器直接测量该信号频率或逐段追到 PHY 输出，因此不把“测到了 50 MHz LAN8720 时钟”写成实测结论。** 50 MHz 是相关 PHY 功能说明，不是这些 IRQ 记录给出的频率。[Microchip LAN8720A 数据手册](https://ww1.microchip.com/downloads/en/DeviceDoc/00002165B.pdf)

### 3.2 单变量换脚对照

同样的内部测试配置、完整 UI/CAN 任务和 ISR/FIFO，比较模块 START 接 PA1 与 PG15：

| 项目 | PA1 / FIFO | PG15 / FIFO |
| --- | ---: | ---: |
| 保存原始帧 | 2048 | 2048 |
| DRDY IRQ 入口间隔中位数 | 4004.107 μs | 4003.964 μs |
| 最大 IRQ 间隔 | 16114.286 μs | 4004.810 μs |
| 15–18 ms 间隔数 | 29 | **0** |
| SPI 错误 / 非法 STATUS | 0 / 0 | 0 / 0 |
| 队列溢出 | 0 | 0 |
| 内部测试形态 | 负平台出现不规则 | 正负平台稳定交替 |

PG15 实际 START 观察边沿为 0；原 PA1 已改为输入且不再连接模块，仍记录到 64 个边沿并封顶。这一对照把模块输入与旧网络的活动分开了。

内部测试实测半周期约 **512.5 ms**，约 **0.976 Hz**，记录实际数值，不写成精确 1.000 Hz。数据用于证明周期稳定性与输入复用响应，不作为外部时基校准。

PA1 与 PG15 原始波形和中断周期对照（原报告本地资料链接，原件未随本包公开）

### 3.3 受控暂停/恢复，确认 PG15 确实控制模块

在独立对照固件中只执行一次低电平暂停并恢复：

- 实际低电平保持：**20.0028 ms**。
- PG15 观察到两次控制边沿，没有触发封顶。
- DRDY 出现一次 **33.5906 ms** 的有意间隔，随后恢复稳定采集。
- 总捕获/交付：2524/2524，SPI 错误、非法帧及队列溢出均为 0。

该有意间隔与控制时刻对应，不作为未知故障或偷偷删除。它表明新线不是仅把模块 START 随意固定接到高电平，PG15 的控制能够影响采集状态。受控 START 原始回执（原报告本地资料链接，原件未随本包公开）

所有时间来自 MCU DWT/IRQ 记录，IRQ 入口不等于外部引脚边沿的精确时刻；中断抢占、有限数字带宽和封顶均是观察局限。

## 4. 采集调度与缓存修复

### 4.1 旧路径及迟读证据

旧 DRDY 中断只累计次数，主循环读取当前数据，一次积压不能重建多份历史帧。屏幕发送仍为阻塞式，6 条控件扫描的名义串口时间约 5.73 ms，超过 250 SPS 的 4 ms 周期。

本轮原路径短接对照读取 2347 帧、观察 2376 次 DRDY，存在 29 次事件积压差额；保留窗口的最大 IRQ→读帧启动延迟约 **3995.55 μs**，记录到一次读帧过程中 IRQ 序号变化。前轮已保存的数百万码异常尖峰和 STATUS 失败没有删除。

本轮原路径短接对照没有再次出现数百万码尖峰，这是本次结果，不写成“每次都能复现尖峰”。已复现的迟读/积压，以及历史尖峰证据分别保留，不混为同一观察。

### 4.2 新路径

```text
DRDY IRQ
  → 保存入口序号、DWT 周期和毫秒采集时戳
  → 10μs更新区等待 → SPI读取9字节 → 有界BSY等待 → 10μs末端保持
  → 独立SPI状态及STATUS校验
  → 固定128帧队列，满则拒绝新帧并计数
主循环
  → 只消费已保存帧
  → 按采集时戳与序号处理，不把积压样本伪造成当前同一时刻
  → 滤波/判拍、显示与CAN沿原任务运行
```

每帧 24 B、128 槽，队列占 3072 B。生产者只有 DRDY ISR，消费者只有主循环，使用 DMB 发布/释放槽位；初始化前才可 Reset。不是多生产者或多核通用队列。

SPI 等待每段使用 DWT 有界计时，采样字节 `0xFF` 与错误返回分离。ISR 不做 FIR、显示、CAN 或逐点串口打印。配置阶段与运行阶段的 SPI 所有权分开：当前应用只在初始化访问命令/寄存器；未实现采集期间的热配置，主循环不能直接与 ISR 并发访问 SPI。

记录真实序号断段、超过 6 ms 的 IRQ 间隔标志及溢出；**不根据间隔猜测并补造物理丢帧数量**。上层遇到断段重新初始化历史，不把旧、新片段拼接。

### 4.3 时间接口迁移

仅添加 `ProcessAt/InitAt/InvalidateAt` 时间接口，原接口保留兼容；心率/呼吸输入使用采集时戳。FIR 系数、增益、抑制阈值、判峰数学和显示尺度没有调参。

队列只是保存数据；如果继续用消费时间计算 RR，批量处理仍会压缩样本间隔，因此时戳迁移是此次队列整改所需的部分。现有 5 点中值、抑制器和屏幕自动增益问题保留给下一阶段。

## 5. 实际测试及失败记录

### 5.1 七组独立诊断对照

| 固件 | 输入/控制 | 真实结果 |
| --- | --- | --- |
| native_full_short | 原主循环读帧、PA1、短接 | 迟读及积压存在，42 个 15–18 ms IRQ 间隔 |
| fifo_full_short | ISR/FIFO、PA1、短接 | 队列未溢出，但仍有 85 个长间隔，不能认为只加缓存就解决 |
| fifo_full_test | ISR/FIFO、PA1、内部测试 | 周期仍不规则，29 个长间隔 |
| fifo_full_test_cmdstart | PA1 低电平、命令启动 | **失败：0 个 DRDY/样本，PA1 64 个异常边沿** |
| fifo_pg15_test | ISR/FIFO、PG15、内部测试 | 周期稳定，长间隔 0，实际 START 异常边沿 0 |
| fifo_pg15_short | ISR/FIFO、PG15、短接 | 长间隔 0；2048点范围 −1537～−1296，标准差约14.52码，无数百万码尖峰 |
| fifo_pg15_control | PG15 一次低/高控制 | 按控制暂停并恢复，2个控制边沿；有意间隔完整保存 |

每组保存前 2048 次读取及限定长度 IRQ 观察记录。缓冲满后的 `samples_overflow/trace_overflow` 是 **没有继续归档的记录数**，不是采集队列溢出或 ADC 丢帧。低电平失败组无数据，统计数值为空，不伪造零波形或列为 PASS。

### 5.2 普通 Host 检查

| 检查 | 结果 | 范围 |
| --- | --- | --- |
| 固定队列 | 2561 个断言，0失败 | 满队列、保留数据、顺序、时戳/标志、索引和uint32回绕 |
| 有界 SPI | 13 个断言，0失败 | TXE/RXNE超时、错误标志、0xFF合法数据及计时回绕 |
| 真实帧消费接口 | 18 个断言，0失败 | 空/空指针不消费、字节与元数据保留、序号回绕 |
| 算法采集时戳 | 8 个断言，0失败 | 同输入逐点/每25点消费结果一致、毫秒回绕、作废状态 |

合计 **2600 个行为断言**，含循环负载检查，不称为 2600 项独立产品验收。Host FIR 使用明确的单点数学桩，不冒充执行 ARM CMSIS 优化指令。

保留的普通失败：

- 初次 ARM 构建因不存在的 `SPI_I2S_FLAG_MODF` 标识符退出 2，未生成用于烧录的目标；更正为当前标准库的寄存器位定义，原日志保留。
- 初版解析器不接受零样本，遇到命令启动失败产生断言错误；后续将无数据表示为 null/NO_SAMPLES，旧快照未改。
- Host 的 `%llu` 格式在当前 MinGW 设置下失败，失败源码留存；修正输出格式，不改测试逻辑。
- 带大直流偏置的 30 s 合成呼吸输入未取得有效呼吸率。对同输入运行原版算法也得到无效呼吸率、相同输出哈希；属于既有收敛限制，没有调整滤波强行通过。60 s 合成输入验证为 HR=60、RR=15，逐点/批量结果一致。**真实呼吸算法仍未验收。**

### 5.3 真实普通运行 Smoke

正常输入修复版已烧录并校验，约 15 秒启动观察：

| 项目 | 实测 |
| --- | ---: |
| MCU 时基快照 | 15001 ms |
| DRDY IRQ / 捕获 / 交付 | 3406 / 3406 / 3406 |
| 初始化错误 | 0 |
| SPI 错误 / 非法 STATUS | 0 / 0 |
| 队列溢出 / 高水位 | 0 / 8（容量128） |
| 长间隔 / miss | 0 / 0 |
| 最小/最大 IRQ 间隔 | 4003.464 / 4004.000 μs |
| 最大读帧路径耗时 | 83.619 μs |

采集是在上电初始化后启动，不能把 15 秒总启动时间直接当作 15 秒连续采集时间。未独立测量外部时钟，也不把读帧耗时当作完整应用 CPU 开销。

真实运行与全片回读回执（原报告本地资料链接，原件未随本包公开）

## 6. 资源与当前产物

| Keil 静态指标 | 原版 | 修复版 | 差异 |
| --- | ---: | ---: | ---: |
| Code | 24572 B | 25604 B | +1032 B |
| RO-data | 1488 B | 1488 B | 0 |
| RW-data | 420 B | 452 B | +32 B |
| ZI-data | 8764 B | 11884 B | +3120 B |
| RW+ZI | 9184 B | 12336 B | **+3152 B** |
| 实际 BIN 文件 | 26140 B | 27172 B | +1032 B |

以上是静态布局，不是运行时堆栈高水位证明。大容量证据缓冲只用于隔离诊断版，最终运行版没有保留这些缓冲。

| 产物 | 当前准确 SHA-256 |
| --- | --- |
| 当前 BIN / 板上运行镜像 | `aaebcaf580d7de4d2f76fd5e4d77a4b35501413f4cc22a2631c2bdc9ae99116d` |
| 当前原工程 AXF | `d4cd6c4c344330d30d6b903923d10c7d3eb44941f2a358086b0a6a94781900e7` |
| 普通运行完整 Flash 回读 | `a078b5f2e7c9a6562b9884e8e2e32819df7d2b51cf6043b808d3246574262a49` |
| 本轮开始 Flash 双读 | `ef2d9cc8db36958674191238b6b6d85076b4b9a0ff4d25685292ec49bc98b2f2` |

当前原工程重编译返回 0、0 Error/0 Warning。其 BIN 与已实测 BIN **逐字节一致**。测试副本与原工程的 AXF 因路径/调试信息不同，SHA 不同，均保留；没有用不同 BIN 冒充同一测试输入。

## 7. 已整合变更与保存位置

13 个新增/修改文件，包括 USER/main.c 的接线/调度注释同步：

- ADS 驱动（原报告本地资料链接，原件未随本包公开）及头文件：PG15、ISR采样、校验、统计与帧元数据。
- 采样队列（原报告本地资料链接，原件未随本包公开）及头文件：固定容量、单生产者/消费者、满队列策略与内存屏障。
- SPI（原报告本地资料链接，原件未随本包公开）及头文件：有界、独立错误返回。
- 帧处理页（原报告本地资料链接，原件未随本包公开）：用采集时间和序号，断段重置。
- pan_tompkins.c/.h、resp_rate.c/.h：时间接口，数学参数不变。
- Keil 工程（原报告本地资料链接，原件未随本包公开）：注册队列源文件；编译/链接参数不变。
- main.c（原报告本地资料链接，原件未随本包公开）：仅同步正确接线和任务注释。

FIR 系数文件、CAN/CANopen 及 HMI 协议实现未改。没有 FreeRTOS、协议升级、Gateway/P5 固件修改、Security Gate、Git 提交或推送。

原版及本轮工作区：

`<LOCAL_PROJECT>\doc\B\心率+呼吸\OBJ\ecg-acq-r2-20261010`

其中 baseline 保留原版、candidate 保留诊断源、production 保留普通运行副本。原始 RAM/Flash 留在本机私有目录。没有为了避开中文路径新建 E 盘根目录项目仓库；构建使用的 R:/S: 是临时盘符映射。

关键审查文件：

- 最终准确 Diff（原报告本地资料链接，原件未随本包公开）
- 当前源文件及构建身份（原报告本地资料链接，原件未随本包公开）
- 全部对照固件输入/产物 SHA（原报告本地资料链接，原件未随本包公开）
- Host 回执与原版收敛对照（原报告本地资料链接，原件未随本包公开）
- 当前状态（原报告本地资料链接，原件未随本包公开）

每组完整 CSV 与分析 JSON 均在同一证据目录，保留失败组。输入源码 SHA、快照 SHA、ELF 地址分别来自实际构建，不混用其它版本的布局。

## 8. 恢复与接线兼容性

结束时留在开发板的是经过验证的正常输入修复固件，保持 PG15 接线。不是“全片恢复成旧版原件”。已独立回读确认新 BIN 区域一致、**前 32 KiB 以外的 Flash 与测试前原件完全一致**。

旧 Flash 和旧源文件保留用于回溯。不能把旧版 PA1 固件直接当作 PG15 接线的正常运行程序；原 PA1 网络的问题也已经观察到，不建议恢复其有问题的工作方式。回滚需要同时核对固件、引脚与板载共用状态。

## 9. 尚未完成的项目及人体测试请求

- **真实人体 ECG/呼吸采集：未执行。** 用户在软件验收后提出，并声明模块安全封装、可以人体采集。随后说明仍由开发板供电、开发板 USB/J-Link 接电脑；未提供患者侧隔离结构、型号或核验覆盖路径。
- **不能仅凭封装声明确认患者接口安全。** 已提供模块/开发板图纸没有显示患者隔离电路；并不据此断言实际封装必然没有额外保护，但目前无法核实。TI 的开发板指南同样区分芯片评估与人体保护，注明其开发板不提供患者保护电路；这不是对用户模块认证状态的判定。[TI ADS1x9xECG-FE 指南，§1.1、§5](https://www.ti.com/lit/ug/slau384a/slau384a.pdf)
- 用户已明确授权人体试验，暂停原因是 **必要电气条件无法核实**，不是再次索取口头授权。人体请求之后未发起新的目标连接、烧录、复位或配置命令。请求及未执行记录（原报告本地资料链接，原件未随本包公开）
- 增益4与抑制阈值口径、抑制器语义、显示缩放及形态带宽仍待下一阶段评估，本轮没有以调参追求满屏波形。
- 有大直流偏置的呼吸输入启动收敛限制已记录，不能由采集测试推翻或豁免。
- PA7 与板载 PHY 的共用仍是以后启用以太网时需要核验的条件；本轮只证明当前配置下的 SPI采集，不代表与以太网同时运行已验证。
- 长期稳定性、外部校准时基、真实患者接口与临床性能未验收。

下一步可在患者模拟器或符合已核验接口条件的测试环境验证，也可对既有原始记录做离线分析。当前 **软件修复及限定采集链路验证完成，人体可行性尚未证明**，不得写成全部验收 PASS。
