Serendipity-min/medical-multi-parameter-monitor/node-b/history/ECG首拍恢复修复与断开电极复测回执_20261012.md

# ECG 首拍恢复修复与断开电极复测回执

> **后续状态更新（R6，2026-10-12）：**本文件保留首拍恢复修复的台架证据。随后已用专用模拟器（非人体）做了一次连续采样复核：**首拍恢复修复确认生效**（`s_have_beat` 由 0 变 1），但设备仍无有效 BPM，剩余阻塞项定位到 `8 × 噪声` 闸门；同时确认工频干扰不来自信号源侧。详见 模拟器连续采样与心率核验报告（原报告本地资料链接，原件未随本包公开）。下文 `R4_HUMAN_REPLAY = PARTIAL / NO_VALID_BPM` 等结论仍然成立。

日期：2026-10-12（Asia/Shanghai）。本轮依据用户“已断开，请进行修复”的说明执行；硬件测试期间保持人体电极断开，仅使用 ADS1292R 内部测试信号。没有再进行人体采集。

## 1. 结果

**软件首拍恢复修复已集成并烧录，普通回归和内部信号 Smoke 通过。** 真实人体功能验收仍未完成；上一轮 50 Hz 干扰的具体来源没有因此闭合。

- 生产工程只修改 `心率+呼吸/HARDWARE/pan_tompkins.c`，新增 26 行；当前源码 SHA-256：`faee8e201d8d7ff02ee4cb428ba321b3b154ce86febac1ee2735c4d7aafab364`。
- 17 个首拍/正常输入/噪声/恢复场景通过，旧版同输入的失败记录保留。
- 原有 8 项采样时戳回归通过；当前 R4 基线与 R5 修复版的该测试输出逐字节一致。
- 普通固件及内部测试副本均为 Keil ARMCC 5.06 update 7 构建，退出 0，0 Error / 0 Warning。
- 断开电极后的内部信号记录连续 2500 点，数字帧、SPI、队列和周期检查通过。
- 已切回普通修复固件，VerifyBin 和独立全片回读一致；诊断记录镜像未作为运行固件保留。
- 未进行 Git add/commit/push、安全扫描或其它项目功能开发。原始人体 RAM/CSV仍留在本机私有目录。

## 2. 最小修复

旧逻辑在学习期结束时用学习期极大值设置 SPKI，之后只有接受心拍才更新 SPKI。若初期幅值较高、后来降低，首拍可能永远达不到门限，回搜也因没有首拍/RR而无法启动。

新逻辑仅在 `s_have_beat==0` 时，按采集时戳维护一个 **2000 ms 观察窗**。完整窗口结束后，将过期 SPKI 向近期积分峰值与原有噪声下限的较大者下调；不会在每点持续急降，也不会因主循环排队消费改变窗口时间。uint32 无符号时间差支持回绕，输入失效/重新初始化时清除恢复窗口状态。

保留原有 `8×noise` 闸门、绝对底限、局部极大值判定、不应期、T 波判断、至少三个有效 RR 和超时撤销逻辑。窗口峰值不会被直接当成心拍，也不重置 FIR 来制造峰值。获得首拍后，原有判拍更新路径继续运行。

本轮未调整中值/伪迹门限、FIR 系数、显示倍率、采样率、SPI、PG15 START、CAN、屏幕协议或呼吸算法。新增状态仅 `uint32_t` 时戳与 `float` 峰值，普通固件增加 RAM **8 B**。

## 3. 普通 Host 证据

测试采用生产 FIR 系数、float32 单点 FIR 数学实现及实际生产 Pan-Tompkins C 代码，不等同于 ARM 上的 CMSIS 优化实现或临床验证。固定夹具、随机种子、编译命令和旧/新源码身份均归档。

| 场景 | 旧版 | 修复版 |
|---|---|---|
| 正常 60 / 90、负向 60 脉冲 | 有效；输出 60 / 89 / 60 | 与旧版完整结果相同 |
| 高幅值启动→稳定 60 | 20 秒虚拟输入均无有效值 | 首次有效 7508 ms，最终 60 |
| 高幅值启动→稳定 90 | 均无有效值 | 首次有效 8508 ms，最终 89 |
| 高幅值启动→更小幅值 60 | 均无有效值 | 首次有效 7508 ms，最终 60 |
| 高幅值启动并跨毫秒回绕 | 均无有效值 | 与直接 60 场景一致 |
| 已知 QRS 脉冲叠加 50 Hz | 均无有效值 | 首次有效 7508 ms，最终 60 |
| 零、直流、纯 50 Hz、纯 10 Hz、慢漂移、固定种子噪声、启动大幅值后噪声 | 全程无有效 BPM | 全程无有效 BPM |
| 断流尾段、恢复、显式 200 ms 输入缺口 | 原首拍故障阻止恢复 | 尾段无有效值；恢复检出；缺口后撤销旧值 |
| 25 点批量消费 | 均无有效值 | 首次有效时刻及最终值与直接消费一致 |

这些数值来自虚拟时间夹具；不是受测者心率。90 输入产生 89 是当前 4 ms 时戳/RR取整数条件下的已有结果，测试采用 ±1 容差，没有修改心率输出校准。

原有 8 项时戳回归重新编译旧/新当前输入，均输出：

```text
checks=8 failures=0 direct_hr=60 direct_rr=15 hash=d44467a881e07813
```

旧 R2 回执的滤波 Hash不同，因为当前工程此前已由 Gemini 将输出倍率提高 10 倍；本轮比较的是同一 R4 输入身份的旧/新算法，而非把 R2 输出冒充当前基线。

## 4. 既有人体数据的限定回放

以 R4 记录的固件滤波值作为输入，从其末端 RAM 的 SPKI/NPKI 播种，分别运行旧/新实际 C 阈值路径。原始前 6 秒/学习期和完整初始状态未保存，所以该回放只作为相同播种条件下的差分，不能声称完整重演了原试验时间线；也不是原始 ADC→中值→伪迹→FIR 全链路重放。

| 项目 | 旧版 | 修复版 |
|---|---:|---:|
| 输入点数 | 2500 | 2500 |
| 结束 SPKI | 7.1477706×10⁻⁷ | 8.6910440×10⁻⁸ |
| 结束 NPKI | 2.1483217×10⁻⁸ | 2.1483217×10⁻⁸ |
| 有效 BPM 点数 | 0 | 0 |

陈旧 SPKI 的高门限已经能够恢复，但该噪声数据仍被原有噪声闸门拒绝，状态为 **PARTIAL / 未取得有效 BPM**。没有降低 `PT_SNR_GATE=8` 来追求显示数字，也没有将这个结果标记为人体功能 PASS。

这说明后续仍需处理信号质量和独立 QRS 对照。约 50 Hz 成分的来源、导联/参考端/供电完整条件，以及呼吸功能仍为剩余项。

## 5. ARM 资源与镜像

普通固件由原工程 `USER/HR_TFT.uvprojx` 实际重建；内部测试副本复用 R4 的一次性记录层，只在副本中设 CONFIG2=0xE3、CH2SET=0x45。生产普通配置保持正常输入，测试后通过普通固件初始化恢复。

| 项目 | R4 普通 | R5 普通 | 本轮内部测试副本 |
|---|---:|---:|---:|
| Code | 25604 B | 25820 B | 26432 B |
| RO | 1488 B | 1488 B | 1488 B |
| RW | 452 B | 460 B | 460 B |
| ZI | 11884 B | 11884 B | 102028 B |
| RW+ZI | 12336 B | 12344 B | 102488 B |
| 静态剩余 SRAM | 118736 B | 118728 B | 28584 B |
| BIN | 27172 B | 27388 B | 28000 B |

普通代码 +216 B、RAM +8 B。诊断副本的 90144 B 记录结构只存在于副本中，普通修复固件不分配它。静态余量不作为运行栈安全或患者保护证明。

```text
普通修复 BIN SHA-256:
9f58a8902da3ba35c30c2d736f416c75a68e578a69835a2ed94ded9d1ad58281
普通修复 AXF SHA-256:
c764211e9eb949ce7f355334f7695801049755e7ac0f11e6b6a8c09f70ea67a7
内部测试 BIN SHA-256:
b125f0c1ace7ea0d7d82a30128a8e16c49cb7cb1a0542191c5cb7f46a678b2cd
内部测试 AXF SHA-256:
f037242625f02dbc3f77750f3622a16b5906f907a2212ec88e06c4b275b0b5b9
```

## 6. 电极断开后的硬件 Smoke

烧录前重新核验 UID、两次完整 Flash 读取及 R4 结束 Flash SHA。均一致后加载内部测试镜像，一次性录制，再切回普通修复固件。COM18 本轮未打开，没有人体采集、冷断电或外部故障注入。

| 项目 | 实测 |
|---|---|
| 内部信号 seq | 1159→3658，连续 2500 点 |
| 首末样本时戳 | 6003→16008 ms |
| DWT 首末跨度 | 10.004660 s，按名义 168 MHz 换算 |
| IRQ 间隔最小/中位/最大 | 4003.21 / 4003.46 / 4003.74 μs |
| STATUS/flags/映射异常 | 0 / 0 / 0 |
| 全部点正常处理 | 2500，完成标记 1 |
| SPI / bad_status / queue_overflow / init_errors / long_gap | 累计均 0 |
| 队列峰值 | 8 |
| CH2 最小/最大 | −15395 / 12687 码 |
| 半周期中位数 | 0.512444 s，19 次转换，周期稳定 |
| 波形频率 | 约 0.975717 Hz；不写成精确 1 Hz |

**内部方波测试验证 ADC/SPI/记录连续性，不能替代已知心电 QRS 模拟器验收新算法。** 不将方波检测数字称为人体心率或呼吸率。

结束普通修复固件运行核验：ready=1，IRQ/captured/delivered=533/533/533，SPI/STATUS/溢出/初始化/长间隔错误累计 0。VerifyBin 与独立回读的正常应用区 SHA 均为上述普通 BIN SHA，首 32 KiB 以外 Flash 与本轮原件一致。

```text
烧录前双读 1 MiB SHA-256:
a4132707f25077b2c27b0d51da0b6796f1b5afb4c7f5219f5378069f2da140a0
内部测试原始 RAM SHA-256:
516ddb05eb2fa6c990ce1d08123cd0e3822613da07237047a1a588d6d9af0162
最终 1 MiB Flash SHA-256:
6d44275aac8edec2ab2892d543a1658032fdd515421ca6a6de961bdb9f1c343e
```

## 7. 证据与后续条件

新增材料位于 `排查证据_20261010/R5_首拍恢复修复_20261012T181825/`，包括精确单文件 Patch、17 场景原始对照、回放输出、8 项回归、ARM 输入及 SHA、硬件回执、内部波形/CSV和归档 Hash。Host-01/02 历史输出、旧版未检出记录、R4 人体采样与失败报告全部保留。

板上当前是普通修复版本。下一轮可用合格心电/阻抗模拟器做已知心率/幅值/呼吸周期对照。真人复测仍需 USB、J-Link、供电及患者保护完整路径的核验资料，单独“USB隔离已做”的说明不足以关闭这个条件。本轮未将真人复测条件视为通过，也没有再次要求贴回人体。

```text
FIRST_BEAT_RECOVERY_FIX   = COMPLETE (single production source file)
HOST_FIXTURE_VALIDATION   = PASS (17 scenarios)
TIMESTAMP_REGRESSION      = PASS (8 checks; same R4 baseline results)
ARM_BUILD                = PASS
INTERNAL_ADC_SMOKE       = PASS (limited window; electrodes disconnected)
FINAL_NORMAL_READBACK    = PASS
R4_HUMAN_REPLAY          = PARTIAL / NO_VALID_BPM
50HZ_INTERFERENCE_SOURCE = OPEN
HUMAN_FUNCTIONAL_TEST    = NOT_REPEATED
HUMAN_PROTECTION         = NOT_VERIFIED
```
