Serendipity-min/medical-multi-parameter-monitor/node-b/history/新算法_v2/USB烧录与去JLink对照准备_20261013.md

# USB烧录与去J-Link对照准备

2026-10-13。状态：**接口资料及对照方案已核对；尚未执行USB烧录或无J-Link采集。**

## 能检查什么

USB烧录可以帮助建立不连接J-Link的测试条件，但烧录动作本身不测电源质量。若采集期间仍通过USB连接电脑，电脑供电与公共地路径仍存在，只能先判断**J-Link连接整体的贡献**，不能把结果单独归因于电源或地线。

## 当前板卡的两条USB下载路线

当前Windows枚举为`USB-SERIAL CH340 (COM15)`。用户提供的`E:/stm32/stm32文件/STM32F407_原理图.pdf`为神舟号V2.0资料，包含USB_232→CH340C、USART1连接和RTS/DTR下载电路；另有USB_SLAVE→PA11/PA12的原生USB路线。资料版本仍需与实物接口一致。

| 路线 | 接口／信号 | 要求 |
|---|---|---|
| USB_232串口ISP | CH340桥接USART1；MCU PA9→桥RXD，PA10←桥TXD | 进入芯片系统ROM Bootloader；核对BOOT0、BOOT1及复位／自动下载电路 |
| 原生USB DFU | USB_SLAVE数据接PA11/PA12 | 核对USB/CAN共享连接及实际跳帽；进入系统ROM，配置合适的DFU工具 |

F407支持USART1和USB OTG FS DFU系统Bootloader路线，具体启动条件以ST资料为准。[ST STM32F4硬件开发说明](https://www.st.com/resource/en/application_note/dm00115714-getting-started-with-stm32f4xxxx-mcu-hardware-development-stmicroelectronics.pdf)

USB_232不是原生DFU接口，不能把COM15当DFU设备。当前存在`E:/stm32/stm32文件/ATK-XISP.exe`；常见默认安装位置未发现STM32CubeProgrammer CLI，没有安装工具或修改系统环境。

本轮BOOT／跳帽均未改变。未来使用串口ISP时，应先核对BOOT0如何进入系统ROM；当前BOOT0硬接GND不能凭假设交由自动下载电路强行拉高。下载后要恢复Flash启动并验证精确BIN。这些是下一轮操作前的接线核验项目，**当前不要调整**。

## 数据出口是独立问题

现有正常固件USART1用于串口屏，原始样本通过J-Link读取RAM；USB_232当前没有原始ADC采集协议。**USB烧录成功不会自动产生无J-Link原始数据包。**

下一阶段需要准备一个独立诊断采集出口，选择以下一种：

1. USB_232串口原始数据诊断副本：固定同一SPI／RLD／MUX条件、完整原始帧、IRQ序号／时间戳、错误计数及CRC；串口不与屏协议混发。电脑工具保留原始字节、坏包、缺口和身份。
2. 自主RAM留存：采样期间不连J-Link，停止采样后再连接读取；必须证明容量、停止边界、RAM未被复位／重连破坏以及导出完整。

当前这两种新数据出口**尚未实现及验收**。不会把重新连接J-Link后的实时数据称为断开期间的数据，也不会使用约0.512秒的既有环形窗口冒充完整静默采样。

## 建议的第一组对照

使用同一份经验证的诊断BIN、同一USB采集工具、相同输入／接线／供电与采样窗口：

- U0：J-Link物理连接，调试程序关闭，不进行SWD读取，数据走USB。
- U1：确认板由USB稳定供电后，断开J-Link到目标的**全部**连接，数据仍走同一USB路线。
- U2：恢复U0连接复测，观察时间漂移。

若研究SWD读取活动，应另做“J-Link连接不变，读取开／关”的单变量对照。不能将“原来用SWD采集、后来用串口采集”的差异全部解释为J-Link影响。

## 改线前必须明确

- 3V3线是VTref参考输入还是实际供电输出；仅看丝印或VTref=3.3V不能确定。[SEGGER VTref说明](https://kb.segger.com/VTref)
- 板上USB_232供电、选择开关与防倒灌路径。资料图显示VUSB经保险／选择开关给板上5V和稳压器供电，但实物版本须核对。
- 模块GND继续与开发板GND相连；不能通过断开这根地线观察噪声。
- USART1接线与串口屏需按诊断出口方案处理；未准备出口前不修改当前串口线。

若要继续区分供电来源和电脑公共地贡献，还需要独立供电，以及相同回流路径或独立记录条件。现有设备不足以完成这一分离实验。

本轮准备材料：原理图相关页面渲染保存在`证据/USB对照准备/`。本方案没有改变正常算法、烧录方式或任何硬件连接。
