Serendipity-min/medical-multi-parameter-monitor/node-b/history/标准采样工具实现与脱机验收回执_20261013.md

# 标准采样工具实现与脱机验收回执

日期：2026-10-13。版本：`acq/1.0.1`。范围：创建遵循采集数据协议 v1.0 的主机工具，复用现有 SWD 适配模块，完成普通脱机验证。

## 1. 交付与入口

使用说明：`工具/标准采样工具使用说明_v1.0.md`。

| 新增文件 | 用途 |
|---|---|
| `工具/acq.py` | init、precheck、capture、import、validate、analyze、compare 命令 |
| `工具/acq_storage.py` | 镜像/符号核验、唯一轮次、清单与数据集索引 |
| `工具/acq_swd.py` | 有界 Commander 交互、实际 IO 区间、STOP、暂停/恢复确认 |
| `工具/acq_processing.py` | 严格重建导出、类型明确的状态、分段、表征和分组对比 |
| `工具/开始标准采样.ps1` | PowerShell 便捷入口，默认仅预览 |
| `工具/tests/test_acq.py` | 普通脱机、负向和恢复路径回归 |
| `工具/标准采样工具使用说明_v1.0.md` | 操作、退出码、条件与限制 |

复用已有 `stable_slot_export.py`、`acq_protocol.py` 和冻结镜像 profile；本轮核对时这些模块已经存在增强实现，本轮没有覆盖它们。生产固件源码、BIN/ELF、其它项目和原始 R7 报告保持原件。

现有标准入口是 acq.py / 开始标准采样.ps1；旧采集脚本仍作为历史原型保留，不能据本回执认为所有旧入口已获得同等验证。

## 2. 普通验证结果

| 检查 | 真实结果与范围 |
|---|---|
| 普通 unittest | **27/27 PASS，退出码 0** |
| 真实磁盘 BIN/ELF/符号核对 | PASS，仅离线身份，未读取本轮板卡 |
| PowerShell 语法和默认预览流程 | PASS，退出码 0，仅本地文件操作 |
| 新 Python AST/空白检查 | 5 个 Python 文件 PASS |
| R7 完整原件导入 | **26591 个采样事件，53182 行双通道样本** |
| 冲突与尾段 | 39 个冲突序号全部保留，pending=0，选择跨度缺口=0 |
| 与独立复核对照 | 前26588条24 B记录逐字节 SHA 相同 |
| 原始文件与旧分析 | 原件不变；第二次分析使用新目录，旧分析继续保留 |
| 范围核对 | 本轮开始时记录的38个既有文件 SHA 无变化 |
| 新工具联板采集 | **NOT_PERFORMED，待首次台架验收** |

普通测试包括：不等票重复冲突、暂停不能强行覆盖冲突、空槽/非零无效槽分类、短块、活动写入槽排除、负数、清单漂移和自引用、序号缺口、复位归属歧义、DWT/ms 回绕、时间歧义分段、真实 flags、旧工具身份、设定值不伪造同步/准确度、模拟身份不符 STOP、IO 超时 STOP、未确认恢复不能声称运行，以及持久进程的迟到确认隔离和管道关闭。

模拟硬件测试启动的是 Python 文本模拟器，**不是 J-Link**；mock 捕获流程不是开发板实测证据。

## 3. R7 对照产物身份

完整稳定24 B记录 BIN SHA-256：

```text
af0c37a585fc7dc4f24d0d61afa027c44474361f5a4a8de58cae2f40bfc9f5db
```

前26588条记录 SHA-256，与此前独立复核一致：

```text
9ee9cd456b03785b39b375ef7a87158d5ed336941bc94f8cd66d6e1ad79d8de4
```

原始数据及波形保持在本地受 Git 忽略的 `OBJ/标准采集工具_R7脱机验证_20261013/`。历史导入身份明确为 UNKNOWN，暂停证据注明导入者声明；没有用当前磁盘镜像补造历史设备核验。该 PASS 仅指稳定重建/文件验证，不代表人体、模拟输入或算法准确度准出。

## 4. 失败记录与修复

最初23项回归有1项失败：误把 `s_rate[n]` 数组元素当成独立 ELF 符号。已改为核对数组整体基址、范围和索引；另修复模拟进程 stdout 管道关闭，并禁止失败后的迟到 DHCSR 确认被新命令复用。

失败和复测日志保存在 `排查证据_20261010/标准采集工具验证_20261013T123754/`，没有覆盖。`01_initial_tests.*` 为保留的真实失败日志，最终结果在 `05_final_tests.*`。R7首次导入和最终重新分析分别记录在04/06 JSON；范围核对在07 JSON。准确工具、测试和证据 SHA 见该目录的 `artifact_manifest.json`。

## 5. 当前能力边界

- 当前硬件入口限定非人体台架，并需显式 --execute / --confirm-no-human；不以按钮或声明证明患者保护。
- 仍使用运行中 SWD 重复重建，证据强度有限。真实 Commander V5.12 的交互、实际吞吐、暂停尾段与恢复确认尚待首次短时台架验证。
- BIN/profile 不匹配时停止，不自动烧录。实际采集计划包含一次 reset/go、末端一次 halt/RAM读取及恢复确认，属于会改变执行状态的调试采集。
- 时基为段内名义 ms 时间，原始 DWT/flags/计数保留；不宣称独立测得 ADC 物理边沿。
- 输出基础原始表征、状态和证据；独立参考同步、心率/呼吸准确度自动验收尚未实现。已提供模拟器设定也不伪称完成准确度评估。
- ECAP 连续串口仅为候选协议，当前板端未实现，COM18 不当作已验证原始数据口。

结论：**主机工具与脱机证据已准备好，可以进入负责人选择的首次短时非人体台架试采。尚不能写为新工具真机采集已通过。** 本轮硬件访问、安全扫描和 Git add/commit/push 均未执行。
