Serendipity-min/medical-multi-parameter-monitor/node-b/docs/PI-REVIEW/R10-W1-TLS-FIX-FIELD-RECEIPT-20261109.md

# W1 TLS 修复实板复测回执

**日期** 2026-11-09　**镜像** F-N115 `9dd76ede3e0bd963087377bb35209f9a2546a1ac1be148c2b9ad0e590c839c2a`。安装只写 C 的 sector0/4，整片写后核验通过，Options 和区外字节一致。 [离线排查及冻结制品](R10-W1D-TLS-OFFLINE-20261109.md)

| 项目 | 结果 | 证据 |
| --- | --- | --- |
| 启动门控 | PASS | 负责人确认 A 屏 PPG 连续，C 新启动横幅已绑定纯复位，仅发 1 次 START。 |
| 实板 TLS / MQTT | PASS | `TIME_WAIT` 第 7 次查询取得有效 UTC，粗授时 12.012 s。`GW OK SNI` 到 `GW OK TLS` 为 2.437 s，随后 `GW MQTT_CONNECTED`。 |
| 完整窗口 | PASS | 固件从 T0 到 `reason=10` 定时停止为 150,000 ms，主机观察跨度 150.172 s。主机没有发送 STOP。 |
| 115200 容量 | 缺口复现 | Broker 在窗内实收 1,222 批，按 150 s 为 8.147 批/s。C 入队快照净增 1,566 批，约 10.44 批/s。 |
| CAN / UART | 本窗未观察到错误 | 两段 CAN 的 `overflow`、`busoff`、ESR 均为 0，C 的 `uart_err` 为 0。 |
| 血压、W2、五板 300 秒 | NOT_RUN | E 参加五板通信，血压泵未启动。本批使用 F-N115。 |

真实 TLS 建链开始时距离 MCU 的 45 秒 T0 前上限已经不足 32 秒，落在旧版会拒发、新版允许发送的预算区间。Broker 统计剔除 2 条回放、1 条遗嘱和 1 条窗外记录。最后一批约在 T0 后 141.8 s 到达，固件末段停止接收新发布任务并执行排空。8.147 批/s 使用完整窗口作为分母。

窗末锁存时实时队列 24/24，历史队列 56/56，`publisher.pending=0`。累计实时溢出 132、顶替 188、丢弃 277；这些计数含不同事件口径。C 侧确认 566 个 QoS0 transport 和 659 个 QoS1 PUBACK。PUBACK p50/p95/p99 桶上界为 250/500/500 ms，实测最大 460 ms。固件未输出连续的 QoS1 槽位高水位。

| DWT 项 | 首末快照差分 | 周期/次或字节 |
| --- | ---: | ---: |
| `svc_cyc/svc_n` | 635,405,286 / 3,127,237 | 203.184（25.398 µs/次） |
| `tx_cyc/tx_b` | 549,609,087 / 586,793 | 936.632 |
| `await_cyc/await_b` | 57,515,661 / 53,401 | 1,077.052 |
| `rxstep_cyc/rxstep_b` | 21,037,436 / 60,499 | 347.732 |
| `irq_cyc/irq_n` | 7,288,896 / 113,889 | 64.000 |

`svc_max_cyc` 为 53,340 周期，`can_rx_a/b` 差分为 9,057/46,577 帧。计算使用 8 MHz 和首份 T0 后快照到末份诊断，含少量停机收尾。实测均值高于 R8 单板约 74 周期，低于 R10 判读的约 30 µs 门槛。本窗支持容量缺口复现，业务回调开销是否构成主要原因仍待定位。

| Broker 流 | 实收 | 其中有效 | 平均 / 最大到达间隔（ms） |
| --- | ---: | ---: | ---: |
| ECG | 319 | 319 | 441.9 / 989 |
| RESP | 121 | 0 | 1,170.3 / 2,746 |
| PPG | 126 | 125 | 1,119 / 2,272 |
| HR | 139 | 139 | 1,009 / 1,710 |
| RR | 139 | 0 | 1,009.2 / 1,782 |
| SpO₂ | 51 | 50 | 2,714.8 / 6,137 |
| PR | 48 | 47 | 2,990.3 / 8,026 |
| TEMP | 139 | 139 | 1,009 / 1,810 |
| 节点状态 | 112 | 112 | 1,221.3 / 4,759 |
| 网关状态 | 28 | 28 | 5,002.7 / 5,242 |

表中保留 INVALID 的实际网络负载。各流未观察到表观年龄超过 5 秒的到达。Windows/VPS 时钟比对最短往返为 477.91 ms。 [逐秒到达表](R10-W1-TLS-FIX-ARRIVALS-20261109.csv)

受限原件保存在本机，串口 211 行，SHA-256 `1f01553d425ab7f8b45ff266c82f51a4ab464494dc811a7e1b4a3049992cc2a4`。Broker 原件 SHA-256 `290ac5303f0396b573e7fedffc5a2860240fc2247d4671834a86cc959fade7e2`。受限台账 7 条，SHA-256 `5e7460d86b7a705179e93e5268d8f5d3babf4dc0f61d77b4b13801abe830e6ef`。上一条取消的提示消耗 0 次，本次消耗 1 次，剩余 3 次。负责人确认五板与工装全部断电、C 灯灭、热点关闭。隔离 Broker 已停止，隔离监听已关闭。
