Serendipity-min/medical-multi-parameter-monitor/node-b/history/内部对照诊断_20261013/内部对照真机实测与恢复综合回执_20261013.md

# ADS1292R内部对照真机实测与恢复综合回执

日期：2026-10-13。窗口：`窗口_20261013T092102Z`。

## 1. 本轮结论

- **内部短接复采与内部测试方波均通过预先冻结的工程筛查。** 最小任务、低速SPI配置下，连续转换、双通道读取、补码解析和队列交付工作正常；实际寄存器回读与A/B配置一致。
- **修复了一项真实的主机采集工具问题。** 首次SHORT采集出现2.125秒主机轮询停顿，造成481帧原始观察缺失；板端驱动未报告丢样。失败数据与报告完整保留，修复后复采验证。
- **内部短接仍有可测50Hz底噪。** 通过本轮宽松工程筛查不等于达到器件本底噪声规格，也不证明整个模拟链路完全正常。
- 本轮没有测心率／呼吸率精度。外部输入、RLD、呼吸调制和完整业务任务未在本轮验收；原有强50/100Hz与约25Hz成分尚不能唯一归因。
- **本轮原1MiB Flash已完整恢复。** VerifyBin及独立回读一致，结束时确认CPU未暂停、无LOCKUP标志。

## 2. 窗口与身份

用户明确确认：全部外部电极、人体贴片及模拟器连接已拔下，本轮保持断开。使用模块—F407—供电—J-Link的内部台架测试。

硬件核验：UID=`<DEVICE_UID_REDACTED>`；DBGMCU IDCODE=`10076413`，家族ID=`413`。J-Link执行文件SHA-256：`5a40b4293f708d27341ed0354ed0a2a4acefaf7c09bb7ad994951693d514cb56`。

使用准备方案中的PG15 START配置。芯片ID实际回读为73，初始化ready=1；250SPS下DRDY持续稳定。没有外部探头／逻辑分析仪独立验证CLKSEL或每个引脚电平，因此接线成功的结论来自本轮配置、身份与功能观察。

| 模式 | 精确BIN SHA-256 | 安装后全片Flash SHA-256 |
|---|---|---|
| SHORT | 35a93e35ab76afe68c0e2bfc237df5c4eeb4c06c42fdf194eac4b7e7220c5286 | bea49328f54c511c0838b8496747c9fc7bed9cf95994144c8bf1d7a8a5c15bb4 |
| TEST | 2323303d8577b9c331fa5402f3729c85a11d10b9e4ce0d00cadce76048042451 | f6fd70b98da6e18d76fdfe8aac96c9d814f7fce7abd2e6d9bcd5e80d1f50870b |

每次安装前重新核验UID与全片Flash双读；安装后VerifyBin、独立回读及sector0之外内容一致性核验通过。两套BIN与准备阶段相同，未为获得PASS修改固件或判据。

## 3. 三轮真实采集及首次失败

| 轮次 | run_id | 结果 |
|---|---|---|
| SHORT首次 | run-20261013T092336Z-28e67ec394d4 | REVIEW_REQUIRED；主机原始观察缺481帧 |
| SHORT修复后复采 | run-20261013T092803Z-d02828ebf8b4 | PASS_ENGINEERING_SCREEN |
| TEST | run-20261013T093041Z-fb1b859cc709 | PASS_ENGINEERING_SCREEN |

每轮主机采集约35秒，含芯片初始化。两轮通过数据的实际首末帧跨度约33.94秒，分析剔除首5秒后仍超过25秒。使用未滤波ADC码，不把采集方波送入生理率值算法。

### 首次SHORT为何缺观察帧

主机在约3秒的状态检查中首次导入 `analyze_internal`，连带加载NumPy/SciPy。IO原始记录显示：`slot_00020.bin`到`slot_00021.bin`间主机等待2.125秒，相邻请求相隔2.172秒，超过128帧环形记录约0.512秒保留时间。

板端IRQ、captured、delivered与诊断samples均为8481，SPI、溢出及长间隔计数均为0。导出仅8000帧，分为1–454与936–8481两个连续段。因此**本轮确认的是主机观察缺失，不能把缺481帧称作已证明的ADC物理丢样**。

修复仅将分析依赖加载移到J-Link连接／复位启动之前；采集模式、帧结构、固件与判据未改。普通Host回归48/48通过。复采最大主机等待降为0.204秒，TEST为0.203秒，最终完整重建所有已捕获帧。

首次原件、完整REVIEW_REQUIRED报告和原采集脚本／冻结清单均保留。另有第二连续段的限定观察结果，仅作噪声表征；首次整轮没有重新判为PASS。

## 4. 连续性与配置结果

| 指标 | SHORT复采 | TEST |
|---|---:|---:|
| IRQ / captured / delivered / 诊断samples | 均8479 | 均8481 |
| 导出双通道完整帧 | 8479 | 8481 |
| 序号 | 1–8479连续 | 1–8481连续 |
| 实际DWT跨度 | 33.939568s | 33.948019s |
| 中位采样率 | 249.797040SPS | 249.793326SPS |
| bad_status / spi_errors / queue_overflow | 0 / 0 / 0 | 0 / 0 / 0 |
| init_errors / long_gap_count | 0 / 0 | 0 / 0 |
| 队列峰值 | 1 | 1 |
| flags / 削顶 / 诊断序号缺口 | 均0 | 均0 |
| 实际CONFIG2 | E0 | E3 |
| 实际CH1SET / CH2SET | 41 / 41 | 45 / 45 |
| 实际RLD_SENS / RESP1 | C0 / 02 | C0 / 02 |

其余受核验寄存器回读均匹配准备方案；GPIO低位为输入电平，按既定mask核验。LOFF_STAT地址08未进行运行中寄存器读操作，诊断结构保留FFFFFFFF表示未回读，不能填预期值冒充测量。

时基采用名义168MHz DWT展开，没有独立计时标定。两轮均没有出现此前讨论的严重START／DRDY周期异常。

运行中SWD观察仍存在单次冲突：SHORT 8个、TEST 17个序号；全部原观察保留，按既有重复共识／暂停尾段规则认证。没有未认证pending、多次重复冲突、暂停版冲突或缺口；完整性不等于声称每次live读取都是原子的。

## 5. 内部短接：并非理想平直零线

分析首5秒后的真实未滤波数据：

| 指标／ADC码 | CH1 | CH2 |
|---|---:|---:|
| 均值 | −1394.34 | −1320.94 |
| 去均值RMS（标准差） | 44.14 | 60.23 |
| 范围 | −1492～−1302 | −1456～−1207 |
| 最大相邻跳变 | 122 | 151 |
| 49–51Hz带RMS | 42.27 | 58.52 |
| 99–101Hz带RMS | 8.50 | 12.02 |
| 24–26Hz带RMS | 2.17 | 2.59 |

这些值通过预设RMS≤500码、相邻跳变≤5000码的**工程筛查线**。直流偏置真实保留，没有强行归零；噪声主要含50Hz成分，仍有100Hz小成分。

由于外部输入已拔下、芯片MUX内部短接，至少这部分工频底噪不能只解释成模拟器输出或电极接触。供电／参考、公共地、USB/J-Link连接路径、板上耦合等仍需区分。当前数据不能指出其中某一条路径，也不能凭RMS量级认定模块损坏。

此前第二轮外部输入ECG标准差约332,527码，远高于本轮CH2约60码，但输入选择、RLD、RESP、任务负载和SPI速率也不同；该对比只能说明幅度差异，不能独立证明因果。

## 6. 内部测试方波：周期、幅值与双通道一致性

| 指标 | CH1 | CH2 |
|---|---:|---:|
| 频率 | 0.975756Hz | 0.975756Hz |
| 上升沿数量（分析窗口） | 29 | 29 |
| 周期CV | 0.0001975% | 0.0001975% |
| 半周期范围 | 0.512422–0.512432s | 相同 |
| 稳健低电平 | −15661码 | −15604码 |
| 稳健高电平 | 12794码 | 12891.9码 |
| 高低电平差 | 28455码 | 28495.9码 |
| 相对理想27962码差异 | 约+1.76% | 约+1.91% |
| 两平台附近样本比例 | 98.42% | 98.42% |

双通道相关系数0.9999988。观察到每周期约256个采样点，与实际约249.79SPS和约1.025秒周期相符；约0.9758Hz在预设0.95–1.05Hz范围内。本轮没有出现乱跳周期或断采造成的假周期。

方波边沿的阶梯／过渡样本完整保留，不用滤波美化；不能把边沿的大跳变按SHORT尖峰门限误报。TEST中的25/50/100Hz带功率还可能包含方波谐波，不能全部当成电源干扰。

## 7. 本轮收窄了哪些原因

| 原因方向 | 本轮允许的结论 |
|---|---|
| 主机采集工具停顿 | 已复现、定位并修复一次首次加载依赖的停顿；不证明此前外部数据的所有问题同源 |
| 最小任务采集调度／缓存 | 两轮通过数据无错误和缺口，支持该配置下正常；不替代完整任务验证 |
| START／DRDY严重异常 | 本轮未复现，周期稳定 |
| ADC内部转换／补码／双通道读取 | 已知内部方波正确，支持链路基本工作；外部通道映射仍需外部输入验证 |
| 共同工频干扰 | 内部短接也有残余，说明需要继续查公共路径，不能全部归因于外部输入 |
| 原外部输入约25Hz强成分 | SHORT该频段很小；由于外部源、RLD和RESP被同时旁路／关闭，来源仍未唯一定位 |
| 原完整算法、RLD、呼吸阻抗与模拟源适配 | 未验收 |

下一步建议保持同一最小采集框架和安全SPI时序，接入已知心率／幅值的**非人体主动ECG模拟器**，先单独验证ECG输入；随后逐项检查RLD连接／状态与呼吸调制，避免一次改变多个因素。若缺少已知输入，继续只能做质量表征。本轮没有开始这些追加硬件测试，也没有修改生产算法来制造有效数值。

## 8. 恢复与变更

原Flash两份1MiB备份一致。完整恢复SHA-256：

```text
551471d058b1d9865acf2b032d8406004892baf998118896598cac5de8c65735
```

J-Link `Verify successful`，独立1MiB回读与原件逐字节一致；日志显示实际重新编程仅sector0的16384字节。结束DHCSR=`01010001`：S_HALT=0、S_LOCKUP=0；确认边界是在断开调试进程之前，不宣称无限期运行状态。

本轮新增窗口安装／恢复脚本、离线图表和综合回执；诊断采集工具R1只调整分析库加载时机。诊断BIN、冻结生产代码、原BIO_V2算法均未修改。没有Security Gate、硬件冷断电、真实assert、Broker操作或Git提交推送。

## 9. 证据入口

- 原始波形、内部短接频谱与方波边沿（原报告本地资料链接，原件未随本包公开）
- 综合机器回执（原报告本地资料链接，原件未随本包公开）
- 完整恢复回执（原报告本地资料链接，原件未随本包公开）
- 窗口原件SHA清单（原报告本地资料链接，原件未随本包公开）
- SHORT复采原始与导出包（原报告本地资料链接，原件未随本包公开）
- TEST原始与导出包（原报告本地资料链接，原件未随本包公开）
- 首次SHORT不完整原件包（原报告本地资料链接，原件未随本包公开）

综合handoff.json SHA-256：`136819d1212210ee5f4ce6d3035f928020c00103a6e88e877549ada8fb3698c3`。

三轮raw_manifest所列原件已逐项复核SHA；首次失败报告仍为REVIEW_REQUIRED。原始HALT请求／确认时间、暂停RAM、芯片寄存器回读、冲突版本和恢复记录均保留，不覆盖历史失败。
