Serendipity-min/medical-multi-parameter-monitor/node-b/history/工频单变量诊断_20261013/工频干扰单变量实测综合回执_20261013.md

# 工频干扰单变量实测综合回执

日期：2026-10-13，时区Asia/Shanghai。主窗口`窗口_20261013T095324Z`，补充窗口`补充窗口_20261013T101256Z`。

## 1. 结论与未完成事项

**已复现一个显著影响内部短接工频底噪的配置因素：RLD_SENS中的CH2正／负感测选择。**

- RLD缓冲保持关闭、呼吸调制／解调保持关闭、相位字段相同，只取消CH2感测选择：CH2的49–51Hz带RMS从**1.572码升至60.888码，约38.73倍**；CH1也明显升高。
- 切回基线后，已认证的连续片段中CH2回到**1.558码**。返回基线整轮因1帧版本冲突仍为`REVIEW_REQUIRED`，仅该连续片段作为限定观察，**没有改判整轮通过**。
- RLD缓冲使能、呼吸调制使能、呼吸解调使能分别对照时，CH2仍为约1.50–1.70码，本轮未复现几十码级工频放大。小幅差异没有独立重复验证，不能宣称绝对无影响。
- 这解释了此前内部SHORT配置出现的几十码工频底噪为何会受到寄存器设置影响。**它没有定位干扰的电气入口，也不足以解释之前外部ECG的百万码异常。**
- **供电与电脑公共地路径尚未分离测试**：没有独立电源；J-Link“3V3”线供电方向仍未核实；当前采集依赖实时SWD，无法直接拔掉J-Link后取得完整静默窗口。
- 两个窗口均完成原1MiB Flash恢复、VerifyBin和独立回读。未修改冻结生产代码或原BIO_V2算法，未改接线、断开模块公共地或进行冷断电。

## 2. 真实测试条件

用户确认外部电极已取消。维持USB_232与电脑连接、J-Link四线3V3/SWDIO/GND/SWCLK接板上同名引脚，模块GND与开发板GND相连；本轮没有人为调整供电、线缆或位置。START使用PG15。

UID=`<DEVICE_UID_REDACTED>`，F407家族ID=413，J-Link报告目标参考电压3.3V。**参考电压读数不说明电流流向或供电路数。** 标准J-Link的VTref是参考输入，但当前实物仅有“3V3”接线描述，仍不能确认该线就是VTref。[SEGGER连接器定义](https://kb.segger.com/20-pin_J-Link_Connector)

所有条件均为两通道内部短接、增益4、250SPS、656.25kHz SPI、固定CHOP设置；不滤波、不计算生理率、不启用屏幕或CAN任务。外部电极、RLD负载与呼吸模拟负载未接入，因此不能评价RLD对外部输入的抑制效果或呼吸阻抗测量。[TI ADS1292R手册](https://www.ti.com/lit/ds/symlink/ads1292r.pdf)

主窗口四个条件ARM构建均0错误／0告警，普通Host **19/19通过**；补充三个条件ARM同样通过，宏配置／身份检查 **8/8通过**。各BIN均5200字节；Code=4560、RO=576、RW=64、ZI=4256字节。补充BASE的BIN与主窗口BASE逐字节相同。

## 3. 如何保证单变量对照

| 对照 | RLD_SENS变化 | RESP1变化 | 受测因素 |
|---|---|---|---|
| B0/B1 ↔ R1 | CC ↔ EC | 2A不变 | 仅PDB_RLD bit5，感测选择不变 |
| B1/B2 ↔ M1 | CC不变 | 2A ↔ 6A | 仅RESP_MOD_EN bit6，相位与解调不变 |
| M1 ↔ D1 | CC不变 | 6A ↔ EA | 仅RESP_DEMOD_EN1 bit7 |
| B2 ↔ S0 | CC ↔ C0 | 2A不变 | CH2正／负感测选择这一组字段；缓冲均关闭 |
| S0 ↔ L0 | C0不变 | 2A ↔ 02 | 相位字段；调制／解调均关闭 |

主序列：B0→R1→B1→M1→D1→B2。因新基线与上轮SHORT配置不同，追加S0→L0→B3验证感测选择和关闭状态下相位字段。

S0同时取消CH2正、负两路感测选择，改变的是一个感测选择因素，**不是声称只翻转一个比特**。B3恢复全部基线设置；影响估计使用配置只差目标因素的配对观察，不把所有相邻过渡都称为单变量。

除这两个目标寄存器和诊断模式ID外，其它受核验配置一致：CONFIG1=01、CONFIG2=E0、CH1SET/CH2SET=41、LOFF=F0、LOFF_SENS=00、RESP2=03、GPIO配置0C。实际回读均匹配，GPIO低位依既定mask核验。

## 4. 九轮真实结果

每轮主机采集约35秒；完整数据实际跨度约33.94秒，剔除首5秒。表中功率量均来自未滤波ADC码，49–51Hz Welch带积分的平方根；不是物理SNR或临床有效率。

| 阶段 | RLD/RESP1 | 捕获帧 | CH1工频RMS／码 | CH2工频RMS／码 | 完整性结果 |
|---|---|---:|---:|---:|---|
| B0 基线 | CC / 2A | 8482 | 1.683 | 1.546 | VALID_OBSERVATION |
| R1 RLD缓冲开 | EC / 2A | 8480 | 1.878 | 1.704 | VALID_OBSERVATION |
| B1 基线 | CC / 2A | 8482 | 1.521 | 1.552 | VALID_OBSERVATION |
| M1 呼吸调制开 | CC / 6A | 8484 | 1.631 | 1.630 | VALID_OBSERVATION |
| D1 增加解调 | CC / EA | 8482 | 1.776 | 1.502 | VALID_OBSERVATION |
| B2 基线 | CC / 2A | 8483 | 1.452 | 1.572 | VALID_OBSERVATION |
| S0 取消CH2感测选择 | C0 / 2A | 8478 | **44.240** | **60.888** | VALID_OBSERVATION |
| L0 切回旧相位字段 | C0 / 02 | 8477 | **46.999** | **64.359** | VALID_OBSERVATION |
| B3 返回基线 | CC / 2A | 8481 | 1.883* | 1.558* | **REVIEW_REQUIRED** |

`*` B3值仅来自认证序号1–8460的33.862秒连续片段；不代表整轮完整通过。

九轮板端bad_status、spi_errors、queue_overflow、init_errors、long_gap_count均为0；源序号缺口和顶轨计数均为0。前八轮导出覆盖与板端计数一致，B3仅导出8480个已认证帧。

统计方法：完整轮首5秒后采用Hann窗、nperseg=4096、默认半窗重叠、每窗线性去趋势；按名义168MHz DWT展开得到各轮采样率。另保存5秒分块表征非平稳性；**同一轮内的块不是独立实验重复**。

## 5. 各因素解释

### RLD感测选择：显著、可复现的配置依赖

完整有效的B2与S0只差感测选择：CH2工频RMS约38.73倍变化，CH2总标准差由约11.29码变为63.25码。L0复现旧SHORT寄存器配置，仍为64.36码，与上轮几十码量级相符。

B3限定片段在原基线配置下恢复低工频值，支持返回趋势。**最直接证据是完整B2/S0配对**；B3不完整，不能据此宣称返回基线整轮准出。

结论是RLD感测选择字段影响内部短接噪声。它可能改变模拟节点负载／共模条件，但没有电气测量验证这一机制，也不能据此指定USB、J-Link、稳压器或电极为唯一噪声源。RLD_SENS感测选择与缓冲电源是不同字段，应分别记录。[TI ADS1292R手册](https://www.ti.com/lit/ds/symlink/ads1292r.pdf)

### RLD缓冲、调制与解调：仅见小幅差异

- R1相对B0/B1功率平均形成的参考，CH2工频RMS约+10.0%，绝对增加约0.155码。
- M1相对B1/B2参考约+4.3%，绝对增加约0.068码。
- D1相对M1约−7.8%，绝对减少约0.128码。
- L0相对S0约+5.7%；这一相位对照只有一次，不能排除时间／噪声波动。

这些不是独立重复试验，未计算显著性结论；不能写成“完全没有影响”。本轮没有证据支持它们在当前短接配置下造成几十码／百万码放大。解调改变CH1响应路径，CH1差异不直接等价于电源干扰变化。

当前各轮CH2的24–26Hz带RMS约2.1–2.9码，未复现此前外部输入的强约25Hz成分。外部输入与完整任务条件尚未测试，不能豁免该历史异常。

## 6. B3失败证据与处理

B3板端IRQ、captured、delivered及诊断samples均为8481。序号8461有两个不同的24字节观察版本：一次运行态`slot_00233.bin`，一次暂停态`final-paused-ram.bin`。差异在byte0、byte1（STATUS）和byte5（CH1最低字节）；CH1相差2码，序号、IRQ周期和ms相同。不是仅有填充字节差异。

既有认证规则拒绝用暂停版本强行覆盖冲突，因此序号8461未认证，导出分为1–8460和8462–8481。没有发现>0.3秒主机轮询停顿；这次失败与上轮首次加载分析库的2.125秒停顿不同。

该现象与运行态SWD读取跨越槽更新相符，但未证明具体硬件／读取内部原因。**不能将它记成板端真实漏采1帧，也不能宣称整轮完整。** 原件、REVIEW_REQUIRED报告及退出码1的补充序列日志全部保留。

另写`limited_segment_observation.json`只分析第一连续段，不覆盖原始结果；图上B3标星并加斜纹。未继续烧录追求PASS，结束后恢复原Flash。

## 7. 供电与公共地：当前仍待测

现在没有独立电源，电脑供电、USB_232和J-Link路径仍共同存在。不能通过本轮软件开关实验分离它们的贡献，也未证明实际有两路供电。

**目前不需要调整接线，模块GND继续与板GND相连；3V3参考／供电线保持现状。** 后续需要：

1. 独立稳定5V供电条件；确定开发板供电接入点及防倒灌路径，避免两个独立电源并接同一电源轨。
2. 确认J-Link型号或实物引脚／转接板资料，区分3V3是VTref输入还是供电输出，再给出具体改线步骤。
3. 纯电源对照保持其它连接与回流路径相同；同时换电源并拔电脑USB，只能归类为组合路径变化。
4. 电脑公共地对照保持模块—板公共地，改变电脑相关连接路径。现有实时SWD环形窗口约0.512秒，拔掉J-Link后不能保留完整采样；需先实现并验证自主RAM留存或独立记录，再安排断开期间的观察。

原生产配置已使用RLD_SENS=EC，含CH2感测选择。因此不能把本轮发现直接当作生产固件的修复补丁；之后应核验实际外部采集寄存器与输入条件，再做非人体已知源对照。

## 8. 恢复、产物与原件

两个窗口各自先进行当轮1MiB Flash双读；均为：

```text
551471d058b1d9865acf2b032d8406004892baf998118896598cac5de8c65735
```

两个窗口结束均`RESTORE_VERIFIED`，VerifyBin与独立全片回读相同，结束前运行状态确认。实际安装变化限定sector0，未修改其它Flash区、Option Bytes或硬件接线。

| 候选 | BIN SHA-256 |
|---|---|
| BASE | 80876d6760762a598c89ce6ccfe1c3332f32e493968e7227f12bbcf9ddbeb3a9 |
| RLD_ON | 5fb1d02632d84bf4c24e1a0f2bca3e0d41326ff7fe38605a33b732c58a71abe9 |
| MOD_ON | f5edaf6cb2eb9ddc5ad45284b96a154be72ae1e362665f337faa06c41b17afd4 |
| RESP_ON | 646c173e3f8b550a9f5bf290222f18dc15d9e7438ab29f48a81c06a4b31cc54d |
| SENSE_OFF | e08a9b3f65fa39d9b6e62a198c22ecc5a704268cd0ea89330682cb9b72ad8272 |
| LEGACY | 345ff6f3e217726d4cbe99237ac76246e28d17ec4178f13e440d5284f68ed109 |

完整ELF／BIN／profile SHA及资源记录在两个诊断目录的`证据/arm_receipt.json`与各条件profile中。所有原始快照、观察版本、时间记录、寄存器回读和失败均保留；原内部对照和原BIO_V2证据未覆盖。没有Git add/commit/push、Security Gate、冷断电、Broker操作或人体测试。

### 复核入口

- 单变量结果图，B3为限定片段（原报告本地资料链接，原件未随本包公开）
- 机器可读综合统计及逐轮原件路径（原报告本地资料链接，原件未随本包公开）
- 主窗口恢复回执（原报告本地资料链接，原件未随本包公开）
- 补充窗口恢复回执（原报告本地资料链接，原件未随本包公开）
- B3不完整原件包（原报告本地资料链接，原件未随本包公开）
- 后续供电与公共地对照条件（原报告本地资料链接，原件未随本包公开）

综合统计SHA-256：`37fe6c2b73bb0e6fe4dc1b37c8c46b4474e1ae4eecab5039123ea66f19408423`。
