Serendipity-min/medical-multi-parameter-monitor/node-b/history/新算法_v2/新算法设计与烧录实测综合回执_20261013.md

# 新算法设计与烧录实测综合回执

日期：2026-10-13，时区UTC+8。状态：**独立算法已实现、普通Host/ARM通过、已烧录并完成非人体采集；生理准确度未验证。**

## 1. 实施范围

新算法源码：`实验固件/HARDWARE/bio_v2.c`、`bio_v2.h`。在主项目内的独立实验目录工作，原工程和旧证据保持原件。

ECG/呼吸算法、滤波、峰检测、新鲜度与周期资格均独立编写。新构建移除了旧PanTompkins、RespRate、ECG_Filter及旧中值/保持预处理；新ELF符号核验没有这些旧处理函数。ST平台、已验证SPI/DRDY时戳队列及屏幕/CAN集成环境作为硬件接口使用，来源见`基础接口来源清单.json`，不声称全部外设代码均重新编写。

用户本轮确认“非人体模拟，没有明确心率/呼吸率”。据此执行烧录、正常软件复位和采集。输入是否主动输出呼吸阻抗、具体型号/设定未核实，没有连接人体的授权或准确度真值。

## 2. 资料与接线核对

阅读了`doc/B/ADS1292R模块资料V4.1 - 副本`的注意事项、中文手册及F407驱动例程，并结合[TI ADS1292R原始数据手册](https://www.ti.com/lit/ds/symlink/ads1292r.pdf)核对ADC与呼吸通道功能。资料例程的部分增益、RLD和引脚配置与当前平台不同，本轮以已验证采样配置做新算法对照，不直接复制例程的实验性寄存器改动。

| F407 | 模块 |
|---|---|
| PA0 | PW/PWDN |
| PG15 | START |
| PA2 | CS |
| PA3 | DR/DRDY |
| PA5 | SCLK |
| PA7 | IN/DIN，MCU MOSI |
| PA6 | OUT/DOUT，MCU MISO |

固定250 SPS，CH1为阻抗原始通道、CH2为ECG原始通道。增益4、内部参考及当前调制配置属于工程设定，不等于已经完成电压/阻抗校准。旧资料中的PA1 START不适用于当前接线。

## 3. 独立处理链

```text
同一帧两路signed原始码 + 源序号/采样ms/flags
       ↓ 断段/削顶清除资格，首点初始化直流估计
50/100 Hz有界双二阶陷波
       ├ ECG：5 Hz高通 + 25 Hz低通 → RMS门限/完整峰宽 → 新鲜周期窗
       └ 呼吸：慢直流跟踪 + 0.8 Hz低通 → 完整谷峰起伏 → 新鲜周期窗
       ↓ 至少3个新合法间隔 + 最近周期一致性 + 干扰资格
候选速率 / valid / 原因码 / 滤波波形，供界面和诊断读取
```

IIR系数按250 Hz及[RBJ二阶滤波公式](https://www.w3.org/TR/audio-eq-cookbook/)独立生成，不使用旧FIR系数或旧算法源码。全程静态、有界状态，逐帧常数开销；不引入RTOS、动态内存或新中断任务。

关键规则：

- 恒定大直流从首点建立基线，避免零初态产生虚假呼吸峰。
- 原始序号断段、flags、明显削顶或输入中断撤销资格。
- 候选峰时间与最后合法周期时间分开；非法候选不延长合法测量有效期。
- 超时清除周期资格与旧间隔，不因一个新峰复活旧速率。
- 速率失效保留流式滤波状态，不反复清零滤波造成新的阶跃。
- 至少3个新合法间隔，最近窗口间隔在中位周期20%内，才建立工程valid。
- 强陷波差分占比与低频能量资格在建立周期历史之前检查；不是先制造数值再隐藏告警。

工程支持范围：HR约30～220/min，呼吸6～40/min；ECG预热5 s，呼吸预热10 s。它们是原型的软件判据，**不是“正常人体范围”或临床认可阈值**。没有参考值时，范围内数值也不能作为正确心率/呼吸率。

公开原因位：1预热、2新周期不足、4周期不一致、8过期、16输入断段、32削顶、64强周期干扰、128宽带噪声资格不足。原因会保持失效语义直到新周期重建，不能只用最后一个能量比反推全部历史事件。

## 4. 普通Host测试

最终 **27/27 PASS**。涵盖：已知40/60/90/120/180 QRS夹具、6/12/15/24/30/40呼吸夹具、零输入、大直流、1/8/25/50/100 Hz非QRS正弦、适量50 Hz叠加、白噪声、u32回绕、超时/孤立峰不恢复旧值、足够新周期恢复、序号/flags断段、削顶和无新输入Getter失效。

首轮26/27，白噪声被呼吸低通变成慢起伏并产生误候选；增加建立周期前的低频能量资格，复测通过。原失败回执/日志保留为`证据/*.v1.*`，不宣称首轮全部通过。合成Gaussian QRS及正弦呼吸只作工程夹具，不代替真实或标准模拟器验证。

同一旧原始输入回放时，新算法比旧算法更保守；有效点减少不能单独证明准确度提升。本轮不通过调参把未知输入强制变成正常数值。

## 5. ARM构建与资源

Keil ARMCC 5.06 u7，最终退出码0，0错误、0告警。初版3个未使用的UI历史变量告警已清理，初版构建回执保留。

| 项目 | 原冻结版本 | BIO_V2 |
|---|---:|---:|
| BIN字节 | 27388 | 25112 |
| Code | 25820 | 24060 |
| RO-data | 1488 | 968 |
| RW-data | 460 | 336 |
| ZI-data | 11884 | 11728 |
| 静态RAM（RW+ZI） | 12344 | 12064 |

BIN小2276 B，静态RAM少280 B。未进行动态栈、CPU性能或H16测量，不用静态资源替代运行时证明。

精确产物：

```text
BIO_V2.bin SHA-256
226ca097e7b627d65b1b3144116062de03f9245b73705474452b6d06ed11341c

BIO_V2.axf SHA-256
d3f94a2aea2fcb967d0ff816f1ebc1316bbfc29fa2c8e91dbccd750bd978db4d

symbols.txt SHA-256
fed38bf4a2b15c3b96a1086e538a1476873c4c66244258a7ca0c5e362474a188
```

新诊断结构全部固定32位成员；Host sizeof=120 B、ARM ELF符号大小=120 B，结合新ELF基址生成字段表。没有复制旧RAM地址。

## 6. 烧录与启动实测

板卡UID及F407器件核验通过，原1 MiB Flash两次读取一致：

```text
6d44275aac8edec2ab2892d543a1658032fdd515421ca6a6de961bdb9f1c343e
```

候选VerifyBin及独立Flash回读通过；应用前32 KiB以外逐字节保持原件。启动阶段BIO2 tag/version正确，ADC ready=1，IRQ/captured/delivered均1158，未见驱动错误。

安装后完整Flash SHA-256：

```text
d1aeaef6139571adbbf2f59b754a9b5e0876ee7f63aeed2f2fa71fe941d616ec
```

原件及烧录日志在本地忽略目录`OBJ/biov2-hardware-*`，准确路径见`证据/latest_hardware.json`。结束再次读取完整Flash确认该SHA，随后做一次正常软件复位，清理调试暂停造成的未知物理时隙；非冷断电、没有再次烧录。最后live状态tag/version正确、样本424，断开前确认新BIO2正在运行。

**当前板上保留上述新候选，没有切回旧算法。** 原工程仍是旧版本。下一次采样使用本目录的新镜像入口；旧acq固定镜像入口将因Flash身份不同而停止，不能手工修改旧SHA掩盖变化。

## 7. 150秒新算法实测结果

数据轮次：`run-20261013T062935Z-7034545375b1`。目录为本地`OBJ/标准采集数据_v2/runs/`，UTC文件名不等于本地时区时间。

| 核对项 | 实测 |
|---|---:|
| 源事件/算法处理数 | 37136 / 37136 |
| 序号 | 1～37136，连续 |
| ms样本跨度 | 148.650 s |
| ms名义端点采样率 | 249.815 SPS |
| 原始版本冲突 | 32个，保留并按稳定规则处理 |
| pending | 0 |
| bad_status / SPI错误 / 溢出 / 初始化错误 / long_gap | 均0 |
| 队列峰值 | 8 |
| 新算法断段/削顶计数 | 0 / 0 |
| 已初始化算法状态快照 | 101份 |
| 快照心率valid | 7份，候选99/103/105/107/109/111 |
| 快照呼吸valid | 0份 |
| 最终两路速率 | 0，valid均0（无有效输出，不是生理速率为零） |

同一新原始输入Host回放：HR valid=3098/37136，约8.34%；候选84～112，呼吸valid=0。Host是逐点，实机是稀疏快照，两类计数不能互相冒充。最终样本序号、计数、两路valid/速率、候选/接受次数和新鲜间隔数等13项整数状态与保存ARM快照一致；不是ARM逐位数学或执行时间等价认证。

末端心率原因66＝强周期干扰失效后尚无新合格周期；呼吸原因2＝新鲜周期不足，末端只有1个新间隔。未重现旧算法“长间隔非法候选复活历史23”的策略：新引擎没有足够新资格就保持无效。

仅7份心率有效且呼吸全程未形成有效输出，**不能判定当前模拟信号/测量功能已经正常**。有效候选满足工程边界，但不证明真实心率；呼吸没有有效值，范围检查不适用。接下来需要可确认的主动ECG/阻抗输入及设定，才能决定是模拟输入、模拟前端还是算法资格需调整。

## 8. 文件与使用入口

- `实验固件/USER/BIO_V2.uvprojx`：独立Keil工程。
- `实验固件/HARDWARE/bio_v2.c/h`：新算法。
- `tests/run_host.py`：普通脱机测试及旧原始输入回放。
- `build_arm.py`、`make_profile.py`：普通构建与新地址表。
- `install_and_bootcheck.py`：默认预览；实际安装需显式执行且核对旧基线。当前板上已安装，**不要重复安装旧基线流程**。
- `capture_v2.py`：默认预览，实际采集需`--execute --confirm-no-human`；新建轮次、150 s、保留原件/标准CSV/状态/清单。
- `证据/host_receipt.json`、`arm_receipt.json`、`latest_hardware.json`、`latest_analysis.json`、`new_input_host_arm_comparison.json`、`final_board_state.json`：真实回执。

继续非人体采集示例：

```powershell
python -X utf8 '<LOCAL_PROJECT>\doc\B\心率+呼吸\新算法_v2\capture_v2.py'
# 核对计划与非人体条件后，显式执行；默认命令不访问设备。
python -X utf8 '<LOCAL_PROJECT>\doc\B\心率+呼吸\新算法_v2\capture_v2.py' --execute --confirm-no-human
```

原始文件与逐点数据留在本地忽略目录。v2输出沿用采集数据文件协议，但旧acq adapter/compare仍只支持旧镜像；尚未把v2加入通用入口的适配器注册，不应直接拿旧固定地址工具读取新固件。

## 9. 未完成项与判定边界

1. 模拟器型号、主动ECG/呼吸阻抗输出与参考设定未知；准确度未验收。
2. 当前输入未形成持续有效HR/RR；不能靠范围裁剪、门限降低或平滑图形宣告通过。
3. 新IIR/周期/输入资格阈值属于工程原型，仍需独立已知波形与更广的伪迹夹具验证。
4. 公共RAM状态快照不保证同一逻辑帧，需按coherence限制分析。
5. 已复用屏幕/CAN集成环境；旧“探头接入”提示仍依赖测量有效性，不能当作电极电气连接认证；帧完整度也不等于信号准确度。
6. 未开展人体验证、动态资源测量或临床准出。本轮是普通软件/台架测试，不涉及统一安全门或其他P阶段开发。

结论：**本轮新算法实现、构建、安装和采集工作完成；当前输入下的测量有效性与生理准确度仍未准出。**
