Serendipity-min/medical-multi-parameter-monitor/node-b/docs/FIVE-NODE-MIGRATION/FIELD01-20261106/DE-NIBP-WAITING-FIX.md

# E血压人工协作等待修正（2026-11-06）

**后续实板更新：等待修正后已完成101/67同次匹配和原90秒失效分项，见[有效实测报告](DE-NIBP-101-67-RESULTS.md)。下文为当时离线准备快照，NOT_RUN不代表最新实板状态。**

负责人已确认首次E窗口后**全部断电**，并要求“设置合理的等待时间”。首次窗口原生失败、E屏114/79与未捕获完成事件的事实保留，不能回写为通过。

## 修正后的时间安排

| 阶段 | 主机等待 | 起点 |
|---|---|---|
| 人工准备/启动 | 最多150秒 | 网络就绪后的共同T0 |
| 等待新测量完成 | 最多120秒 | C首次观察到E状态进入测量中 |
| 失效核对 | 95秒 | 隔离Broker实收到本次新血压结果 |

初次125秒计时从网络T0开始，把人工等待和测量完成混在一起；约第124秒才看到测量中，紧接着就结束等待。修正后测量阶段不会被这个旧的125秒条件提前截断。重复出现“测量中”不会重置或延长完成等待。

C原有420秒硬上限、E源端和后端90秒有效期、原设备状态机和2秒录音长度均不变；本次不录音。主机最晚在武装后395秒发X，另留15秒停止确认，最晚410秒收尾，未超过420秒。按实际联网消耗动态计算剩余预算；如果还不足以提供至少60秒人工启动等待、120秒完成等待和95秒失效观察，就在通知启泵前停止本次准备，不启动残缺的验收。

## 验证

9个定向离线用例原生退出0，覆盖真实消息解码入口及实际主机等待实现：

- 用首次实板约124秒进入测量、125秒仍在测量的时间点回归，不再提前中止；后续完成时刻为明确的合成夹具，不冒充本次实板数据。
- 人工等待与测量完成分别计时，缺少启动与缺少完成各自有界失败。
- 重复“测量中”不刷新deadline，联网过慢不扩大420秒硬边界，不截短95秒失效观察来制造通过。
- 保留旧/保留/旧A来源过滤、未写完的日志行再次读取、真实后端拒绝非法NIBP值的检查。

仅修改本机控制工具和相关测试，设备固件、90秒有效位规则、正式云、ACL与密钥均未变。接收端代码未再改动，复用此前真实SUBACK/五板profile/实际网页DOM记录的检查结果，不重跑旧矩阵。

## 下一次现场起点

保留已测C1–E1=61Ω、C2–D1=60.9Ω；下一次仅C/D/E及原外围供电，A/B断电，J-Link电脑端不接。先由负责人确认非人体工装和E屏已准备好，能够在收到提示后直接启动；链路就绪后及时发出一次手动测量提示，再依据E实际状态计时。泵仍完全由负责人本地手动操作。

新任务目录、冻结工具SHA与9项检查原生日志均登记在本机运行指针。修正后新实板窗口 **NOT_RUN**，没有自动重试、commit或push。首次TTS无ACK/STOP未确认仍是独立未解决项，不转成血压或五板失败根因。
