Serendipity-min/medical-multi-parameter-monitor/node-b/history/新算法_v2/真机验证准备_20261015/第二块F407自制ECG工程源方案.md

# 第二块F407作为非人体ECG工程信号源

2026-10-15，Asia/Shanghai。用户已确认第二块F407与采集板同型号、当前无现成模拟设备，模块插头为RA、LA、RL。源板计划J-Link烧录后拔掉探头，以12V/1A适配器供电。状态：**软件信号源已实现并通过脱机检查；实物DAC源是待核验设计，尚未编写/构建其ARM固件、接线、烧录或输出校准。**

## 1. 可以做到什么

第二块F407可输出已知节律的DAC波形，经过衰减/偏置网络给ADS1292R外部输入。这可检验外部输入→ADC→SPI/FIFO→算法的一条工程链路，优于把来源不明的波动当正常ECG。

STM32F407具有12位DAC，DAC1输出为PA4；输出缓冲、外部负载和校准会影响实际输出。必须核对第二块板的具体引出和板载负载，不能只依据芯片能力假定引脚空闲。[ST AN4566，STM32F407 DAC示例及校准说明](https://www.st.com/resource/en/application_note/an4566-how-to-extend-the-dac-performance-on-stm32-mcus-stmicroelectronics.pdf)

本地同款F407图纸把PA4标为DAC1_OUT；用户已确认同型号，但仍需核对第二块板的实物跳帽/附件负载。图纸ADC/DAC接口及板载网络已保存为 `采集板资料_ADC_DAC页.png`；没有把资料页当成第二块板实物照片。

### 用户拟用12V/1A适配器的核对

开发板原理图（原报告本地资料链接，原件未随本包公开）第3页明确标注J5/PWR为 **DC IN 6V～24V**，经SY8120降压得到约5.1V，再供3.3V稳压；K1按下选择外部DC，弹起选择USB。因此，若实物版本一致、适配器确为12V直流且插头极性与J5一致，该供电路线可用于非人体源板。

12V只进J5电源输入，不接5V/3V3输出针脚，不送ADS模块5V输入。1A是适配器额定能力，不是强制向板注入1A；不据此证明纹波低或输出已校准。开始连模拟输出前应测量源板5V/3.3V及输出偏置，板号/适配器标签、极性和供电选择留照片。

用户拟定烧录后移除源板J-Link；该路线不改变采集板的J-Link记录方法。单独拔掉源板探头不自动形成浮地源：后续信号/地线、适配器和其它设备连接仍决定参考路径。电源图证据另存 `开发板电源页_3.png`；本轮没有上电或测量实物。

## 2. 三类信号不能混为同一个验收

| 来源 | 已知条件 | 覆盖 | 不覆盖 |
| --- | --- | --- | --- |
| 纯软件工程样本 | 250Hz分配时戳，60bpm QRS/P/T夹具、15次/分正弦、已知削顶/恢复 | 最新真实C算法、原因码、逐通道保护与周期恢复 | 开发板/ADC/电极/RLD/呼吸调制 |
| 第二块F407 DAC工程源 | 输出频率/幅值经过独立确认后才成为参考 | 外部ADC输入链路、参考心率工程检出 | 医学波形真实性、患者安全认证；普通共地源不能代表浮地RLD闭环 |
| 专用ECG/阻抗模拟器 | 由型号、输出设置和校验资料确认 | 对应能力范围内ECG、患者等效网络/阻抗变化对照 | 不能仅凭外壳/波形显示宣称所有能力 |

呼吸测量的是阻抗变化。把第二路DAC输出低频正弦并不等于模拟呼吸阻抗；本次不把它接到CH1当作呼吸准确度源。

## 3. 已完成的软件源

工具：`software_ecg_source.py`。仅运行普通GCC编译与Host回放，不导入硬件连接类、不访问串口/J-Link。

```text
python -X utf8 doc/B/心率+呼吸/新算法_v2/真机验证准备_20261015/software_ecg_source.py
```

每次创建唯一新目录，可选 `--output` 指定一个不存在的目录，已有目录立即拒绝，不覆盖历史实测或失败记录。

生成四组数据：正常90秒、呼吸全程顶轨90秒、ECG全程顶轨90秒、正常→呼吸削顶25秒→正常恢复的120秒序列。每组保存输入CSV、实际C输出CSV，全部标为 `SOFTWARE_SYNTHETIC`；幅值单位为假定ADC码，时戳是程序分配值，不是物理测得值。

本轮普通Host编译退出0，**9/9检查通过**：正常HR60/RPM15、呼吸削顶时ECG逐帧不变、ECG削顶时呼吸逐帧不变、双方各自保护、恢复期间ECG不受影响、呼吸自身重新预热/新周期恢复、算法源SHA不变。产物保存在同目录 `软件信号源/run-20261015T020540888675Z/`，包含receipt和全文件SHA清单。

这项PASS只说明软件工程夹具，不是新一轮硬件结果。未来F407 DAC输出必须另外使用其实际DAC量化/模拟传递链校验，不能拿此ADC码夹具直接当DAC电压表。

## 4. 双板角色及候选实现

- **采集板A**：现有F407＋ADS1292R，PG15 START、PA5 SCLK等接线保持；使用最新通道独立算法。
- **源板S**：第二块F407，单独的工程/UID/Flash恢复原件；候选PA4为DAC1波形输出，若型号和板载网络允许，可用PA5/DAC2提供稳定偏置，不能与采集板PA5混淆。
- 波形更新采用固定定时器触发＋DMA循环表，拟定1kSPS、60bpm，使用静态表；不以主循环delay作为已校准节律，不加入随机噪声来制造逼真外观。
- 在输出末端、接入模块后的实际负载条件下核验频率、幅值、直流/共模及波形；记录DAC参考电压、实际时钟、分频/表长、量化、源电阻及电容。
- 每块板的身份与烧录范围分别确认，不把采集板UID/恢复原件套用到源板；本轮没有执行任何板卡操作。

仅第二块板本身还不够完成毫伏级模拟源。需要衰减电阻、参考偏置及独立测量；源板器材确认之后再冻结具体固件和接线。

## 5. 输出衰减与接线的设计边界

DAC不能直接接ADS模块RA/LA。首轮只做非人体差分工程输入，拟定目标约1mV峰峰值，实际值必须测得。

一种可审查的候选结构：把源板波形DAC经高值电阻Rhi送到信号节点；节点经低值电阻Rlo接到稳定偏置Vbias；另一输入接相同偏置，通过匹配的源电阻形成已知差分信号。理想关系为：

```text
Vsignal_node = Vbias + (VDAC_wave - Vbias) × Rlo / (Rhi + Rlo)
Vdiff = Vsignal_node - Vreference_node
```

例如仅作计算：若波形端1V峰峰值，Rhi=1MΩ、Rlo=1kΩ，理想衰减约1/1001，差分约0.999mV峰峰值。**这不是已批准接线或实测输出。** DAC偏置差、负载、板载电路、元件误差与滤波都会改变结果；PA5是否可作偏置输出也未确认。

候选偏置应处于DAC线性输出和ADS输入允许的共模范围，按模块实物电源/PGA条件核验，不用默认“接GND即正确”的方式取消共模要求。万用表可核验DC和电阻，但不能单独认证瞬态ECG峰峰值/形态；没有合适波形测量时，幅值只能标未校准。

暂不让用户执行RA/LA/RL新接线：需先确认板型、元件、测量条件、源板供电及实际适配线。图纸显示模块L/ELA至CH2正输入、R/ERA至CH2负输入，RL为RLD外部端；不按导线颜色推断、不把RL当数字GND短接。

### 为什么共地DIY源不能直接验收RLD

两块板USB/J-Link都接电脑，或源输出用低阻偏置强定共模时，源已经通过电脑地/偏置固定输入参考。RLD是否开启的差异不再代表对一个浮动等效人体共模的控制能力。

首个共地DAC工程源阶段定义为 `S_DAC_ECG_ONLY`：采集端使用最新算法、RLD缓冲关闭（CC）、CH2感测保留、呼吸调制/解调关闭（2A）；其配置对应拟议R0副本。外部RL不连接尚未审定的主动偏置输出，具体端接在器材确认后给出。它只验证外部ECG输入和算法，不算RLD对照的E0/R0实验。

完整RLD试验需另有合适的浮地源/参考与患者等效负载，或经核验具有该能力的模拟器。单纯拔USB却留J-Link或示波器地线，不等于浮地；不得在同一RLD比较中同时改源供电/电脑连接来获得“改善”。本次没有设计可接真人的模拟设备。

## 6. 当前需要补齐的条件与下一步

1. 同款板已由用户确认；仍需第二块板实物PA4/PA5附件/跳帽检查与照片。
2. 电阻、电容及测量条件，是否有万用表/示波器；供电方案已确定为J5接12V/1A，适配器直流/极性及实物电压仍待核验。
3. 原理图对应的RA/LA/RL适配线确认，尤其RL功能不能与GND混用。
4. 器材核验后再冻结源固件、输出网络和双板接线；先断开ADS模块测源，再在非人体负载下校验接入后的输出，最后才采集。
5. 外部工程源ECG链路通过后，保留原始数据并决定是否有足够条件开展RLD/呼吸对照。条件不足则维持PENDING，不自行改阈值或宣告全链路PASS。

当前完成：软件源＋9项脱机检查、外部源设计方向、最新固件/配置差异及验证计划。当前未完成：源ARM固件、实际输出网络、板型/元件/供电确认、校准、采集工具本轮绑定及所有真机测量。
