Serendipity-min/medical-multi-parameter-monitor/node-b/hardware/ADS1292模块电路原理图.pdf

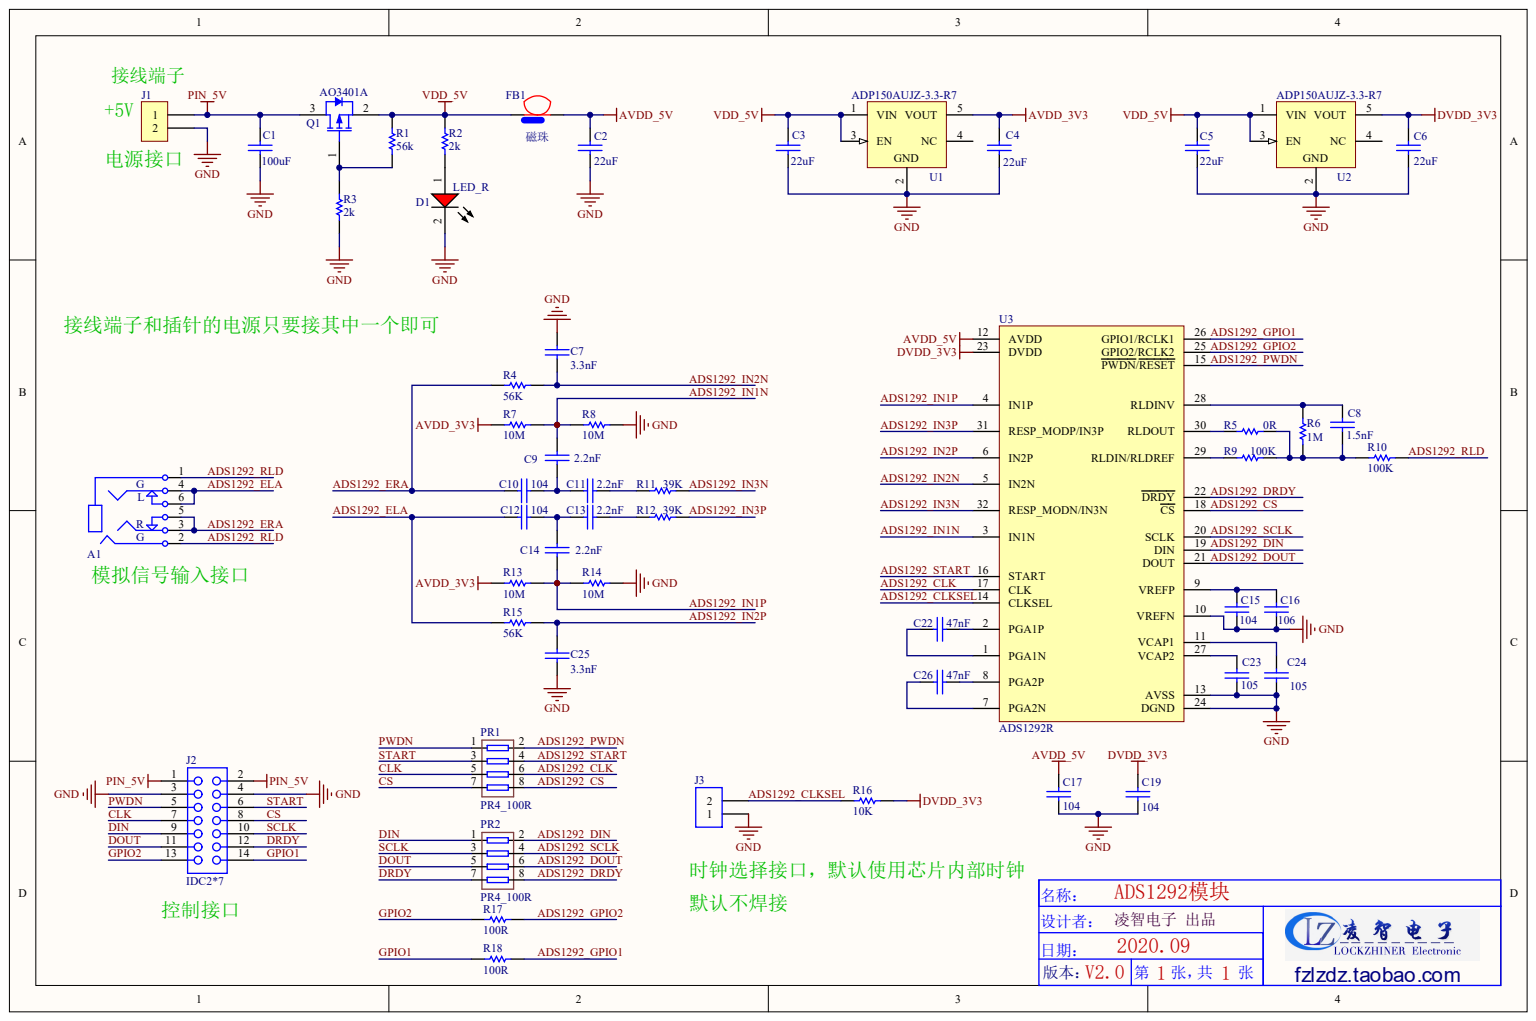
[picture p68: page 1]

设计者： 凌智电子 出品 2020.09 日期： | f z l z d z.t a oba o.c o m
