Serendipity-min/medical-multi-parameter-monitor/血压/HKB-08/HKB-08血压系列传感器/HKB-08A血压模块封装/PCB_PW195A V3.0 封装_2024-11-19.pdf

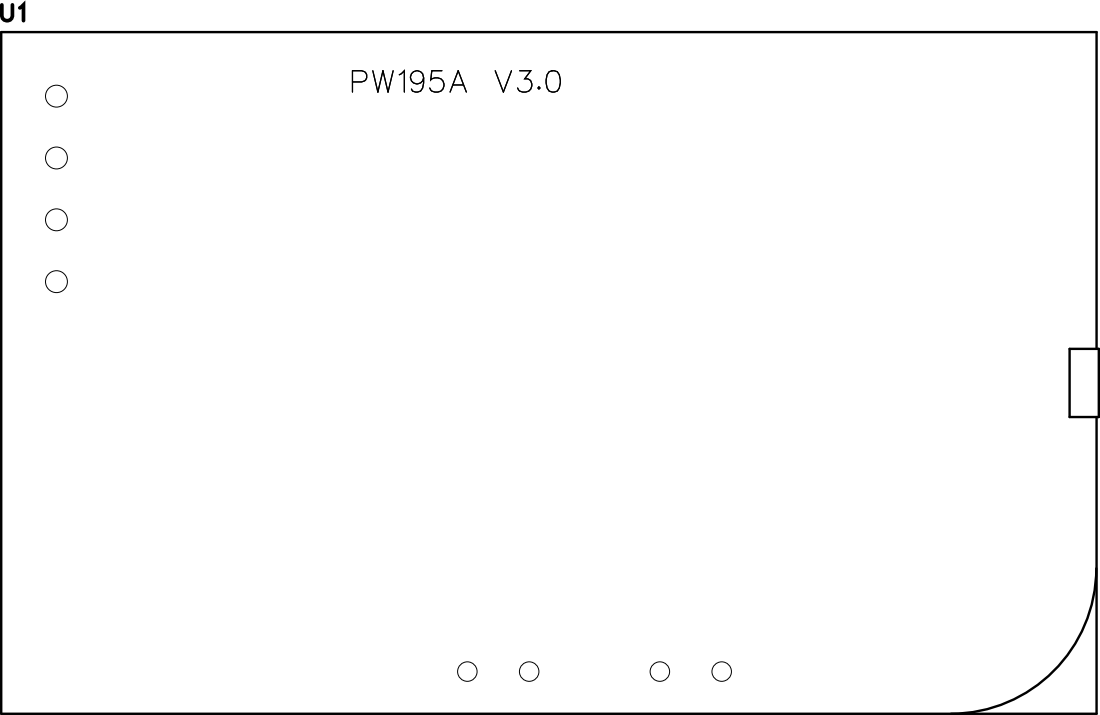
[picture p69: page 1]
