Serendipity-min/medical-multi-parameter-monitor/血压/HKB-08/HKB-08血压系列传感器/HKB-08A血压模块封装/SCH_PW195A V3.0 原理图_2024-11-19.pdf

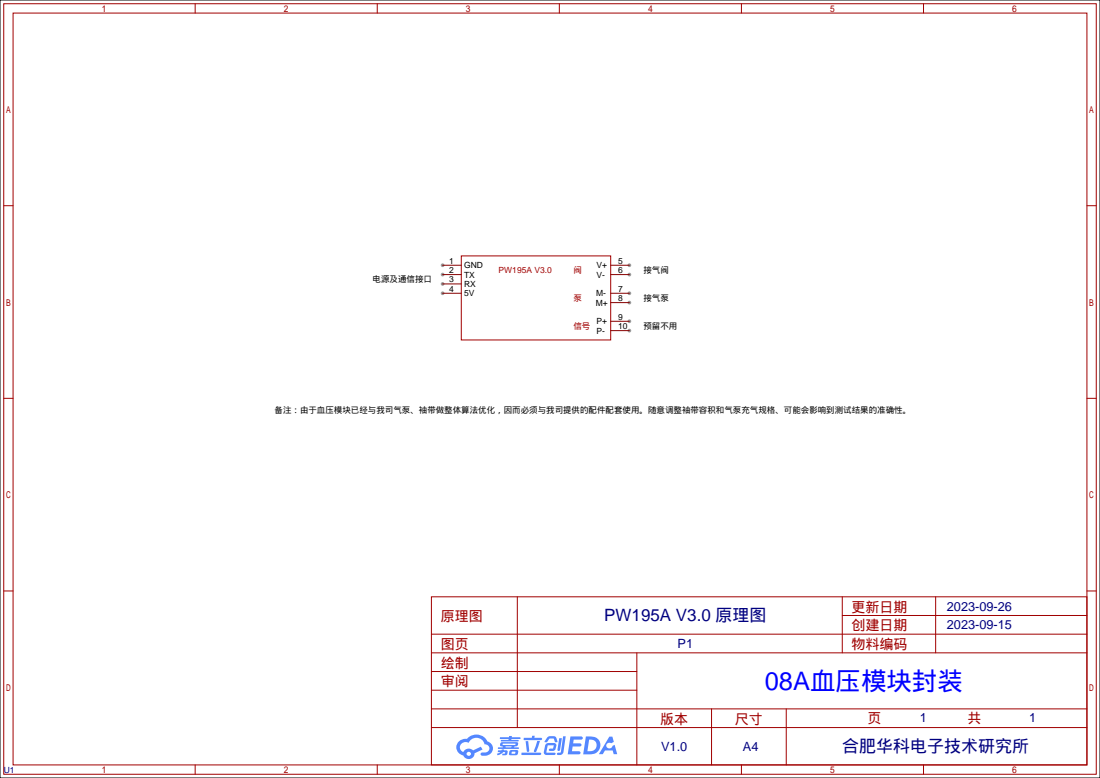
[picture p70: page 1]

备注：由于血压模块已经与我司气泵、袖带做整体算法优化，因而必须与我司提供的配件配套使用。随意调整袖带容积和气泵充气规格、可能会影响到测试结果的准确性。
