Serendipity-min/medical-multi-parameter-monitor/(list of files, drawings)

Other design files:
血压/HKB-08/HKB-08血压系列传感器/HKB-08A血压模块封装/Altium_20230915_血压电路_2024-11-19/Board_20230803/PW195A V3.0 原理图/1_P1.schdoc
血压/HKB-08/HKB-08血压系列传感器/HKB-08A血压模块封装/Altium_20230915_血压电路_2024-11-19/Board_20230803/PW195A V3.0 封装.pcbdoc
