Serendipity-min/medical-multi-parameter-monitor/体温/extracted/GY614615V3资料/C51/c51_usart/user/main.c

#include <reg52.h>
#include "usart.h"
#include "iic.h"  
#include "stdio.h"
/*
Keil: MDK5.10.0.2
MCU:stm32f103c8
硬件接法：
GY-614---STM32
1、GY-614_RX---STM32_TX
2、STM32_TX---FT232,STM32将数据上传给上位机
3、GY-614_TX---STM32_RX，接收模块数据
软件说明:
该程序采用串口方式获取模块数据，波特率9600行以上操作：
注：中断函数位于stc_it.c
联系方式：
http://shop62474960.taobao.com/?spm=a230r.7195193.1997079397.2.9qa3Ky&v=1
*/
char putchar (char c)   
{        
    ES=0;        
    SBUF = c;        
    while(TI==0);        
    TI=0;        
    ES=1;        
    return 0;
}
typedef struct
{
    float e;
    float to;
    float ta;
    float bo;
} gyir;
int main(void)
{

    u8 sum=0,i=0;
	gyir my_ir={0,0,0};
	Usart_Int(9600);
 	while(1)
	{
		if(Receive_ok)//串口接收完毕
		{
			 for(sum=0,i=0; i<(usart_rx_data[3]+4); i++) //rgb_data[3]=3
                sum+=usart_rx_data[i];
            if(sum==usart_rx_data[i])//校验和判断
            {
                my_ir.to=(usart_rx_data[5]<<8)|usart_rx_data[6];
                my_ir.ta=(usart_rx_data[7]<<8)|usart_rx_data[8];
                my_ir.bo=(usart_rx_data[9]<<8)|usart_rx_data[10];
                my_ir.e=usart_rx_data[4];
                printf("E: %.2f,",(float)my_ir.e/100);
                printf("  to: %.2f,",(float)my_ir.to/100);
                printf("  ta: %.2f,",(float)my_ir.ta/100);
                printf(" bo %.2f\r\n ",(float)my_ir.bo/100);
            }
						else
						{
							printf(" sum %d\r\n ",sum);
						  printf(" count %d\r\n ",usart_rx_data[3]+4);
						}
            Receive_ok=0;//处理数据完毕标志
      
		}	
	}
}
