Serendipity-min/medical-multi-parameter-monitor/体温/extracted/GY614615V3资料/arduino/arduino_usart/arduino_usart.ino

/////////////////////
/*
GY614----MINI
VCC----VCC
GND----GND
1:GY614_TX---10
2:GY614_RX---11
*/
//////////////////
#include <SoftwareSerial.h>
typedef struct
{
    float e;
    float to;
    float ta;
    float bo;
} gyir;
SoftwareSerial mySerial(10, 11); // RX, TX
byte add=0xa4;
byte len=0,start_reg=0;
unsigned char Re_buf[30],counter=0;
unsigned char sign=0;
gyir my_ir;
void setup() {
   Serial.begin(115200);
   mySerial.begin(9600);
   mySerial.listen();      
} 

void loop() {
  unsigned char i=0,sum=0;
  while (mySerial.available()) {   
    Re_buf[counter]=(unsigned char)mySerial.read();
    switch(counter)
    {
      case 0:
      if(Re_buf[0]!=add)
      return;
      break;
      case 1:
    
      if(Re_buf[1]!=0x03)
        { 
          counter=0;
          return;
      }
      break;
      case 2:
        if(Re_buf[2]<16)
         start_reg=Re_buf[2];
         else
            { 
          counter=0;
          return;
         }
      break;
      case 3:
         if((start_reg+Re_buf[3])<16)
            len=Re_buf[3];
            else
            { 
              counter=0;
             return;
         }
            
      break;
      default:
         if(len+5==counter)
         {  
            sign=1;
         }
      break;
    }
    
  if(sign)
  {   
     sign=0;
     for(i=0;i<counter-1;i++)
      sum+=Re_buf[i]; 
       counter=0;
     if(sum==Re_buf[i] )        //检查帧头，帧尾
     {  	       
        if(start_reg==0x07)
        {
         my_ir.to=(Re_buf[5]<<8)|Re_buf[6];
	 my_ir.ta=(Re_buf[7]<<8)|Re_buf[8];
	 my_ir.bo=(Re_buf[9]<<8)|Re_buf[10];
	 my_ir.e=Re_buf[4];
        }
      	 Serial.print("E:");
         Serial.print((float)my_ir.e/100);
	 Serial.print(",to:");
         Serial.print((float)my_ir.to/100);
	 Serial.print(",ta:");
         Serial.print((float)my_ir.ta/100);
	 Serial.print(" ,bo:");  
         Serial.println((float)my_ir.bo/100);
           
     }
//     else
//        {
//          Serial.print(" sum ");
//          Serial.println(sum);
//      } 
   }
   else
   counter++; 
//   Serial.print("cont:");
//   Serial.println(counter);
  }
   
}
