Serendipity-min/medical-multi-parameter-monitor/gateway/mqtt/src/esp_io_metrics.h

#ifndef GATEWAY_ESP_IO_METRICS_H
#define GATEWAY_ESP_IO_METRICS_H
#include <stdint.h>
#ifdef MP_B5_EGRESS_FINAL
#include "../../b5/egress_metrics.h"
enum { ESP_AT_IDLE,ESP_AT_COMMAND,ESP_AT_WAIT_PROMPT,ESP_AT_DATA,
       ESP_AT_WAIT_SEND_OK,ESP_AT_WAIT_PUBACK,ESP_AT_UNSYNCED,ESP_AT_CLOSED };
typedef struct {uint32_t tick,phase,written,reply,reason,flags;} EspAtEvent;
#endif

/* 仅IRQ候选收集AT边界数字；不保存命令、MQTT载荷或外部连接配置。累计不随重连清零。 */
typedef struct {
    uint32_t tx_calls,tx_confirmed,tx_length,tx_ms,tx_phase;
    uint32_t rx_queries,rx_empty,rx_hint,rx_bytes,rx_reads;
#ifdef MP_B5_EGRESS_FINAL
    volatile uint32_t at_phase,phase_at,required,written,unsynced,budget_refused;
    uint32_t wait_reason,reply_bytes,reply_flags;
    uint32_t service_gap_max,console_max,rx_high_water;
    uint32_t tx_id,tx_at,tx_budget,frame_seq,pending_age,pending_id,qos,stream,event_count;
    EspAtEvent events[4];
    B5Latency command,prompt,data,send_ok;
#ifdef MP_FIVE_FIELD01
    uint32_t phase_ms[8],send_command_ms,rx_empty_ms,rx_nonempty_ms,rx_read_ms;
    uint32_t rx_nonempty,tx_bytes_total;
#endif
#endif
} EspIoMetrics;
void platform_io_snapshot(EspIoMetrics *out);
#ifdef MP_TRANSPORT_PROFILE
typedef struct {
    uint32_t service_cycles,service_calls,tx_cycles,tx_bytes,txe_cycles;
#ifdef MP_FIVE_FIELD01
    uint32_t service_cycles_max;
#endif
    uint32_t await_cycles,await_bytes,rx_step_cycles,rx_step_bytes,irq_cycles,irq_calls;
    uint32_t gmr_rx_bytes,gmr_calls;
} EspCpuMetrics;
void platform_cpu_snapshot(EspCpuMetrics *out);
#ifdef MP_FIVE_FIELD01
void platform_cpu_reset_service_max(void);
#endif
void platform_cpu_note_gmr(void);
#endif
#ifdef MP_B5_EGRESS_FINAL
int platform_at_synchronized(void);
int platform_at_unsynced(void);
uint32_t platform_send_reserve(unsigned bytes);
int platform_send_admissible(unsigned bytes,uint32_t budget);
void platform_tx_context(unsigned qos,unsigned stream,uint32_t seq,unsigned pending,uint32_t age,uint32_t budget);
#endif
#endif
