Serendipity-min/medical-multi-parameter-monitor/gateway/mqtt/src/gateway_platform.h

#ifndef GATEWAY_PLATFORM_H
#define GATEWAY_PLATFORM_H
#include <stdint.h>
#define ESP_UART_BAUD 115200u
#if defined(MP_FIVE_FIELD01) || defined(MP_ESP_UART_230400)
typedef enum {
    PRE_RETIME_OK, PRE_RETIME_TC, PRE_RETIME_RX_NOT_QUIET,
    PRE_RETIME_BRR, PRE_RETIME_STOP, PRE_RETIME_DEADLINE
} PreRetime;
PreRetime platform_preflight_retime(uint32_t baud,uint32_t deadline);
#endif
#ifdef MP_ESP_UART_230400
uint32_t platform_esp_uart_baud(void);
#endif
#ifdef MP_FIVE_FIELD01
int platform_preflight_console(const char *message,uint32_t deadline);
uint32_t platform_preflight_high_water(uint32_t keep);
int platform_preflight_esp_reset_seen(void);
#endif
/* 与 MQTT 库无关的 ESP 二进制接口；长度与实际读写结果不转换成布尔值。 */
int esp_mqtt_send(const unsigned char *data, int length, uint32_t timeout_ms);
int esp_mqtt_recv(unsigned char *data, int length, uint32_t timeout_ms);
void esp_mqtt_reset(void);
#ifdef MP_TX_INTEGRITY_DIAG
uint32_t platform_txcheck_written_at(void);
void platform_txcheck_ack(uint16_t id,uint32_t written_at);
void platform_txcheck_report(uint32_t now);
#endif
#ifdef MP_ESP_PASSTHROUGH
int platform_passthrough_enter(void);
int platform_passthrough_leave(void);
int platform_passthrough_normal(void);
#ifdef MP_PASS_LIFECYCLE
enum { PASS_EXIT_AT=1, PASS_EXIT_RESET=2 };
int platform_passthrough_recover(void);
int platform_passthrough_startup(unsigned *escape_sent,uint32_t *cold_uart_baseline);
int platform_passthrough_soft_reset_safe(void);
int platform_passthrough_status(void);
int platform_esp_hard_reset(void);
#endif
#endif

void platform_init(void);
void platform_set_poll(void (*callback)(void));
/* 主循环、AT 等待和 JSON 序列化共用入口，内部提供重入保护。 */
void platform_poll(void);
/* C网络诊断只读接口：累计UART错误不随重连清零，控制台忙时避免递归输出。 */
uint32_t platform_uart_errors_total(void);
#ifdef MP_LINK_RESILIENCE
typedef struct {uint32_t total,ore,ne,fe,overflow;} EspUartErrors;
void platform_uart_error_snapshot(EspUartErrors *out);
#endif
int platform_console_busy(void);
void console(const char *message);
#ifdef MP_CAN_RX_IRQ
/* 仅供低频诊断延后输出；不能借此暂停CAN接收或模型轮询。 */
int platform_console_busy(void);
#endif
int console_char(void);
/* UART当前门禁与累计错误分离；累计值供H3隔离窗口比较。 */
uint32_t platform_uart_errors_total(void);
int at_command(const char *command, uint32_t timeout_ms);
const char *at_response(void);
void delay_ms(uint32_t milliseconds);
extern volatile uint32_t g_uptime_ms;
#endif
