Serendipity-min/medical-multi-parameter-monitor/gateway/mqtt/src/gateway_transport.h

#ifndef GATEWAY_TRANSPORT_H
#define GATEWAY_TRANSPORT_H
#include "gateway_platform.h"
#include "../../data_model/model.h"
int gateway_config_valid(void);
uint32_t gateway_epoch(void);
/* 同一SNTP锚点的毫秒UTC，避免把uptime小数拼到秒级结果上造成未来时间。 */
uint64_t gateway_epoch_milliseconds(void);
int gateway_network_open(void);
#ifdef MP_TRANSPORT_BENCH
int transport_bench_fast(void);
int transport_bench_passthrough(void);
int gateway_bench_restore(void);
#endif
#ifdef MP_ESP_UART_230400
int gateway_uart_negotiating(void);
int gateway_uart_negotiation_failed(void);
#endif
#ifdef MP_FIVE_FIELD01
int gateway_preflight(uint32_t target,uint32_t deadline);
#endif
int gateway_mqtt_open(const MpFrame *will);
#ifdef MP_TTS_BROADCAST
void gateway_tts_broadcast_subscribe(void);
#endif
int gateway_mqtt_publish(const MpFrame *frame);
int gateway_mqtt_yield(void);
void gateway_network_close(void);
#ifdef MP_PASS_LIFECYCLE
int gateway_passthrough_retry(unsigned *reentries);
int gateway_passthrough_acquire(uint32_t *next_delay);
#ifdef MP_LINK_RESILIENCE
#include "../../b5/pass_recovery.h"
int gateway_link_retry(PassLinkDrops *drops,unsigned *reentries);
typedef struct { uint32_t triggers,paused_ms; } GatewayLinkDiag;
bool gateway_link_wave_paused(void);
void gateway_link_diag(GatewayLinkDiag *out);
#endif
#endif
#ifdef MP_B5_EGRESS_FINAL
#include "../../b5/egress_metrics.h"
enum { GW_FAILED=-1,GW_PENDING=0,GW_COMPLETE=1,GW_DEFERRED=2 };
int gateway_mqtt_admit(void);
int gateway_mqtt_begin(const MpFrame *frame);
int gateway_mqtt_progress(void);
int gateway_mqtt_pending(void);
int gateway_network_retryable(void);
#ifdef MP_FINAL_UNIFIED
#ifndef GATEWAY_TELEMETRY_SLOTS
#define GATEWAY_TELEMETRY_SLOTS 3u
#endif
uint16_t gateway_mqtt_ticket(void);
int gateway_mqtt_slots_full(void);
int gateway_mqtt_ticket_result(uint16_t id);
#endif
typedef struct {
    uint32_t q0_sent,q1_sent,q1_acked,failed;
    B5Latency json,send,ack;
#ifdef MP_FIVE_FIELD01
    uint32_t field01_json_ms;
#endif
} GatewayMqttMetrics;
#ifdef MP_FIVE_FIELD01
void field01_mqtt_reclaim(uint32_t *count,uint32_t *total,uint32_t *max);
#endif
void gateway_mqtt_metrics(GatewayMqttMetrics *out);
#ifdef MP_PRODUCTION_DIAG
typedef struct {
    uint32_t published[2][MP_STREAMS],acked[2][MP_STREAMS];
    uint64_t slot_ms[GATEWAY_TELEMETRY_SLOTS+1];
    unsigned used,peak;
    B5Latency puback;
} GatewayProductionDiag;
void gateway_mqtt_production_diag(GatewayProductionDiag *out,uint32_t now);
#endif
#endif
#endif
