Serendipity-min/medical-multi-parameter-monitor/ADS1292R模块资料V4.1_ECG/测试程序/STM32F103/STM32F103_FIR_ADS1292_LCD/User/PeripheralInit.c

//-----------------------------------------------------------------
// 程序描述:
// 　　芯片外设初始化
// 作　　者: 凌智电子
// 开始日期: 2014-01-24
// 完成日期: 2014-01-24
// 修改日期: 2014-02-20
// 版　　本: V1.0
// 　- V1.0: STM32F103VCT6外设初始化
// 调试工具: 凌智STM32核心开发板、2.8寸液晶屏、LZE_ST_LINK2
// 说　　明:
//
//-----------------------------------------------------------------

//-----------------------------------------------------------------
// 头文件包含
//-----------------------------------------------------------------
#include <stm32f10x.h>
#include "LED.h"
#include "Delay.h"
#include "lze_lcd.h"
#include "usart.h"	
#include "ADS1292.h"	
#include "spi.h"
#include "EXTInterrupt.h"
#include "PeripheralInit.h"

//-----------------------------------------------------------------
// 功能程序区
//-----------------------------------------------------------------
//-----------------------------------------------------------------
// void PeripheralInit(void)
//-----------------------------------------------------------------
//
// 函数功能: 系统外设初始化
// 入口参数: 无
// 返 回 值: 无
// 注意事项: 无
//
//-----------------------------------------------------------------
void PeripheralInit(void)
{
	Delay_5ms(200);
  LCD_Init();               			// 液晶初始化
	LCD_Clear(LCD_COLOR_WHITE);
  GPIO_LED_Configuration(); 			// LED初始化
	uart_init(115200);							// 串口初始化
	GPIO_ADS1292_Configuration();		// ADS1292引脚初始化
	EXTInterrupt_Init(); 						// 外部中断初始化
	SPI1_Init();										// SPI1初始化
  ADS1292_PowerOnInit();					// ADS1292上电初始化
}

//-----------------------------------------------------------------
// End Of File
//-----------------------------------------------------------------
