Serendipity-min/medical-multi-parameter-monitor/血氧/AFE4490_library/src/S_hr_algorithm.h

#ifndef _HRM_H_
#define _HRM_H_

class hr_algo
{
  public:
	void initStatHRM (void);
  void statHRMAlgo (unsigned long ppgData);

  void updateWindow(unsigned long *peakWindow, unsigned long Y, unsigned char n);
  unsigned char chooseRate(unsigned char *rate);
  void updateHeartRate(unsigned char *rate, unsigned int freq, unsigned int last);
  unsigned long findMax(unsigned long *X);
  unsigned long findMin(unsigned long *X);

  unsigned char HeartRate=0;
};



#endif /*_HRM_H_*/
