Serendipity-min/medical-multi-parameter-monitor/血氧/AFE4490_library/src/S_spo2_algorithm.h

#ifndef __S_spo2_algorithm_h__
#define __S_spo2_algorithm_h__

#define SF_spo2          25    //sampling frequency
#define BUFFER_SIZE  (SF_spo2*4)
#define MA4_SIZE         4 // DONOT CHANGE
#define min(x,y) ((x) < (y) ? (x) : (y))

class spo2_algorithm
{
  public:
	void estimate_spo2(uint16_t *pun_ir_buffer, int32_t n_ir_buffer_length, uint16_t *pun_red_buffer, int32_t *pn_spo2, int8_t *pch_spo2_valid, int32_t *pn_heart_rate, int8_t *pch_hr_valid);
    void find_peak( int32_t *pn_locs, int32_t *n_npks,  int32_t  *pn_x, int32_t n_size, int32_t n_min_height, int32_t n_min_distance, int32_t n_max_num );
    void find_peak_above( int32_t *pn_locs, int32_t *n_npks,  int32_t  *pn_x, int32_t n_size, int32_t n_min_height);
    void remove_close_peaks(int32_t *pn_locs, int32_t *pn_npks, int32_t *pn_x, int32_t n_min_distance);
    void sort_ascend(int32_t  *pn_x, int32_t n_size);
    void sort_indices_descend(  int32_t  *pn_x, int32_t *pn_indx, int32_t n_size);
};

#endif
