Serendipity-min/medical-multi-parameter-monitor/gateway/b5/test_five_p3_egress.c

/* P3 Host：运行真实 Router、coreMQTT、AT 状态机和音频推进器。 */
#include "../mqtt/src/gateway_transport.c"
#include "../mqtt/src/platform.c"
static int measured_ticket(uint16_t id);
#define gateway_mqtt_ticket_result measured_ticket
#include "egress.h"
#undef gateway_mqtt_ticket_result
#include "../microphone/mic_api.h"
#include "../microphone/mic_format.h"
#include "../voice/tts_uart_port.h"
#include <assert.h>
#include <inttypes.h>

#ifdef MP_FIVE_FIELD01
static void field01_published(const MpFrame *frame){(void)frame;}
static void field01_admission(void){}
#endif

enum { QUEUE_ACKS=8,
#ifdef MP_P3_R15_SCAN
       SEQUENCES=16001
#else
       SEQUENCES=751
#endif
};
static unsigned window_ms=110000;
const GatewayConfig gateway_test_config={GATEWAY_CONFIG_MAGIC,1700000000u,
    "synthetic-wifi","synthetic-password","mqtt.example.invalid","b5-gateway","synthetic-password","b5-c-isolated"};
volatile uint32_t g_uptime_ms;
#ifdef MP_OUTAGE_RETENTION
static bool override_data_utc;
static uint64_t test_data_utc;
uint64_t b5_data_utc(void){return override_data_utc?test_data_utc:gateway_epoch_milliseconds();}
static MpRetention retention;
#endif
TestUsart platform_usart[2]={{.SR=USART_SR_TXE},{.SR=USART_SR_TXE}};
static MpRouter router;
static uint64_t simulated_us;
static unsigned wire_us=87,byte_cpu_us;
#ifdef MP_P3_R15_SCAN
static unsigned r15_rate,r15_tx_us,r15_ack_count,r15_tx_bytes,r15_can_fps,r15_service_us=2700u;
static uint64_t r15_tx_us_total,r15_service_at,r15_service_us_total;
static bool r15_fast_ack,r15_line_only,r15_can_proportional;
static bool r16_upper,r16_ppg_edge;
#endif
#ifdef MP_P3_SERVICE_MODEL
static unsigned service_us;
static uint32_t service_calls,dma_bytes;
static bool dma_mode;
#endif
static uint32_t origin, produced, stop_at, record_at, first_audio, last_audio;
static uint32_t telemetry_ack_at[GATEWAY_TELEMETRY_SLOTS], reclaim_max, prompt_ms=4, terminal_ms=22, rx_ms=9, peer_ack_ms=55;
static unsigned mic_state, samples_wanted, audio_blocks, medical_published, recording_started;
static unsigned outgoing_length, outgoing_count, command_count, reply_count, reply_offset;
static uint32_t reply_at;
static uint8_t wire_packet[2048], reply_bytes[512];
static char command_bytes[64];
static int16_t pcm[MIC_SAMPLES];
static unsigned serial_payload_bytes, query_empty_us_count, rx_queries_with_queue;
static uint64_t stage_us[7], empty_query_us, rx_cycle_start, rx_queue_us;
static unsigned seq[6][MP_STREAMS], delivered[6][MP_STREAMS];
static uint32_t expected_hash[6][MP_STREAMS][SEQUENCES], replay_hash[6][MP_STREAMS][SEQUENCES];
static uint32_t most_recent_seq[6][MP_STREAMS], max_gap_ms[6][MP_STREAMS], recent_at[6][MP_STREAMS];
static unsigned identity_errors, late, replay_count, duplicates;
typedef struct {uint8_t data[5];unsigned count;uint32_t at;} PeerReply;
static PeerReply peer[QUEUE_ACKS];
static unsigned peer_head, peer_count;
#ifdef MP_ESP_PASSTHROUGH
enum { PEER_CAPACITY=2048, PEER_SEGMENT=1460, PEER_COALESCE_MS=20 };
static bool peer_stream,peer_no_ack,peer_hold_timer;
static uint8_t peer_serial[PEER_CAPACITY];
static unsigned peer_serial_n,peer_frame_n,peer_frame_left,peer_frame_shift;
static unsigned peer_chunks,peer_chunk_max,peer_rx_max,peer_escape_count,peer_escape_bytes;
static uint32_t peer_flush_at,peer_last_tx,peer_escape_at;
static unsigned peer_entry_case,peer_tx_stop_after;
#ifdef MP_TX_INTEGRITY_DIAG
static unsigned hold_tx_after,hold_tx_ms;
static bool try_nested_tx;
#endif
static bool peer_stop;
#ifdef MP_PASS_LIFECYCLE
static unsigned peer_at_ignored,peer_at_count,peer_reset_count,peer_close_count;
#ifdef MP_LINK_RESILIENCE
static const char *peer_fail_command;
static const char *peer_status_reply;
static unsigned uart_rebases;
static uint32_t uart_rebase_before,uart_rebase_after;
static uint32_t stall_cut_at;
static unsigned stall_qos0_bytes;
void b5_uart_rebase_after_reset(uint32_t before,uint32_t after){
    uart_rebases++;uart_rebase_before=before;uart_rebase_after=after;
}
#endif
static uint32_t peer_stop_at,peer_hold_tc_until,peer_hold_txe_until,peer_wifi_until;
static uint32_t peer_boot_noise_at,peer_boot_noise_period,peer_boot_first_tx;
static unsigned peer_boot_noise_count;
static bool peer_reset_held,peer_reset_noise;
static bool peer_reset_available,peer_reset_silent,peer_cleanup_rx,peer_hold_escape,peer_hold_post,
    peer_close_silent,peer_close_error,peer_socket_live,peer_normal_silent;
#endif
#endif

int b5_network_stopped(void){
#ifdef MP_ESP_PASSTHROUGH
    return peer_stop;
#else
    return 0;
#endif
}
uint32_t b5_business_remaining(void){
#ifdef MP_PASS_LIFECYCLE
    if(peer_stop)return 0;
#endif
    return 420000u;
}
int mic_initialize(void){return 1;}
void mic_record_begin(void){mic_state=1;record_at=g_uptime_ms;}
unsigned mic_record_state(void){return mic_state;}
void mic_record_poll(void){
    if(mic_state==1 && g_uptime_ms-record_at>=samples_wanted/16u)mic_state=2;
}
void mic_record_cancel(void){mic_state=3;}
void mic_record_finish(void){mic_state=2;}
const int16_t *mic_record_pcm(unsigned *count){*count=mic_state==2?samples_wanted:0;return pcm;}
void mic_record_export(void){}
void mic_diagnostics(MicDiag *out){memset(out,0,sizeof *out);}
bool unified_audio_fact_current(unsigned node,unsigned stream,uint32_t seq_no,uint32_t epoch_no,uint32_t boot){
    (void)node;(void)stream;(void)seq_no;(void)epoch_no;(void)boot;return false;
}
void tts_uart_init(void){}
static unsigned tts_queued;
static bool tts_tx_completed;
#ifdef MP_TTS_BROADCAST
static bool az_poll;
static unsigned az_status, az_written, az_pubacks;
static uint8_t az_uart[TTS_FRAME_MAX], az_suback_grant=1;
static int az_write(void *ctx,uint8_t byte){
    (void)ctx;assert(az_written<sizeof az_uart);az_uart[az_written++]=byte;return 1;
}
static bool az_idle(void *ctx){(void)ctx;return true;}
#endif
static int tts_write(void *ctx,uint8_t byte){(void)ctx;(void)byte;tts_queued++;return 1;}
static bool tts_idle(void *ctx){(void)ctx;tts_tx_completed=true;return true;}
static void tts_abort(void *ctx){(void)ctx;}
TtsIo tts_uart_io(void){return (TtsIo){NULL,tts_write,tts_idle,tts_abort};}
int tts_uart_receive(void){
#ifdef MP_TTS_BROADCAST
    if(az_status)return --az_status?0x41:0x4f;
#endif
    if(tts_queued==9 && tts_tx_completed){tts_queued=0;return 0x41;}return -1;
}
uint32_t tts_uart_errors(void){return 0;}
uint32_t tts_uart_overflow(void){return 0;}

static void advance(unsigned elapsed){
    unsigned stage=0;
    if(rx_state)stage=rx_state<=2?5:6;
    else if(io_metrics.at_phase==ESP_AT_COMMAND)stage=1;
    else if(io_metrics.at_phase==ESP_AT_WAIT_PROMPT)stage=2;
    else if(io_metrics.at_phase==ESP_AT_DATA)stage=3;
    else if(io_metrics.at_phase==ESP_AT_WAIT_SEND_OK)stage=4;
    stage_us[stage]+=elapsed;
    if(rx_state && router.ln)rx_queue_us+=elapsed;
    simulated_us+=elapsed;
    g_uptime_ms=(uint32_t)(simulated_us/1000);
}

static void uart_reply(const void *data,unsigned count,unsigned delay){
    assert(reply_offset==reply_count && count<=sizeof(reply_bytes));
    memcpy(reply_bytes,data,count);
    reply_offset=0;reply_count=count;reply_at=g_uptime_ms+delay;
}
static void terminal(const char *line,unsigned delay){uart_reply(line,(unsigned)strlen(line),delay);}
static void peer_reply(const uint8_t *data,unsigned count,unsigned delay){
    assert(peer_count<QUEUE_ACKS && count<=5);
    PeerReply *p=&peer[(peer_head+peer_count++)%QUEUE_ACKS];
    memcpy(p->data,data,count);p->count=count;p->at=g_uptime_ms+delay;
}

static unsigned stream_id(const char *topic){
    const char *tail=strrchr(topic,'/');assert(tail);tail++;
    if(!strcmp(tail,"status"))return strstr(topic,"/NODE-")?MP_NODE_STATUS:MP_GATEWAY_STATUS;
    for(unsigned i=0;i<MP_STREAMS;i++)if(!strcmp(tail,mp_stream_name((MpStream)i)))return i;
    assert(0);return 0;
}
static void observe_publish(unsigned pos,unsigned topic_length){
    char topic[120];assert(topic_length<sizeof(topic));
    memcpy(topic,wire_packet+pos,topic_length);topic[topic_length]=0;
    pos+=topic_length;
    if(wire_packet[0]&2u)pos+=2;
    unsigned length=outgoing_count-pos;
    if(!strcmp(topic,"mpm/mic/v1/in")){
        const uint8_t *block=wire_packet+pos;
        assert(length==544 && !memcmp(block,"MC01",4));
        assert((unsigned)(block[8]+256u*block[9])==audio_blocks);
        unsigned bytes=samples_wanted*2u-audio_blocks*512u;if(bytes>512)bytes=512;
        assert(!memcmp(block+32,(const uint8_t *)pcm+audio_blocks*512u,bytes));
        if(!audio_blocks)first_audio=g_uptime_ms;
        audio_blocks++;last_audio=g_uptime_ms;return;
    }
    if(!origin)return;
    char body[2048];assert(length<sizeof body);memcpy(body,wire_packet+pos,length);body[length]=0;
    const char *node_mark=strstr(topic,"/NODE-");
    unsigned node=node_mark?(unsigned)(node_mark[6]-'A'+1):3, stream=stream_id(topic);
    const char *sequence=strstr(body,"\"seq\":");
    const char *timestamp=strstr(body,"\"timestamp\":");
    assert(sequence && timestamp && node<=5);
    unsigned id=(unsigned)strtoul(sequence+6,NULL,10);assert(id && id<SEQUENCES);
    bool replay=strstr(topic,"/replay/")!=NULL;
    uint32_t hash=mic_crc32(body,length);
    if(hash!=(replay?replay_hash:expected_hash)[node][stream][id])identity_errors++;
    if(replay){replay_count++;return;}
    if(id<=most_recent_seq[node][stream])duplicates++;
    most_recent_seq[node][stream]=id;
    if(recent_at[node][stream] && g_uptime_ms-recent_at[node][stream]>max_gap_ms[node][stream])
        max_gap_ms[node][stream]=g_uptime_ms-recent_at[node][stream];
    recent_at[node][stream]=g_uptime_ms;
    uint64_t stamp=strtoull(timestamp+12,NULL,10);
    if(gateway_epoch_milliseconds()-stamp>=(stream==MP_NIBP?90000u:5000u))late++;
    medical_published++;delivered[node][stream]++;
}
static void mqtt_packet(void){
    unsigned type=wire_packet[0]>>4;
    if(type==1){peer_reply((const uint8_t[]){0x20,2,0,0},4,0);return;}
    if(type==12){peer_reply((const uint8_t[]){0xd0,0},2,0);return;}
    unsigned pos=1;
    while(wire_packet[pos++]&128u){}
#ifdef MP_TTS_BROADCAST
    if(type==4 && az_poll){assert(wire_packet[pos]==0 && wire_packet[pos+1]==77);az_pubacks++;return;}
#endif
    if(type==8){
        uint8_t grant=1;
#ifdef MP_TTS_BROADCAST
        grant=az_suback_grant;
#endif
        peer_reply((const uint8_t[]){0x90,3,wire_packet[pos],wire_packet[pos+1],grant},5,0);return;
    }
    if(type!=3)return;
    unsigned topic_length=256u*wire_packet[pos]+wire_packet[pos+1];pos+=2;
    observe_publish(pos,topic_length);
    if(wire_packet[0]&2u){
        pos+=topic_length;
        unsigned delay=peer_ack_ms;
#ifdef MP_P3_R15_SCAN
        if(r15_rate && !r15_fast_ack && ++r15_ack_count%40u==0)delay=540;
#endif
        peer_reply((const uint8_t[]){0x40,2,wire_packet[pos],wire_packet[pos+1]},4,delay);
    }
}
#ifdef MP_ESP_PASSTHROUGH
static void peer_tls_send(unsigned count){
    assert(count<=PEER_SEGMENT && count<=peer_serial_n);
    if(count>peer_chunk_max)peer_chunk_max=count;
    peer_chunks++;
    for(unsigned i=0;i<count;i++){
        unsigned byte=peer_serial[i];
        assert(peer_frame_n<sizeof wire_packet);
        wire_packet[peer_frame_n++]=(uint8_t)byte;
        if(peer_frame_n==1)continue;
        if(peer_frame_shift!=UINT32_MAX){
            peer_frame_left+=(byte&127u)<<peer_frame_shift;
            assert(peer_frame_shift<21u);
            if(byte&128u){peer_frame_shift+=7;continue;}
            peer_frame_shift=UINT32_MAX;
        }else peer_frame_left--;
        if(!peer_frame_left){
            serial_payload_bytes+=peer_frame_n;
            outgoing_count=peer_frame_n;
            mqtt_packet();peer_frame_n=peer_frame_shift=0;
        }
    }
    peer_serial_n-=count;
    memmove(peer_serial,peer_serial+count,peer_serial_n);
}

static void peer_pass_tx(unsigned char byte){
    uint32_t gap=g_uptime_ms-peer_last_tx;
    peer_last_tx=g_uptime_ms;
    if(byte=='+' && (gap>20u || peer_escape_bytes)){
        assert((peer_escape_bytes==0 && gap>20u) || gap<20u);
#ifdef MP_PASS_LIFECYCLE
        if(!peer_escape_bytes)assert(gap>=1000u);
        if(peer_hold_escape){
            peer_hold_escape=false;peer_hold_txe_until=g_uptime_ms+120u;
            USART3->SR&=~USART_SR_TXE;
            return;
        }
#endif
        if(++peer_escape_bytes==3){
            peer_escape_count++;peer_escape_bytes=0;
            peer_escape_at=g_uptime_ms;peer_stream=false;
#ifdef MP_PASS_LIFECYCLE
            if(peer_cleanup_rx)terminal("\r\nOK\r\n",150);
            if(peer_hold_post){
                peer_hold_post=false;peer_hold_tc_until=g_uptime_ms+120u;
                USART3->SR&=~USART_SR_TC;
            }
#endif
        }
        return;
    }
    assert(!peer_escape_bytes && peer_serial_n<PEER_CAPACITY);
    if(!peer_serial_n)peer_flush_at=g_uptime_ms+PEER_COALESCE_MS;
    peer_serial[peer_serial_n++]=byte;
    if(peer_serial_n>peer_rx_max)peer_rx_max=peer_serial_n;
    if(peer_serial_n>PEER_SEGMENT)peer_tls_send(PEER_SEGMENT);
}
#endif
static void peer_tx_byte(unsigned char byte){
#ifdef MP_ESP_PASSTHROUGH
    if(peer_stream){
#ifdef MP_LINK_RESILIENCE
        if(stall_cut_at && g_uptime_ms>=stall_cut_at && !io_metrics.qos)stall_qos0_bytes++;
#endif
        peer_pass_tx(byte);
        if(peer_tx_stop_after && !--peer_tx_stop_after)peer_stop=true;
        return;
    }
    if(peer_escape_at)assert(g_uptime_ms-peer_escape_at>=1000u);
#endif
    if(outgoing_length){
        assert(outgoing_count<sizeof wire_packet);
        wire_packet[outgoing_count++]=byte;
        if(outgoing_count==outgoing_length){
            serial_payload_bytes+=outgoing_length;outgoing_length=0;
            mqtt_packet();terminal("\r\nSEND OK\r\n",terminal_ms);
        }
        return;
    }
    assert(command_count<sizeof(command_bytes)-1);
    command_bytes[command_count++]=(char)byte;
    if(command_count<2 || command_bytes[command_count-2]!='\r' || byte!='\n')return;
    command_bytes[command_count]=0;command_count=0;
#ifdef MP_ESP_PASSTHROUGH
#ifdef MP_PASS_LIFECYCLE
#ifdef MP_LINK_RESILIENCE
    if(peer_fail_command && !strncmp(command_bytes,peer_fail_command,strlen(peer_fail_command))){
        terminal("\r\nERROR\r\n",rx_ms);return;
    }
#endif
    if(!strcmp(command_bytes,"AT\r\n")){
        peer_at_count++;
        if(peer_at_ignored){peer_at_ignored--;return;}
        if(reply_count!=reply_offset){
            reply_offset=reply_count;
            terminal("\r\nERROR\r\n\r\nOK\r\n",rx_ms);
        }else terminal("\r\nOK\r\n",rx_ms);
        return;
    }
    if(!strncmp(command_bytes,"+++",3)){
        terminal("\r\nERROR\r\n",0);return;
    }
    if(!strcmp(command_bytes,"AT+CIPCLOSE\r\n")){
        peer_close_count++;
        if(peer_close_silent)return;
        if(peer_close_error){terminal("\r\nERROR\r\n",rx_ms);return;}
    }
    if(!strcmp(command_bytes,"AT+CIPSTATUS\r\n")){
#ifdef MP_LINK_RESILIENCE
        if(peer_status_reply){terminal(peer_status_reply,rx_ms);return;}
#endif
        terminal(peer_socket_live?"\r\nSTATUS:3\r\nOK\r\n":"\r\nSTATUS:4\r\nOK\r\n",rx_ms);
        return;
    }
    if(peer_normal_silent && !strcmp(command_bytes,"AT+CIPMODE=0\r\n"))return;
    if(!strcmp(command_bytes,"AT+GMR\r\n")){
        terminal("\r\nAT version:2.2.0.0\r\nOK\r\n",rx_ms);return;
    }
    if(!strcmp(command_bytes,"AT+SYSTIMESTAMP?\r\n")){
        terminal("\r\n+SYSTIMESTAMP:1800000000\r\nOK\r\n",rx_ms);return;
    }
    if(!strncmp(command_bytes,"AT+CWJAP=",9) && (int32_t)(peer_wifi_until-g_uptime_ms)>0){
        terminal("\r\nERROR\r\n",rx_ms);return;
    }
#endif
    if(!strcmp(command_bytes,"AT+CIPSEND\r\n")){
        if(peer_entry_case==1)terminal(">",prompt_ms);
        else if(peer_entry_case==2)terminal("\r\nERROR\r\n",prompt_ms);
        else if(peer_entry_case==3)terminal("\r\nOK\r\n",prompt_ms);
        else {
            terminal("\r\nOK\r\n>",prompt_ms);peer_stream=true;
            peer_last_tx=g_uptime_ms;
        }
        return;
    }
    if(!strcmp(command_bytes,"AT+CIPMODE?\r\n")){
        if(peer_no_ack)return;
        assert(peer_escape_count==1);
        terminal("\r\n+CIPMODE:1\r\nOK\r\n",rx_ms);return;
    }
#endif
    if(sscanf(command_bytes,"AT+CIPSEND=%u",&outgoing_length)==1){
        outgoing_count=0;terminal(">",prompt_ms);return;
    }
    unsigned ready_bytes=0;
    for(unsigned i=0;i<peer_count;i++){
        const PeerReply *p=&peer[(peer_head+i)%QUEUE_ACKS];
        if(p->at>g_uptime_ms)break;
        ready_bytes+=p->count;
    }
    if(!strncmp(command_bytes,"AT+CIPRECVLEN?",14)){
        char line[96];int count=snprintf(line,sizeof line,"\r\n+CIPRECVLEN:%u,0,0,0,0\r\n\r\nOK\r\n",ready_bytes);
        if(origin && router.ln)rx_queries_with_queue++;
        uart_reply(line,(unsigned)count,rx_ms);
    }else if(!strncmp(command_bytes,"AT+CIPRECVDATA=",15)){
        unsigned char line[128];
        unsigned n=(unsigned)snprintf((char *)line,sizeof line,"\r\n+CIPRECVDATA:%u,",ready_bytes);
        while(ready_bytes){
            PeerReply *p=&peer[peer_head];memcpy(line+n,p->data,p->count);n+=p->count;
            ready_bytes-=p->count;peer_head=(peer_head+1)%QUEUE_ACKS;peer_count--;
        }
        memcpy(line+n,"\r\nOK\r\n",6);uart_reply(line,n+6,rx_ms);
    }else terminal("\r\nOK\r\n",rx_ms);
}

void platform_test_tx(unsigned char byte){
#ifdef MP_PASS_LIFECYCLE
    if(!peer_boot_first_tx)peer_boot_first_tx=g_uptime_ms;
#endif
#ifdef MP_P3_R15_SCAN
    if(r15_rate && io_metrics.at_phase==ESP_AT_DATA){
        /* send_bytes 每字节先跑一次 5 us 的 tick，已包含在校准字节时间中。 */
        r15_tx_bytes++;r15_tx_us_total+=r15_tx_us;
        advance(r15_tx_us-5u);
    }else
#endif
        advance(wire_us+byte_cpu_us);
    peer_tx_byte(byte);
#ifdef MP_TX_INTEGRITY_DIAG
    if(hold_tx_after && !--hold_tx_after){
        USART3->SR&=~USART_SR_TXE;
        peer_hold_txe_until=g_uptime_ms+hold_tx_ms;
    }
#endif
}

#ifdef MP_P3_SERVICE_MODEL
/* 仅模拟数据段的自主发送。串口按固定线速，主循环每毫秒并行服务一次。 */
int platform_test_dma_payload(const unsigned char *data,unsigned size){
    if(!dma_mode)return -1;
    const uint64_t start=simulated_us;
    uint64_t service_at=start+1000u;
    unsigned i=0;
    for(;i<size;i++){
        uint64_t byte_at=start+(i+1u)*wire_us;
        if(service_at<=byte_at){
            if(simulated_us<service_at)advance((unsigned)(service_at-simulated_us));
            platform_poll();
            service_at+=1000u;
        }
        if(NETWORK_STOPPED() || (int32_t)(g_uptime_ms-serial_deadline)>=0)break;
        if(simulated_us<byte_at)advance((unsigned)(byte_at-simulated_us));
        peer_tx_byte(data[i]);
        io_metrics.written=i+1u;
    }
    dma_bytes+=i;
    return (int)i;
}
#endif

static void put(unsigned node,unsigned stream,unsigned rate,unsigned count,int value){
    MpFrame f={0};f.node=node;f.stream=stream;f.rate=rate;f.count=count;
    f.synthetic=true;f.valid=true;f.timestamp=1800000000000ULL+produced;
#ifdef MP_P3_R15_SCAN
    if(r15_rate && !r16_upper)f.timestamp=1800000000000ULL+(uint64_t)produced*10500u/r15_rate;
#endif
    f.epoch=1712345678;f.boot=1;f.seq=++seq[node][stream];assert(f.seq<SEQUENCES);
    for(unsigned i=0;i<count;i++){
        f.values[i]=value;
        if(rate)f.values[i]=(value+(int)i)*((stream!=MP_PPG && i%2)?-1:1);
    }
    if(stream==MP_NIBP)f.values[1]=760;
    char body[2048];
    int length=mp_json(&f,body,sizeof body);assert(length>0);
    expected_hash[node][stream][f.seq]=mic_crc32(body,(unsigned)length);
    f.replay=true;length=mp_json(&f,body,sizeof body);assert(length>0);
    replay_hash[node][stream][f.seq]=mic_crc32(body,(unsigned)length);
    f.replay=false;mp_router_put(&router,&f);
}
static void tick(void){
#ifdef MP_TTS_BROADCAST
    if(az_poll){unsigned before=az_written;tts_broadcast_poll(g_uptime_ms);assert(az_written-before<=1);}
#endif
#ifdef MP_P3_SERVICE_MODEL
    if(origin)service_calls++;
    advance(25u+service_us);
#else
#ifdef MP_P3_R15_SCAN
    bool transmitting=r15_rate && io_metrics.at_phase==ESP_AT_DATA;
    advance(transmitting?5u:25u);
    if(r15_rate && origin && simulated_us>=r15_service_at){
        r15_service_at+=5000u;
        r15_service_us_total+=r15_service_us;
        /* 字节耗时已含 TX 内的服务竞争，避免再把 54% 叠加到 TX。 */
        if(!transmitting)advance(r15_service_us);
    }
#else
    advance(25);
#endif
#endif
#ifdef MP_PASS_LIFECYCLE
#ifdef MP_TX_INTEGRITY_DIAG
    if(try_nested_tx && txcheck_active){
        const unsigned char ping[]={0xc0,0};
        try_nested_tx=false;
        assert(esp_mqtt_send(ping,sizeof ping,0)<0);
    }
#endif
    if(peer_stop_at && g_uptime_ms>=peer_stop_at)peer_stop=true;
    if(peer_boot_noise_at && g_uptime_ms>=peer_boot_noise_at){
        USART3->DR=0x9f;
        USART3->SR|=USART_SR_FE|USART_SR_RXNE;
        for(unsigned i=0;i<peer_boot_noise_count;i++)USART3_IRQHandler();
        USART3->SR&=~(USART_SR_FE|USART_SR_RXNE);
        peer_boot_noise_at=peer_boot_noise_period?g_uptime_ms+peer_boot_noise_period:0;
    }
    if(peer_hold_tc_until && g_uptime_ms>=peer_hold_tc_until){
        USART3->SR|=USART_SR_TC;peer_hold_tc_until=0;
    }
    if(peer_hold_txe_until && g_uptime_ms>=peer_hold_txe_until){
        USART3->SR|=USART_SR_TXE;peer_hold_txe_until=0;
    }
#endif
    if(reply_offset<reply_count && g_uptime_ms>=reply_at){
        USART3->DR=reply_bytes[reply_offset++];USART3->SR|=USART_SR_RXNE;
        USART3_IRQHandler();USART3->SR&=~USART_SR_RXNE;advance(wire_us+byte_cpu_us);
    }
#ifdef MP_ESP_PASSTHROUGH
    if(peer_stream){
        if(!peer_hold_timer && peer_serial_n && g_uptime_ms>=peer_flush_at)peer_tls_send(peer_serial_n);
        if(reply_offset==reply_count && peer_count && g_uptime_ms>=peer[peer_head].at){
            PeerReply *p=&peer[peer_head];
            uart_reply(p->data,p->count,0);
            peer_head=(peer_head+1)%QUEUE_ACKS;peer_count--;
        }
    }
#endif
    if(origin){
        uint32_t input_ms=g_uptime_ms-origin,input_limit=window_ms;
#ifdef MP_P3_R15_SCAN
        if(r15_rate){
            unsigned scale=r16_upper?10500u:r15_rate;
            input_ms=(uint64_t)input_ms*scale/10500u;
            input_limit=(uint64_t)input_limit*scale/10500u;
        }
#endif
        while(produced<input_ms && produced<input_limit){
            produced++;
#ifdef MP_P3_R15_SCAN
            if(r15_rate){
                if(produced%400==0)put(2,MP_ECG,250,100,11103);
                unsigned phase=produced%1000u;
                if(phase==20)put(2,MP_RESP,50,50,100000);
                if(r16_ppg_edge){
                    if(produced%20u==0)put(1,MP_PPG,50,1,1230000);
                }else if(phase==140)put(1,MP_PPG,50,50,1230000);
                if(phase==210)put(1,MP_SPO2,0,1,9750);
                if(phase==330)put(1,MP_PR,0,1,7200);
                if(phase==460)put(2,MP_HR,0,1,6000);
                if(phase==580)put(2,MP_RR,0,1,1800);
                if(phase==760)put(4,MP_TEMP,0,1,2450);
                if(r16_upper && phase==940)put(5,MP_NIBP,0,2,1180);
                phase=produced%5000u;
                if(phase==500)put(3,MP_GATEWAY_STATUS,0,1,1);
                if(phase==1500)put(1,MP_NODE_STATUS,0,1,1);
                if(phase==2500)put(2,MP_NODE_STATUS,0,1,1);
                if(phase==3500)put(4,MP_NODE_STATUS,0,1,1);
                if(phase==4500)put(5,MP_NODE_STATUS,0,1,1);
                continue;
            }
#endif
            if(produced%400==0)put(2,MP_ECG,250,100,1103);
            if(produced%1000==0){
                put(2,MP_RESP,50,50,10000);put(1,MP_PPG,50,50,1230000);
                put(1,MP_SPO2,0,1,9750);put(1,MP_PR,0,1,7200);
                put(2,MP_HR,0,1,6000);put(2,MP_RR,0,1,1800);put(4,MP_TEMP,0,1,2450);
            }
            if(produced%5000==0){
                put(3,MP_GATEWAY_STATUS,0,1,1);
                put(1,MP_NODE_STATUS,0,1,1);put(2,MP_NODE_STATUS,0,1,1);
                put(4,MP_NODE_STATUS,0,1,1);put(5,MP_NODE_STATUS,0,1,1);
            }
            if(produced==2000)put(5,MP_NIBP,0,2,1180);
        }
        unified_audio_local_poll();
    }
    if(rx_state==1 && !rx_tx)rx_cycle_start=simulated_us;
    if(io_metrics.rx_empty!=query_empty_us_count){
        query_empty_us_count=io_metrics.rx_empty;
        if(origin)empty_query_us+=simulated_us-rx_cycle_start;
    }
}

static void record_mqtt_event(MQTTContext_t *ctx,MQTTPacketInfo_t *packet,MQTTDeserializedInfo_t *data){
    if(packet->type==MQTT_PACKET_TYPE_PUBACK)
        for(unsigned i=0;i<GATEWAY_TELEMETRY_SLOTS;i++)
            if(telemetry[i].id==data->packetIdentifier)telemetry_ack_at[i]=g_uptime_ms;
    mqtt_event(ctx,packet,data);
}

static int measured_ticket(uint16_t id){
    unsigned slot=0;
    while(slot<GATEWAY_TELEMETRY_SLOTS && telemetry[slot].id!=id)slot++;
    int result=gateway_mqtt_ticket_result(id);
    if(result==GW_COMPLETE){
        assert(slot<GATEWAY_TELEMETRY_SLOTS && telemetry_ack_at[slot]);
        uint32_t delay=g_uptime_ms-telemetry_ack_at[slot];
        if(delay>reclaim_max)reclaim_max=delay;
        telemetry_ack_at[slot]=0;
    }
    return result;
}

static void latency(const char *name,const B5Latency *m){
    printf("lat %s n=%lu p50_upper=%lu p95_upper=%lu p99_upper=%lu max=%lu\n",name,(unsigned long)m->count,
        (unsigned long)b5_latency_percentile(m,50),(unsigned long)b5_latency_percentile(m,95),
        (unsigned long)b5_latency_percentile(m,99),(unsigned long)m->max);
}
#ifdef MP_ESP_PASSTHROUGH
static void pass_case_reset(void){
    peer_stream=peer_no_ack=peer_stop=false;peer_entry_case=peer_tx_stop_after=0;
    peer_escape_at=peer_escape_count=peer_escape_bytes=0;
    peer_serial_n=peer_frame_n=peer_frame_left=peer_frame_shift=0;
    reply_count=reply_offset=peer_count=peer_head=0;
    pass_mode=PASS_COMMAND;io_metrics=(EspIoMetrics){0};
    esp_mqtt_reset();
}

#ifdef MP_PASS_LIFECYCLE
int platform_esp_hard_reset(void){
    peer_reset_count++;
    if(peer_reset_held)return -1;
    if(!peer_reset_available)return 0;
    peer_stream=false;peer_escape_at=0;command_count=0;
    if(peer_reset_noise){
        USART3->SR|=USART_SR_FE;USART3_IRQHandler();USART3->SR&=~USART_SR_FE;
    }
    if(!peer_reset_silent)terminal("\r\nready\r\n",100);
    return 1;
}

static void lifecycle_case(void){
    pass_case_reset();
    command_count=peer_at_ignored=peer_at_count=peer_reset_count=peer_close_count=0;
    peer_hold_tc_until=peer_hold_txe_until=0;USART3->SR|=USART_SR_TC|USART_SR_TXE;
    peer_hold_escape=peer_hold_post=peer_close_silent=peer_close_error=peer_socket_live=peer_normal_silent=false;
    peer_stop_at=0;peer_reset_available=peer_reset_silent=peer_cleanup_rx=false;
    peer_wifi_until=0;peer_reset_noise=peer_reset_held=pass_reset_held=false;
    assert(platform_passthrough_enter());
    peer_boot_noise_at=peer_boot_noise_period=peer_boot_first_tx=0;
    uart_hw_total=uart_overflow_total=0;
#ifdef MP_LINK_RESILIENCE
    peer_status_reply=NULL;uart_rebases=0;
    uart_ore_total=uart_ne_total=uart_fe_total=0;
#endif
}

static void lifecycle_cases(void){
    lifecycle_case();
    gateway_network_close();
    assert(peer_escape_count==1 && peer_at_count==1 && peer_close_count==1 && platform_at_synchronized());
    puts("PASS_LIFECYCLE_NORMAL_EXIT_NO_ESCAPE_ACK");
    lifecycle_case();
    peer_cleanup_rx=true;peer_at_ignored=1;
    assert(platform_passthrough_leave()==1 && peer_at_count==2 && !peer_reset_count);
    puts("PASS_LIFECYCLE_AT_TIMEOUT_RETRY_SUCCESS_STALE_RX_IGNORED");
    lifecycle_case();
    peer_at_ignored=2;
    gateway_network_close();
    unsigned at_count=peer_at_count,reentries=0;
    assert(peer_reset_count==1 && !peer_close_count && pass_mode==PASS_LOCKED &&
           !gateway_network_open() && !gateway_passthrough_retry(&reentries) &&
           !at_command("AT",500) && !platform_passthrough_leave() &&
           peer_reset_count==1 && peer_at_count==at_count);
    puts("PASS_LIFECYCLE_RETRY_EXHAUSTED_HARD_RESET_UNAVAILABLE_COMMANDS_BLOCKED");
    lifecycle_case();
    peer_at_ignored=2;peer_reset_available=true;peer_reset_silent=true;
    assert(!platform_passthrough_leave() && pass_mode==PASS_LOCKED && !at_command("AT",500));
    puts("PASS_LIFECYCLE_RESET_WITHOUT_READY_COMMANDS_BLOCKED");
    lifecycle_case();
    peer_at_ignored=3;peer_reset_available=true;
    assert(!platform_passthrough_leave() && pass_mode==PASS_LOCKED && !at_command("AT",500));
    puts("PASS_LIFECYCLE_RESET_WITHOUT_AT_COMMANDS_BLOCKED");
    lifecycle_case();
    peer_at_ignored=2;peer_reset_available=peer_reset_noise=true;
    assert(platform_passthrough_leave()==2 && peer_reset_count==1 && platform_at_synchronized());
    assert(gateway_passthrough_retry(&reentries) && gateway_network_open());
    puts("PASS_LIFECYCLE_HARD_RESET_RESTART");
    lifecycle_case();
    terminal("\r\nCLOSED\r\n",0);
    unsigned char bytes[4];
    assert(esp_mqtt_recv(bytes,4,40)<0);
    gateway_network_close();
    MpFrame will={.node=3,.stream=MP_GATEWAY_STATUS,.synthetic=true};
    assert(gateway_passthrough_retry(&reentries) && gateway_network_open() && gateway_mqtt_open(&will));
    assert(!gateway_passthrough_retry(&reentries) && reentries==3);
    puts("PASS_LIFECYCLE_CLOSED_TLS_MQTT_RECONNECT_AND_REENTRY_LIMIT");
    lifecycle_case();
    peer_stop_at=g_uptime_ms+500u;
    gateway_network_close();
    assert(peer_stop && platform_at_synchronized() && peer_close_count==1 &&
           !gateway_passthrough_retry(&reentries) && esp_mqtt_send(bytes,4,500)<0);
    puts("PASS_LIFECYCLE_STOP_DURING_EXIT_NO_REENTRY");
    lifecycle_case();
    peer_stream=false;
    assert(platform_passthrough_leave()==PASS_EXIT_AT && peer_at_count==1 && !peer_reset_count);
    puts("PASS_LIFECYCLE_ALREADY_COMMAND_CLEARS_ESCAPE_PREFIX_ON_RETRY");
    lifecycle_case();
    USART3->SR&=~USART_SR_TC;
    assert(!platform_passthrough_leave() && !peer_escape_count && peer_reset_count==1);
    puts("PASS_LIFECYCLE_PRE_GUARD_TIMEOUT_NO_ESCAPE");
    lifecycle_case();
    peer_hold_escape=true;
    assert(platform_passthrough_leave()==PASS_EXIT_AT && peer_escape_count==1 && !peer_reset_count);
    puts("PASS_LIFECYCLE_PARTIAL_ESCAPE_WRITE_RETRY");
    lifecycle_case();
    peer_hold_post=true;
    assert(platform_passthrough_leave()==PASS_EXIT_AT && peer_at_count==1 && !peer_reset_count);
    puts("PASS_LIFECYCLE_POST_GUARD_TIMEOUT_RETRY");
    lifecycle_case();
    peer_close_silent=true;
    gateway_network_close();
    assert(peer_close_count==1 && peer_reset_count==1 && !platform_at_synchronized());
    puts("PASS_LIFECYCLE_CLOSE_TIMEOUT_COMMANDS_BLOCKED");
    lifecycle_case();
    peer_close_error=true;
    gateway_network_close();
    assert(peer_close_count==1 && !peer_reset_count && platform_at_synchronized());
    puts("PASS_LIFECYCLE_CLOSE_ERROR_SOCKET_ABSENT");
    lifecycle_case();
    peer_close_error=peer_socket_live=true;
    gateway_network_close();
    assert(peer_close_count==1 && peer_reset_count==1 && !platform_at_synchronized());
    puts("PASS_LIFECYCLE_CLOSE_ERROR_SOCKET_LIVE_COMMANDS_BLOCKED");
    lifecycle_case();
    peer_normal_silent=true;
    gateway_network_close();
    assert(peer_close_count==1 && peer_reset_count==1 && !platform_at_synchronized());
    puts("PASS_LIFECYCLE_NORMAL_MODE_TIMEOUT_COMMANDS_BLOCKED");

    lifecycle_case();
    PassRecovery recovery={2,false};
    volatile PassResume record={0};
    assert(pass_reset_allowed(&recovery,false,false));
    assert(!pass_reset_allowed(&recovery,true,false) && !pass_reset_allowed(&recovery,false,true));
    pass_resume_save(&recovery,&record);
    recovery=(PassRecovery){0};
    assert(pass_resume_take(&recovery,&record,true) && recovery.reentries==3 && recovery.reset_used);
    assert(!pass_reset_allowed(&recovery,false,false) && !pass_resume_take(&recovery,&record,true));
    pass_mode=PASS_BOOT; /* STM32 重新初始化，ESP 仍停在数据态。 */
    io_metrics=(EspIoMetrics){0};
    esp_mqtt_reset();
    assert(!at_command("AT",500) && !peer_at_count);
    unsigned escape_sent=0;
    assert(platform_passthrough_startup(&escape_sent,NULL) && escape_sent && peer_escape_count==1 && peer_at_count==1);
    assert(!gateway_passthrough_retry(&recovery.reentries));
    puts("PASS_AL_WARM_BOOT_ESCAPE_RETAINS_REENTRY_AND_RESET_BUDGET");

    lifecycle_case();
    peer_stream=false;
    pass_mode=PASS_BOOT;io_metrics=(EspIoMetrics){0};
    assert(platform_passthrough_startup(&escape_sent,NULL) && peer_at_count==1 && !peer_reset_count);
    puts("PASS_AL_COMMAND_BOOT_ESCAPE_THEN_AT");

    lifecycle_case();
    peer_stop_at=g_uptime_ms+500u;
    escape_sent=0;
    assert(!platform_passthrough_startup(&escape_sent,NULL) && !escape_sent && peer_stop && !peer_escape_count &&
           !peer_at_count && !at_command("AT",500));
    puts("PASS_AL_STOP_DURING_STARTUP_NO_ESCAPE_OR_AT");

    lifecycle_case();
    peer_at_ignored=2;
    assert(!platform_passthrough_startup(&escape_sent,NULL) && escape_sent && pass_mode==PASS_LOCKED &&
           !peer_reset_count && !at_command("AT",500));
    record=(PassResume){PASS_RESUME_TAG|1u,0};
    assert(!pass_resume_take(&recovery,&record,true));
    puts("PASS_AL_UNCONFIRMED_BOOT_OR_BAD_RECORD_LOCKS");

    lifecycle_case();
    pass_mode=PASS_BOOT;
    uart_hw_total=errors=225u;
    escape_sent=0;
    assert(!platform_passthrough_startup(&escape_sent,NULL) && !escape_sent && !peer_at_count &&
           !peer_escape_count && platform_uart_errors_total()==225u && !at_command("AT",500));
    puts("PASS_AQ_WARM_BOOT_DOES_NOT_REBASE_ERRORS");

    lifecycle_case();
    uint32_t boot_baseline=0,boot_at=g_uptime_ms;
    peer_boot_noise_at=boot_at+100u;peer_boot_noise_count=225u;
    terminal("\r\nready\r\n",175);
    assert(platform_passthrough_startup(&escape_sent,&boot_baseline) && escape_sent && peer_at_count==1);
    assert(boot_baseline==225u && platform_uart_errors_total()==225u && !errors);
    assert(peer_boot_first_tx-boot_at>=1176u && peer_boot_first_tx-boot_at<1301u);
    puts("PASS_AQ_COLD_FRAMING_ERRORS_THEN_READY");

    lifecycle_case();
    boot_baseline=0;escape_sent=0;
    uart_hw_total=errors=225u;
    terminal("\r\nready\r\n",100);
    peer_boot_noise_at=g_uptime_ms+400u;peer_boot_noise_count=1;
    assert(!platform_passthrough_startup(&escape_sent,&boot_baseline) && !escape_sent && !peer_boot_first_tx);
    assert(boot_baseline==225u && platform_uart_errors_total()==226u && errors==1 && pass_mode==PASS_LOCKED);
    puts("PASS_AQ_ERROR_AFTER_BASELINE_LOCKS");

    lifecycle_case();
    boot_baseline=0;
    peer_boot_noise_at=g_uptime_ms+100u;peer_boot_noise_count=1025u;
    assert(!platform_passthrough_startup(&escape_sent,&boot_baseline) && !peer_boot_first_tx);
    assert(!boot_baseline && platform_uart_errors_total()==1025u && pass_mode==PASS_LOCKED);
    puts("PASS_AQ_UART_STORM_LOCKS_WITHOUT_REBASE");

    lifecycle_case();
    boot_baseline=0;boot_at=g_uptime_ms;
    peer_boot_noise_at=boot_at+100u;peer_boot_noise_count=1;
    assert(platform_passthrough_startup(&escape_sent,&boot_baseline) && peer_at_count==1 && boot_baseline==1u);
    assert(peer_boot_first_tx-boot_at>=1301u);
    puts("PASS_AQ_QUIET_WITHOUT_READY_STILL_REQUIRES_AT");

    lifecycle_case();
    peer_at_ignored=2;
    assert(!platform_passthrough_startup(&escape_sent,&boot_baseline) && escape_sent && peer_at_count==2);
    assert(!boot_baseline && pass_mode==PASS_LOCKED && !at_command("AT",500));
    puts("PASS_AQ_NO_READY_OR_AT_LOCKS");

    lifecycle_case();
    boot_at=g_uptime_ms;
    peer_boot_noise_at=boot_at+100u;peer_boot_noise_count=1;peer_boot_noise_period=100;
    assert(!platform_passthrough_startup(&escape_sent,&boot_baseline) && !peer_boot_first_tx);
    assert(g_uptime_ms-boot_at==3000u && !boot_baseline && pass_mode==PASS_LOCKED);
    puts("PASS_AQ_NO_QUIET_WITHIN_DEADLINE_LOCKS");

    recovery=(PassRecovery){2,true};
    uint32_t since=UINT32_MAX-50u;
    assert(!pass_recovery_stable(&recovery,since+299999u,since));
    assert(recovery.reentries==2 && recovery.reset_used);
    assert(pass_recovery_stable(&recovery,since+300000u,since));
    assert(!recovery.reentries && !recovery.reset_used && pass_reset_allowed(&recovery,false,false));
    puts("PASS_AL_STABLE_300_SECONDS_REPLENISHES_BUDGET_AFTER_TICK_WRAP");

    lifecycle_case();
    gateway_network_close();
    peer_wifi_until=g_uptime_ms+300000u;
    unsigned failed=0;
    uint32_t backoff=2000u;
    const uint32_t first_delays[]={2000u,4000u,8000u,16000u,30000u};
    while(!gateway_network_open()){
        gateway_network_close();
        assert(platform_at_synchronized() && !peer_reset_count && failed<20u);
        uint32_t began=g_uptime_ms;
        assert(gateway_passthrough_acquire(&backoff));
        assert(g_uptime_ms-began==first_delays[failed<5u?failed:4u]);
        failed++;
    }
    assert(failed>PASS_REENTRY_MAX && g_uptime_ms>=peer_wifi_until &&
           recovery.reentries==0 && gateway_mqtt_open(&will));
    puts("PASS_AL2_300_SECOND_WIFI_OUTAGE_RECOVERS_WITHOUT_SESSION_BUDGET");
    for(unsigned drop=1;drop<=PASS_REENTRY_MAX;drop++){
        terminal("\r\nCLOSED\r\n",0);
        assert(esp_mqtt_recv(bytes,4,40)<0);
        gateway_network_close();
        assert(gateway_passthrough_retry(&recovery.reentries)==(drop<PASS_REENTRY_MAX));
        assert(recovery.reentries==drop);
        if(drop<PASS_REENTRY_MAX)assert(gateway_network_open() && gateway_mqtt_open(&will));
    }
    puts("PASS_AL2_THIRD_SHORT_SESSION_DROP_LATCHES_LINK");

    PassBootDiag summary={.reset_flags=0x10000000,.escape_sent=1,.at_ok=1,.resumed=1,.reentries=2,.uart_err0=225};
    char line[120]="B5 DIAG";
    assert(pass_boot_diag_due(&summary,5000u) && !pass_boot_diag_due(&summary,5001u));
    assert(pass_boot_diag_due(&summary,10000u));
    pass_boot_diag_append(line+7,sizeof(line)-7,&summary);
    assert(!strcmp(line,"B5 DIAG boot_rst=10000000 boot_escape=1 boot_at=1 boot_resume=1 boot_reentries=2 boot_uart_err0=225\r\n"));
    assert(pass_boot_diag_due(&summary,55000u) && !pass_boot_diag_due(&summary,60000u) &&
           !pass_boot_diag_due(&summary,0));
    puts("PASS_AL2_DIAG_WITHOUT_BOOT_BANNER");

    lifecycle_case();
    peer_at_ignored=2;peer_reset_held=true;
    gateway_network_close();
    assert(peer_reset_count==1 && !platform_passthrough_soft_reset_safe() && !at_command("AT",500));
    puts("PASS_AN_LOW_STRAP_HOLD_BLOCKS_SOFT_RESET");

#ifdef MP_PRODUCTION_DIAG
    lifecycle_case();
    gateway_network_close();
    assert(gateway_network_open() && gateway_mqtt_open(&will));
    GatewayProductionDiag before,full,after;
    gateway_mqtt_production_diag(&before,g_uptime_ms);
    MpFrame wave={.node=2,.stream=MP_ECG,.rate=250,.count=1,.synthetic=true};
    assert(gateway_mqtt_begin(&wave)==GW_COMPLETE);
    uint16_t ids[GATEWAY_TELEMETRY_SLOTS];
    for(unsigned i=0;i<GATEWAY_TELEMETRY_SLOTS;i++){
        wave.replay=i==0;
        if(!wave.replay){wave.stream=MP_HR;wave.rate=0;}
        assert(gateway_mqtt_begin(&wave)==GW_PENDING);
        ids[i]=gateway_mqtt_ticket();
    }
    gateway_mqtt_production_diag(&full,g_uptime_ms);
    assert(full.used==GATEWAY_TELEMETRY_SLOTS && full.peak==GATEWAY_TELEMETRY_SLOTS);
    assert(gateway_mqtt_begin(&wave)==GW_DEFERRED);
    assert(full.published[0][MP_ECG]-before.published[0][MP_ECG]==1u);
    assert(full.published[1][MP_ECG]-before.published[1][MP_ECG]==1u);
    assert(full.published[0][MP_HR]-before.published[0][MP_HR]==GATEWAY_TELEMETRY_SLOTS-1u);
    delay_ms(100);
    gateway_mqtt_production_diag(&after,g_uptime_ms);
    assert(after.slot_ms[GATEWAY_TELEMETRY_SLOTS]-full.slot_ms[GATEWAY_TELEMETRY_SLOTS]==100u);
    for(unsigned i=0;i<GATEWAY_TELEMETRY_SLOTS;i++){
        uint32_t began=g_uptime_ms;
        do {assert(gateway_mqtt_progress()!=GW_FAILED && g_uptime_ms-began<1000u);}
        while(gateway_mqtt_ticket_result(ids[i])!=GW_COMPLETE);
    }
    gateway_mqtt_production_diag(&after,g_uptime_ms);
    assert(!after.used && after.puback.count-before.puback.count==GATEWAY_TELEMETRY_SLOTS);
    assert(after.acked[0][MP_ECG]==before.acked[0][MP_ECG]);
    assert(after.acked[1][MP_ECG]-before.acked[1][MP_ECG]==1u);
    assert(after.acked[0][MP_HR]-before.acked[0][MP_HR]==GATEWAY_TELEMETRY_SLOTS-1u);
    assert(gateway_mqtt_begin(&wave)==GW_PENDING);
    gateway_network_close();
    assert(gateway_network_open() && gateway_mqtt_open(&will));
    gateway_mqtt_production_diag(&after,g_uptime_ms);
    assert(!after.used && after.published[0][MP_HR]-before.published[0][MP_HR]==GATEWAY_TELEMETRY_SLOTS);
    assert(after.acked[0][MP_HR]-before.acked[0][MP_HR]==GATEWAY_TELEMETRY_SLOTS-1u);
    puts("PASS_AR_PRODUCTION_COUNTERS_QOS_REPLAY_SLOTS_AND_RECONNECT");
#endif
#ifdef MP_OUTAGE_RETENTION
    B5Publisher publisher={0};
    client.appCallback=record_mqtt_event;
    mp_router_init(&router);mp_router_attach_retention(&router,&retention);
    uint32_t started=g_uptime_ms;
    uint64_t utc=b5_data_utc();
    MpFrame old={.node=2,.stream=MP_HR,.seq=1,.count=1,.valid=true,.timestamp=utc-180000u};
    mp_router_put(&router,&old);
    MpFrame nibp={.node=5,.stream=MP_NIBP,.seq=1,.count=2,.valid=true,
        .timestamp=utc-179000u,.values={1200,800}};
    mp_router_put(&router,&nibp);
    MpFrame status={.node=2,.stream=MP_NODE_STATUS,.count=1,.timestamp=utc-179000u};
    mp_router_put(&router,&status);
    mp_router_online(&router,true);
    MpFrame live=old;live.seq=3;live.timestamp=utc;mp_router_put(&router,&live);
    gateway_mqtt_production_diag(&before,g_uptime_ms);
    assert(b5_egress_step(&router,&publisher,true));
    assert(publisher.pending && !router.scalar_pending);
    while(!router.ready_for_replay){
        platform_poll();assert(g_uptime_ms-started<5000u);
        assert(b5_egress_step(&router,&publisher,false));
    }
    unsigned ack_delay=peer_ack_ms;peer_ack_ms=500;
    for(unsigned i=0;i<GATEWAY_TELEMETRY_SLOTS-1;i++){
        live.seq++;live.timestamp=b5_data_utc();mp_router_put(&router,&live);
    }
    while(router.ln)assert(b5_egress_step(&router,&publisher,true) && g_uptime_ms-started<5000u);
    assert(b5_egress_step(&router,&publisher,true) && !router.scalar_pending);
    gateway_mqtt_production_diag(&after,g_uptime_ms);
    assert(after.used==GATEWAY_TELEMETRY_SLOTS-1u);
    peer_ack_ms=ack_delay;
    override_data_utc=true;test_data_utc=old.timestamp-1501u;
    while(publisher.pending){
        platform_poll();assert(g_uptime_ms-started<5000u);
        assert(b5_egress_step(&router,&publisher,true));
    }
    uint32_t taken=router.taken[MP_HR];
    assert(b5_egress_step(&router,&publisher,true) && router.taken[MP_HR]==taken && !router.scalar_pending);
    test_data_utc=0;
    for(unsigned i=0;i<3;i++)
        assert(b5_egress_step(&router,&publisher,true) && router.taken[MP_HR]==taken && !router.scalar_pending);
    assert(router.scalar_history.count==2 && router.scalar_replayed==0);
    test_data_utc=old.timestamp-1;
    assert(b5_egress_step(&router,&publisher,true) && router.taken[MP_HR]==taken && !router.scalar_pending);
    test_data_utc=old.timestamp;
    assert(b5_egress_step(&router,&publisher,true) && router.taken[MP_HR]==taken+1 && router.scalar_pending);
    assert(publisher.publishing.timestamp==old.timestamp);
    test_data_utc=0;
    while(publisher.pending){
        platform_poll();assert(g_uptime_ms-started<5000u);
        assert(b5_egress_step(&router,&publisher,true));
    }
    assert(router.scalar_replayed==1 && router.scalar_history.count==1 && !router.taken[MP_NIBP]);
    override_data_utc=false;
    puts("PASS_R25_REPLAY_WAITS_ON_CLOCK_REGRESSION_AND_EXPIRY_THEN_RESUMES");
    while(router.scalar_replayed!=2){
        platform_poll();assert(g_uptime_ms-started<5000u);
        assert(b5_egress_step(&router,&publisher,true));
    }
    gateway_mqtt_production_diag(&after,g_uptime_ms);
    assert(after.acked[0][MP_HR]-before.acked[0][MP_HR]==GATEWAY_TELEMETRY_SLOTS);
    assert(after.acked[1][MP_HR]-before.acked[1][MP_HR]==1u);
    assert(after.acked[1][MP_NIBP]-before.acked[1][MP_NIBP]==1u);
    assert(after.published[0][MP_NIBP]==before.published[0][MP_NIBP]);
    assert(publisher.publishing.replay && publisher.publishing.timestamp==nibp.timestamp &&
        b5_data_utc()-nibp.timestamp>90000u);
    char topic[128],body[256];
    assert(mp_topic(&publisher.publishing,topic,sizeof topic)>0 && strstr(topic,"/NODE-E/replay/nibp"));
    assert(mp_json(&publisher.publishing,body,sizeof body)>0 && strstr(body,"\"source\":\"REPLAY\"") &&
        strstr(body,"\"value\":[120.0,80.0]"));
    puts("PASS_R25_NIBP_OLDER_THAN_90_SECONDS_PUBLISHED_AS_REPLAY");
    assert(after.published[0][MP_NODE_STATUS]==before.published[0][MP_NODE_STATUS]);
    assert(!router.scalar_history.count && router.status_history.count==1 && publisher.q1==GATEWAY_TELEMETRY_SLOTS+2u);
    puts("PASS_R24_EGRESS_REALTIME_THEN_SCALAR_PUBACK");
#ifdef MP_TX_INTEGRITY_DIAG
    assert(txcheck.ack_next==GATEWAY_TELEMETRY_SLOTS+2u && txcheck.ack_gap);
    const TxCheckPacket *last=&txcheck.packets[(txcheck.packet_next-1)%TXCHECK_PACKETS];
    const TxCheckAck *ack=&txcheck.acks[(txcheck.ack_next-1)%TXCHECK_ACKS];
    assert(last->type==3 && last->stream==MP_NIBP && last->seq==nibp.seq && last->required==last->written);
    assert(ack->at-txcheck.last_write==ack->delay && ack->delay>0 && ack->interval>0);
    const unsigned char ping[]={0xc0,0};
    lifecycle_case();
    assert(!txcheck.ack_next && !txcheck.packet_next);
    uint32_t before_bytes=txcheck.bytes,before_packets=txcheck.count;
    try_nested_tx=true;hold_tx_after=1;hold_tx_ms=6;
    assert(esp_mqtt_send(ping,sizeof ping,500)==(int)sizeof ping);
    assert(txcheck.reentry==1 && txcheck.reentry_poll && txcheck.reentry_outer_stream==TXCHECK_CONTROL);
    assert(txcheck.packets[0].gap>=6 && txcheck.bytes-before_bytes==2 && txcheck.count-before_packets==1);
    hold_tx_after=1;hold_tx_ms=120;
    assert(esp_mqtt_send(ping,sizeof ping,50)<0);
    assert(txcheck.short_write==1 && txcheck.txe_timeout==1 && txcheck.packets[1].written==1);
    assert(esp_mqtt_send(ping,sizeof ping,500)<0 && txcheck.count-before_packets==2 && txcheck.bytes-before_bytes==3);
    char tx_line[224];txcheck_format(tx_line,sizeof tx_line,g_uptime_ms);
    assert(strstr(tx_line,"short=1 txe_to=1") && strstr(tx_line,"req=2 wr=1\r\n"));
    txcheck_exit();
    txcheck_enter();
    for(unsigned id=1;id<=TXCHECK_ACKS+4;id++){
        advance(100000);
        platform_txcheck_ack((uint16_t)id,g_uptime_ms-7);
    }
    assert(txcheck.acks[4].id==5 && txcheck.acks[3].id==TXCHECK_ACKS+4);
    assert(txcheck.acks[3].delay==7 && txcheck.acks[3].interval==100);
    puts("PASS_R29_TXCHECK_BYTES_GAP_REENTRY_SHORT_TXE_AND_PUBACK");
#endif
#endif
}
#endif

#ifdef MP_LINK_RESILIENCE
static void cold_recovery_cases(void){
    const char *no_socket[]={"\r\nSTATUS:0\r\nOK\r\n","\r\nSTATUS:1\r\nOK\r\n"};
    for(unsigned i=0;i<2;i++){
        lifecycle_case();peer_stream=false;pass_mode=PASS_BOOT;
        uint32_t baseline=0;unsigned escape_sent=0;
        uart_hw_total=errors=222;
        terminal("\r\nready\r\n",100);
        assert(platform_passthrough_startup(&escape_sent,&baseline) && baseline==222);
        peer_close_error=true;peer_status_reply=no_socket[i];
        assert(gateway_network_open() && peer_close_count==1 && !peer_reset_count && !uart_rebases);
    }
    puts("PASS_AX_STATUS_0_1_COLD_BOOT_WITHOUT_HARD_RESET");

    const char *socket[]={"\r\nSTATUS:3\r\nOK\r\n",
        "\r\nSTATUS:1\r\n+CIPSTATUS:0,\"TCP\",\"192.0.2.1\",1,2,0\r\nOK\r\n"};
    for(unsigned i=0;i<2;i++){
        lifecycle_case();peer_stream=false;pass_mode=PASS_COMMAND;
        uart_hw_total=222;peer_close_error=true;peer_status_reply=socket[i];
        assert(!gateway_network_open() && !peer_reset_count);
        peer_reset_available=peer_reset_noise=true;
        gateway_network_close();
        assert(peer_reset_count==1 && platform_at_synchronized() && !errors);
        assert(uart_rebases==1 && uart_rebase_before==222 && uart_rebase_after==223);
        EspUartErrors uart;
        platform_uart_error_snapshot(&uart);
        assert(uart.total==223 && uart.fe==1 && !uart.ore && !uart.ne && !uart.overflow);
    }
    puts("PASS_AX_ACTIVE_SOCKET_RESETS_AND_READY_AT_REBASES_FRAMING_ERROR");

    for(unsigned i=0;i<2;i++){
        lifecycle_case();peer_reset_available=peer_reset_noise=true;
        peer_reset_silent=i==0;peer_at_ignored=i==1;
        assert(!platform_passthrough_recover() && peer_reset_count==1 && !uart_rebases);
        assert(platform_uart_errors_total()==1 && !platform_at_synchronized());
    }
    puts("PASS_AX_MISSING_READY_OR_AT_NEVER_REBASES");
}

static void link_resilience_cases(void){
    lifecycle_case();
    gateway_network_close();
    MpFrame will={.node=3,.stream=MP_GATEWAY_STATUS,.synthetic=true};
    assert(gateway_network_open() && gateway_mqtt_open(&will));
    PassLinkDrops drops={0};unsigned reentries=0;
    const uint32_t delays[]={2000u,4000u,8000u,16000u,30000u};
    for(unsigned i=0;i<20;i++){
        if(i%5u==0){
            MQTTPacketInfo_t packet={.type=MQTT_PACKET_TYPE_PUBACK};
            MQTTDeserializedInfo_t decoded={.packetIdentifier=42,.deserializationResult=MQTTSuccess};
            mqtt_event(&client,&packet,&decoded);
            assert(gateway_mqtt_progress()==GW_FAILED);
        }else{
            terminal(i%2?"\r\nWIFI DISCONNECT\r\n":"\r\nCLOSED\r\n",0);
            uint8_t byte;assert(esp_mqtt_recv(&byte,1,40)<0);
        }
        gateway_network_close();
        uint32_t start=g_uptime_ms;
        assert(gateway_link_retry(&drops,&reentries));
        assert(g_uptime_ms-start==delays[i<5?i:4]);
        assert(drops.total==i+1 && drops.consecutive==i+1 && reentries<=2);
        if(i%5u==2u || i%5u==3u){
            peer_fail_command=i%5u==2u?"AT+CIPSNTPCFG":"AT+CIPSTART";
            assert(!gateway_network_open());gateway_network_close();
            uint32_t acquire=2000;assert(gateway_passthrough_acquire(&acquire));
            assert(drops.total==i+1 && drops.consecutive==i+1);
            peer_fail_command=NULL;
        }
        assert(gateway_network_open() && gateway_mqtt_open(&will));
    }
    puts("PASS_AW_20_NETWORK_DROPS_CONTINUE_WITH_30_SECOND_CAP");
    PassRecovery recovery={reentries,false};
    assert(!pass_recovery_stable(&recovery,299999,0));
    assert(pass_recovery_stable(&recovery,300000,0));
    drops.consecutive=0;assert(drops.total==20 && pass_link_drop(&drops)==2000u && drops.total==21);
    peer_stop=true;assert(!gateway_link_retry(&drops,&reentries));peer_stop=false;
    puts("PASS_AW_STABLE_RESET_PRESERVES_TOTAL_AND_STOP_BLOCKS_RETRY");

    gateway_network_close();
    assert(gateway_network_open() && gateway_mqtt_open(&will));
    client.appCallback=record_mqtt_event;
    mp_router_init(&router);mp_router_online(&router,true);
    B5Publisher publisher={0};
    uint64_t utc=b5_data_utc();
    MpFrame scalar={.node=2,.stream=MP_HR,.count=1,.valid=true,.synthetic=true,.timestamp=utc};
    MpFrame wave={.node=2,.stream=MP_ECG,.rate=250,.count=50,.valid=true,.synthetic=true,.timestamp=utc};
    peer_ack_ms=2500;
    mp_router_put(&router,&scalar);
    assert(b5_egress_step(&router,&publisher,true));
    uint32_t began=g_uptime_ms;
    stall_cut_at=telemetry[0].at+LINK_PUBACK_STALL_MS+1u;stall_qos0_bytes=0;
    while(stall_cut_at-g_uptime_ms>10u){
        tick();assert(b5_egress_step(&router,&publisher,true));
    }
    assert(gateway_mqtt_begin(&wave)==GW_COMPLETE);
    assert(gateway_link_wave_paused());
    assert(stall_qos0_bytes>0 && stall_qos0_bytes<=1024);
    printf("PASS_AW_PACKET_CROSSING_THRESHOLD_QOS0_BYTES=%u\n",stall_qos0_bytes);
    stall_cut_at=0;
    uint32_t start_bytes=txcheck.bytes;
    publisher.deferred=true;publisher.publishing=wave;publisher.publishing.seq=1;
    for(unsigned i=2;i<=3;i++){
        wave.seq=i;wave.timestamp=b5_data_utc();mp_router_put(&router,&wave);
        assert(b5_egress_step(&router,&publisher,true));
    }
    assert(router.ln==3 && txcheck.bytes==start_bytes);
    scalar.seq=1;scalar.timestamp=b5_data_utc();mp_router_put(&router,&scalar);
    assert(b5_egress_step(&router,&publisher,true));
    assert(publisher.tickets[1] && router.ln==3);
    assert(router.held_packets==3 && router.held_bytes_upper==3u*(384u+12u*wave.count));
    unsigned held_bytes=txcheck.bytes-start_bytes;
    while(gateway_link_wave_paused()){
        tick();assert(b5_egress_step(&router,&publisher,true));
        assert(g_uptime_ms-began<4000u);
    }
    assert(txcheck.bytes>start_bytes && held_bytes<1024);
    while(publisher.pending || router.ln){tick();assert(b5_egress_step(&router,&publisher,true));}
    assert(publisher.q0==3 && publisher.q1==2 && !router.dropped);
    printf("PASS_AW_STALL_QOS0_BYTES=0 QOS1_DURING_PAUSE=%u RESUME_NO_DUPLICATE scalar_acked=2\n",held_bytes);

    gateway_network_close();assert(gateway_network_open() && gateway_mqtt_open(&will));
    peer_ack_ms=55;delay_ms(10000);
    assert(gateway_mqtt_begin(&scalar)==GW_PENDING && !gateway_link_wave_paused());
    uint16_t id=gateway_mqtt_ticket();
    while(gateway_mqtt_ticket_result(id)!=GW_COMPLETE){assert(gateway_mqtt_progress()!=GW_FAILED);tick();}
    puts("PASS_AW_IDLE_WITHOUT_PENDING_IS_NOT_A_STALL");

    peer_no_ack=true;assert(gateway_mqtt_begin(&scalar)==GW_PENDING);
    uint32_t deadline=g_uptime_ms;
    do {tick();}while(g_uptime_ms-deadline<5000u);
    assert(gateway_mqtt_progress()==GW_FAILED);
    puts("PASS_AW_ORIGINAL_5_SECOND_DEADLINE_PRESERVED");
}
#endif

static void pass_fault_cases(void){
    uint8_t bytes[8];
    assert(platform_passthrough_enter() && pass_mode==PASS_STREAM);
    assert(!at_command("AT",1000));
    const unsigned char ping[]={0xc0,0};
    assert(esp_mqtt_send(ping,2,500)==2);
    const uint32_t sent=g_uptime_ms;
    assert(esp_mqtt_recv(bytes,2,5)==0);
    int received; do {received=esp_mqtt_recv(bytes,1,5);assert(g_uptime_ms-sent<100u);}while(!received);
    assert(received==1 && bytes[0]==0xd0 && g_uptime_ms>=peer_flush_at);
    assert(esp_mqtt_recv(bytes+1,1,5)==1 && bytes[1]==0);
    assert(!io_metrics.rx_queries && !io_metrics.tx_confirmed);
    /* 大于 1460 的 MQTT 报文在 TLS 分片后仍交付完整。 */
    uint8_t large[2048]={0xf0,0xfd,0x0f};
    peer_hold_timer=true;
    assert(esp_mqtt_send(large,sizeof large,800)==(int)sizeof large);
    peer_hold_timer=false;
    while(peer_serial_n)platform_poll();
    assert(peer_chunks>=3 && peer_chunk_max==1460 && outgoing_count==sizeof large && !peer_frame_n);
    assert(esp_mqtt_send((const unsigned char *)"+++",3,500)<0 && peer_escape_count==0);
    const char *faults[]={"\r\nCLOSED\r\n","WIFI DISCONNECT\r\n","\x40\x05"};
    for(unsigned i=0;i<3;i++){
        if(i){pass_case_reset();assert(platform_passthrough_enter());}
        terminal(faults[i],0);
        int result=esp_mqtt_recv(bytes,8,5);
        if(result>0)result=esp_mqtt_recv(bytes,8,5);
        assert(result<0 && pass_mode==PASS_FAULT);
        assert(esp_mqtt_send(ping,2,500)<0);
        assert(platform_passthrough_leave() && peer_escape_count==1 && pass_mode==PASS_COMMAND);
    }
    pass_case_reset();assert(platform_passthrough_enter());
    peer_no_ack=true;
    assert(!platform_passthrough_leave() && peer_escape_count==1 && pass_mode==PASS_UNKNOWN);
    assert(!platform_passthrough_leave() && peer_escape_count==1 && !at_command("AT",500));
    pass_case_reset();assert(platform_passthrough_enter());
    /* 注入 UART 损坏后既不续写 MQTT，也不猜测转义边界。 */
    errors++;
    assert(esp_mqtt_recv(bytes,1,5)<0 && !platform_passthrough_leave() && !peer_escape_count);
    pass_case_reset();assert(platform_passthrough_enter());
    peer_tx_stop_after=1;
    assert(esp_mqtt_send(ping,2,500)<0 && io_metrics.written==1 && pass_mode==PASS_UNKNOWN);
    assert(!platform_passthrough_leave() && !peer_escape_count && !at_command("AT",500));
    for(unsigned scenario=1;scenario<=3;scenario++){
        pass_case_reset();peer_entry_case=scenario;
        assert(!platform_passthrough_enter());
        assert(pass_mode==(scenario==2?PASS_COMMAND:PASS_UNKNOWN));
    }
    puts("PASS_PEER_HANDSHAKE_COALESCE_SEGMENT_DIRECT_URC_GUARDS");
}
#endif

#ifdef MP_TTS_BROADCAST
static void az_frame(uint8_t frame[22],uint64_t issued)
{
    const uint8_t golden[]={0x4d,0x50,0x42,0x31,1,0,0,0,0,0,0,0,0,0,0,0x3a,0x98,0,3,0xe6,0xb5,0x8b};
    memcpy(frame,golden,sizeof golden);
    for(unsigned i=0;i<8;i++)frame[12-i]=(uint8_t)(issued>>(8u*i));
}

static void tts_broadcast_cases(void)
{
    uint8_t frame[22],too_long[220]={0};
    uint64_t utc=1800000000000ULL;
    TtsIo io={NULL,az_write,az_idle,tts_abort};
    tts_broadcast_init(io);
    az_frame(frame,utc);
    assert(!tts_broadcast_offer(frame,sizeof frame,0));
    assert(!tts_broadcast_offer(frame,sizeof frame,utc+15000u));
    assert(!tts_broadcast_offer(too_long,sizeof too_long,utc));
    az_frame(frame,UINT64_MAX);assert(!tts_broadcast_offer(frame,sizeof frame,utc));az_frame(frame,utc);
    frame[0]='X';assert(!tts_broadcast_offer(frame,sizeof frame,utc));frame[0]='M';
    frame[4]=2;assert(!tts_broadcast_offer(frame,sizeof frame,utc));frame[4]=1;
    frame[18]=4;assert(!tts_broadcast_offer(frame,sizeof frame,utc));frame[18]=3;
    assert(tts_broadcast_offer(frame,sizeof frame,utc));
    assert(!tts_broadcast_offer(frame,sizeof frame,utc));
    az_frame(frame,utc-1);assert(!tts_broadcast_offer(frame,sizeof frame,utc));
    for(unsigned i=1;i<=3;i++){
        az_frame(frame,utc+i);
        assert(tts_broadcast_offer(frame,sizeof frame,utc+i)==(i<3));
    }
    override_data_utc=true;test_data_utc=utc+15003u;
    for(unsigned i=0;i<4;i++)tts_broadcast_poll(0);
    assert(!az_written && tts_broadcast_offer(frame,sizeof frame,utc+15002u));
    puts("PASS_AZ_FRAME_EXPIRY_REPLAY_CLOCK_AND_FULL_QUEUE");

    tts_broadcast_init(io);az_frame(frame,utc);test_data_utc=utc;
    assert(tts_broadcast_offer(frame,sizeof frame,utc));
    for(unsigned i=0;i<10;i++)tts_broadcast_poll(0);
    az_status=2;tts_broadcast_poll(1);
    az_frame(frame,utc+1);assert(tts_broadcast_offer(frame,sizeof frame,utc+1));
    for(unsigned i=0;i<10;i++)tts_broadcast_poll(4999);
    assert(az_written==8);
    for(unsigned i=0;i<10;i++)tts_broadcast_poll(5000);
    assert(az_written==16);
    puts("PASS_AZ_TTS_FIVE_SECOND_INTERVAL");

    override_data_utc=false;az_written=0;tts_broadcast_init(io);
    lifecycle_case();mqtt_adapter_reset(&network);
    epoch=1800000000u;epoch_tick=g_uptime_ms;
    MpFrame will={.node=3,.stream=MP_GATEWAY_STATUS,.synthetic=true,.timestamp=b5_data_utc()};
    assert(gateway_mqtt_open(&will));client.appCallback=record_mqtt_event;
    az_suback_grant=0x80;gateway_tts_broadcast_subscribe();
    uint32_t start=g_uptime_ms;
    while(broadcast_subscription)assert(gateway_mqtt_progress()!=GW_FAILED && g_uptime_ms-start<500u);
    assert(!broadcast_subscribed && mqtt_online);
    az_suback_grant=1;gateway_tts_broadcast_subscribe();start=g_uptime_ms;
    while(!broadcast_subscribed){
        int progress=gateway_mqtt_progress();
        if(progress==GW_FAILED || g_uptime_ms-start>=500u)
            fprintf(stderr,"AZ SUBACK failed elapsed=%lu progress=%d online=%d connected=%d id=%u tx=%02x peer=%u rx=%u/%u\n",
                (unsigned long)(g_uptime_ms-start),progress,mqtt_online,network.connected,broadcast_subscription,
                wire_packet[0],peer_count,reply_offset,reply_count);
        assert(progress!=GW_FAILED && g_uptime_ms-start<500u);
    }

    const char topic[]=TTS_BROADCAST_TOPIC;
    enum { REMAINING=4+sizeof topic-1+19+200 };
    uint8_t packet[3+REMAINING]={0x32,(REMAINING&127u)|128u,REMAINING>>7,0,sizeof topic-1};
    memcpy(packet+5,topic,sizeof topic-1);
    size_t pos=5+sizeof topic-1;
    packet[pos++]=0;packet[pos++]=77;
    az_frame(frame,b5_data_utc());frame[18]=200;
    memcpy(packet+pos,frame,19);memset(packet+pos+19,'A',200);
    uart_reply(packet,sizeof packet,0);
    mp_router_init(&router);mp_router_online(&router,true);
    MpFrame scalar={.node=2,.stream=MP_HR,.count=1,.valid=true,.synthetic=true,.timestamp=b5_data_utc(),.values={75}};
    MpFrame wave={.node=2,.stream=MP_ECG,.rate=250,.count=50,.valid=true,.synthetic=true,.timestamp=b5_data_utc()};
    mp_router_put(&router,&scalar);mp_router_put(&router,&wave);
    B5Publisher publisher={0};
    az_poll=true;start=g_uptime_ms;
    while(publisher.q0!=1 || publisher.q1!=1 || az_written!=205 || az_pubacks!=1){
        platform_poll();assert(b5_egress_step(&router,&publisher,true));assert(g_uptime_ms-start<2000u);
    }
    assert(!memcmp(az_uart,(uint8_t[]){0xfd,0,202,1,4},5));
    assert(!memcmp(az_uart+5,packet+pos+19,200));
    assert(!publisher.failed && !session_error && pass_mode==PASS_STREAM);
    puts("PASS_AZ_PASSTHROUGH_MPB1_PUBACK_AND_TELEMETRY_SCHEDULING");
}
#endif

int main(int argc,char **argv){
#ifdef MP_TTS_BROADCAST
    USART3->BRR=0x45;USART3->SR|=USART_SR_TC;
    platform_set_poll(tick);tts_broadcast_cases();return 0;
#endif
#ifdef MP_ESP_PASSTHROUGH
#ifdef MP_PASS_LIFECYCLE
    if(argc==1){
        USART3->BRR=0x45;USART3->SR|=USART_SR_TC;
        platform_set_poll(tick);lifecycle_cases();
#ifdef MP_LINK_RESILIENCE
        link_resilience_cases();cold_recovery_cases();
#endif
        assert(esp_uart_baud==115200u && USART3->BRR==0x45);
        return 0;
    }
#endif
    if((argc==2 && !strcmp(argv[1],"--pass-check"))
#if defined(MP_FIVE_FIELD01) && !defined(MP_ESP_UART_230400)
       || argc==1
#endif
    ){
        assert(pass_mode==PASS_COMMAND && esp_uart_baud==115200u);
        USART3->BRR=0x45;USART3->SR|=USART_SR_TC;
        platform_set_poll(tick);pass_fault_cases();
        assert(esp_uart_baud==115200u && USART3->BRR==0x45);
        return 0;
    }
    const bool transparent=argc>5 && !strcmp(argv[5],"pass");
    if(argc>6)peer_ack_ms=(unsigned)atoi(argv[6]);
    if(argc>7)window_ms=(unsigned)atoi(argv[7]);
#ifdef MP_P3_R15_SCAN
    if(argc>8){
        r15_rate=(unsigned)atoi(argv[8]);
        assert(transparent && argc==10);
        r16_ppg_edge=!strcmp(argv[9],"ppg-edge");
        r16_upper=r16_ppg_edge || !strcmp(argv[9],"upper");
        assert((r15_rate>=10500 && r15_rate<=24000) || (r16_ppg_edge && r15_rate==60500));
        r15_fast_ack=!strcmp(argv[9],"fast-ack");
        r15_line_only=!strcmp(argv[9],"line-only");
        r15_can_proportional=!strcmp(argv[9],"can-proportional");
        assert(r15_fast_ack || r15_line_only || r15_can_proportional || r16_upper || !strcmp(argv[9],"calibrated"));
        r15_can_fps=r16_upper?370u:(370u*r15_rate+5250u)/10500u;
    }
#endif
#ifdef MP_P3_SERVICE_MODEL
    dma_mode=argc>5 && !strcmp(argv[5],"dma");
    if(argc>8)service_us=(unsigned)atoi(argv[8]);
    assert(service_us<=120u);
#endif
    assert(window_ms==110000 || window_ms==300000);
    USART3->SR|=USART_SR_TC;
#endif
    unsigned blocks=argc>1?(unsigned)atoi(argv[1]):0;
    assert(blocks==0 || blocks==64 || blocks==125);
    if(argc>2){terminal_ms=(unsigned)atoi(argv[2]);assert(terminal_ms<500);}
    if(argc>3)esp_uart_baud=(unsigned)atoi(argv[3]);
    assert(esp_uart_baud==115200u || esp_uart_baud==230400u);
    if(argc>4)byte_cpu_us=(unsigned)atoi(argv[4]);
    assert(byte_cpu_us<=120u);
    wire_us=(10000000u+esp_uart_baud/2u)/esp_uart_baud;
#ifdef MP_P3_R15_SCAN
    r15_tx_us=r15_line_only?wire_us:esp_uart_baud==115200u?118u:62u;
    if(r15_can_proportional){
        assert(r15_rate<=16000u);
        r15_service_us=(r15_service_us*r15_rate+5250u)/10500u;
        r15_tx_us=wire_us+((r15_tx_us-wire_us)*r15_rate+5250u)/10500u;
    }
#endif
    samples_wanted=blocks==64?16160:32000;
    for(unsigned i=0;i<MIC_SAMPLES;i++)pcm[i]=(int16_t)(i*13u+7u);
    platform_set_poll(tick);mqtt_adapter_reset(&network);esp_mqtt_reset();
    epoch=1800000000;epoch_tick=g_uptime_ms;
    MpFrame will={0};will.node=3;will.stream=MP_GATEWAY_STATUS;will.synthetic=true;will.timestamp=gateway_epoch_milliseconds();
#ifdef MP_ESP_PASSTHROUGH
    if(transparent){
#ifdef MP_PASS_LIFECYCLE
        lifecycle_case();
#else
        assert(platform_passthrough_enter());
#endif
    }
#endif
    assert(gateway_mqtt_open(&will));
    client.appCallback=record_mqtt_event;
#ifndef MP_AUDIO_DISABLED
    assert(gateway_audio_subscribe()==GW_PENDING);
    while(!gateway_audio_ready())assert(gateway_mqtt_progress()!=GW_FAILED);
#endif
    mp_router_init(&router);mp_router_online(&router,true);
#ifdef MP_OUTAGE_RETENTION
    mp_router_attach_retention(&router,&retention);
#endif
    unified_audio_init();unified_audio_network(true);
    B5Publisher publisher={0};
    origin=g_uptime_ms;epoch_tick=origin;
    memset(stage_us,0,sizeof stage_us);serial_payload_bytes=0;
    uint32_t first_queries=io_metrics.rx_queries, first_empty=io_metrics.rx_empty, first_reads=io_metrics.rx_reads;
    unsigned slot_samples=0,slot_full_samples=0,slot_max=0,next_sample=30000;
#ifdef MP_P3_R15_SCAN
    unsigned previous_slots=0;
    uint64_t slot_at=simulated_us,slot_full_us=0,slot_sum_us=0;
    r15_tx_bytes=0;r15_tx_us_total=0;
    r15_service_at=simulated_us+5000u;
#endif
    while(g_uptime_ms-origin<window_ms){
        platform_poll();
        if(blocks && !recording_started && produced>=10000){unified_audio_command('R',false);recording_started=1;assert(mic_state==1);}
        if(!b5_egress_step(&router,&publisher,true)){
            printf("FAILED tick=%u phase=%lu q0=%lu q1=%lu audio=%u\n",(unsigned)(g_uptime_ms-origin),
                (unsigned long)io_metrics.at_phase,(unsigned long)publisher.q0,(unsigned long)publisher.q1,audio_blocks);
            return 3;
        }
        unsigned used=0;
        for(unsigned i=0;i<GATEWAY_TELEMETRY_SLOTS;i++)used+=publisher.tickets[i]!=0;
#ifdef MP_P3_R15_SCAN
        uint64_t elapsed_us=simulated_us-slot_at;
        slot_sum_us+=elapsed_us*previous_slots;
        if(previous_slots==GATEWAY_TELEMETRY_SLOTS)slot_full_us+=elapsed_us;
        previous_slots=used;slot_at=simulated_us;
#endif
        if(used>slot_max)slot_max=used;
        slot_samples++;slot_full_samples+=used==GATEWAY_TELEMETRY_SLOTS;
        if(g_uptime_ms-origin>=next_sample){
            printf("queue tick=%u live=%u history=%u slots=%u dropped=%lu replaced=%lu\n",
                   (unsigned)(g_uptime_ms-origin),router.ln,router.cn,used,
                   (unsigned long)router.dropped,(unsigned long)router.live_replaced);
            next_sample+=30000u;
        }
        unified_audio_step(!publisher.deferred && !router.ln);
    }
    stop_at=g_uptime_ms;
#ifdef MP_P3_SERVICE_MODEL
    printf("service cpu_us_per_poll=%u calls=%lu dma_bytes=%lu\n",
        service_us,(unsigned long)service_calls,(unsigned long)dma_bytes);
#endif
    unsigned total=0;
    for(unsigned node=1;node<=5;node++)for(unsigned stream=0;stream<MP_STREAMS;stream++)total+=seq[node][stream];
    printf("offered total=%u publisher_bytes=%u telemetry_slot_bytes=%u coremqtt_slot_bytes=%u\n",
           total,(unsigned)sizeof publisher,(unsigned)sizeof telemetry[0],(unsigned)sizeof outgoing[0]);
    printf("slots limit=%u max=%u samples=%u full=%u ack_delay_ms=%u\n",
        GATEWAY_TELEMETRY_SLOTS,slot_max,slot_samples,slot_full_samples,peer_ack_ms);
#ifdef MP_P3_R15_SCAN
    printf("calibration offered_millihz=%u assumed_can_fps=%u tx_byte_us=%u tx_bytes=%u tx_us=%" PRIu64
           " service_us=%" PRIu64 " slot_sum_us=%" PRIu64 " slot_full_us=%" PRIu64 "\n",
           r15_rate,r15_can_fps,r15_tx_us,r15_tx_bytes,r15_tx_us_total,r15_service_us_total,slot_sum_us,slot_full_us);
#endif
#ifdef MP_ESP_PASSTHROUGH
    printf("peer transparent=%u chunks=%u chunk_max=%u rx_max=%u send_ok=%lu\n",
        (unsigned)transparent,peer_chunks,peer_chunk_max,peer_rx_max,(unsigned long)io_metrics.tx_confirmed);
#endif
    printf("case blocks=%u terminal_ms=%u baud=%u cpu_us=%u wire_us=%u elapsed_ms=%u offered_wave=%u delivered_wave=%u\n",
        blocks,terminal_ms,(unsigned)esp_uart_baud,byte_cpu_us,wire_us,
        (unsigned)(stop_at-origin),seq[2][MP_ECG]+seq[2][MP_RESP]+seq[1][MP_PPG],
        delivered[2][MP_ECG]+delivered[2][MP_RESP]+delivered[1][MP_PPG]);
    printf("flow q0=%lu q1=%lu published=%u replay=%u audio=%u audio_span_ms=%u audio_first_ms=%u audio_acked=%u queue_live=%u queue_history=%u inflight=%u high=%lu overflow=%lu replaced=%lu dropped=%lu expired=%lu late=%u identity_errors=%u duplicates=%u\n",
        (unsigned long)publisher.q0,(unsigned long)publisher.q1,medical_published,replay_count,audio_blocks,
        audio_blocks?(unsigned)(last_audio-first_audio):0,audio_blocks?(unsigned)(first_audio-origin):0,
#ifdef MP_AUDIO_DISABLED
        0u,
#else
        audio_blocks-(gateway_audio_pending()?1u:0u),
#endif
        router.ln,router.cn,(unsigned)publisher.pending,
        (unsigned long)router.high_water,(unsigned long)router.live_overflow,(unsigned long)router.live_replaced,
        (unsigned long)router.dropped,(unsigned long)router.expired,late,identity_errors,duplicates);
    printf("owner idle_us=%" PRIu64 " command_us=%" PRIu64 " prompt_us=%" PRIu64 " data_us=%" PRIu64
        " send_ok_us=%" PRIu64 " rx_len_us=%" PRIu64 " rx_data_us=%" PRIu64 " rx_with_queue_us=%" PRIu64
        " empty_us=%" PRIu64 " queries=%lu empty=%lu reads=%lu queries_with_queue=%u tx_payload_bytes=%u reclaim_max_ms=%u\n",
        stage_us[0],stage_us[1],stage_us[2],stage_us[3],stage_us[4],stage_us[5],stage_us[6],
        rx_queue_us,empty_query_us,(unsigned long)(io_metrics.rx_queries-first_queries),
        (unsigned long)(io_metrics.rx_empty-first_empty),(unsigned long)(io_metrics.rx_reads-first_reads),
        rx_queries_with_queue,serial_payload_bytes,reclaim_max);
    for(unsigned node=1;node<=5;node++)for(unsigned stream=0;stream<MP_STREAMS;stream++){
        if(seq[node][stream])printf("stream node=%u stream=%u offered=%u delivered=%u max_gap_ms=%u\n",node,stream,
             seq[node][stream],delivered[node][stream],max_gap_ms[node][stream]);
    }
    latency("json",&mqtt_metrics.json);latency("send",&mqtt_metrics.send);latency("puback",&mqtt_metrics.ack);
    latency("residence",&router.residence);latency("source_age",&router.source_age);
#ifdef MP_LINK_RESILIENCE
    GatewayLinkDiag link;gateway_link_diag(&link);
    printf("link_res triggers=%lu paused_ms=%lu held_packets=%lu held_bytes_upper=%lu\n",
        (unsigned long)link.triggers,(unsigned long)link.paused_ms,
        (unsigned long)router.held_packets,(unsigned long)router.held_bytes_upper);
#endif
    return identity_errors || duplicates || publisher.failed || platform_at_unsynced()?3:0;
}
