Serendipity-min/medical-multi-parameter-monitor/node-b/tools/b4_ecg_rala_can_current.py

"""当前39948B ECG60/1mV、RA–LA–RL与C共同窗的150秒B只读原码取证。"""
import argparse
import ctypes as C
import hashlib
import json
from pathlib import Path
import subprocess
import sys
import time

import b4_recovery as pkg
import b4_runtime as live
import readback_b as raw
import runtime_state_b as runtime

ROOT = Path(__file__).resolve().parents[2]
SCOPE = 'B4_ECG60_RALA_CAN_JOINT_READONLY_150S'
SLOTS = 0x20002160
READS = {a: set(s) for a, s in live.READS.items()}
READS[SLOTS] = {3072}
# VTOR=0时允许核对已读固件首64B与地址0别名，不扩大任何目标写入口。
READS[0x08000000] = {64, 39948}
MENU = {'mode': 'NORMAL_ECG', 'HR_bpm': 60, 'ECG_amplitude_menu_mV': 1.0,
        'stored_RESP_bpm': 15, 'RESP_amplitude_literal': '1.5R',
        'stored_waveform_period_literal': '30bpm', 'apnea_literal': '0s'}
CRITERIA = {'warmup_ms': 45000, 'evaluation_ms': 90000,
            'HR_nominal_range': [58, 62], 'minimum_raw_frames': 22000,
            'maximum_diagnostic_gap_ms': 1500, 'minimum_saved_observations': 90,
            'SPS_range': [247.5, 252.5], 'required_HR_saved_valid_fraction': 1.0,
            'CH2_required_near_rail_frames': 0, 'RR': 'CHARACTERIZATION_ONLY',
            'CAN_reference': 'C_START_PLUS_45_TO_135_SECONDS',
            'common_raw_selection': 'B_SAMPLE_TICKS_ACTUALLY_RECEIVED_BY_C_ECG_PDO'}



def bindings():
    names = ('b4_ecg_rala_can_current.py', 'b4_runtime.py', 'c_b4_readonly.py', 'readback_b.py',
             'runtime_state_b.py', 'live_state_b.py', 'resp_exploratory.py', 'b4_recovery.py')
    return {n: raw.sha(Path(__file__).with_name(n)) for n in names}


def plan():
    # 普通ECG60/1mV源与RA–LA–RL专用记录；RR仅表征，不冒称已确认动态阻抗输入。
    return {'scope': SCOPE, 'menu': MENU, 'criteria': CRITERIA, 'tools_sha256': bindings(),
            'image_sha256': live.IMAGE_SHA, 'duration_s': 150, 'hard_limit_s': 180,
            'explicit_reset_halt_go_writes': 0, 'probe_sessions': 1, 'retries': 0,
            'Z0_ohm': None, 'delta_Zpp_ohm': None,
            'source_case_model': 'SKX-2000+', 'manual_model': 'SKX-2000D+ V2.2',
            'model_equivalence': 'NOT_PROVEN', 'new_C_receive_window': True,
            'leads': {'R': 'RA', 'L': 'LA', 'F': 'RL', 'LL': 'EMPTY'}}


def validate(a):
    live.need(a.get('enabled') is True and a.get('owner_approved') is True,
              'ECG_CAN_CURRENT_OWNER_REQUIRED')
    live.need(a.get('plan') == plan(), 'ECG_CAN_CURRENT_BINDINGS_DRIFT')
    live.need(a.get('observed_menu') == MENU and a.get('JLink_on_B') is True
              and a.get('battery_no_USB') is True, 'ECG_CAN_CURRENT_SOURCE_ROUTE')
    live.need(time.time() < a.get('expires_unix', 0), 'ECG_CAN_CURRENT_EXPIRED')
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
