Serendipity-min/medical-multi-parameter-monitor/(commit log)

2026-09-18 feat: initial commit with medical monitor schematics, datasheets, drivers and documentation
    [1_P1.schdoc, PW195A V3.0 封装.pcbdoc]
2026-09-20 feat: add bounded ESP AT probe and verified hardware findings
2026-09-20 fix(p): address PR2 review with durable diagnostics CI and staged contracts
2026-09-20 完成第二轮修复及阶段二 CANopen 汇聚与可靠性验证
2026-09-20 style: 规整前两阶段代码并补充中文维护注释
2026-09-20 docs(web): add clinical monitor UI reference analysis and wireframe spec
2026-09-20 fix(security): resolve Paho C buffer safety defects and harden gateway transport (P4)
    [gateway_transport.c]
2026-09-20 fix(security): close remaining Paho and zeroization edge cases
    [gateway_transport.c]
2026-10-08 chore(p5): pin coreMQTT v2.3.1 and freeze rebuilt P4 baseline
2026-10-08 feat(p5): switch MQTT311 client and require matching PUBACK before Router ACK
2026-10-08 fix(p5): add bounded assert halt and isolated Broker equivalence validation
    [gateway_assert.c]
2026-10-09 fix(p5): pin source-map-js fix and select native ARM paths
2026-10-09 fix(p5): guard console emcy trigger against unallocated node-a (GEMINI-P5-001)
    [main.c]
2026-10-10 docs(p5): rewrite core technical documentation and risk ledger v2.0
2026-10-22 Review RESP electrode path and prepare isolated cable and source voltage card
2026-10-23 Use V2.2 manual RA-LL respiration pair and revise parameter and voltage steps
2026-10-23 Back up current C Flash and options; record verified H3 restore source and wiring prerequisites
2026-10-27 fix(b5): bind sector3 writer to verified connected MEM-AP flow
2026-10-27 feat(b5): freeze bounded G3 joint evidence tools and pending field cards
2026-10-27 feat(b5): trace SNTP admission failure with bounded network controls
2026-10-27 feat(b5): capture one ESP UDP NTP request without device rescan
2026-10-28 fix(b5): preserve SNTP cleanup pass and fresh NTP timing failure; prepare faster UART
2026-10-29 Fix B5 SNTP bootstrap and UTC coherence; preserve current C ROM evidence
2026-10-30 docs(b5): complete R5-QC audit ledger, errata, replay receipts, root-cause analyses, and R6-P0 remediation plan
2026-10-30 fix(b5): bracket temperature snapshots and verify ECG60 and TEMP windows
2026-10-31 docs(b5): preregister multirate matrix and three-board entry plan
2026-10-31 docs(b5): seal passing ECG90 trial and ECG120 power-off readiness
2026-10-31 Trace new A blood-pressure results and parameterize reused ABC collectors
2026-10-31 Fix ABC temperature trace starvation and preserve field counterexamples
2026-10-31 Add legacy USART3 temperature-screen candidate after two-group link validation
2026-10-31 Record two-group field results and B temperature-screen verification
2026-11-02 Add isolated I2S3 microphone bench and preserve current C application
2026-11-02 final P0: verify three-board images and read-only recovery baselines
2026-11-03 Fix unified C audio scheduling and interrupted-session recovery
    Preserve idle AT slots for audio and allow local MIC recording while a medical telemetry ACK is pending. Accept a valid newer audio start after an interrupted session while retaining CRC, ordering, expiry and completed-session replay checks.
    Validate R4 on C with software CAN receive-entry load, 125 real audio chunks, byte-identical source PCM, real ASR/AI/TTS, and ingress-stall STOP/reconnect. Preserve all failed windows and exact Flash sector protection evidence.
    Validation: eight Host suites, seven protocol tests, byte-identical ARM rebuild and real final field/ASR exit0. A/B firmware and formal cloud services remain unchan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
2026-11-03 Establish M0 three-board engineering baseline and context handoff
    Validate B+C ECG60, ABC ECG60, and ABC RR18 for 300 seconds on the
    same C candidate while keeping A42608 and B41516 unchanged. Preserve
    failed windows, NIBP reviewer correction, resource limits, and recovery
    references. Defer five-node migration and main integration.
2026-11-04 docs: record owner wiring and oximetry clarifications
2026-11-04 feat: build five-node M1 candidates and document measured CAN wiring
2026-11-06 Fix CAN startup ordering and record five-node field results
    Defer CAN interrupts until application readiness, preserve real PPG short
    batches, and add bounded install/capture and source-to-web review tools.
    Record point-to-point and both 41-ohm five-node windows, actual image
    hashes, preserved failures, counter errata, and rollback constraints.
    End-to-end completeness remains NOT_PASS; router defects are reproduced
    but unresolved. Deliver the PI review entry and await the next decision.
2026-11-06 Deliver validated P1 queue fixes and defense evidence index
    Preserve PPG FIFO ordering and execute guarded historical replay quotas.
    Include existing offline reproductions, ARM resources and throughput
    budgets, without rerunning tests or changing installed firmware.
    Add project status and defense evidence indexes that separate M0 history,
    five-node field failures and offline-only P1 fixes. Capacity remains
    NOT_PASS; FreeRTOS is pending and has not been started.
2026-11-07 Implement offline five-node appliance startup and fact voice protocol
    Add opt-in automatic C startup, KEY1 short recording and isolated MR02 fact replies. Include source provenance, targeted Host/ARM results and PI review notes. Offline only; capacity remains NOT_PASS and field validation is NOT_RUN.
2026-11-07 Archive FIELD01 egress probe and blocked field attempt
2026-11-09 docs: add PREFLIGHT design and batched on-board test plan
2026-11-09 docs: approve FIELD01 PREFLIGHT and issue S0-S3 on-board batch card
2026-11-09 Implement FIELD01 R4 UART preflight and correct R3 evidence
2026-11-09 Record FIELD01 image 2 Host and bitwise ARM verification
2026-11-09 docs: adjudicate R4 batch and fix C-board power/flash/serial wiring spec
2026-11-09 Report verified production UART fallback (R7 WP-V)
2026-11-09 Add opt-in SSL passthrough and audio-free R7 capacity fixtures
2026-11-09 docs: adjudicate R7 offline results, correct capacity reading, draft single-board bench batch card
2026-11-09 Add R8 C transport bench and extend P3 capacity fixtures
2026-11-09 Record R8 offline verification and correct capacity interpretation
2026-11-09 docs: adjudicate R8 bench field results and re-locate the capacity gap
2026-11-09 Fix UART restore and add R9 FIELD01 profiling and service fit
2026-11-09 Restore directly after a verified fast-rate flow mismatch
2026-11-09 Record R9 reproducible builds and service-cost calibration
2026-11-09 docs: final PI release of R9 deliverables and five-board window batch card
2026-11-09 Record R10 five-board field stops and reset-bound capture
2026-11-09 docs: adjudicate W1 five-board window, explain TX starvation and release W2
2026-11-09 Record R12 W3 five-board F-P115 field result
2026-11-09 WP-AJ Sweep calibrated five-board passthrough headroom
2026-11-10 Document R16 ESP reset wiring with schematic crops
2026-11-10 Record R18 S1 cold-boot stop and reproduce UART gate
2026-11-10 Apply R19 cold-boot UART baseline for S1 candidate
2026-11-10 PI review R29: no UART tap, locate link-drop via TXCHK window
2026-11-10 docs: record R32 S3 retention and probe results
2026-11-11 feat(web): redesign monitor UI as bedside-style central display
    Black background with waveform and numeric in matching channel colours,
    IEC 60601-1-8 style alarm priorities (red/yellow/cyan, flash rates) with
    a 10 s delay for continuous parameters, sweep-erase waveforms, a single
    trends page replacing per-parameter pages, and no gateway switcher.
    Data contract (WebSocket snapshot v1) is unchanged. A dev-only preview
    page feeds MOCK data and is not part of the production build.
2026-11-11 fix(web): default to the authorised real gateway GW-C-001
    The production backend only authorises GW-C-001 and the UI no longer has
    a gateway switcher, so the old GW-DEV-001 default was rejected (1008).
2026-11-11 feat(web): auto-connect remembered displays, standby and demo modes
    Owner decision 2026-11-11: dedicated displays may remember the read-only
    token in localStorage and connect on open. Without live device data the
    page shows a standby layer; an opt-in demo mode feeds local synthetic data
    under a prominent banner and exits as soon as the device goes live. Server
    frames marked MOCK get a small neutral tag instead of the demo banner.
2026-11-12 Record R54 B1 offline verification and broadcast samples
2026-11-12 fix(web): pick a Chinese voice and show speech status on the softkey
    W-AY run1 heard nothing after enabling speech. Select a zh voice when the
    browser lists one, avoid cancel() right before the unlock utterance, and
    show 无中文语音 / 朗读失败 on the key so the cause is visible on site.
2026-11-12 PI review R56: W-AY run1 broadcast PASS, speech NOT_PASS, unexplained re-power
2026-11-12 PI review R57: re-power explained, P3 published, S5 authorized
2026-11-12 PI review R58: W-AY run2 review, WP-AY PASS except HR positive case
2026-11-12 PI review R59: run3 card (HR 45 bpm), owner decisions on AI model and board audio
2026-11-12 PI review R62: WP-AZ plan, cloud broadcast to board TTS speaker
2026-11-12 Implement WP-AZ offline device broadcasts and TTS build
2026-11-12 PI review R64: WP-AZ AZ-2/AZ-3 execution card (speaker 8 ohm 1 W confirmed)
2026-11-12 docs(pi): R65 WP-AZ AZ-2/AZ-3 review — PASS (prototype)
2026-11-12 docs(pi): R65 §6 owner confirms HR speech — WP-AZ full PASS
2026-11-13 fix(deps): align websockets lock with 17.4 security update
    Keep all other resolved versions unchanged. Validate backend, five-board API and real loopback WebSocket lifecycle before merging.
2026-11-13 docs: finalize repository closeout, issue review and architecture
    Record merged PRs #9 and #20, original branch and commit preservation, exact cleanup receipts, and reviewed dependency deferrals. Publish two Chinese Markdown reports with five architecture flowcharts and evidence-based acceptance boundaries. Documentation only; no production deployment or hardware changes.
