Serendipity-min/medical-multi-parameter-monitor/(notices)

Notices in the files:
血氧/AFE4490_library/README.md:
CC-BY-SA-4.0
